AFlyingPiglet/shangjianyinqing/docs/README.md

# CRTC 2026 参赛文档

> 队伍名称：**熵减引擎战队**（新生组）　建议仓库名：`shangjianyinqing`
> 队长：蔡昌恒　队员：史沐生、喻静琳、李秉航、杨佳琳
> 所属实训战队：**千里战队**（2026-10-05 填报分组）

## 这个仓库是什么

按《2026 CRTC 参赛手册 V1.5》的要求，记录备赛过程中的**学习内容、设计思路与制作过程**。
本目录（`docs/`）里的文档是**提交给组委会评审的部分**；队伍内部的进度看板与个人页放在仓库根目录的 `team/` 下，不属于提交文档。

中期考核（10 月 19 日 24:00 截止）需要提交本仓库链接。

## 文档索引

| 文档 | 内容 |
|---|---|
| [01-基础功能](01-基础功能.md) | **中期考核 12 项基础功能**（1.1~1.12 各自独立成文）：功能描述 / 方案与取舍 / 开发历程 / 证据 |
| [02-进阶功能](02-进阶功能.md) | 最多 3 项进阶功能（2.1~2.3 独立成文，按创新度、实现难度、完成度评分） |
| [03.00-学习笔记](03.00-学习笔记.md) | 培训与自学内容，按板块分册：03.01 机械 / 03.02 电控 / 03.03 工具与软件 / 03.04 规则与赛务 / 03.05 硬件（空板块不单列，有新内容时自动生成） |
| [04.00-设计思路记录](04.00-设计思路记录.md) | 设计想法的变化：**04.01 一号车 / 04.02 二号车** 分册记录；通用策略与问卷汇总在 04.00 本页 |
| [05-物资与成本预算](05-物资与成本预算.md) | 核心部件选型、采购清单、成本核算（对应基础功能第 12 项） |
| [06-规则测评笔记](06-规则测评笔记.md) | 手册要点、易错条款、80 题测评复习 |
| [07-规则手册变更记录](07-规则手册变更记录.md) | V1.4 → V1.5 的六处变更、对设计的影响与行动清单 |
| [08-开源项目说明](08-开源项目说明.md) | 开源项目使用说明（手册 V1.5 要求，中期考核前需完整） |
| [09-独立复核对账与修正](09-独立复核对账与修正.md) | 第三方独立复核的逐条对账：采纳/修正/不采纳，以及待拍板决定 |
| [images/](images/) | 文档用图。**日报配图**放在 `images\日报配图\<日期>\`，其他图直接放 `images\` 下 |
| [问卷原件/](问卷原件/) | 队员填写问卷的原始文件（电子卷 + 手写卷照片），作为设计讨论的原始证据 |

## 写作要求（务必遵守）

1. **格式**：markdown（.md）。
2. **每项功能单独成文**：基础功能 1.1~1.12、进阶功能 2.1~2.3 各一个文件；文内按「功能描述 → 方案与取舍（为什么）→ 开发历程（精简）→ 证据」组织。
3. **按时间从早到晚**组织内容（开发历程从最早的方案讲起，写到当前状态）。
4. **必须写「为什么」**：技术选型对比、遇到的难点与解决方案、迭代优化的过程。只写「做了什么」拿不到高分。
5. 图片放在 `docs/images/`，用相对路径引用：`![](images/xxx.png)`；日报自动导出的照片会归到 `images/日报配图/<日期>/`，并在当天条目下面直接显示。
6. 每次有进展就提交一次，不要攒到最后一天。
