AFlyingPiglet/shangjianyinqing/docs/images/README.md

# 图片目录

把文档里用到的照片、截图、CAD 导出图放在这里，命名建议「日期-内容」：

```
2026-10-03-矮墙槽对位-第3次.jpg
2026-10-05-举升机构装配.png
```

在 MarkText 里引用时用相对路径：

```markdown
![矮墙槽对位](images/2026-10-03-矮墙槽对位-第3次.jpg)
```

这样上传到 Gitee / GitHub 后图片能正常显示。
