AFlyingPiglet/shangjianyinqing/docs/03.02-电控.md

# 03.02 电控（学习笔记）

> 按日期从早到晚记录「电控」板块的学习内容与来源；由日报自动写入。

## 电控

<!-- 追加位置 -->

### 2026-09-28 配置电控所需环境

- 学习人：李秉航
- 来源：B站
- 学了什么：配置ST-link，STM32CudeMX
- 学习中遇到的问题：网速太慢，安装失败，安装缺少文件
- 学习中的解决过程：重新尝试安装

**照片：**

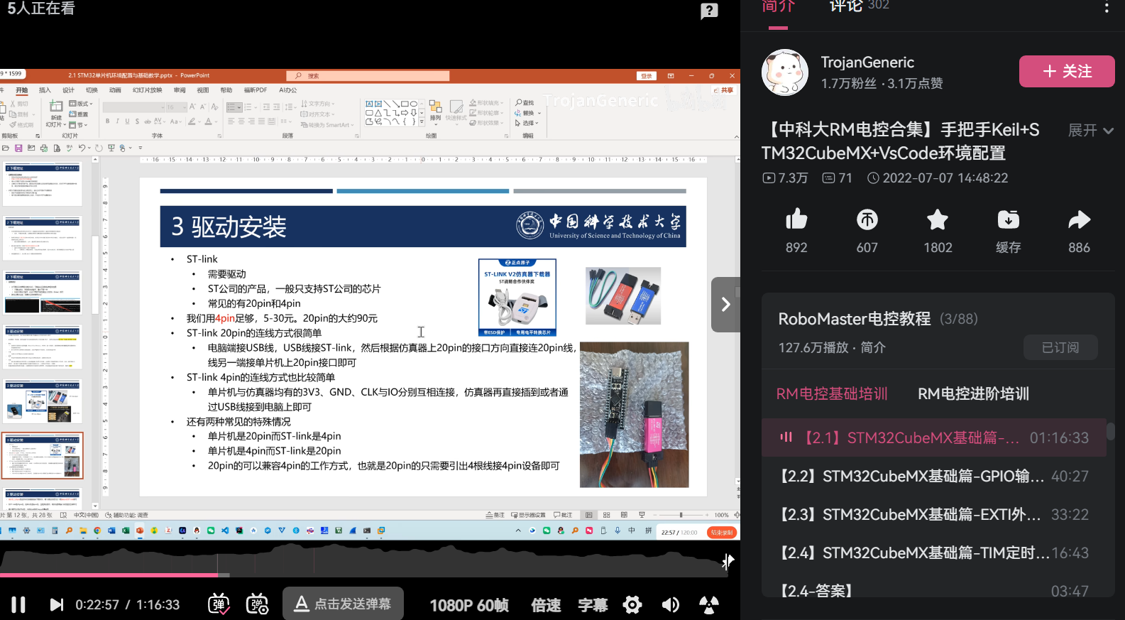
[picture p1: docs/images/日报配图/2026-09-28/李秉航-1-46bd4360.png]
李秉航-1-46bd4360


[打开图片：李秉航-1-46bd4360](images/日报配图/2026-09-28/李秉航-1-46bd4360.png)

### 2026-09-29 电控

- 学习人：蔡昌恒
- 来源：哔哩哔哩
- 学了什么：电控导论

**当天照片：**

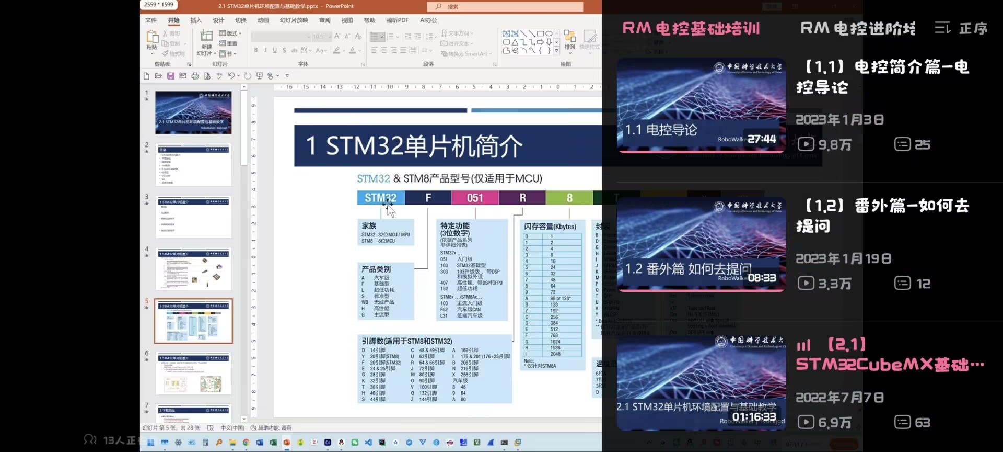
[picture p2: docs/images/日报配图/2026-09-29/蔡昌恒-1-d381a8af.jpeg]
蔡昌恒-1-d381a8af


[打开图片：蔡昌恒-1-d381a8af](images/日报配图/2026-09-29/蔡昌恒-1-d381a8af.jpeg)

### 2026-09-29 配置电控所需环境

- 学习人：李秉航
- 来源：QQ群所发网站
- 学了什么：配置Clion,STM32CubeMonitor，STM32CubeProgrammer，STM32CubeCLT

**照片：**

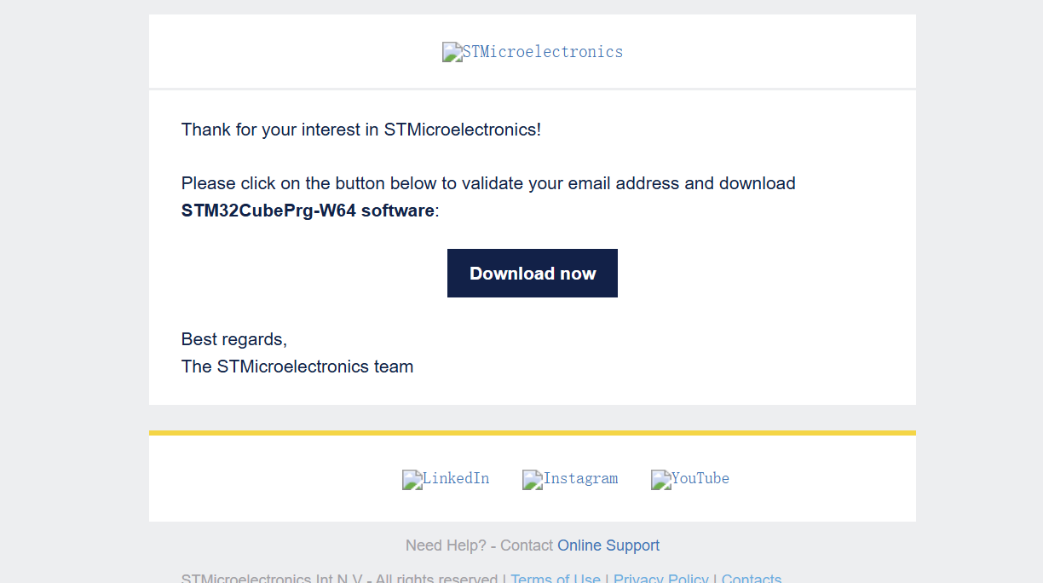
[picture p3: docs/images/日报配图/2026-09-29/李秉航-1-b380d144.png]
李秉航-1-b380d144


[打开图片：李秉航-1-b380d144](images/日报配图/2026-09-29/李秉航-1-b380d144.png)

### 2026-09-30 学习GPIO

- 学习人：李秉航
- 来源：B站
- 学了什么：GPIO
- 学习中遇到的问题：新名词太多，初学理解有困难
- 学习中的解决过程：反复观看视频，不急于求成

**照片：**

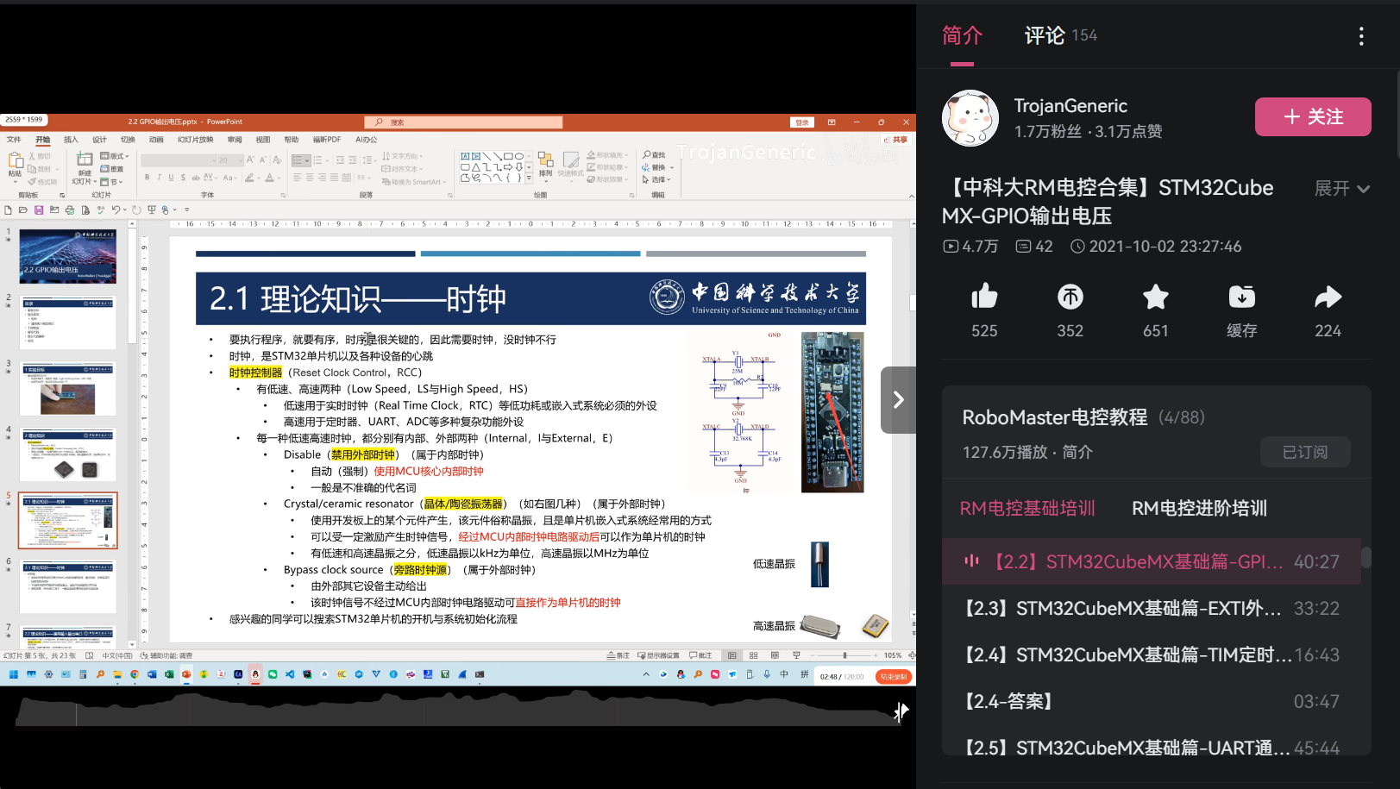
[picture p4: docs/images/日报配图/2026-09-30/李秉航-1-0cf1a1bb.png]
李秉航-1-0cf1a1bb


[打开图片：李秉航-1-0cf1a1bb](images/日报配图/2026-09-30/李秉航-1-0cf1a1bb.png)
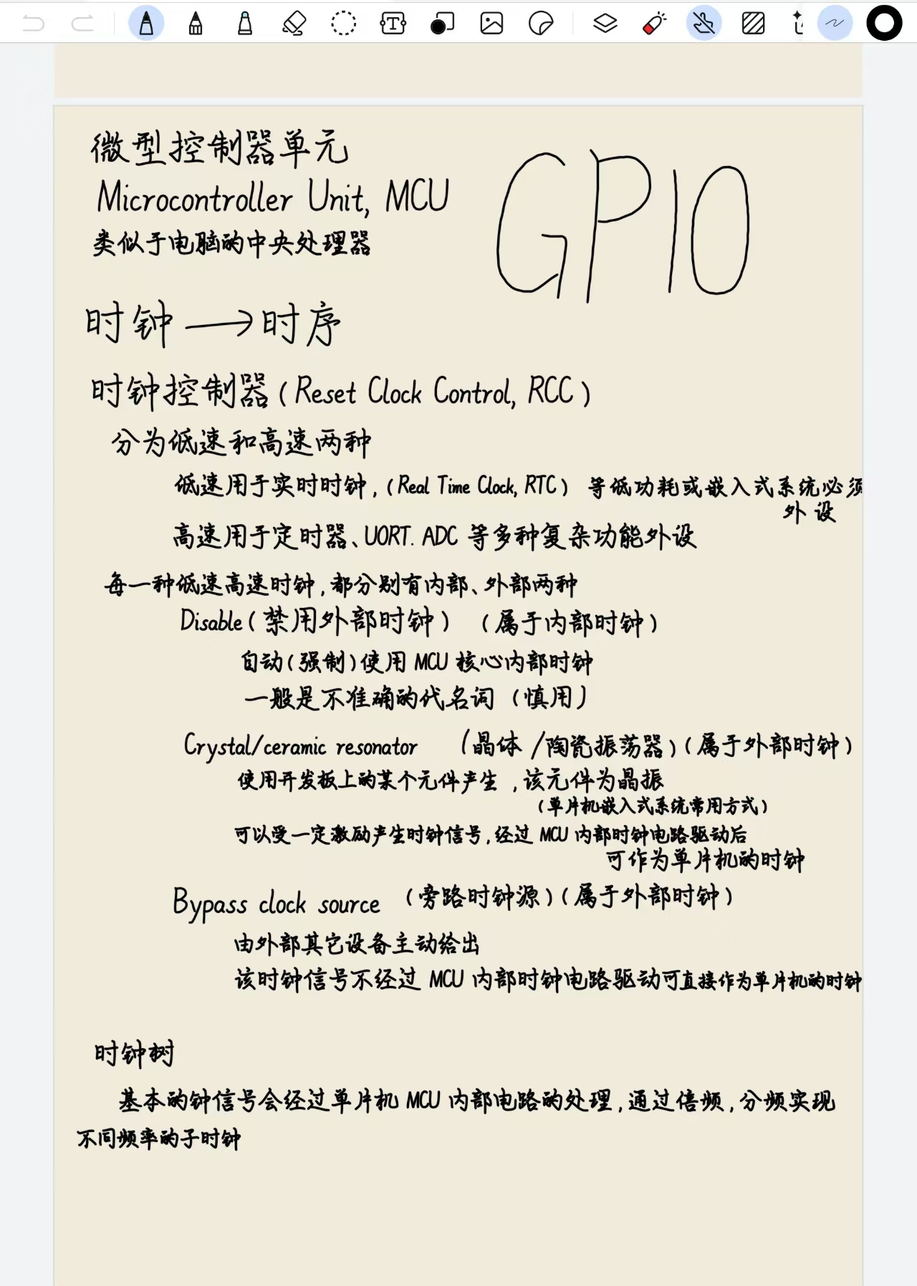
[picture p5: docs/images/日报配图/2026-09-30/李秉航-2-749e51b0.jpeg]
李秉航-2-749e51b0


[打开图片：李秉航-2-749e51b0](images/日报配图/2026-09-30/李秉航-2-749e51b0.jpeg)

### 2026-10-05 学习PLC知识

- 学习人：李秉航
- 来源：书本《零基础PLC编程从入门到精通》
- 学了什么：《零基础PLC编程从入门到精通》
- 学习中遇到的问题：新名词太多，程序设计基础薄弱
- 学习中的解决过程：整理笔记，借助AI学习

**照片：**

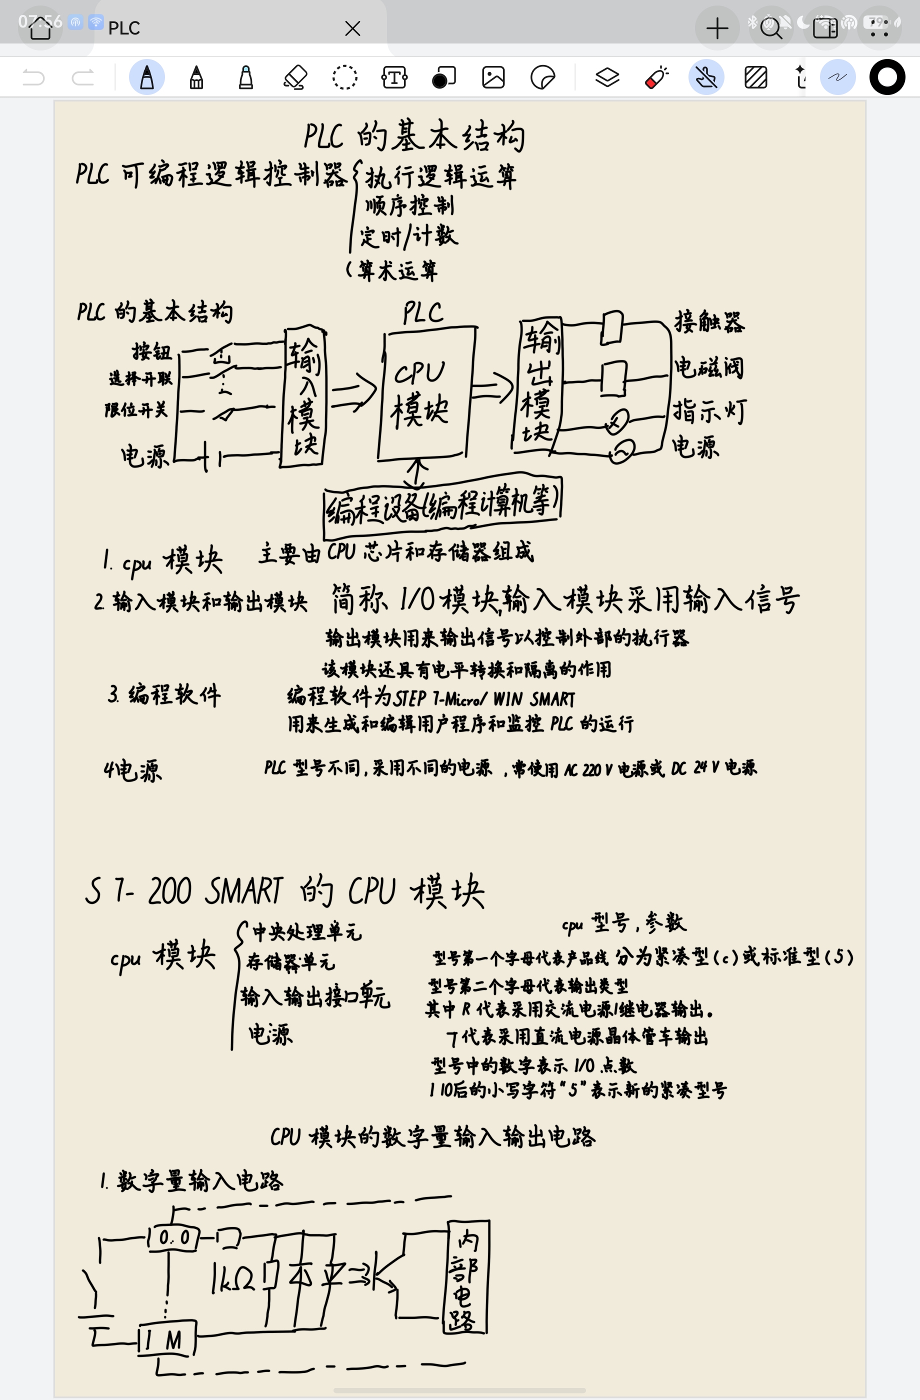
[picture p6: docs/images/日报配图/2026-10-05/李秉航-1-1ceda53c.jpeg]
李秉航-1-1ceda53c


[打开图片：李秉航-1-1ceda53c](images/日报配图/2026-10-05/李秉航-1-1ceda53c.jpeg)
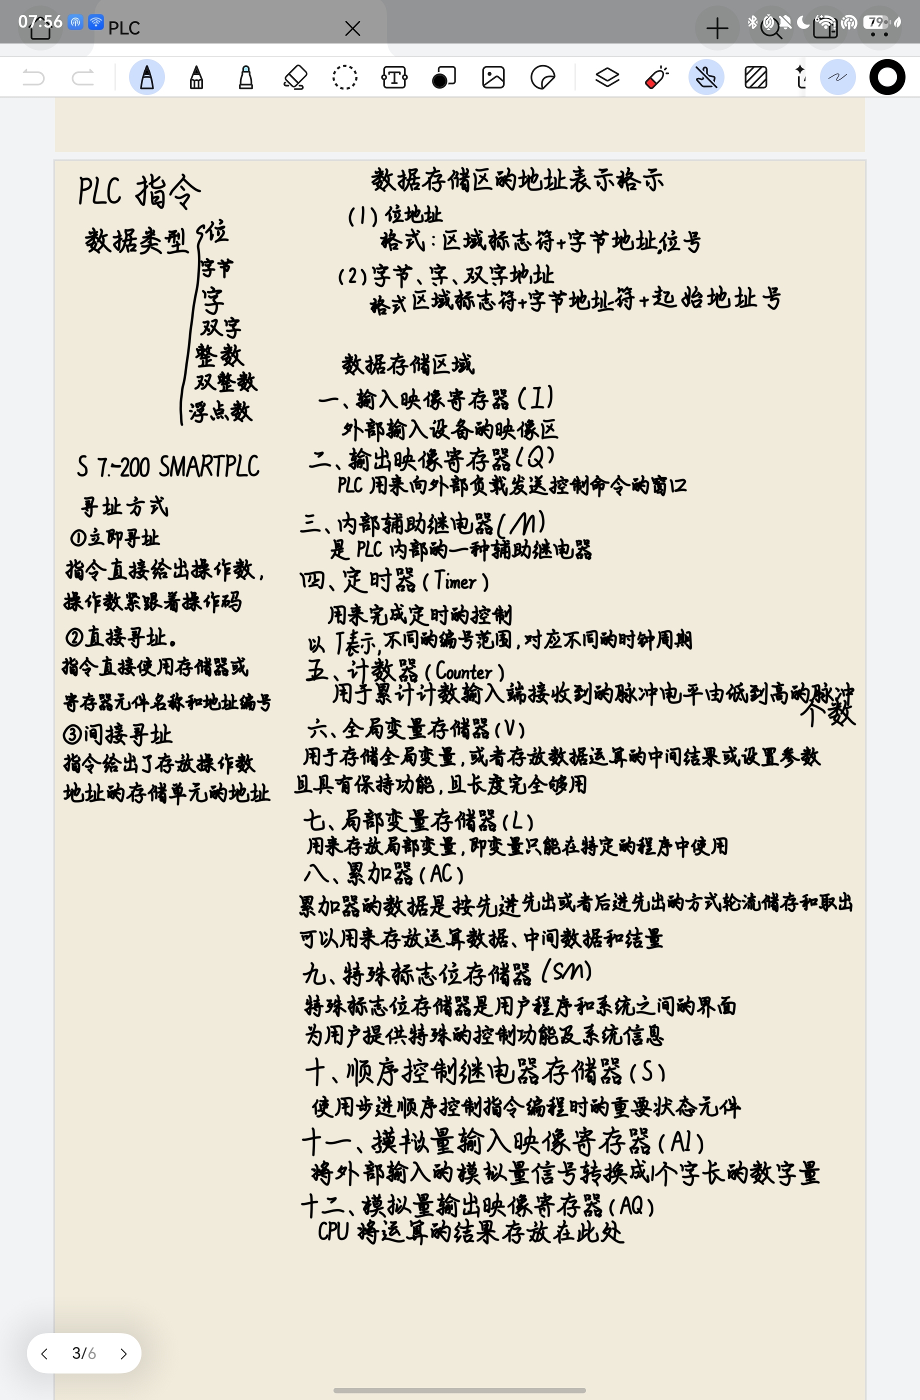
[picture p7: docs/images/日报配图/2026-10-05/李秉航-2-470c7768.jpeg]
李秉航-2-470c7768


[打开图片：李秉航-2-470c7768](images/日报配图/2026-10-05/李秉航-2-470c7768.jpeg)
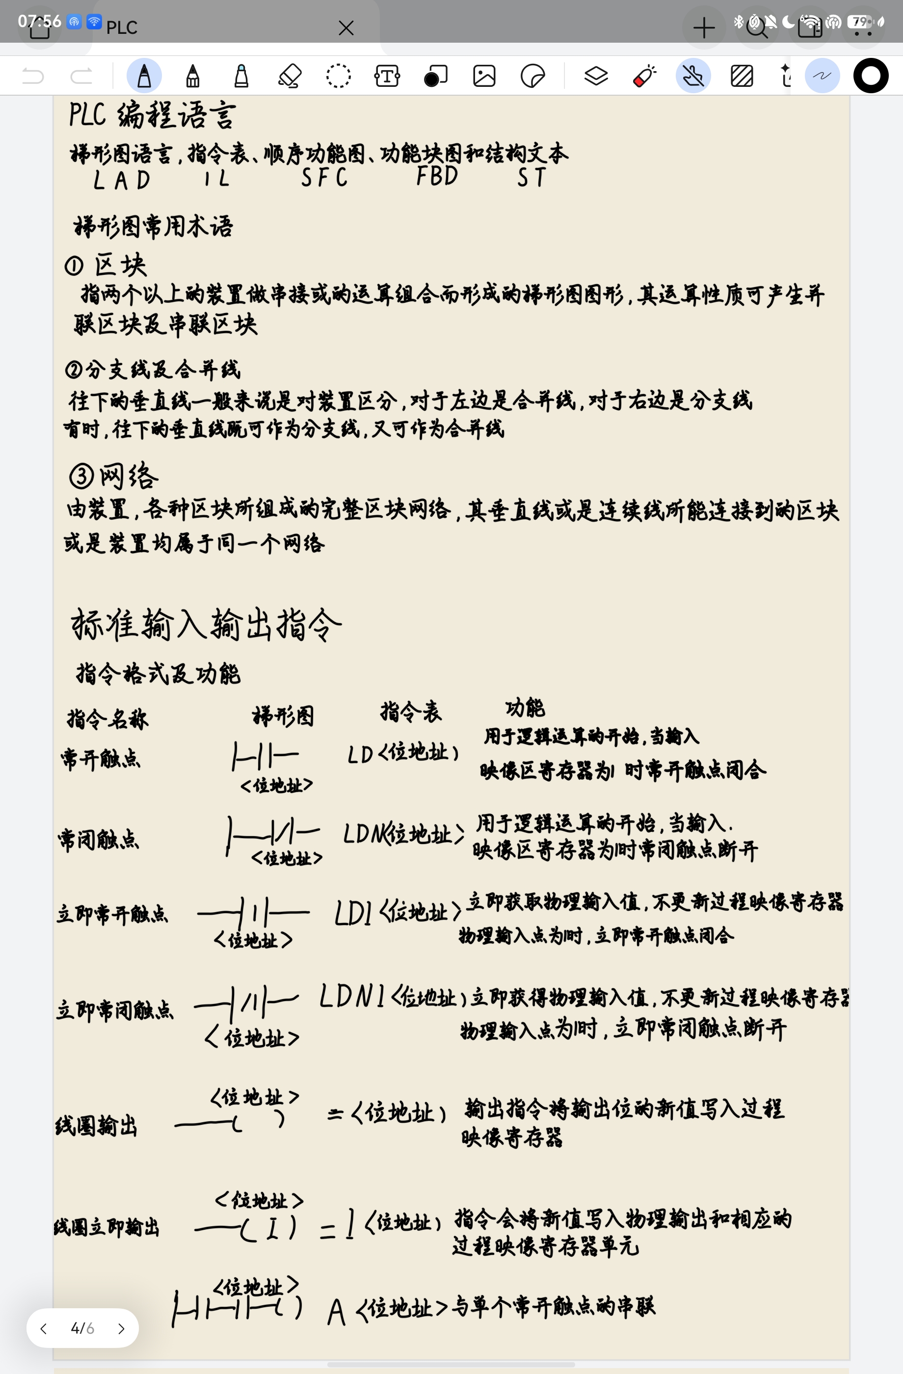
[picture p8: docs/images/日报配图/2026-10-05/李秉航-3-c148fd3c.jpeg]
李秉航-3-c148fd3c


[打开图片：李秉航-3-c148fd3c](images/日报配图/2026-10-05/李秉航-3-c148fd3c.jpeg)

### 2026-10-15 通信协定，stm32cubeMX中相应配置含义，…

- 学习人：蔡昌恒
- 来源：千里线下培训
- 重点 / 为什么这样：为了消除接线接触不良的影响。
- 怎么用到我们的车上：接入了控制手柄，并用另一种接线方式来确保接线正常。直接把母头链接到引脚上，虽然整个工作台好像盘丝洞一样。。。
