AFlyingPiglet/shangjianyinqing/docs/03.05-硬件.md

# 03.06 硬件（学习笔记）

> 按日期从早到晚记录「硬件」板块的学习内容与来源；由日报自动写入。

## 硬件

### 2026-10-09 嘉立创画简单 PCB 原理图

- 学习人：杨佳琳
- 来源：B 站教程
- 学了什么：用嘉立创 EDA 画简单 PCB 原理图——建工程、放元件、连网络、检查连线；当天先以“能画通一张小图”为目标。
- 学习中遇到的问题：连线太乱，不知道元件该放什么位置
- 学习中的解决过程：先按“电源—控制—输出”三段分区摆元件再连线，线乱就先拉直、同类信号走同侧（后续继续跟教程补）
- 分类：硬件

### 2026-10-12 STM如何烧录接线

- 学习人：杨佳琳
- 来源：豆包，deepseek，嘉立创
- 学了什么：1，确定了1,2车板子上面都需要放置什么 2，STM上面没显示PA13,PA14，该如何接线？ 上面标注的引脚名字不全，有隐藏引脚，PA13,PA14对应的是34,37号引脚，将ST_Link的四个接线头插入3.3V,END,PA13,PA14即可烧录 3，弯曲排针和正常排针的区别：弯曲排针向上弯90度，再考虑到板子位置大小和放置方向是可能会考虑，我们就用正常的就可以了
- 学习中遇到的问题：零件位置怎么放？后面接线怎么接？
- 分类：硬件

### 2026-10-13 改进，打印一号车的PCB

- 学习人：杨佳琳
- 来源：豆包，deepseek，嘉立创
- 学了什么：改进，打印一号车的PCB
- 分类：硬件

**当天照片：**

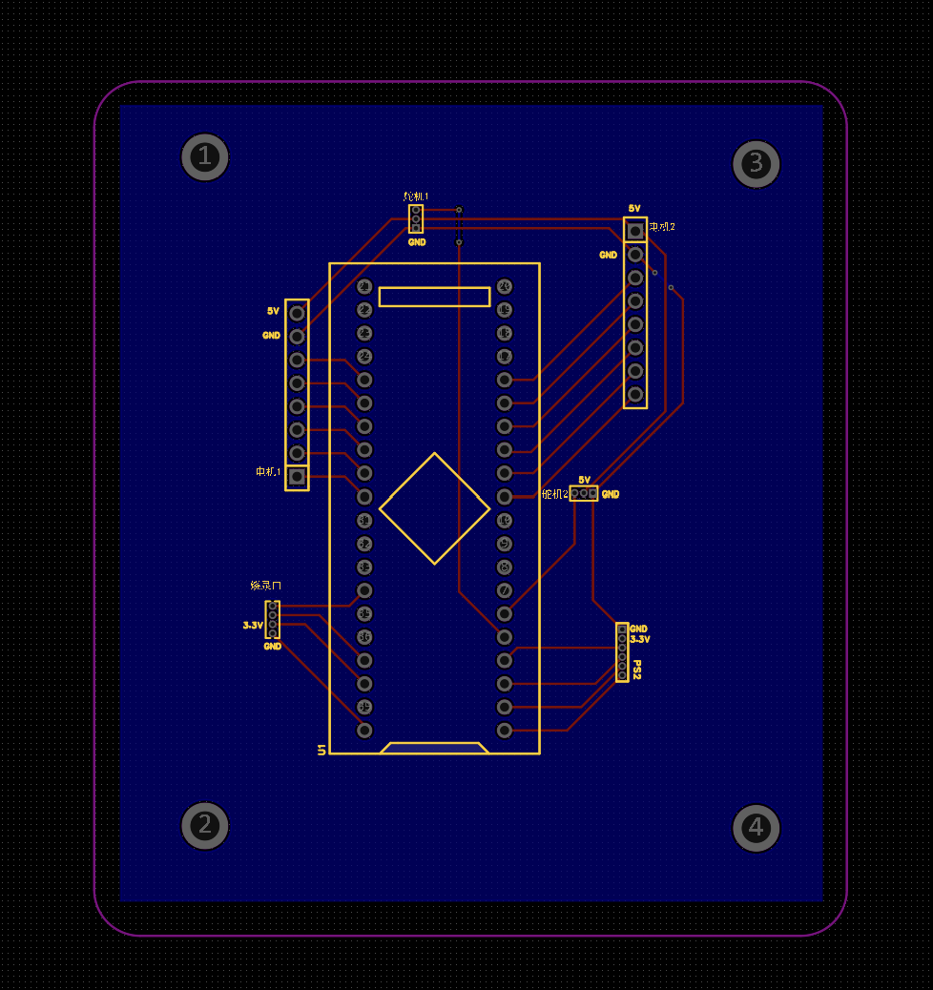
[picture p9: docs/images/日报配图/2026-10-13/杨佳琳-1-dbcfa02d.png]
杨佳琳-1-dbcfa02d


[打开图片：杨佳琳-1-dbcfa02d](images/日报配图/2026-10-13/杨佳琳-1-dbcfa02d.png)
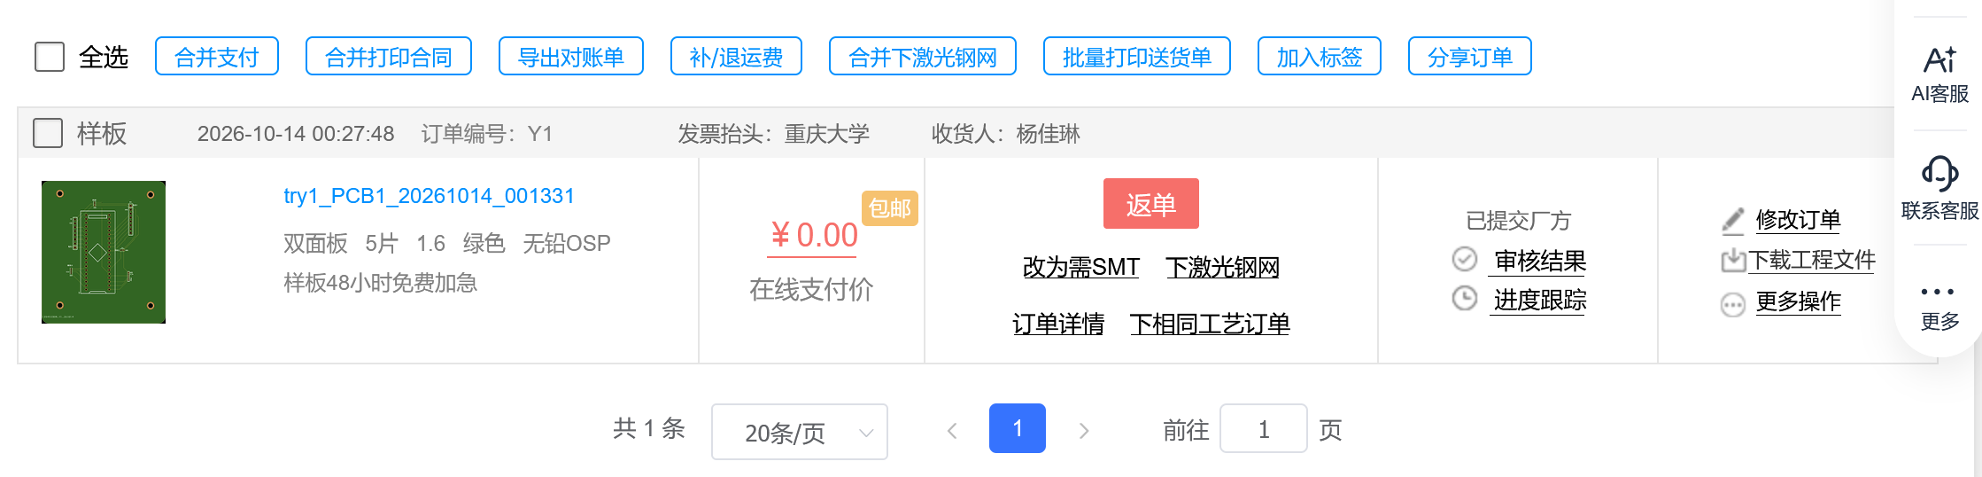
[picture p10: docs/images/日报配图/2026-10-13/杨佳琳-2-a44acbcc.png]
杨佳琳-2-a44acbcc


[打开图片：杨佳琳-2-a44acbcc](images/日报配图/2026-10-13/杨佳琳-2-a44acbcc.png)
