AFlyingPiglet/shangjianyinqing/docs/1.1-外形展示.md

# 1.1 外形展示

- **考核要求**：至少有一台具有能量单元的完整机器人机体，需绕车一周展示。
- **当前状态**：两车实物尚未拼装完成（3D 打印整批错印、PCB 首版接口问题），中期以 3D 建模概念图与 Fusion 装配流程代替实物展示。

## 我们的实现

两车按「抢价值 + 刷数量」分工：1 号车为麦轮取块车（举升立柱 + 换头机械臂），2 号车为四轮差速收运车（风车摇柄刺钩 + 一体斜铲唇 + 无隔板托盘）。两车均 PS2 手动操作。当前口径与桌面「一号车-最终版」「二号车-最终版」及《CRTC2026-双车最终方案报告-2026-10-12》一致。

| 项目 | 1 号车（过桥版） | 2 号车（隧道版） |
| --- | --- | --- |
| 定位 | 抢高分道具（物资架黄块 + 中央高台） | 刷数量（地面与台阶散块 + 洞穴黄块） |
| 尺寸 | **208 × 140 × 207 mm**（限 290×195×210，高余 3） | **收车位 288 × 186 × 129 mm**（长余 2、宽余 9、桥下净高余 1）  |
| 重量（预计）  | ≈1.2 kg（含车尾配重约 1.35~1.45；限 2.0） | ≈0.94~1.10 kg（限 2.0） |
| 行走与轮系 | φ60 麦轮 ×4 + TT 1:48 | φ70 橡胶轮 ×4 + TT（四轮差速；底盘离地 58） |
| 取块方式 | 快换接口（背板 18×48×24 + 公板 10×16×6）＋三种头：平行夹爪 / 钩子插头 / 弹片内撑 | 一体斜铲唇（纯坡面收地面块）→ 无隔板托盘；取块头＝松树针头 + 风车摇柄（MG90S×1） |
| 升降 / 动作 | C 口立柱 + 抱柱滑座；T8×150 丝杆 + 2×φ6 光轴；行程 46→172（126 mm） | 连杆腕折 90°（推杆 + 30° 挡块 + 复位簧，关节 0 根电线）；铲唇抬起 35°  |
| 料仓 / 检测 | 堆块筒 53×80×64（垒 2 层，可加高到 3 层）；落格 KW11×2 | 无隔板托盘 204×68×35；落格 KW11×2 |
| 电控与电池 | 后区叠放：电池仓 75×42×22（下）+ 电控托盘 68×44×16（上，铜柱 28） | 电控/电池高架 160×70（电池靠尾、PCB 在前） |

## 方案与取舍

两车形制按 A + B 设计：1 号车抢中央高台与杆上高分方块，2 号车抢地面保分方块并尝试掏出洞穴高分方块。

- **1 号车**：伪机械臂方案。除底盘运动外，设置 3（或 2）个电动自由度——手臂沿立柱升降、手臂绕立柱接触点转动、夹爪开合；另有 2 个手动自由度（见 2.1 进阶功能）。受尺寸与战术限制，料仓不大，置于车前。
- **2 号车**：铲唇 + 倒刺勾取。方块仓吊挂在车体下方，尺寸经核对可容纳目标方块；地面块由铲唇 + 舵机翻转流程拾取，洞穴块由松树状倒刺（舵机做圆环覆盖）引导出来，再由铲唇接收。
- **底板**：现成定版底座无法满足尺寸与战术需求，团队改用 3D 打印构建主体结构。

## 结构图与模型（2026-10-11 / 10-12 口径）

**1 号车**

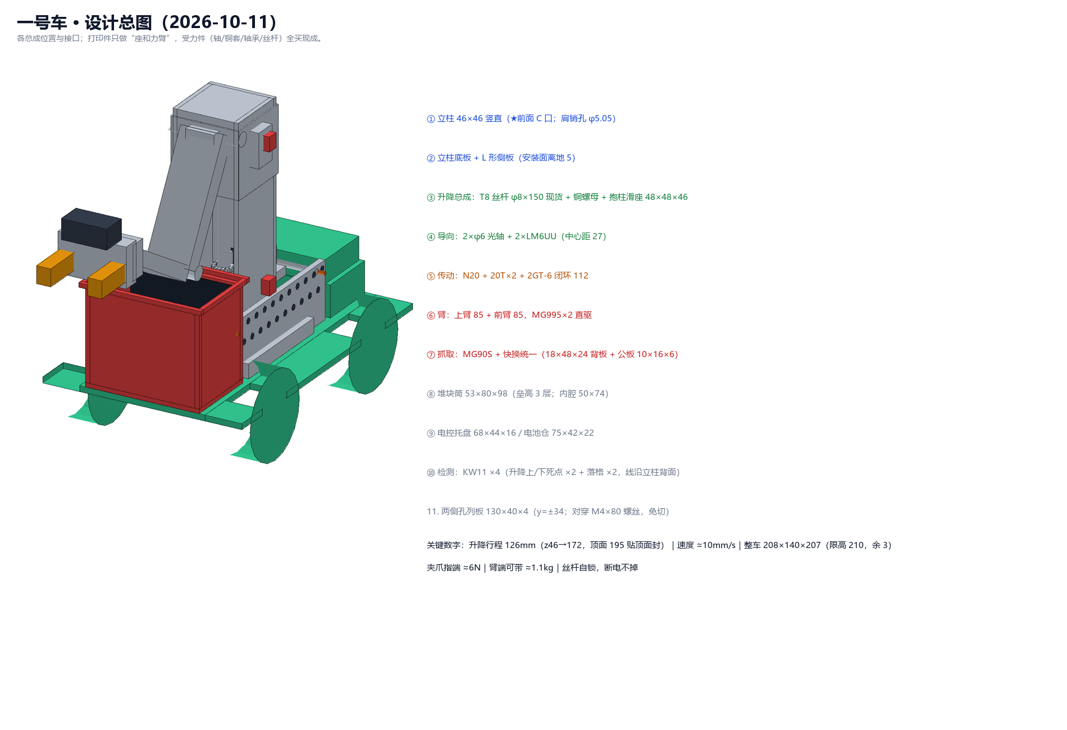
[picture p25: docs/images/设计图/00d-设计总图（2026-10-11）.png]
1 号车设计总图


[打开图片：1 号车设计总图](images/设计图/00d-设计总图（2026-10-11）.png)

*设计总图（2026-10-11）：立柱 C 口、升降总成、臂链、抓取、堆块筒、电控/电池、侧孔列板。*

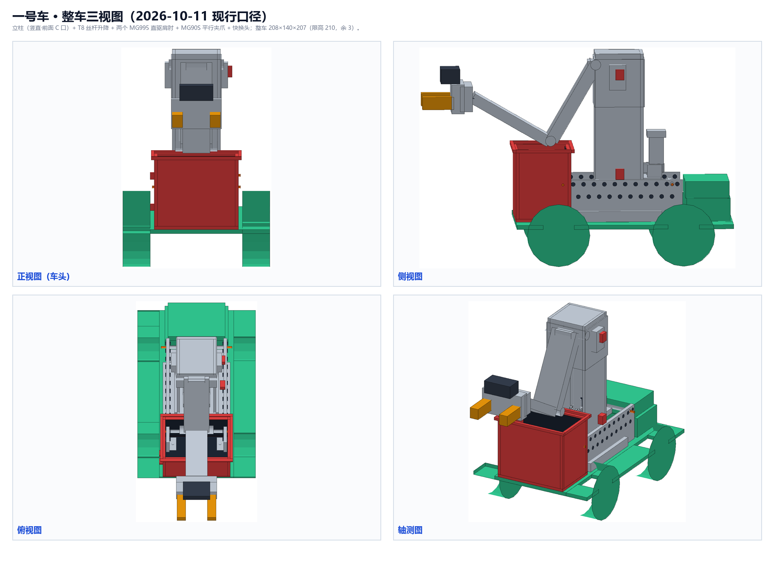
[picture p26: docs/images/设计图/00e-整车三视图（2026-10-11）.png]
1 号车整车三视图


[打开图片：1 号车整车三视图](images/设计图/00e-整车三视图（2026-10-11）.png)

*整车三视图（正/侧/俯 + 轴测，整车 208×140×207，限高 210）。*

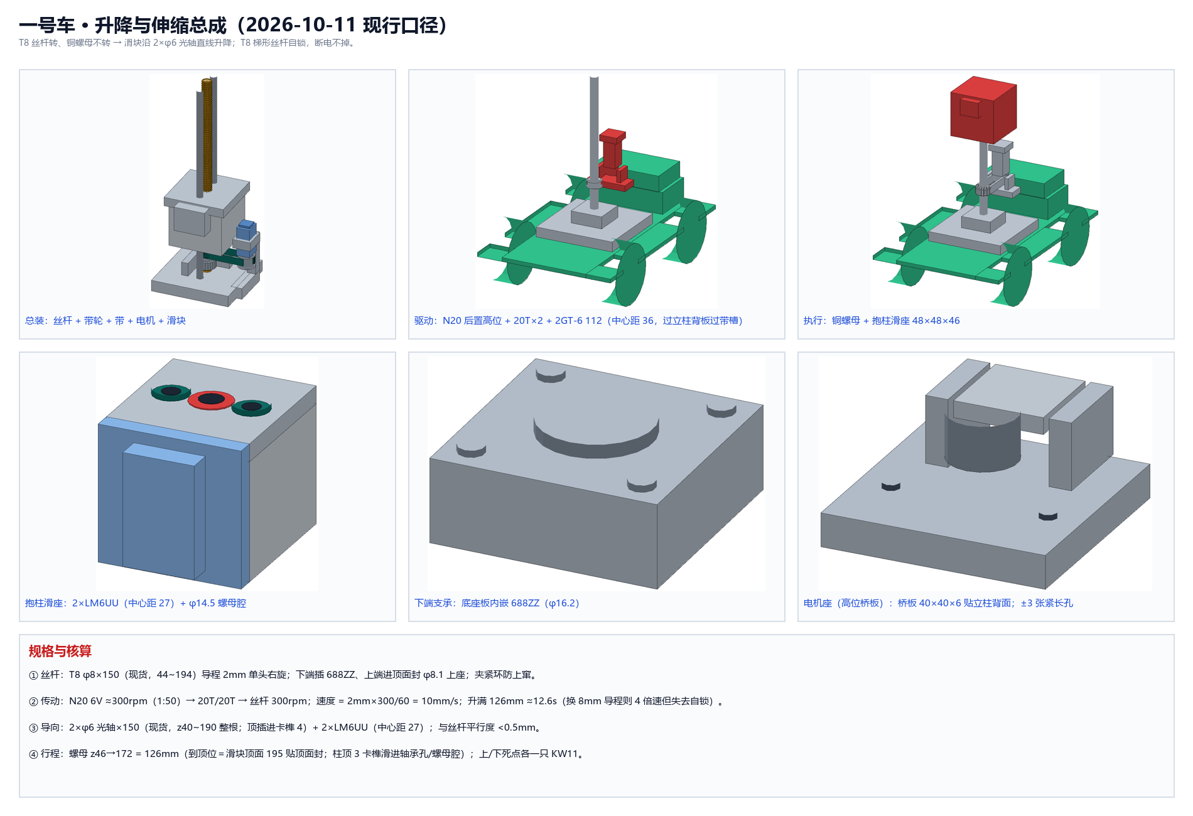
[picture p27: docs/images/设计图/00j-升降与伸缩总成（2026-10-11）.png]
1 号车升降与伸缩总成


[打开图片：1 号车升降与伸缩总成](images/设计图/00j-升降与伸缩总成（2026-10-11）.png)

*升降与伸缩总成：T8 丝杆 + 双 φ6 光轴 + 抱柱滑座，N20 后置高位驱动。*

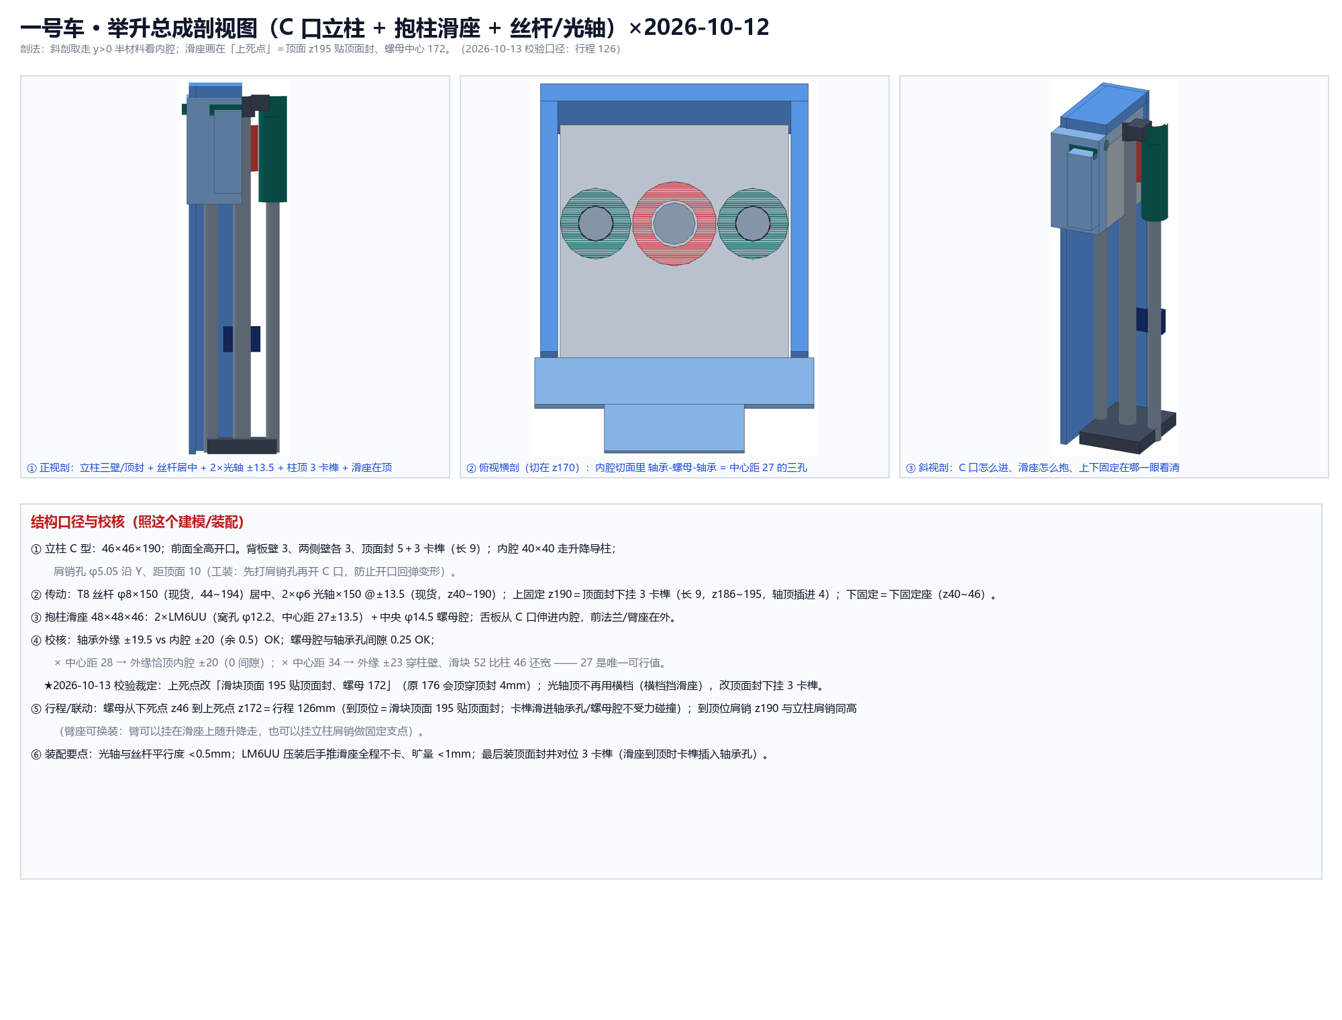
[picture p28: docs/images/设计图/00p-举升总成剖视（2026-10-12）.png]
1 号车举升总成剖视


[打开图片：1 号车举升总成剖视](images/设计图/00p-举升总成剖视（2026-10-12）.png)

*举升总成剖视（2026-10-12）：C 口立柱内腔、滑座中心距 27、行程 46→172。*

**2 号车**

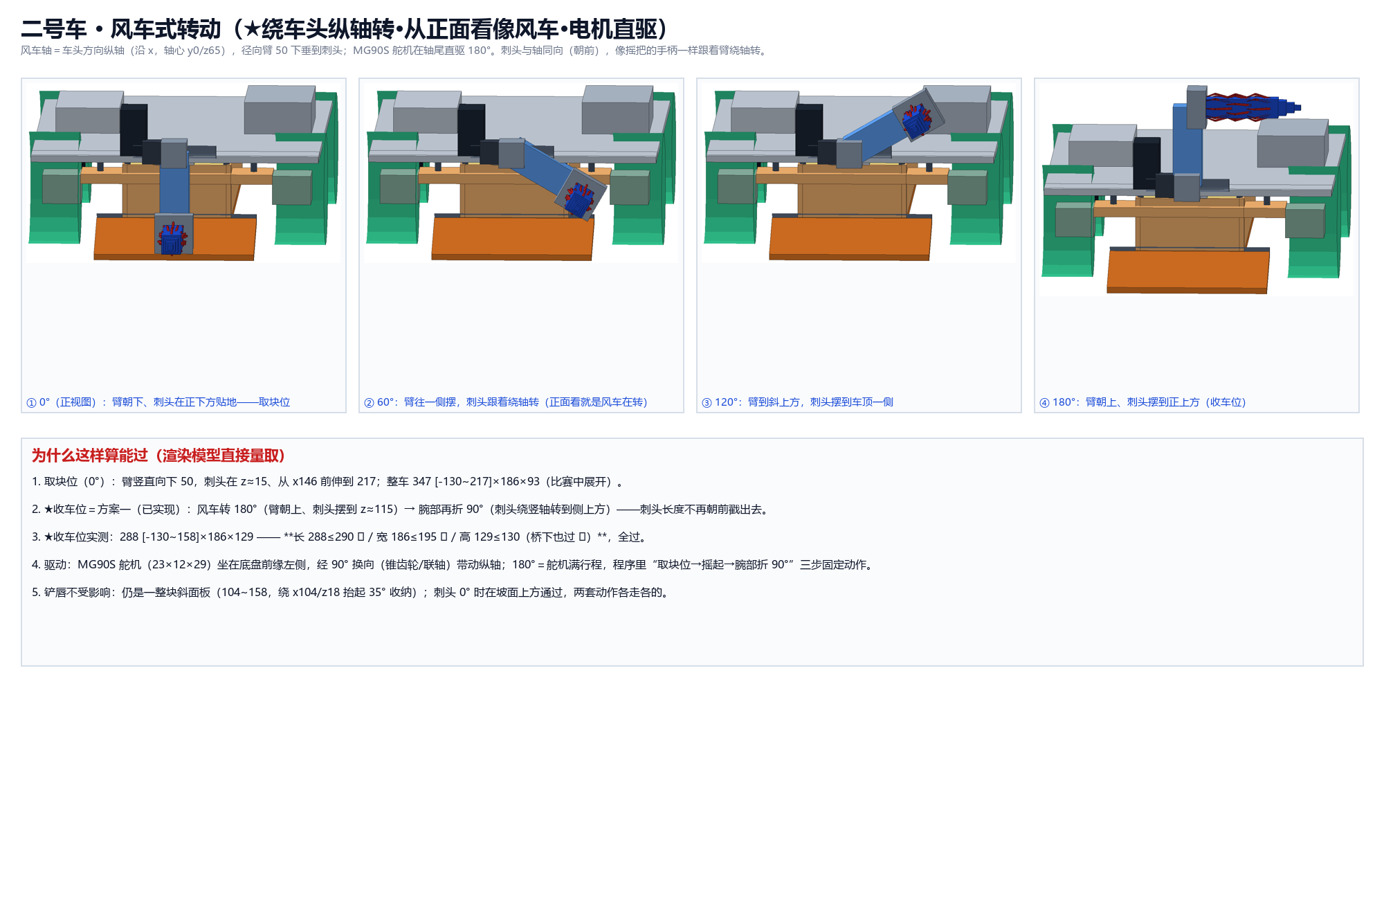
[picture p29: docs/images/设计图/28-摇把式转动过程（电机直驱·四帧）.png]
2 号车风车式转动四帧


[打开图片：2 号车风车式转动四帧](images/设计图/28-摇把式转动过程（电机直驱·四帧）.png)

*风车式转动四帧：0° / 60° / 120° / 180°，取块位 → 收车位。*

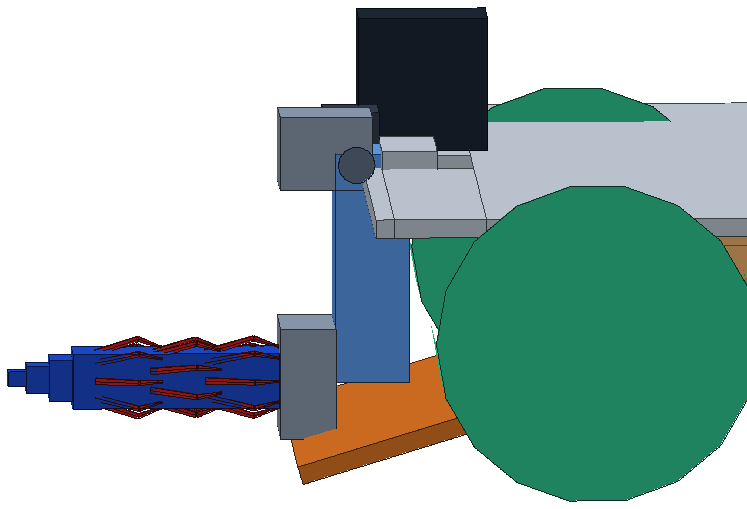
[picture p30: docs/images/设计图/机构近景-取块位（刺头+铲唇）.png]
2 号车取块位近景


[打开图片：2 号车取块位近景](images/设计图/机构近景-取块位（刺头+铲唇）.png)

*取块位近景：松树刺头 + 一体斜铲唇。*

**模型源文件**：一号车 16 件打印件 STEP 模型（立柱、抱柱滑座、底盘、堆块筒、侧孔列板等）见 [models/一号车-STEP](models/一号车-STEP/)。

**2 号车零件 Fusion 建模（过程截图）**

挡块板 Fusion 模型


[打开图片：挡块板 Fusion 模型](images/设计图/挡块板-Fusion模型.jpg)

*挡块板（Fusion 零件模型）。*

TT 电机托板 Fusion 模型


[打开图片：TT 电机托板 Fusion 模型](images/设计图/TT电机托板-Fusion模型.jpg)

*TT 电机托板（Fusion 零件模型）。*

腕部摇臂 Fusion 模型


[打开图片：腕部摇臂 Fusion 模型](images/设计图/腕部摇臂-Fusion模型.jpg)

*腕部摇臂 24×10×5（Fusion 零件模型）。*

二号车打印底盘 Fusion 模型


[打开图片：二号车打印底盘 Fusion 模型](images/设计图/二号车打印底盘-Fusion模型.jpg)

*二号车打印底盘（含竖臂缺口与铲唇缺口）。*

一体铲唇板 Fusion 模型


[打开图片：一体铲唇板 Fusion 模型](images/设计图/一体铲唇板-Fusion模型.jpg)

*一体铲唇板（含铰轴管）。*

径向臂 Fusion 模型


[打开图片：径向臂 Fusion 模型](images/设计图/径向臂-Fusion模型.jpg)

*径向臂 16×18×50（Fusion 零件模型）。*

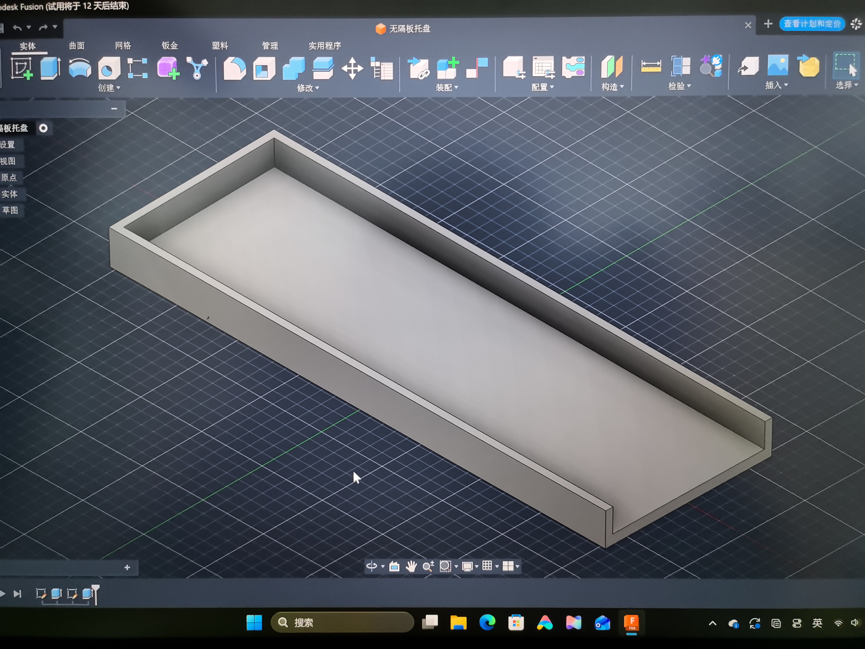
[picture p37: docs/images/设计图/无隔板托盘-Fusion模型.jpg]
无隔板托盘 Fusion 模型


[打开图片：无隔板托盘 Fusion 模型](images/设计图/无隔板托盘-Fusion模型.jpg)

*无隔板托盘 204×68×35（Fusion 零件模型）。*

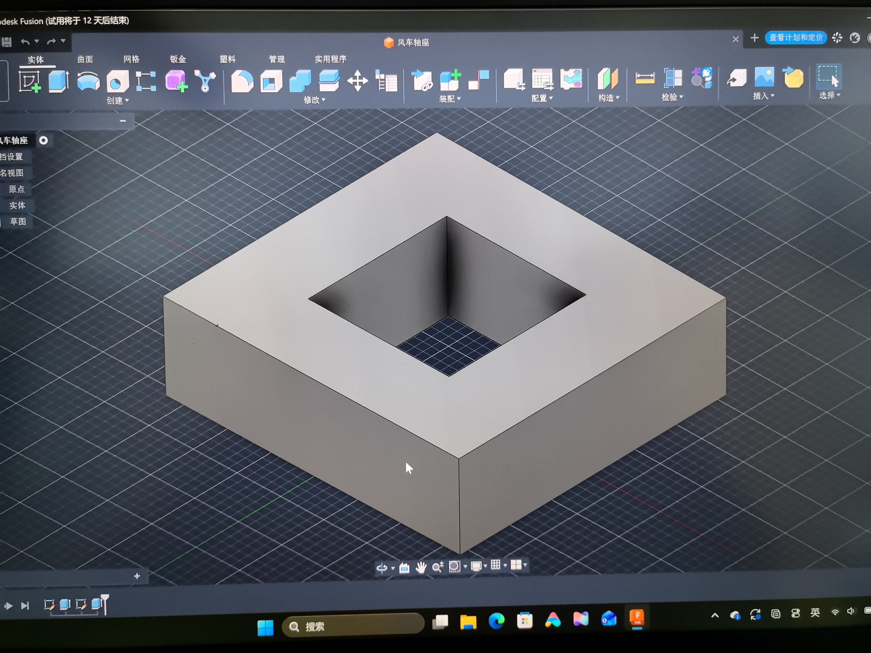
[picture p38: docs/images/设计图/风车轴座-Fusion模型.jpg]
风车轴座 Fusion 模型


[打开图片：风车轴座 Fusion 模型](images/设计图/风车轴座-Fusion模型.jpg)

*风车轴座 34×32×10（含 16.2×16.2 方窝）。*

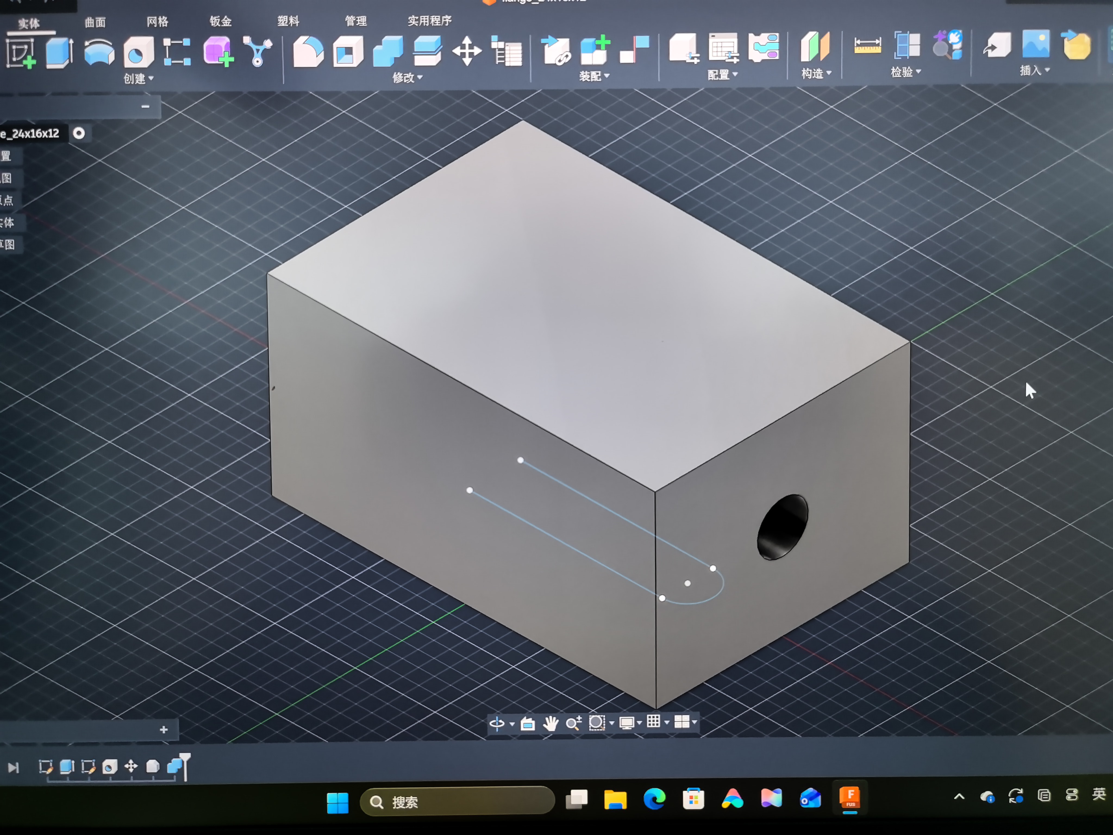
[picture p39: docs/images/设计图/法兰24x16x12-Fusion模型.jpg]
法兰 Fusion 模型


[打开图片：法兰 Fusion 模型](images/设计图/法兰24x16x12-Fusion模型.jpg)

*法兰 24×16×12（Fusion 零件模型）。*

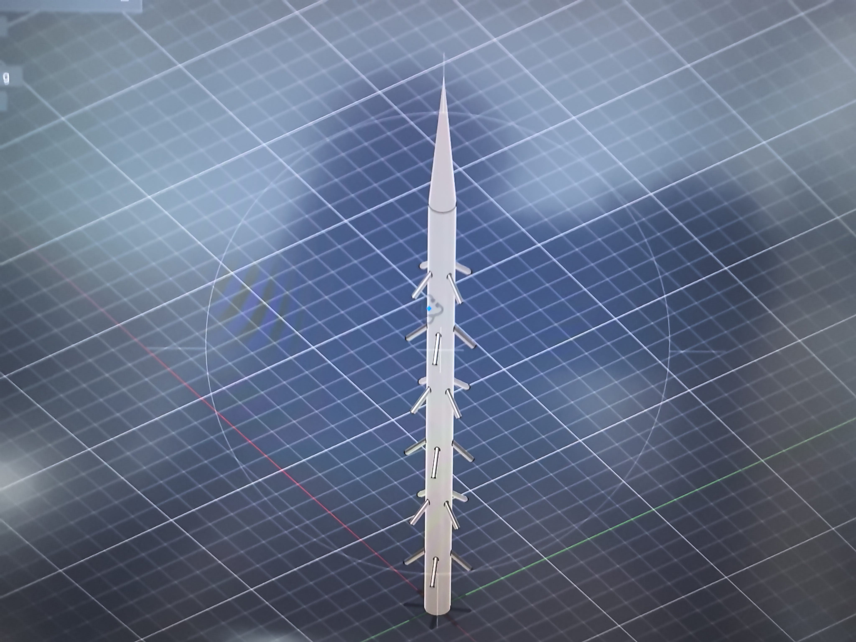
[picture p40: docs/images/设计图/松树针头-Fusion模型.jpg]
松树针头 Fusion 模型


[打开图片：松树针头 Fusion 模型](images/设计图/松树针头-Fusion模型.jpg)

*松树针头（松树型倒刺）：3 圈 × 8 根细针，2 号车洞穴取块用。*

**装配过程图（一号车 14 步 / 二号车 12 步）**

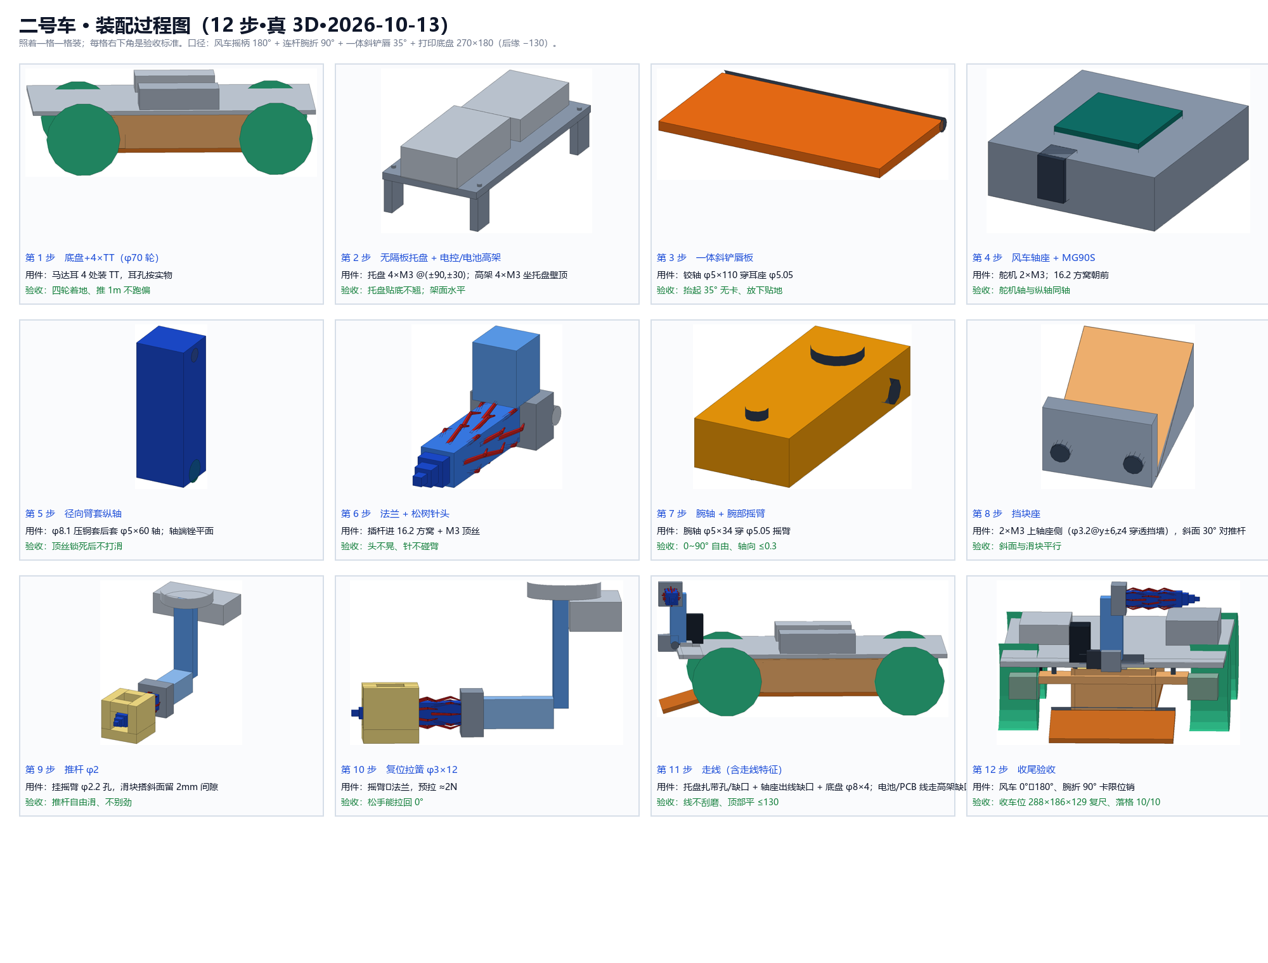
[picture p41: docs/images/设计图/00c-装配过程图（12步·2026-10-11）.png]
二号车装配过程图（12 步）


[打开图片：二号车装配过程图（12 步）](images/设计图/00c-装配过程图（12步·2026-10-11）.png)

*二号车装配过程图（12 步，含文字与验收标准；口径：风车摇柄 180° + 连杆腕折 90° + 一体斜铲唇 35° + 底盘 270×180）。*

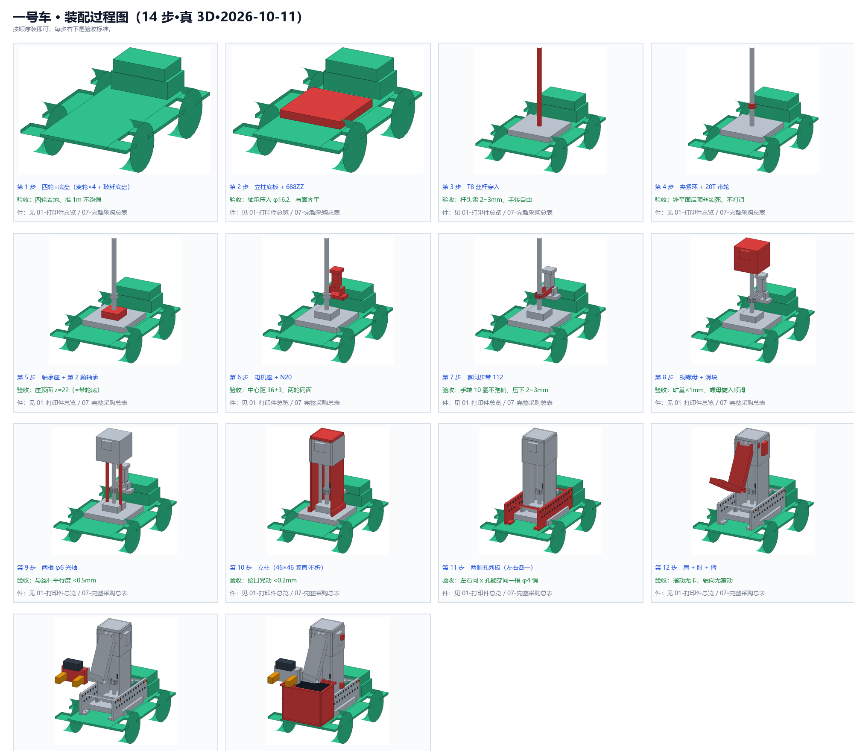
[picture p42: docs/images/设计图/00c-装配过程图（14步·文字+验收）.png]
一号车装配过程图（14 步）


[打开图片：一号车装配过程图（14 步）](images/设计图/00c-装配过程图（14步·文字+验收）.png)

*一号车装配过程图（14 步，含文字与验收标准）。*

**PCB（首版，2026-10-13）**

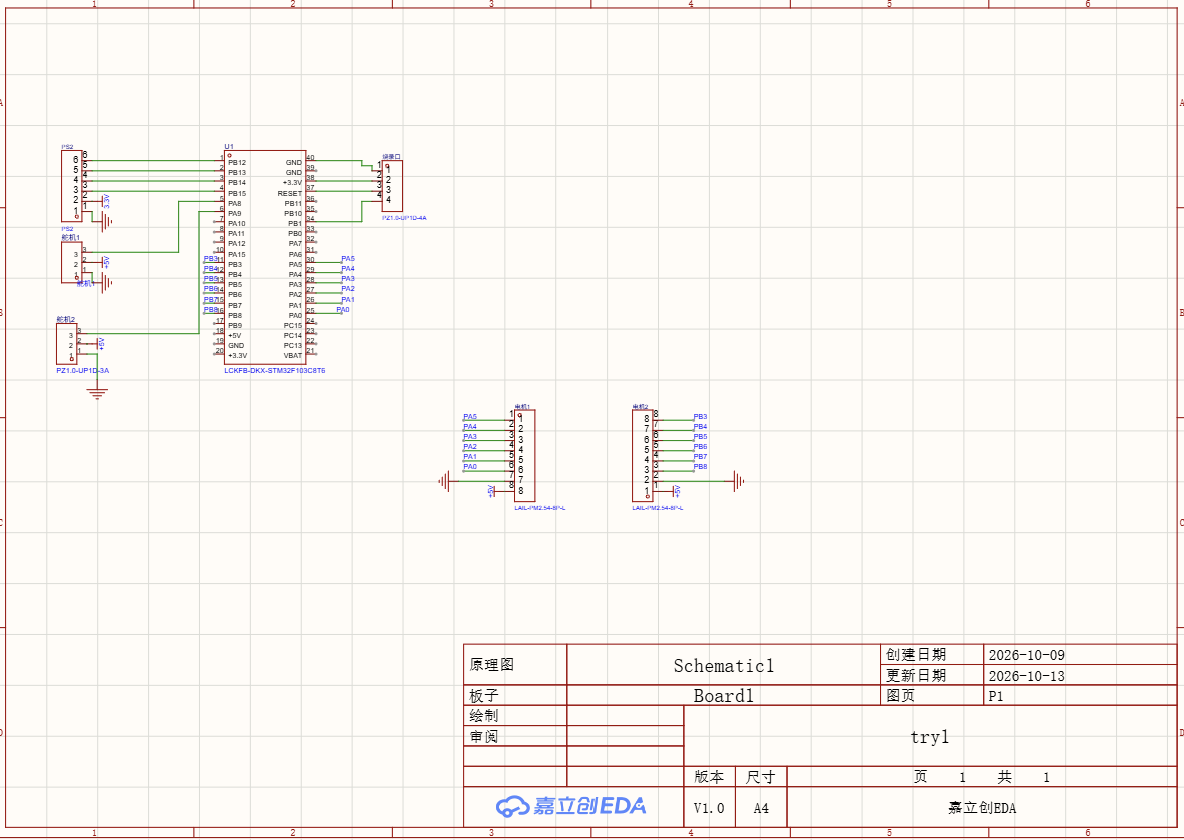
[picture p43: docs/images/设计图/PCB首版原理图-2026-10-13-嘉立创EDA.jpg]
PCB 首版原理图（嘉立创 EDA）


[打开图片：PCB 首版原理图（嘉立创 EDA）](images/设计图/PCB首版原理图-2026-10-13-嘉立创EDA.jpg)

*PCB 首版原理图（嘉立创 EDA，V1.0，2026-10-13 更新）：STM32F103C8T6 + PS2 接收接口 + PA/PB 排针。接口考虑不周、实际板子接口出错，仅作过程记录（终版待重做）。*

## 难点与解决

- **3D 打印整批错印**：10-14 提交打印件，整批错印、缺主体件，导致无法拼装；中期只能以 3D 建模概念图与 Fusion 构建/装配流程代为展示（重打进度待补）。
- **PCB 首版接口问题**：首版 PCB 考虑不周，接口出错，需进一步调试；中期无法展示终版，只展示该错误布线版本。
- **面包板接触不良**：万用表蜂鸣检测时高频出现板内断联，在电机测试中排查很久；最终舍弃面包板，改为母头直插引脚 + 焊接（详见 1.2）。

## 开发历程（精简）

- 2026-09-28：确定两车分工（1 号车抢价值 / 2 号车刷数量）与基本形制（过桥版 / 隧道版）。
- 2026-10-09 ~ 10-12：结构大修——1 号车改为 208×140×207（后区放电控/电池）、料仓改堆块筒、快换头统一背板；2 号车收车位 288×186×129、φ70 轮、单舵机。
- 2026-10-14：提交 3D 打印，整批错印，实物拼装受阻。

## 证据

- [x] 两车 3D 建模图与结构图（见上节，2026-10-11 / 10-12 口径）
- [x] 一号车打印件 STEP 模型（16 件，`docs/models/一号车-STEP/`）
- [x] 2 号车零件 Fusion 建模过程截图（9 张，见上节）
- [x] 装配过程图（一号车 14 步 / 二号车 12 步，见上节）
- [x] PCB 首版原理图（嘉立创 EDA，见上节；接口有误，仅作过程记录）
- [ ] 绕车一周展示视频——**暂无**（2026-10-18 队长确认没有该素材；以本节 3D 建模图与装配过程图代替）
