AFlyingPiglet/shangjianyinqing/docs/1.3-电机运动（全部）.md

# 1.3 电机运动（全部）

- **考核要求**：不少于 4 个电机同时可控。
- **当前状态**：未实现（通信/配对问题；代码逻辑已验证）。

## 我们的实现

两车各 4 个 TT 电机：1 号车 φ60 麦轮 ×4、2 号车 φ70 橡胶轮 ×4；DRV8833 共 6 块，均由主控 PWM 控制。

## 方案与取舍

- 统一 TT + DRV8833，便于备件共用、单车 4 电机成本可控。
- 代码侧已按塔克创新手册修改 SPI 配置，逻辑验证通过；但**同一套代码在不同次配对中出现多种异常灯态组合**，未能实现四电机同时受控：
  - 接收装置两灯常亮、手柄两灯闪烁；
  - 接收装置一灯闪烁一灯频闪、手柄两灯闪烁；
  - 接收装置与手柄两灯常亮，但无信号写入。
- 另出现同一套代码无法烧录、隔天又恢复的情况（原因未定位）。

## 难点与解决

- 上述配对/烧录异常排查未收敛；代码随附（待补），如有学长答疑欢迎指正。
- 该问题同时影响 1.6 / 1.7 底盘运动。

## 开发历程（精简）

- 2026-09-28：确定双车各 4×TT 的驱动架构。
- 2026-10-11：主控点灯成功（STM32F103C8T6 + USB-TTL）。
- 2026-10-12：底盘孔位定稿（马达耳 4 处、轮缺口等）。
- 待办：解决接收/手柄配对与烧录异常，完成四电机联调。

## 证据

- [x] 四电机驱动代码：[app_chassis.c](code/Clion_test/Core/Src/app_chassis.c)
- [x] 手柄输入代码：[app_ps2.c](code/Clion_test/Core/Src/app_ps2.c)
- [x] 配对/灯态异常记录（照片或文字，待提供）

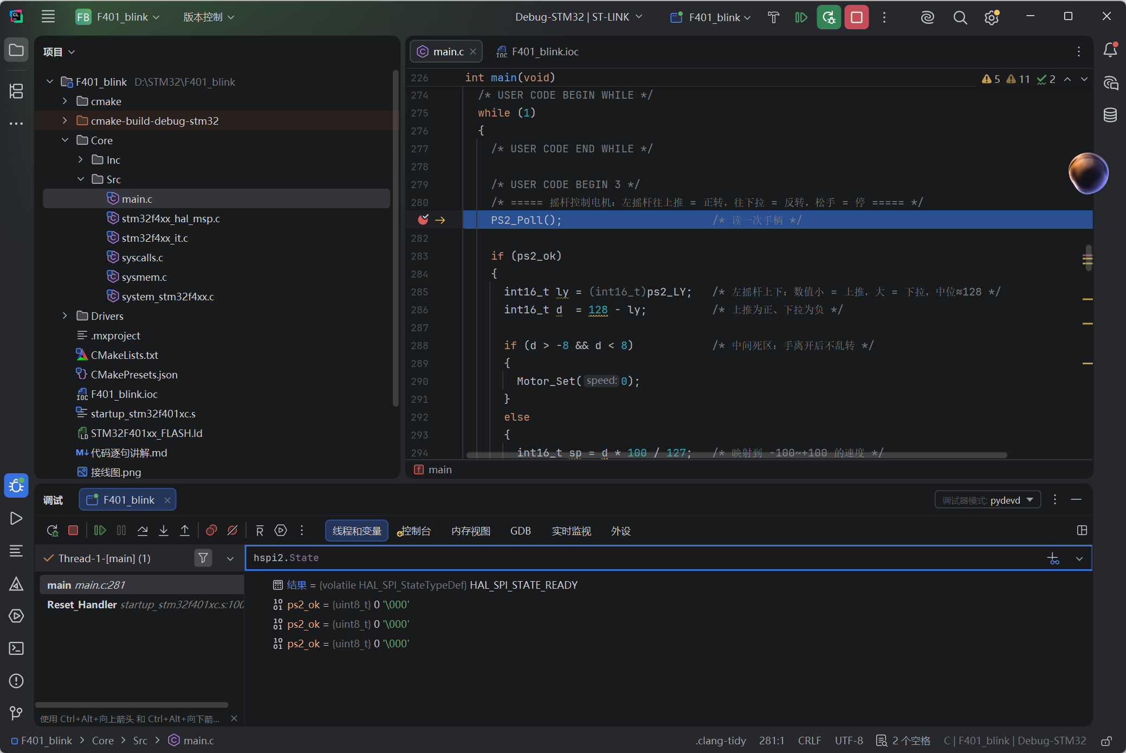
[picture p49: docs/images/过程图/1.3-电机配对-01.png]


[打开图片：1.3-电机配对-01](images/过程图/1.3-电机配对-01.png)



[打开图片：1.3-电机配对-02](images/过程图/1.3-电机配对-02.png)

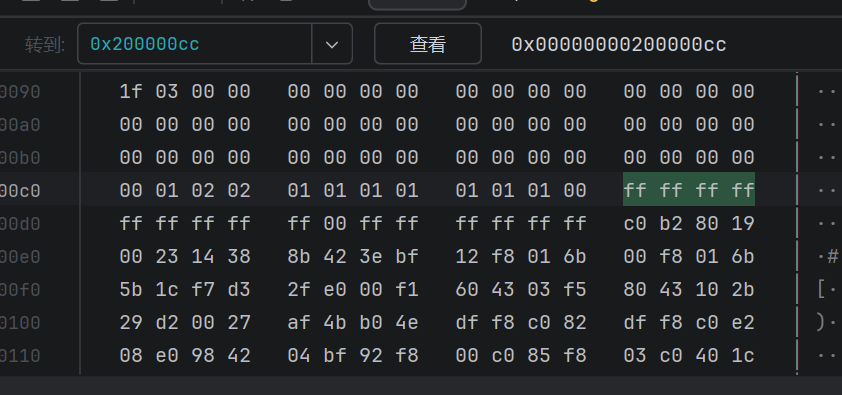
[picture p50: docs/images/过程图/1.3-电机配对-03.png]


[打开图片：1.3-电机配对-03](images/过程图/1.3-电机配对-03.png)
