AFlyingPiglet/shangjianyinqing/docs/05-物资与成本预算.md

# 物资与成本预算

> 对应中期考核基础功能第 12 项：「队伍核心部件的选型、整机的成本预算」。
> 分工：**采买执行 = 喻静琳（兼任）**，**财务与报销 = 杨佳琳（兼任）**。

## 采购与预算摘要（2026-09-28 定稿）

**三个先会影响下单的结论：**

1. 官方物资表里 **DRV8833 只有 4 块**，但按两车分工需要 **6 块**（1 号车 2 块 + 2 号车 4 块）→ 需补买 2 块。
2. 官方物资表整表 **¥353.48**（含 8 个 TT 马达、2 套麦轮、2 块底盘板、2 块 STM32、4 块 DRV8833、2 个无线继电器等），已覆盖大部分机械件。
3. 橡胶轮、弹簧片、TPU 耗材、传感器**不在官方表内**——本队为新生组可直接购买。

**预算汇总**

| 项目 | 金额 |
|---|---|
| 官方物资表 | ¥353.48 |
| 需补购（60 mm 橡胶轮 4 个、弹簧片、螺丝包、TPU/PLA 耗材、18650 电池、2 块 DRV8833） | 约 ¥120–200 |
| **合计** | **约 ¥480–560** |
| 报销上限 | ¥400（超出部分自付；未通过中期考核不予报销） |

### 实际采购（2026-10-18 更新）

- 实际采购表合计 **¥536.31**（`docs/procurement/小车配件-实际采购表.xlsx`）；其中「其他」类 **¥117.76** 的明细见 `docs/procurement/02-下单记录表.csv`（T8 丝杆、铜螺母、688ZZ、挡圈、2GT 带轮/同步带、N20、φ6 光轴+LM6UU、MG90S、KW11、拉簧、热熔螺母+螺丝包、M4 手拧+R 销、60mm 橡胶轮、XT30、亚克力、玻纤、TPU、UBEC、弹片、铜柱、领用件等）。
- 报销上限 ¥400，超出约 ¥136.31 由队内自付。
- 说明：下单记录中的部分规格为早期口径（如 T8×180、60mm 橡胶轮），现行设计口径以本文后续的 V1.1 修订为准。

**物料清单（按两车分工）**

| 分类 | 主要内容 |
|---|---|
| 两车共用 | STM32F103C8T6 ×2、ST-Link ×1、DRV8833 ×6、无线继电器 ×2、DC-DC 降压 ×2、PS2 手柄 ×2、18650 电池 2S×3 组、电池盒/充电器、螺丝螺母套装、尼龙柱、PET/PC 0.5 mm 弹片、杜邦线与端子 |
| 1 号车（过桥版）专属 | 60 mm 麦轮 1 套、TT 马达 ×4、底盘板 ×1、MG995 ×1（举升立柱）、SG90 ×2（钩头/翻盖）、3D 打印件：内钩头 ★★★、低位耙钩 ★★★、举升立柱 + 齿条 ★★、竖排 8 格料仓 ★★、电控仓隔板 ★、车底导向片 ×4 |
| 2 号车（隧道版）专属 | 60 mm 橡胶轮 ×4、TT 马达 ×4、底盘板 ×1、DRV8833 ×4、3D 打印件：铲唇 ★★★、拨轮（TPU）★★★、单向门 + 弹片槽 ★★★、8 格托盘 ★★、传感器支架 ★★、低矮电控仓盖 ★、被动耙钩 |

**加工与装配顺序（按时间排）**

1. **第一步（9/29–10/2）**：下单（官方表 + 补购件），同步出 3D 打印图纸
2. **第二步（10/3 前后）**：打印验证件（内钩头、拨轮、铲唇等 ★★★ 项）并试装
3. **第三步（10/4–10/7）**：打印正式件（料仓、举升立柱、传感器支架）+ 电控接线
4. **第四步**：两车装配、跑通底盘与取块动作，开始积累 12 项指标的演示素材

## 核心部件选型

### 目标

在满足赛事规则与预算的前提下，确定两车的核心部件。

### 方案对比（为什么这样选）

| 部件 | 候选 | 结论与理由 |
|---|---|---|
| 主控 | STM32F103C8T6 / 其他 | STM32F103C8T6：官方物资表内、资料多、PWM 与定时器资源够 |
| 驱动 | DRV8833 / L298N | DRV8833：体积小、效率高、官方表内 |
| 遥控 | 官方 PS2 手柄 / 自购 | 官方 PS2：手册指定款、可对频锁定，全队只用一种通讯方式 |
| 舵机 | MG995（举升）/ SG90（翻盖） | 官方表内，扭矩/体积匹配 |
| 电池 | 18650（自行选型） | 手册指定 18650，2S 7.4 V 为上限 |

### 开发历程（从早到晚）

**2026-09-28 选型基线**：两车核心部件均取自《CRTC 官方物资表》，除 2 号车的灰度/红外传感器（新生组允许表外物资）。

<!-- 追加位置 -->

### 验证结果

（待补：实际到货型号与规格照片）

## 官方物资表（参考价 ¥353.48）

### 目标

作为选型与比价基准；新生组可购买表外物资。

### 清单（手册附录）

| 序号 | 物品 | 规格 | 数量 | 单价 |
|---|---|---|---|---|
| 1 | STM32F103C8T6 核心板 | 焊接版 | 2 | ¥9.40 |
| 2 | MG995 舵机 | 180° 铁+铜齿轮 | 2 | ¥14.50 |
| 3 | SG90 舵机 | 180° | 4 | ¥5.90 |
| 4 | PS2 手柄 | 无线锁定款+转接板 | 2 | ¥45.00 |
| 5 | TT 马达 | 单轴 1:48 | 8 | ¥2.83 |
| 6 | 麦克纳姆轮 | 60 mm 一套 4 个 + 联轴器 | 2 套 | ¥35.00 |
| 7 | 小车底盘 | 4 轮金属折弯板 | 2 | ¥11.20 |
| 8 | STLink | V2 仿真器 | 1 | ¥12.42 |
| 9 | DRV8833 驱动 | 红板 | 4 | ¥2.27 |
| 10 | DC-DC 降压 | Mini 5V | 2 | ¥2.09 |
| 11 | 18650 电池 | 自行选型 | / | — |
| 12 | 18650 电池盒 | 两节带线 | 2 | ¥1.98 |
| 13 | 18650 充电器 | 双槽 | 1 | ¥8.60 |
| 14 | 面包板 | / | 2 | ¥2.00 |
| 15–17 | 杜邦线 | 公对公/母对公/母对母 | 各 1 | ¥2.70 / ¥2.40 / ¥2.10 |
| 18 | 无线继电器 | DC 5-24V | 2 | ¥13.80 |

### 开发历程（从早到晚）

**2026-09-28 规则整理**：

- 新生组：官方表是推荐清单，可买表外物资；造价建议 ≤400 元
- 非新生组：只能使用表内物资 + 自制 PCB + 3D 打印件
- **未通过中期测评的队伍无需购买无线继电器**
- 可借用 2025 年旧车零件（赛后归还，丢失按市价赔），借用件不参与报销

<!-- 追加位置 -->

## 本队采购清单（采买：喻静琳）

### 两车分账（2026-10-05 按当前定稿方案核算）

> 口径：官方物资表整表 ¥353.48 为两车共用池；下表"专属"= 直接装在该车上的件，"分摊"= 充电器/线材/工具等按车分摊。3D 打印按耗材计价（校内打印按此口径；如外送代打另加代打费）。

| 分类 | 1 号车（过桥版） | 2 号车（隧道版·甲方案） | 两车共用/分摊 |
|---|---|---|---|
| 主控/遥控 | STM32 ×1、PS2 ×1 | STM32 ×1、PS2 ×1 | ST-Link ×1 |
| 驱动 | TT 马达 ×4、DRV8833 ×2 | TT 马达 ×4、DRV8833 ×3（含软压轮 1 路） | 官方表 DRV8833 仅 4 块 → **补 1–2 块**（留备用） |
| 电源 | DC-DC ×1、电池盒 ×1、18650 ×2 | DC-DC ×1、电池盒 ×1、18650 ×2 | 充电器 ×1 |
| 舵机 | **3 路**：转塔 SG90 + 料仓挡片 SG90 + 末端备用 SG90（举升走丝杆自锁） | **2 路**：耙钩 SG90 + 唇板推拉 SG90 | 官方表 SG90 共 4 个、MG995 ×2（举升按 N20+丝杆方案则 MG995 留作备用） |
| 机械专用 | 60mm 麦轮 ×4、底盘板 ×1、T8 丝杆 170+铜螺母、φ6 光轴+LM6UU、605ZZ/608 轴承、倍速绳+滑轮、2mm 铝板/弹片/钢丝、配重 150g | 60mm 橡胶轮 ×4、底盘板 ×1、拉簧 ×2、微动开关 ×2、φ3 钢棒/φ4 轴+铜套、M3 热熔螺母+螺丝包 | 扎带/热缩管/硅胶线/端子、螺丝螺母套装 |
| 传感器 | — | 红外/灰度（表外，新生组允许） | — |
| 安全件 | 无线继电器 ×1 | 无线继电器 ×1 | — |
| 打印耗材 | PLA ≈0.5kg | PLA ≈0.4kg + TPU ≈0.2kg（软叶） | 亚克力盖板（2 号车低仓） |
| **估算小计** | **≈ ¥250–320** | **≈ ¥250–300** | 合计官方表 ¥353.48 + 添置 ¥150–250 ≈ **¥500–600** |

**报销口径**：新生组建议 ≤400 元、报销硬上限 400 元（未过中期不予报销）；超出自付。分账主要用于内部核算与第 12 项文档展示，**优先保证：电子补购（DRV8833）、2 号车橡胶轮/拉簧/微动/钢件、打印耗材**；亚克力、备用麦轮可缓。

**成本台账（财务：杨佳琳）**：每笔采购登记"条目 / 金额 / 发票 / 日期 / 状态"，3D 耗材也留票；借用 2025 旧件单独登记（赛后归还、不参与报销）。

### 目标

按需下单，避免买贵、买错、买重复。

### 开发历程（从早到晚）

**2026-09-28 待办**：按官方表核对数量 → 与李秉航确认传感器型号 → 比价下单 → 到货验收拍照。

**2026-10-05 更新（按甲方案与 V1.5）**：

- 2 号车专属清单替换为：**唇板导轨 + SG90 推拉、软压轮（TPU 软叶）、单向门、低仓 2×6 十二格、耙钩模块（SG90+拉簧+双限位）、窄舌铲（右道）**；
- 1 号车保留 3 路舵机（满足基础功能第 5 项"同一台车 ≥3 舵机"）；举升若采用 N20 + T8 丝杆方案，MG995 转为备用；
- DRV8833 需求从"6 块"修正为 **5 块**（1 号车 2 + 2 号车 3），官方表已有 4 块 → 补 1–2 块；
- 新增表外必买：**60mm 橡胶轮 ×4、拉簧 ×2、微动开关 ×4、φ3 钢棒、φ4 钢轴 + φ6×φ4 铜套、M3 热熔铜螺母**；
- 上表与小节由"成本核算"进一步按发票回填实付金额。

<!-- 追加位置：下单与到货记录 -->

### 验证结果

（待补：订单截图、实付金额、到货验收照片）

## 成本核算与报销（财务：杨佳琳）

### 目标

控制在 400 元以内，并保留完整票据。

### 开发历程（从早到晚）

**2026-09-28 规则记录**：报销上限 400 元；**未通过中期考核不予报销**；比赛结束后需自行制作报销单；无线继电器相关采购不适用该上限条款。

<!-- 追加位置：台账更新记录 -->

### 验证结果

（待补：台账表——条目、金额、发票、日期、状态）

## 需要 3D 打印的零件

### 开发历程（从早到晚）

**2026-09-28 待办**：等 GSing 战队发布集中打印规范后再批量打印；先出零件清单（名称、材料、打印参数、用时）。

<!-- 追加位置 -->
