AFlyingPiglet/shangjianyinqing/docs/1.4-舵机运动（单一）.md

# 1.4 舵机运动（单一）

- **考核要求**：能完成至少一个舵机的转动。
- **当前状态**：✅ 已调通（待补视频）。

## 我们的实现

1 号车：肩、肘各 1 颗 MG995，夹爪 1 颗 MG90S；2 号车：1 颗 MG90S 驱动风车摇柄。均由主控 PWM 控制。

## 方案与取舍

- 采用标准舵机 + PWM 直驱，接线与调试简单；1 号车肩/肘用大扭矩 MG995 承担整臂负载，末端用轻量 MG90S。
- 2 号车把摇柄、腕折合并到 1 颗舵机 + 连杆机构（关节处 0 根电线），少一个舵机、少一处卡死点。

## 开发历程（精简）

- 2026-09-28：确定 3~4 舵机架构。
- 2026-10-07：快换多头方案，舵机数量下调。
- 2026-10-09：2 号车摇柄改绕车头纵轴 + 连杆腕折 90°。
- 2026-10-13：确认 2 号车正式只装 1 颗 MG90S（唇板 SG90 为选配）。

## 证据

- [x] 舵机控制代码：[app_arm.c](code/Clion_test/Core/Src/app_arm.c)、[app_gripper.c](code/Clion_test/Core/Src/app_gripper.c)
- [x] 单个舵机转动视频（待提供）
