AFlyingPiglet/shangjianyinqing/docs/1.9-方块携带（单一）.md

# 1.9 方块携带（单一）

- **考核要求**：能抓起并携带一颗方块。
- **当前状态**：结构方案完成，未上电实测（实物未组装，见 1.1）。

## 我们的实现

- 1 号车：快换统一接口（背板 18×48×24 + 公板 10×16×6，2×M3@±16 + φ5.05 定位销），三种头——平行夹爪（张开 38~40 / 合拢 28~29）、钩子插头（物资架）、弹片内撑（被动、断电不掉）；收进堆块筒。
- 2 号车：松树针头（洞穴块）+ 一体斜铲唇（地面块）→ 无隔板托盘。

## 方案与取舍

- 三种头共用同一接口，按目标换头（约 10 秒），避免多套带电机构；被动头断电不掉块。
- 2 号车把「抓」简化为「插针—摇出—铲唇接收」，减少控制难度。

## 难点与解决

- 待上电实测；夹爪对位容差 ±4~5 mm 大于机械累计误差 ±3.3 mm（设计核算）。
- 细针 3D 打印质量差 → 改「圆柱体 + 手工插细铁丝」的松针头（史沐生 10-13 日报）。

## 开发历程（精简）

- 2026-09-28：六种取块方式对比 → 弹片内撑 / 倒刺 / 耙钩组合。
- 2026-10-07：快换多头方案定稿。
- 2026-10-13：松针头（细铁丝）与堆块筒落地。

## 证据

- [x] 夹爪与举升代码：[app_gripper.c](code/Clion_test/Core/Src/app_gripper.c)、[app_lift.c](code/Clion_test/Core/Src/app_lift.c)
- [ ] 抓起并携带 1 颗方块视频（待提供）
- [ ] 三种取块头实物/渲染图（待提供）
