AFlyingPiglet/shangjianyinqing/docs/1.10-方块携带（多项）.md

# 1.10 方块携带（多项）

- **考核要求**：能连续携带多颗方块。
- **当前状态**：结构方案完成，未实测。

## 我们的实现

- 1 号车：堆块筒 53×80×64（内腔 50×74），垂直垒 2 层 = 2 块 + 爪持 1 = 3 块/趟；选配加高圈（+31，98 高）→ 3 层 4 块/趟；落格 KW11 ×2。
- 2 号车：无隔板托盘 204×68×35，前端持续进块。

## 方案与取舍

- 立柱前只有约 54 mm，平铺 4 块需要 120 mm，且手臂无偏航自由度 → 只能垂直垒放（筒壁约束）+ 多跑一趟；加横移机构复杂，不采用。
- 2 号车托盘去掉全部隔板（隔板会顶块），改为前端全开的平盘。

## 难点与解决

- 堆块筒初版 98 高过高 → 砍到 64（矮 1/3），垒 2 层即够；方块是刚体，只要筒壁围住即可垂直垒高。
- 待实测：连放 2 块 ×20 次不塌。

## 开发历程（精简）

- 2026-10-13：料仓改为堆块筒（3D 打印件 53×80×64）。
- 2026-10-13：2 号车托盘去隔板（204×68×35）。
- 待办：入仓实测（20 次不塌）。

## 证据（待补）

- [ ] 连续入仓视频（文件名：待提供）
- [ ] 20 次不塌测试记录（待提供）
