AFlyingPiglet/shangjianyinqing/docs/04-设计思路记录.md

# 设计思路记录

> 手册要求把"机器人的设计思路"以日志形式记录下来。本文专门记录**想法的变化**：
> 改了什么、为什么改、影响什么。跟 `01`~`05` 的区别是：那里按功能写完整方案，这里按下日期记录每次调整。
> 结构：按机器人分板块，标题下面按日期从早到晚追加。

## 1 号车

**2026-09-28 初始设计思路（立项）**

- 记录人：蔡昌恒
- 适用对象：1 号车
- 改动（改前 → 改后）：从零开始 → 定为"麦轮取块车"，人工 PS2 操作，抢高分道具
- 为什么改：1 号车在 h5/a4 高台启动，下坡就能到本方半场；黄块 4 分/颗，是全场价值最高的目标，值得用一台车专门去拿
- 影响与后续动作：据此确定尺寸 240×160×200、举升 260 mm、三种取块头；遗留问题——车宽 160 mm 过不了 150 mm 桥面

<!-- 追加位置 -->

**当天照片：**

蔡昌恒-2-b36826c4

### 2026-10-04 一号车 V2 定稿：部件详图、高度链复核与下探底架

- 记录人：蔡昌恒
- 适用对象：1 号车
- 改动（改前 → 改后）：改前：三档高度表 + 转塔 φ46 + 丝杆 160 + 背部 8 格竖排料仓 + 前开口低仓；改后（V2）：取块头轴线绝对高度体系 + 转塔 φ32 + 丝杆 170 + 2×5 十格托盘（格口朝上）+ 回缩臂 + 刮料唇，立柱底座改为轮间下探底架（离地 10 → 柱顶 200）。
- 为什么改：① 初始高度红线 ≤210，立柱基准不对会到 255；② φ46 在低位作业时盘底离工作面只剩 2 mm（φ32 后 9 mm）；③ 丝杆 160 对一级 130 只剩 10 mm 余量；④ 臂低于板面 100 时后收会撞 40 mm 高的料仓壁。
- 影响与后续动作：底盘板开 34×28 让位槽，打印底座板 60×40×5 与 L 形侧板 ×2；电控增加“臂低于板面 100 mm 禁止后收”的互锁；图纸汇总 V2 共 16 张（两车总图 + 分工 + 详图 1–10 + 高度体系 + 对位误差表 + 手柄映射）。

**当天照片：**

蔡昌恒-1-f1df20ad
蔡昌恒-2-7d33fbbb
蔡昌恒-3-34462ad7
蔡昌恒-4-e6a2aa99
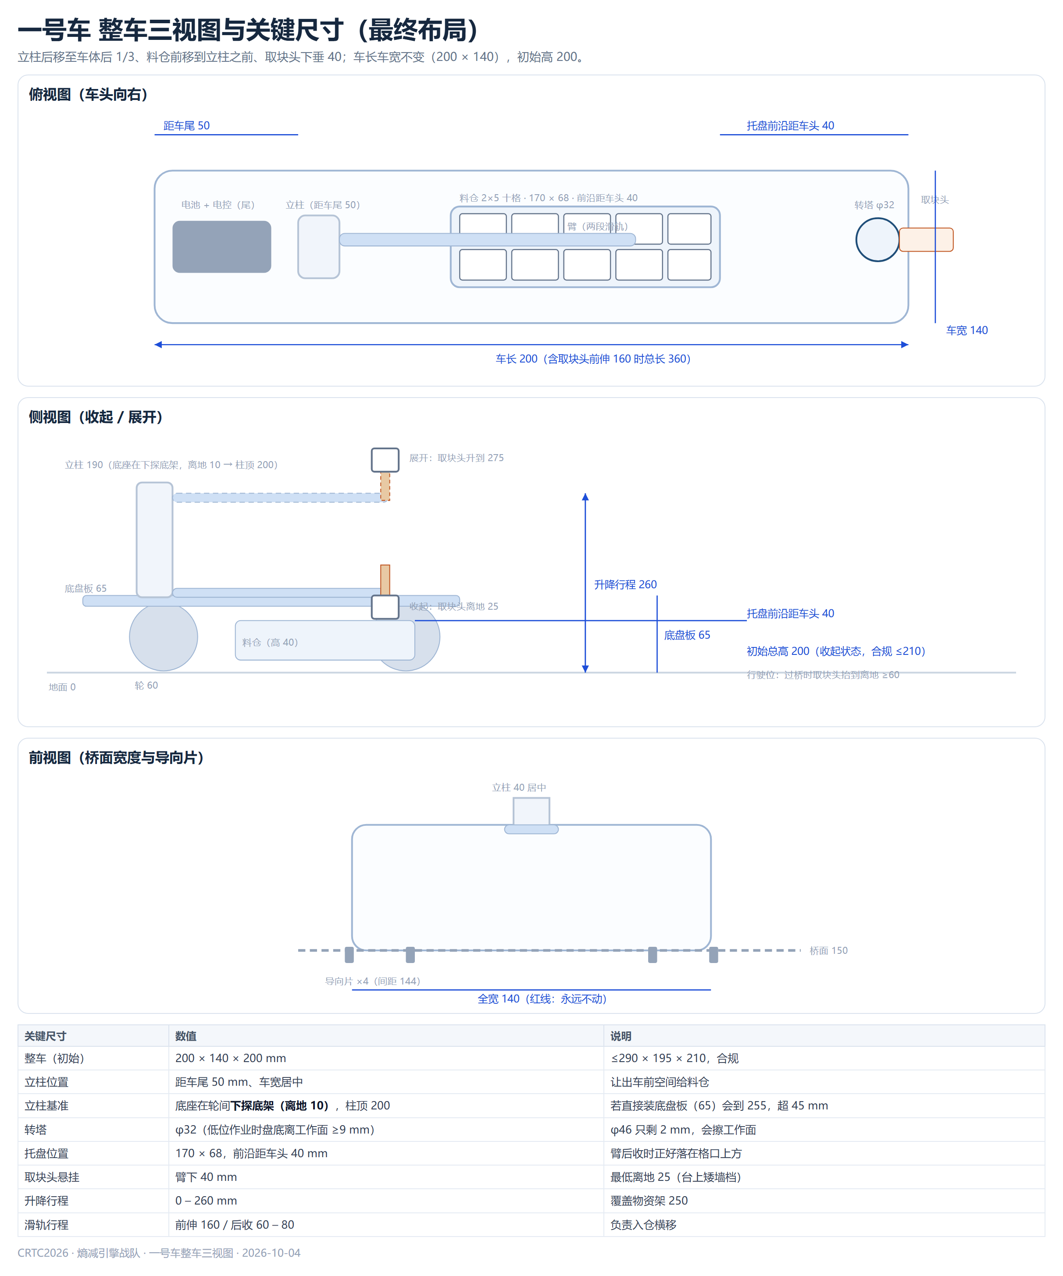
[picture p55: docs/images/日报配图/2026-10-04/蔡昌恒-5-f3be184f.png]
蔡昌恒-5-f3be184f

蔡昌恒-6-9f44d16f
蔡昌恒-7-ab93c627
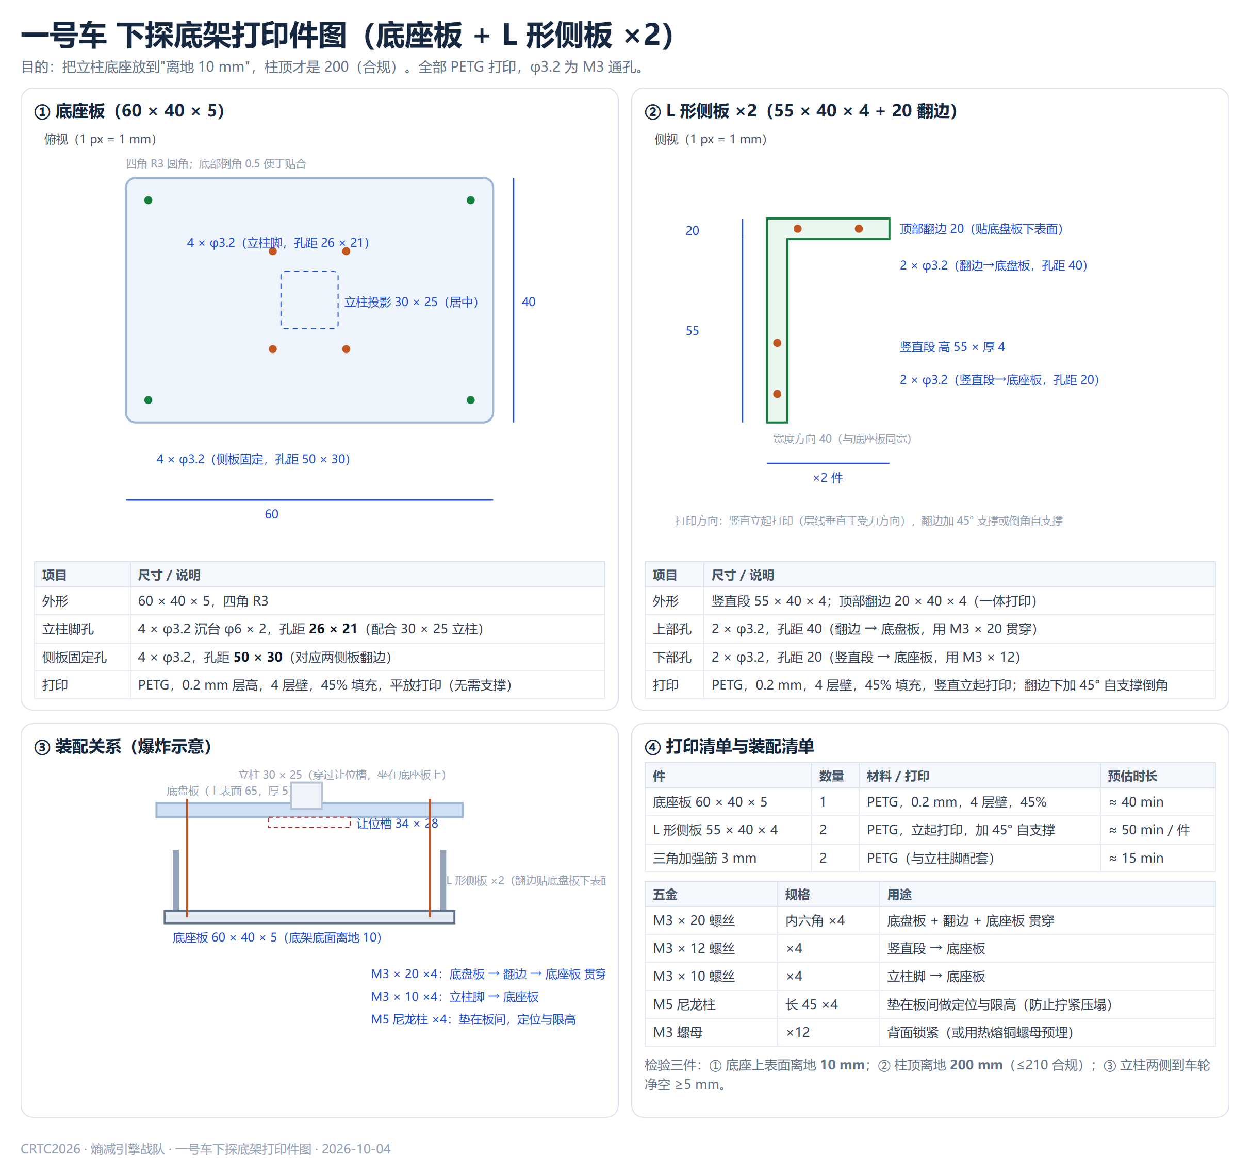
[picture p56: docs/images/日报配图/2026-10-04/蔡昌恒-8-51240b93.png]
蔡昌恒-8-51240b93


**2026-10-04 举升六档行程与取块高度体系（修正版）**

- 记录人：蔡昌恒
- 适用对象：1 号车
- 改动（改前 → 改后）："相对车底的举升三档" → **按"取块头轴线离地绝对高度"定义的取块高度体系**（高度 = 方块内腔中心离地）：

| 目标（方块内腔中心） | 离地高度 | 相对底盘板（65） | 车在哪 | 备注 |
|---|---|---|---|---|
| 地面白块 a8 / h1 / c4 / f5 | 15 mm | −50（下探） | 地面 | 取块头最低位 |
| 台阶面白块 e8 / d1 · d6 / e3 | 165 mm | +100 | 地面 | 台阶层 |
| 附属高台矮墙白块 e8' / d1' | 185 mm | +120 | 地面 | 矮墙槽（游隙 ±0.75） |
| 物资架黄块 e3 / d6 | 250 mm | +185 | 地面 | 行程上限 |
| 台面矮墙白块（中央高地十字基座） | 325（台面 +25） | −40（下探） | 300 高台上 | 过桥后取（V1.5：基座 300×300，槽位距中心 64.25） |
| 焦点黄块（70 平台上） | 385（台面 +85） | +20 | 300 高台上 | 先手目标 |

- 为什么改：
  1. 车底盘板在离地 65 mm（轮 60 + 板 5），而地面方块内腔中心只有 15 mm → 取块头必须能**下探到车底以下 50 mm**；旧版"相对车底 0 档"的说法会误导。
  2. 行程按 15 → 275 分配（260 mm），覆盖最高目标 250 并留 25 mm 余量。
  3. **行驶位单独设一档**：过桥（拱高 15）与上台阶时，取块头抬到离地 ≥60，不低于车底，避免磕碰。
- 结构落实：
  - 三合一取块头装在臂前端"向下伸 50 mm 的支臂"上；臂最低位 = 贴地取块。
  - 举升改"外柱 190（内藏 T8 丝杆 160 + φ6 导轨 + 螺母滑块行程 130）+ 内段伸缩 130 + 倍速绳 1:2"——折叠状态整车 200 满足初始高 ≤210，展开 260 取物资架。
  - 立柱从"最前"后移到车体后 1/3；料仓前移到立柱前面（格口朝上）；前伸臂改两段滑轨可后收 60–80 mm，用 4 mm 刮料唇把方块刮进格子（被动弹片头不会自己松口）。
- 包络口径修正：**按"盒子"判据自检**（≤445×400×450）——展开 360×140×300，长方向余 85 mm；球体判据只在"高位展开"时勉强（余 6 mm），取块头下探到 15 mm 时允许半径仅约 220 mm，低位过不了。规则为两条满足其一，检录按盒子口径。
- 影响与后续动作：
  - 电控按绝对高度对档（15 / 165 / 185 / 250 / 325 / 385），并增加"行驶位 ≥60"状态；
  - 矮墙槽（±0.75 游隙）与物资架（0.5 杆缝）两处按《取块头对位误差表》做专项验证；
  - 洞穴黄块 ×2（d1 / e8 台阶下）仍由 2 号车的翻转耙钩负责。

- **高度链核对（2026-10-04 追加，脚本逐段复算）**：

| 项目 | 数值 | 结论 |
|---|---|---|
| 初始高（立柱底座在轮间下探底架，离地 10） | 10 + 190 = **200** | 通过（余 10） |
| 初始高（若立柱直接装底盘板 65） | 65 + 190 = 255 | **超标 45，不可用** |
| 臂需要到达的最高位（取物资架） | 板面上 **225** | 设计行程 260，余 35 |
| 臂最高可达（柱顶 330 → 板面上 265） | 265 | 满足 |
| 展开最高（含转塔） | 约 350 | 盒子与球体判据均通过 |
| 入仓横移需要臂高于板面 | 100 | 行程内满足 |

- 由此落实四处修正：
  1. **立柱底座固定在轮间下探底架（离地 10 mm）**，底盘板开 **34 × 28 让位槽**，M3 × 20 螺丝 ×4 + M5 尼龙柱 ×4 夹紧；柱顶 200（若按常规装在底盘板上会到 255，超 45）；
  2. **转塔盘 φ46 → φ32**：低位作业（取块头轴线离工作面 25）时盘底离工作面由 2 mm 提升到 9 mm；
  3. **丝杆由 160 → 170**（一级 130 + 螺母 20 + 支承余量）；导轨 190 经核算余 36；
  4. **程序互锁：臂低于板面 100 mm 时禁止后收入仓**（防止撞 40 mm 高的料仓壁）。

- 分工（队长定，2026-10-04）：**1 号车 = 中央高地（焦点黄块 ×1 + 周边矮墙白块 ×4）+ e3 物资架黄块 ×1**；**2 号车 = 地面散块（a8/h1/c4/f5）+ 洞穴黄块（d1/e8）+ d1 区域（台阶面白块 + 附属高台矮墙白块）**；**两车均为 PS2 手动操作**（倍率口径待答疑确认：按"一般"两车合计约 27 分，若 2 号车按半自动约 32.5 分）。

- 附图（V2 最终版，另存于 `docs/images/设计图/`；中间过程版本不再收录）：

**两车分工与目标清单：**

两车分工与目标清单

**1 号车设计方案 V2：**

1号车设计方案V2

**2 号车设计方案 V2：**

2号车设计方案V2

**一号车部件详图 1–10：**

一号车详图1-取块头与转塔

一号车详图2-升降与伸缩总成

一号车详图3-料仓总成

一号车详图4-整车三视图

一号车详图5-三种拾取姿态

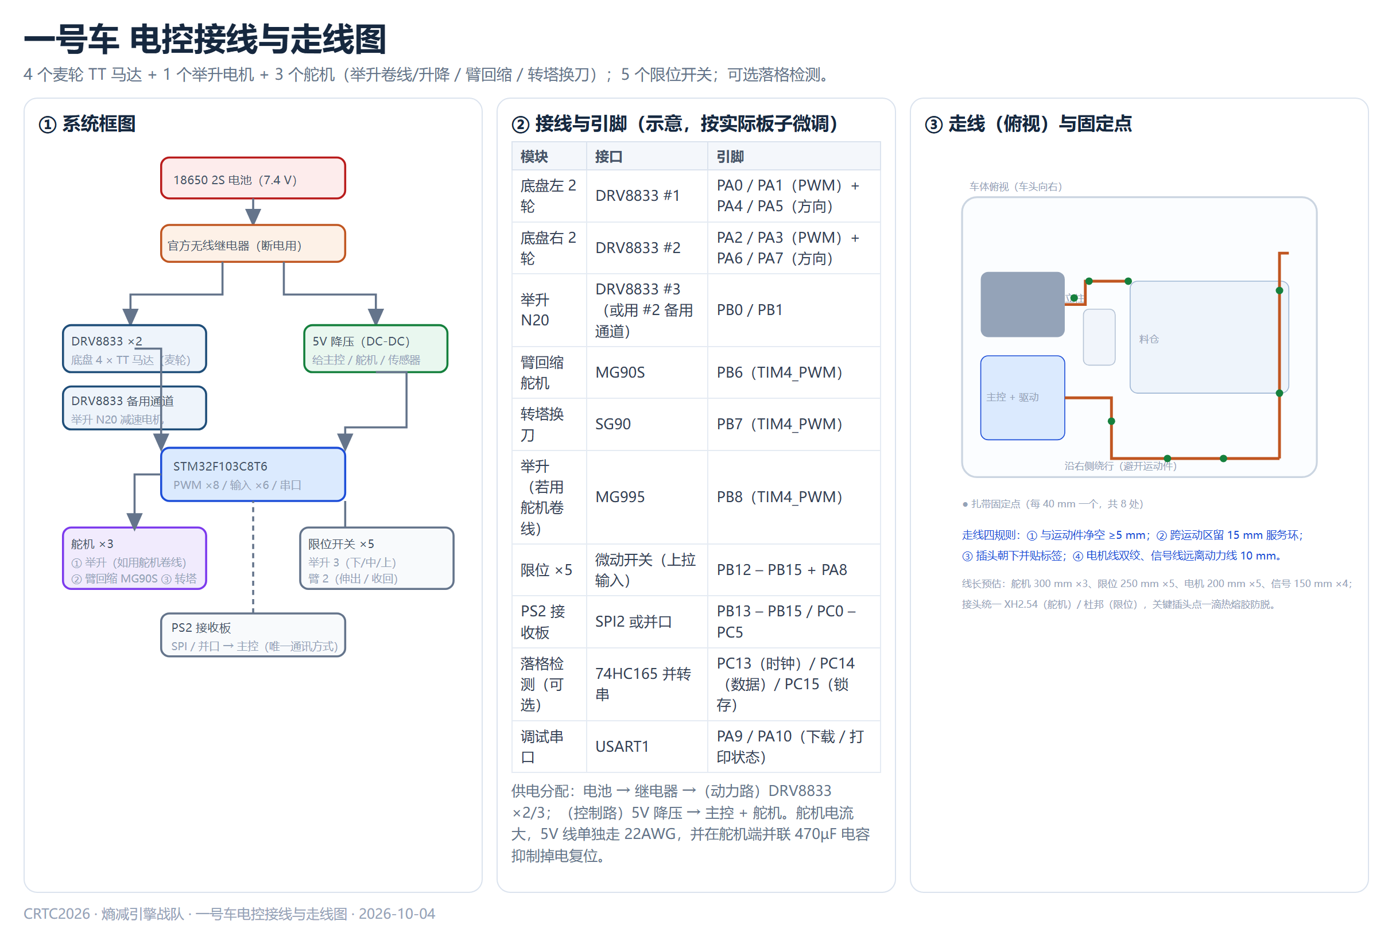
[picture p57: docs/images/设计图/一号车详图6-电控接线与走线.png]
一号车详图6-电控接线与走线


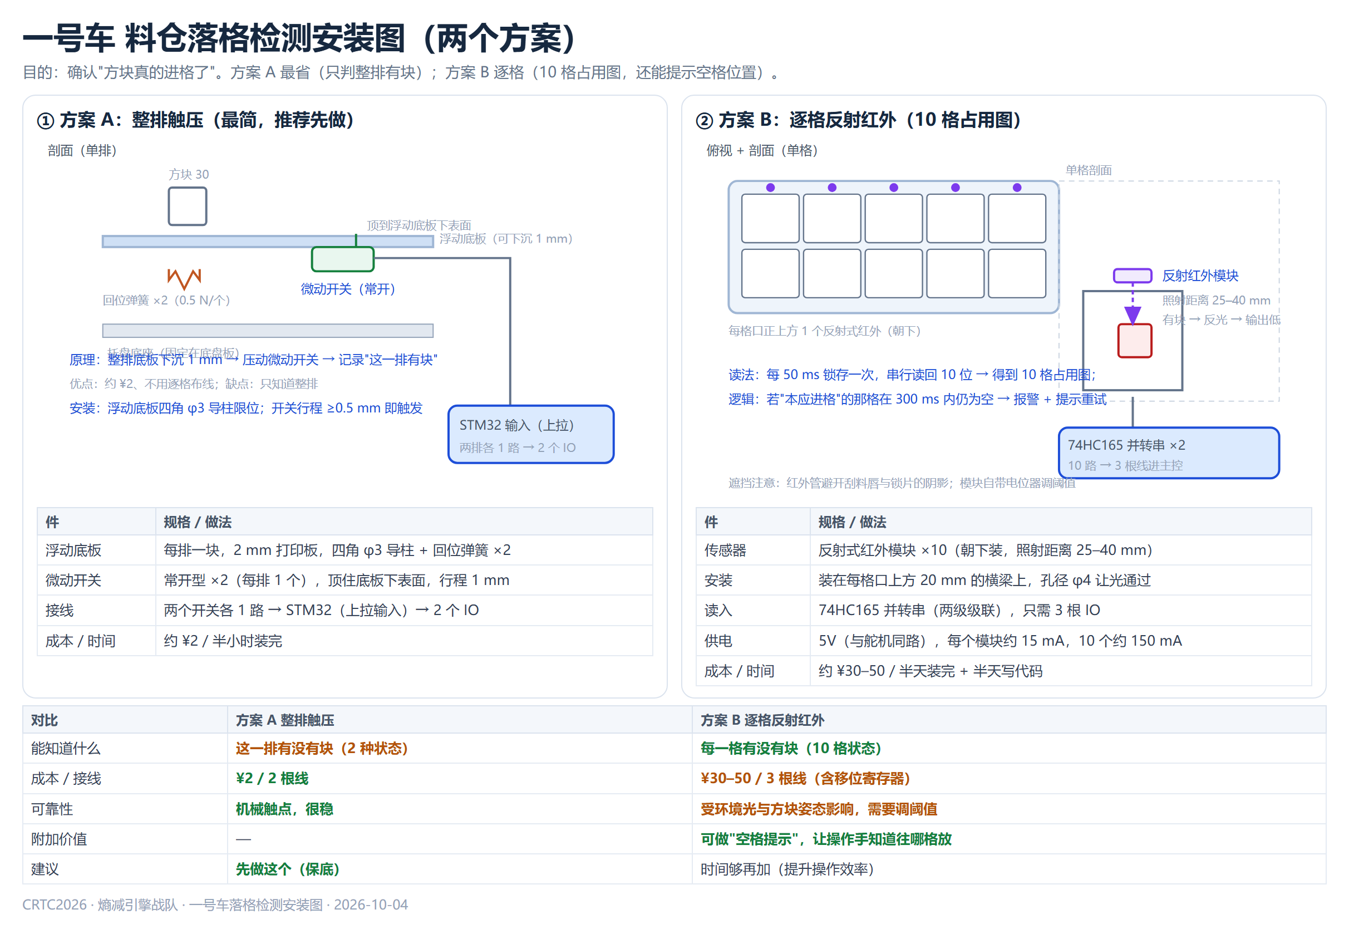
[picture p58: docs/images/设计图/一号车详图7-落格检测安装.png]
一号车详图7-落格检测安装


一号车详图8-高度链核对

一号车详图9-下探底架与让位槽

一号车详图10-下探底架打印件

**取块高度体系与对位误差表：**

1号车取块高度体系

取块头对位误差表

**手柄按键分配：**

手柄按键分配

### 2026-10-08 决定一号车改用 60mm 普通橡胶轮

- 记录人：李秉航
- 适用对象：1号车
- 改动（改前 → 改后）：剔除1号车使用麦轮进行原地旋转的可能
- 为什么改：一号车任务核心是“上坡 → 举升 → 夹块 → 回仓”，不需要横向平移；麦轮辊子摩擦小，爬 26.6° 坡（方案书里的坡比 0.5）容易打滑，橡胶轮抓地更好。差速代码也比麦轮逆解简单，调试快。 放弃麦轮的直接代价：失去侧移贴台能力，贴物资架/焦点时要“斜开+原地转正”，走位变慢。方案书里“加 150~250g 后配重下坡余量 ≥30°”的结论对橡胶轮只会更宽松，所以爬坡安全余量反而变大。 1号车走拱桥使用麦轮不方便
- 影响与后续动作：chassis.h需要改

**当天照片：**

李秉航-1-e48bd297
## 2 号车

**2026-09-28 初始设计思路（立项）**

- 记录人：蔡昌恒
- 适用对象：2 号车
- 改动（改前 → 改后）：从零开始 → 定为"四轮差速收运车"，全自动无操作手，负责刷数量
- 为什么改：白块在全自动模式下按 2 分/颗计，专职收地面散块比让 1 号车兼顾更划算；且自动车不怕冲撞、判罚风险低
- 影响与后续动作：据此确定铲唇+拨轮+单向门、10 格料仓；遗留问题——整车 180 mm 高，钻不过 130 mm 的桥下空间

<!-- 追加位置 -->

**当天照片：**

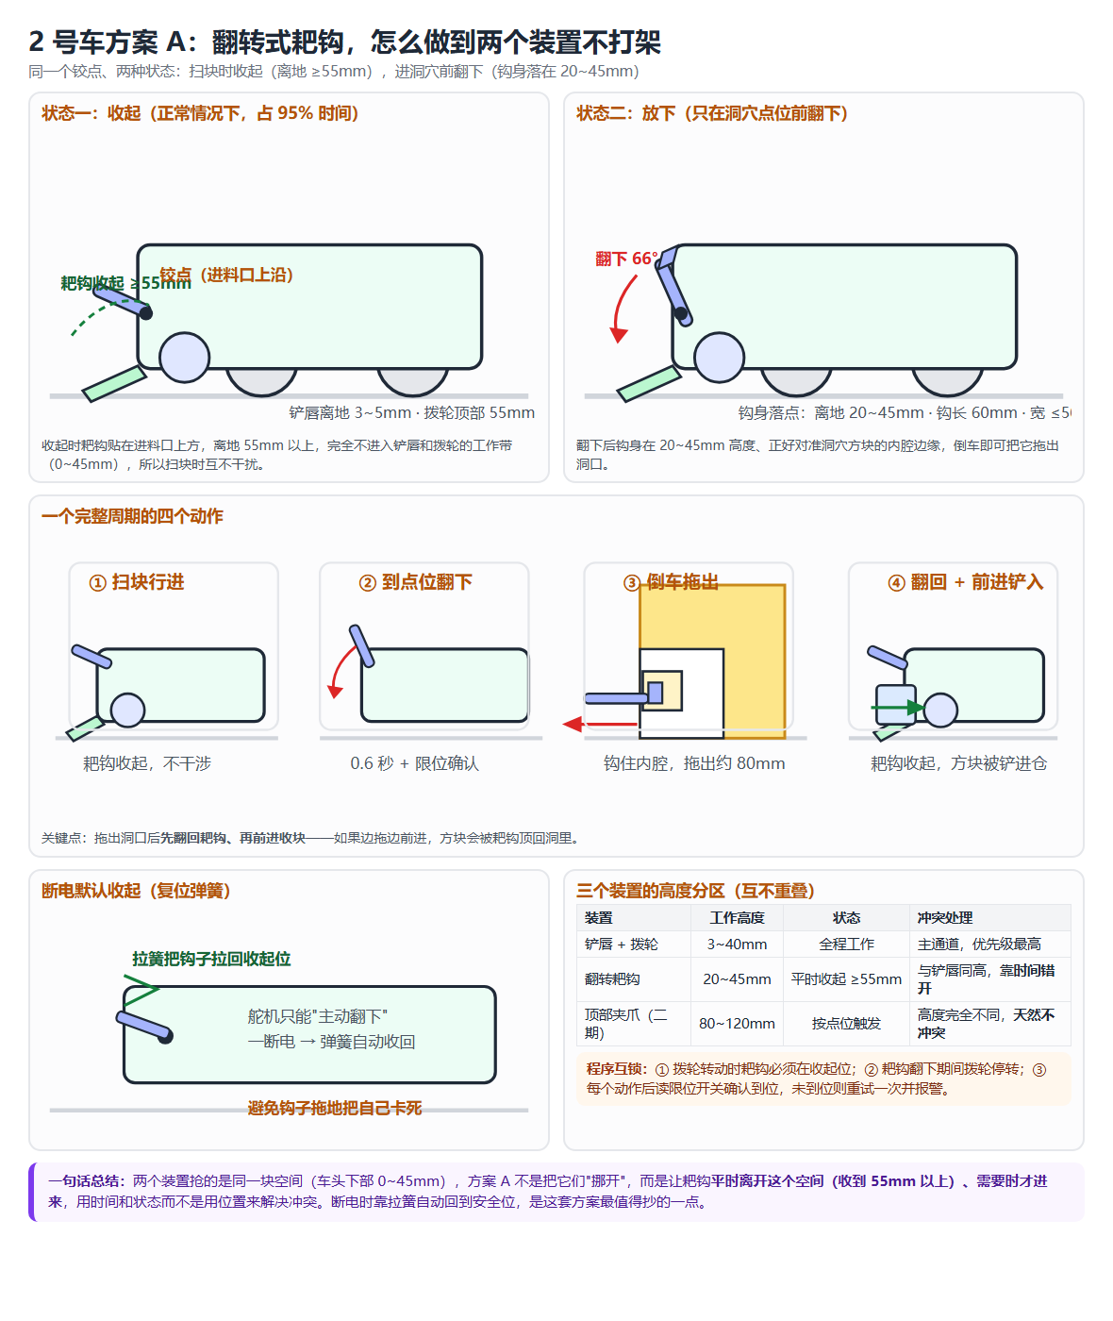
[picture p59: docs/images/日报配图/2026-09-28/蔡昌恒-1-bfba95ef.png]
蔡昌恒-1-bfba95ef


### 2026-10-05 二号车 V3 定稿：低仓直落 + 耙钩居中 + 铲板 SG90 推拉 + 导入缓坡与随动辊 + 方案 C 预留位

- 记录人：蔡昌恒
- 适用对象：2 号车
- 改动（改前 → 改后）：V2 是“铲板被动回缩 + 45° 短坡”；V3 改成“铲板舵机推拉（平时全收）+ 13° 缓坡 + φ6 随动辊”，另外把方案 C（铲唇抬头）的铰链位和舵机位先留出来。
- 为什么改：① 检录要求初始长度 ≤290，铲板必须能收进去；② 方块在路上容易顶歪、卡边；③ 先把升级接口留好，免得以后返工。
- 影响与后续动作：所有图和文档都切到 V3；下一步出《M1 打印清单》（要把 φ6 滚轮、轴、两侧支架加进去）；验证还是老三样：同一颗方块连收 20 次、纸板搭 70×70×50 的洞、e1/d8 坡上下 10 次。

**当天照片：**

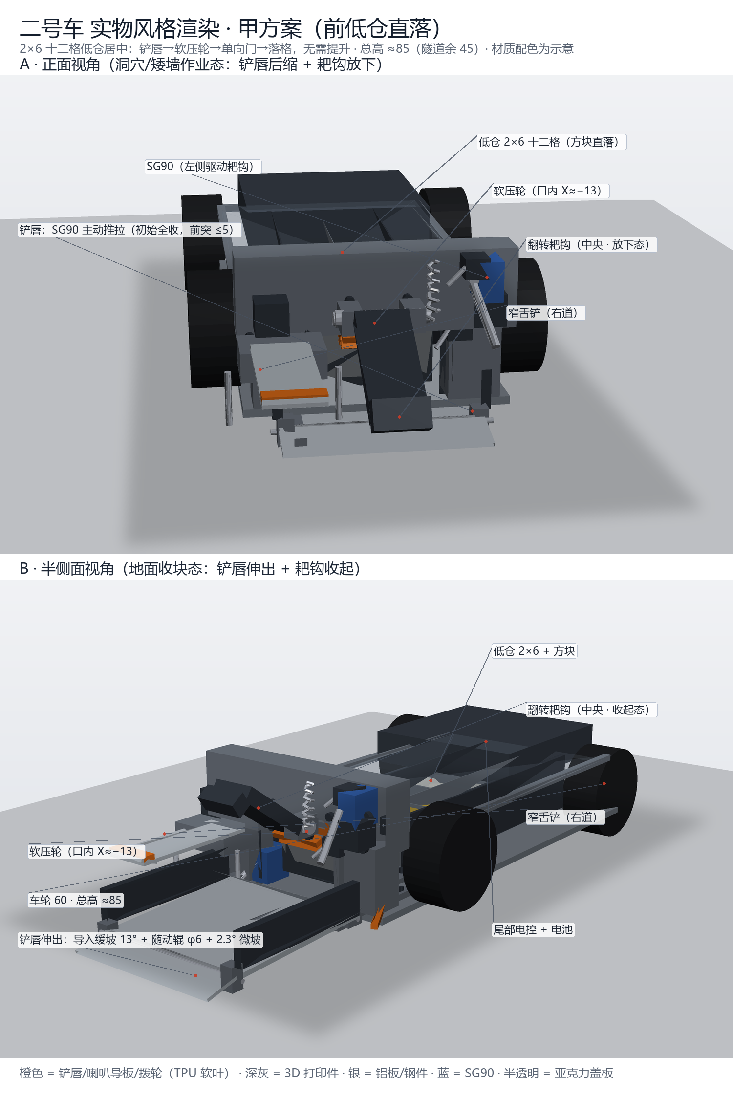
[picture p60: docs/images/日报配图/2026-10-05/蔡昌恒-1-f63f3c6b.png]
蔡昌恒-1-f63f3c6b

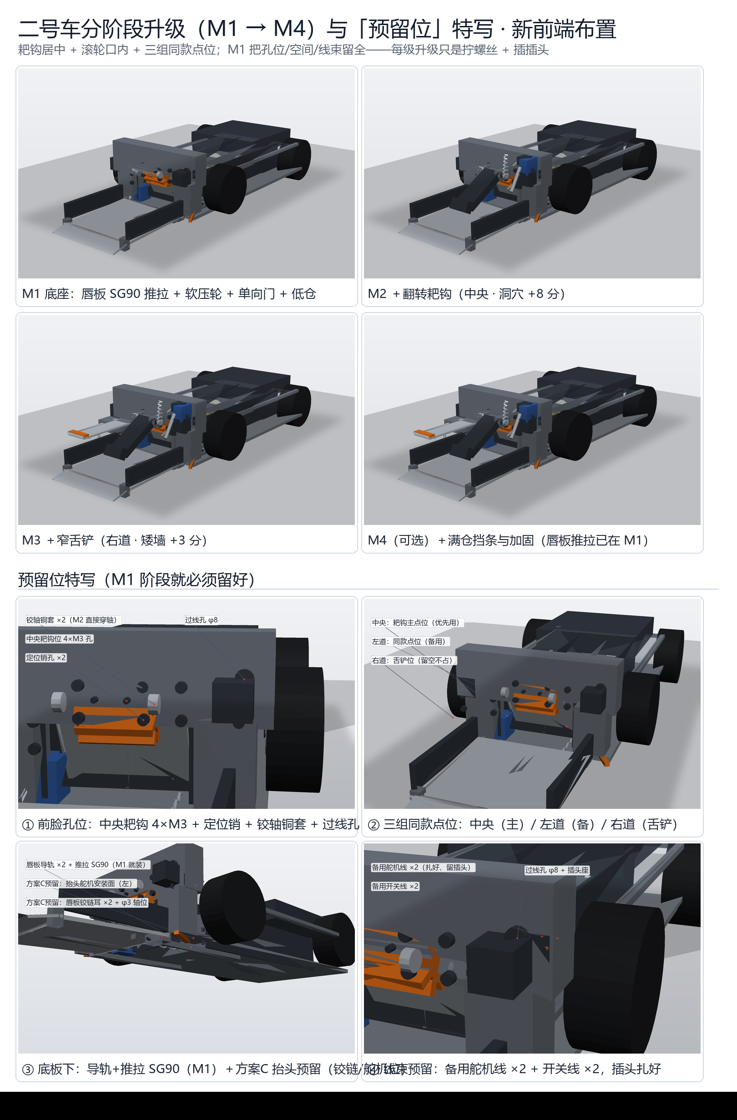
[picture p61: docs/images/日报配图/2026-10-05/蔡昌恒-2-06a4d9b5.png]
蔡昌恒-2-06a4d9b5

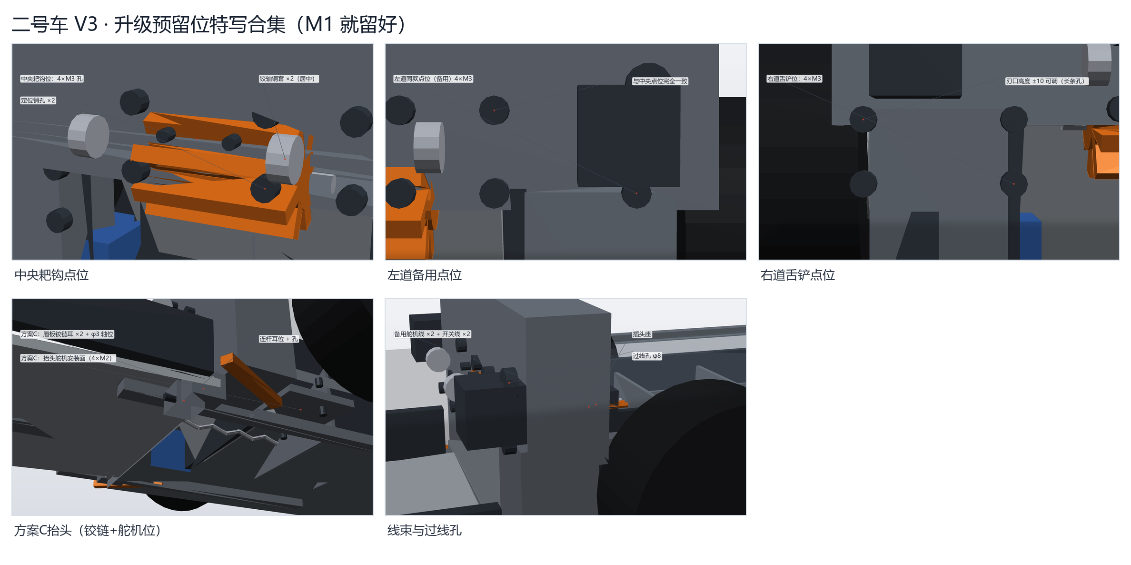
[picture p62: docs/images/日报配图/2026-10-05/蔡昌恒-3-53c8fd49.png]
蔡昌恒-3-53c8fd49


### 2026-10-09 取块头改"风车摇柄 + 连杆腕折"，铲唇改一整块斜面板，底盘后缘收 10mm

- 记录人：蔡昌恒
- 适用对象：2 号车
- 改动（改前 → 改后）：改前＝转盘绕竖轴旋转 + 竖直臂 + 刺头 90° 折叠 + 铲唇开 24 让位缝；改后＝绕车头纵轴的风车摇柄（MG90S 直驱 180°）+ 连杆腕折 90° + 一体斜铲唇（抬起 35°）。
- 为什么改：① 转盘侧摆会超长、又多一个卡死点；② 铲唇必须一整块、前面只露坡面；③ 关节走线越少越不容易出故障。
- 影响与后续动作：图册 24~31 已全部更新并同步三处；下一步 ① 打印针头/摇臂/挡块做连杆实测；② 重画 19~23 那 5 张旧方案文案；③ 验收三件事：收车位整车 288 复尺、刺头过 15 孔 20 次、收放 20 次不卡。 今天学到一条通用经验：能"机械过关节"的动作就别用电线过关节——连杆/凸轮穿过旋转关节，比在关节处留活动线更耐用；这次腕折 90° 就是这样省掉一个舵机和 3 根线。 图 1 风车式转动四帧：0°取块位 → 60°/120°摇起 → 180°收车位（绕车头纵轴转，正面看像风车） 图 2 装车两姿态：工作位 347×186×93 / 收车位 288×186×129（全方向合规，桥下也过） 图 3 腕折连杆式：φ2 推杆＋30°挡块＋复位簧＋限位销，旋转关节 0 根线 图 4 布线方案：静态线走底盘内+φ8 过线孔；腕折改连杆后关节无电线 图 5 打印件清单与耗材估算：二号车 ≈249g、一号车 ≈339g，合计留余量 ≈720g

**当天照片：**

蔡昌恒-1-abb6618e
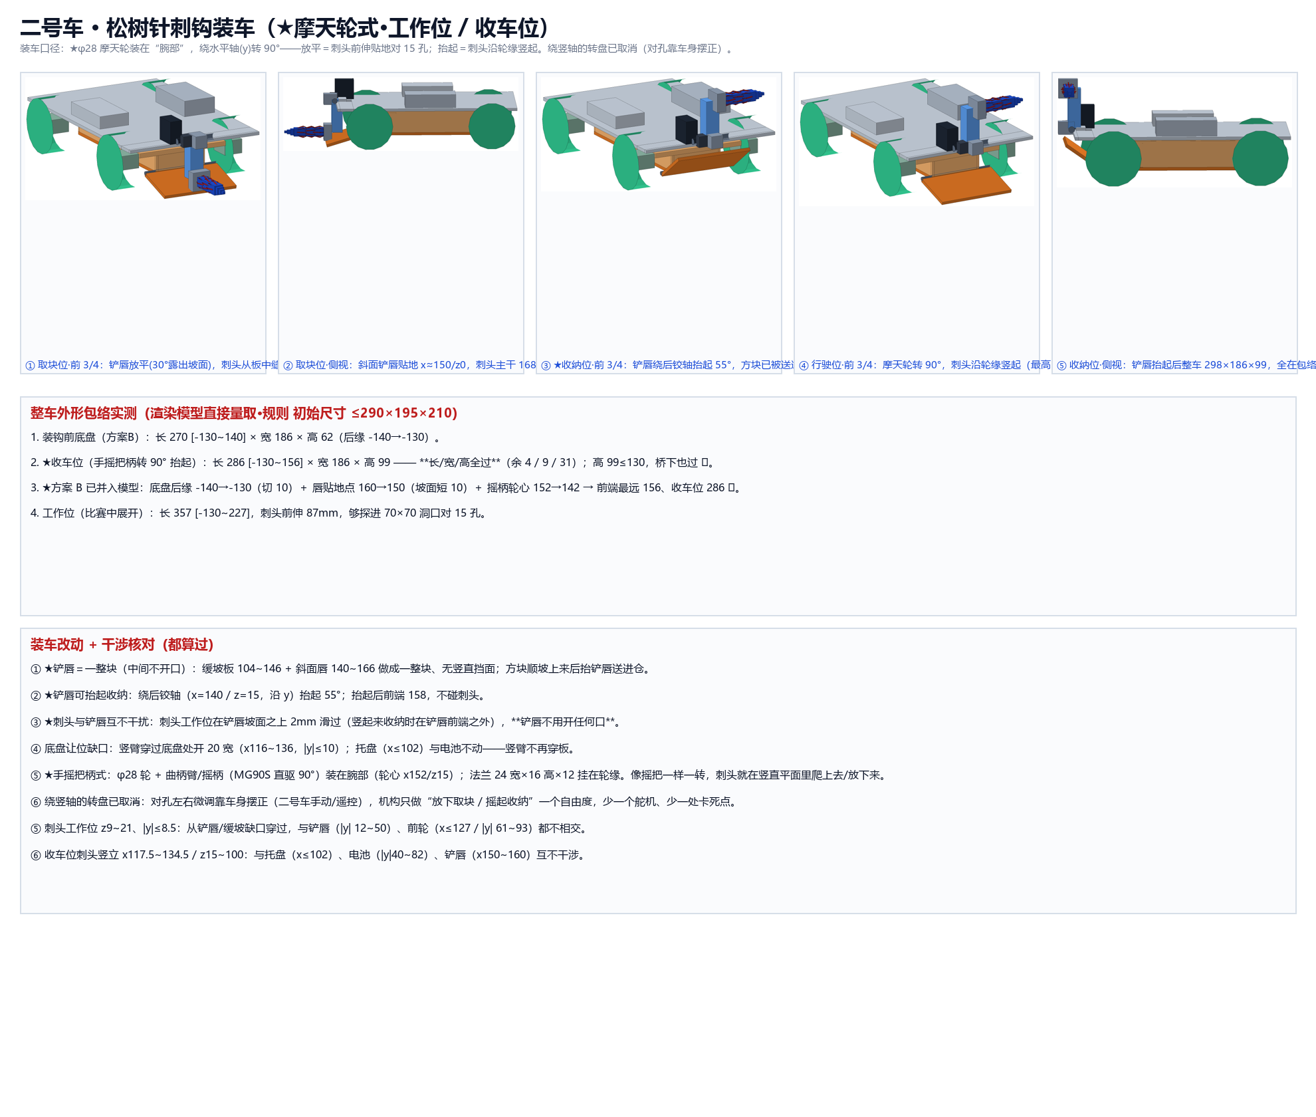
[picture p63: docs/images/日报配图/2026-10-09/蔡昌恒-2-506fe10e.png]
蔡昌恒-2-506fe10e

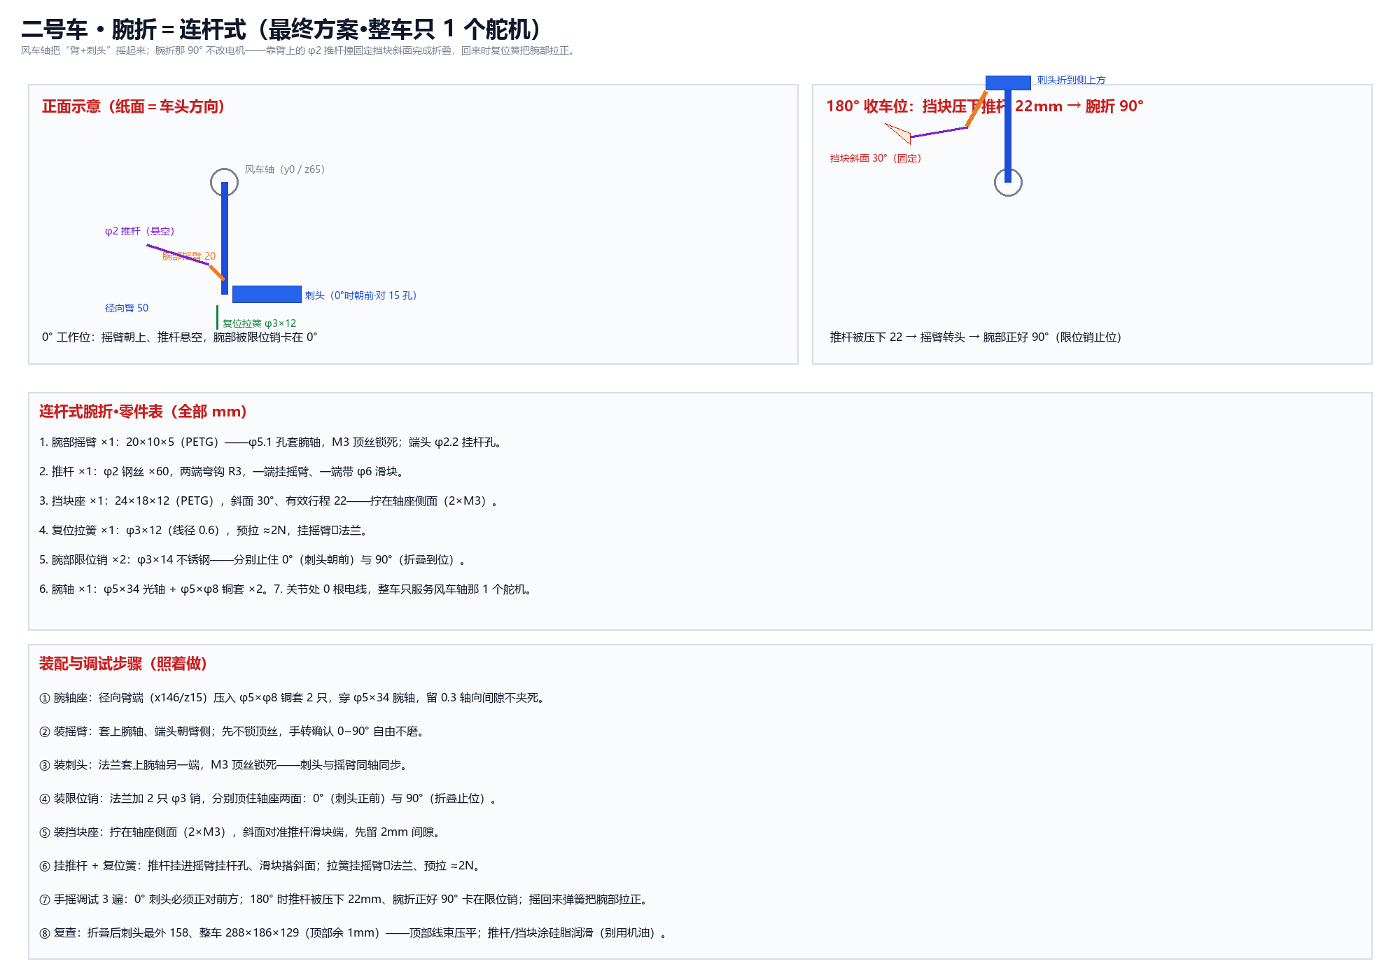
[picture p64: docs/images/日报配图/2026-10-09/蔡昌恒-3-57f47da5.png]
蔡昌恒-3-57f47da5

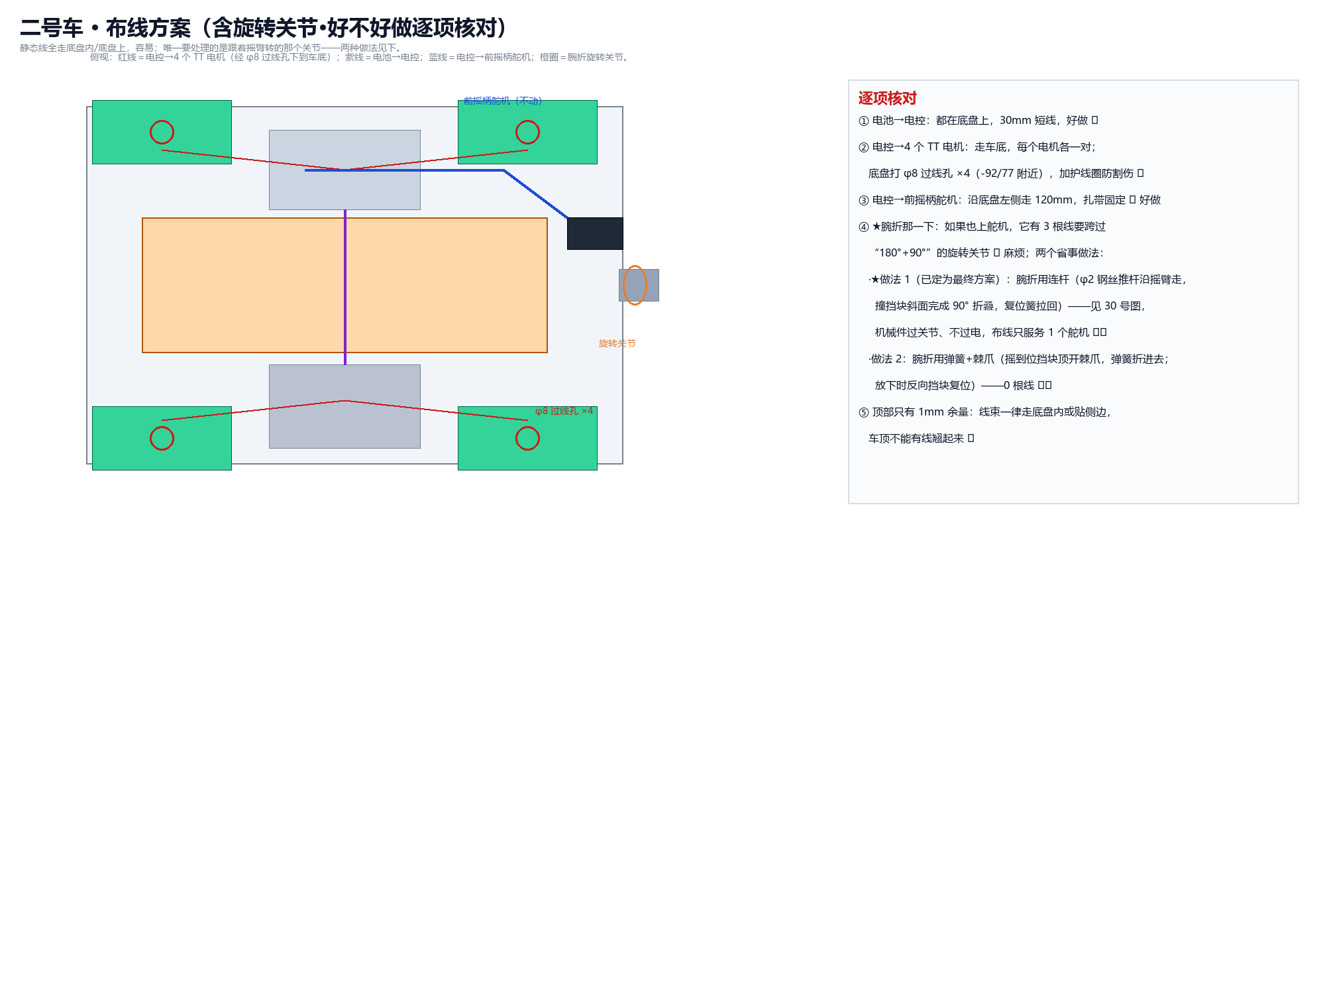
[picture p65: docs/images/日报配图/2026-10-09/蔡昌恒-4-67224ce8.png]
蔡昌恒-4-67224ce8

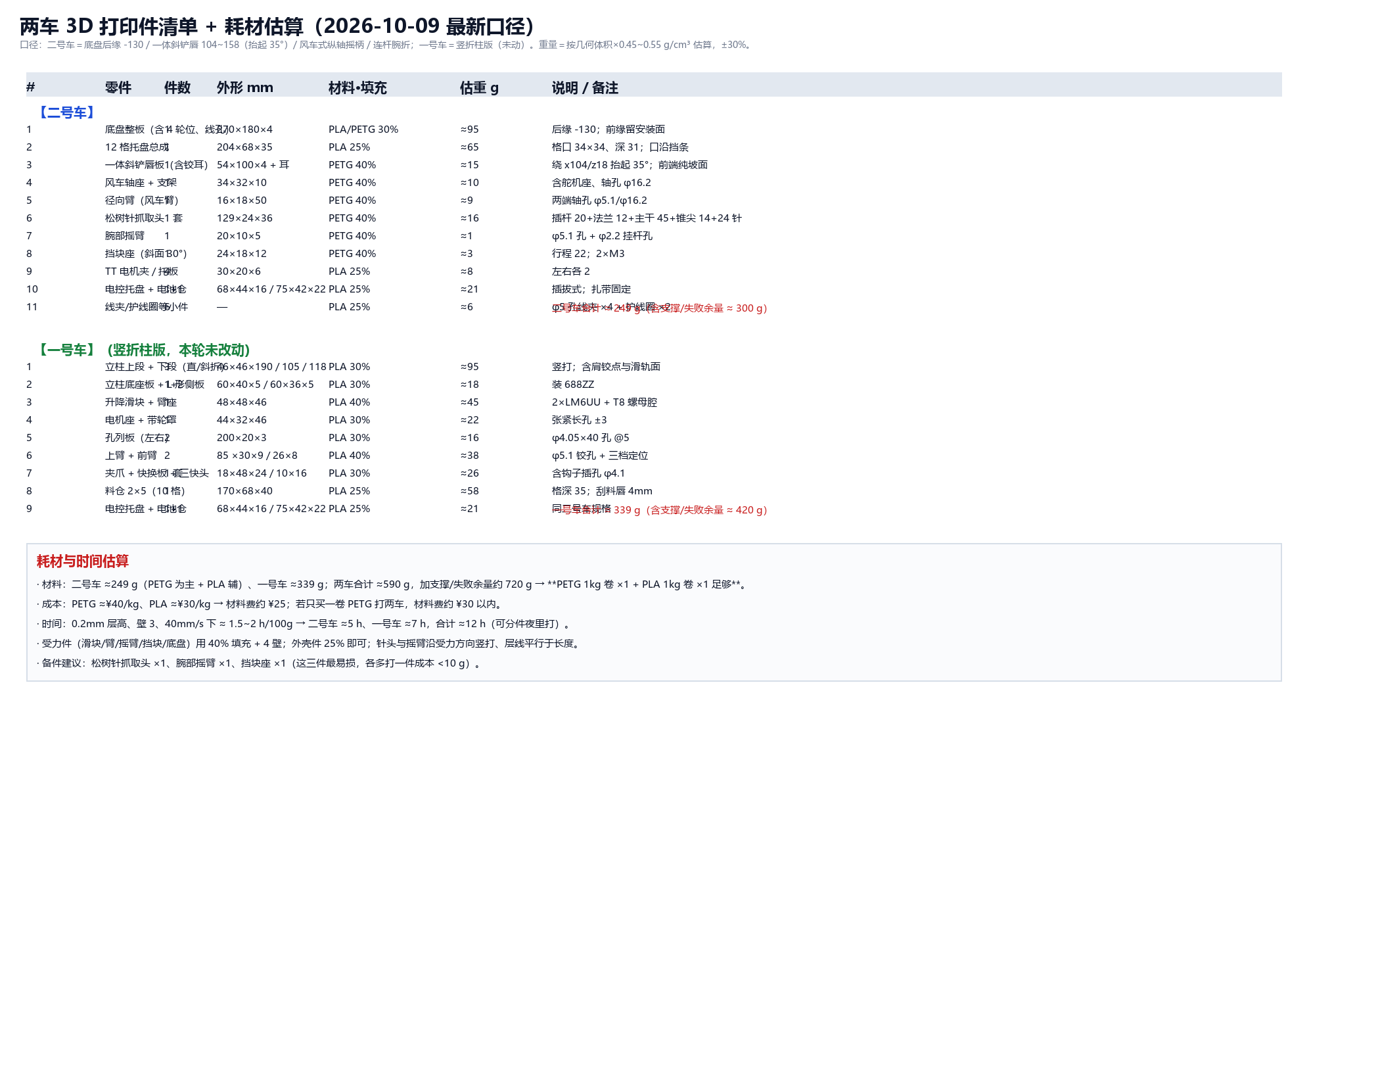
[picture p66: docs/images/日报配图/2026-10-09/蔡昌恒-5-b096f1bd.png]
蔡昌恒-5-b096f1bd

## 通用与总体策略

**2026-09-28 两车定位重划（过桥版 / 隧道版）**

- 记录人：蔡昌恒
- 适用对象：两车通用
- 改动（改前 → 改后）：1 号车 240×160×200（麦轮取块车）→ **200×140×200 过桥版**；2 号车 260×170×180（差速收运车）→ **280×180×120 隧道版**；取块方式由主动式改为**被动件为主的 3+1 套**（被动弹片内撑头 / 单向倒刺 / 低位耙钩 / 铲唇拨轮 + 被动耙钩）
- 为什么改：
  1. 场地复算发现 1 号车车宽 160 mm 过不了 150 mm 桥面（负余量），而 1 号车的主要得分点（中央高台、物资架）都要求过桥 → 车宽必须压到 140 mm；
  2. 同时车身要缩短到 200 mm 才能守住「展开后不超过直径 550 mm 球体」的判据；
  3. 2 号车原本 180 mm 高，钻不过 130 mm 的桥下隧道，等于只能守半个场地 → 压到 120 mm 后可覆盖全场地面与两处台阶区域；
  4. 两处台阶下的洞穴黄块（+8 分）只有矮身车够得着 → 加一根被动耙钩即可，不占舵机、只增重约 10 克。
- 影响与后续动作：
  - 两条不能破的红线：**1 号车车宽 140 mm、前伸 ≤166 mm**；**2 号车总高 ≤120 mm、顶部零凸出**
  - 舵机由 4 个减到 3 个（1 号车），驱动模块需要补购 2 块 DRV8833（共 6 块）
  - 预算相应上升到约 ¥480–560（报销上限 ¥400，超出自付）
  - 据此已重新出图：1 号车最终版设计图、2 号车升级版大图、两车零件与加工清单
**2026-09-28 总体策略（立项）**

- 记录人：蔡昌恒
- 适用对象：两车通用
- 改动（改前 → 改后）：从"一台车什么都能干" → "两车分工：1 号车抢价值、2 号车刷数量"
- 为什么改：5 分钟一局里，一台车不可能既跑完南半场又扫完北半场；分工能让两台车各自把成功率做到最高
- 影响与后续动作：确定两车共用同一套电源规范与取块原理（内钩式）；后续任何影响两车协同的改动都记在这里

<!-- 追加位置 -->
**2026-10-05 手册升级到 V1.5（规则变更与影响）**

- 记录人：蔡昌恒
- 适用对象：两车通用
- 改动（改前 → 改后）：依据《2026 CRTC 参赛手册》V1.4 → V1.5 的六处修订：① 新增统一培训安排（10/8–10/11 晚 19:00–20:40，8-9 日虎溪 D 区、10-11 日沙坪坝 A 区）；② 遥控器条款改述（官方 PS2 手柄收录于《官方物资表》；通讯方式四种（蓝牙/2.4G/WiFi/红外）四选一、发射/接收仅一组）；③ 新增"开源项目须在中期考核阶段完整说明"（文档末尾必须写）；④ 方块尺寸表述修正 40×40×40 → **30×30×30**；⑤ 晋级名额 新生组 56 → **60**；⑥ 焦点参数 十字基座 150×150 → **300×300**、矮墙"间距 31.5、**距中心 64.25**"
- 为什么关注：其中三条直接触及我们的设计与文档——方块尺寸、焦点参数、开源说明要求
- 影响与后续动作：
  - 方块 30：与我们全部设计一致（铲唇、低仓、取块头、洞口 70×70、矮墙槽 31.5），**无需改图**；各文档中如有"40 方块"字样一并改正
  - 焦点参数：1 号车中央高地四个矮墙槽位按"距平台中心 64.25"复核举升/前伸对位（高度 325 / 385 不变），把 64.25 补进《取块头对位误差表》
  - 开源说明：新增 `docs\08-开源项目说明.md`，电控组补齐各开源库的版本与许可证
  - 通讯合规：与组委会确认官方无线继电器是否计入"唯一一种通讯方式"（列进答疑清单）
  - 排期：10/8–10/11 四晚为统一培训，打印/装配排期相应顺延
- 详见 `docs\07-规则手册变更记录.md`

**当天照片：**

蔡昌恒-1-f63f3c6b
蔡昌恒-2-06a4d9b5
蔡昌恒-3-53c8fd49
## 队员问卷意见汇总（2026-09-29）

> 2026-09-28 向全队发放《想法征集问卷（分车版）》共 11 题，**已收回 4 份**：
> **李秉航（电控）**、**史沐生（机械，9/29）**、**杨佳琳（硬件，兼财务，10/1、手写卷）**、**喻静琳（机械，10/3、电子卷）**。
> 以下按题目汇总，并标出需要技术组回应的点。
> 原卷备份见 [`问卷原件/`](问卷原件/)（含空白模板，方便对照题目）。

### 一、逐题意见对照

| 题目 | 李秉航（电控） | 史沐生（机械） | 现行设计 |
|---|---|---|---|
| 1. 1 号车去哪、拿什么 | 认同：专攻中央高台黄块 + 白块，加 e3/d6 物资架黄块 | 觉得够了 | 一致 ✓ |
| 2. 怎么把方块弄到手 | "还在考虑中" | 地面/高台可用弹片，但**挂在杆上的应该用"夹住取下"** | 现行：三合一被动件（弹片内撑 + 单向倒刺 + 低位耙钩） |
| 3. 方块放哪、怎么防掉 | 用弹片方案时放背部没问题；若换其他取块方式，可考虑 **A 车只取下、B 车承接** | 放背部，**不需要分层或加门** | 现行：背部 8 格（2×4）+ 盖板 |
| 4. 最担心什么 | 同样担心那三件事（过桥 / 举升前伸翻车 / 弹片夹稳） | 过桥慢一点求稳；翻不翻、夹不夹得稳"做出来再看" | — |
| 5. 2 号车路线顺序 | 建议**就近原则**：h1 → d1 → a8（比现行 h1→a8→…→d1 更稳） | 暂定可以 | 现行：h1 → 穿隧道 → a8 → e8 → d1 |
| 6. 地上方块怎么收 | 建议**收纳仓 + 斜坡导向口 + 可动闸门**（方块顺坡滑入封闭仓，关门即视为携带） | 建议**借围墙把方块挤进去**；洞穴里的先耙出来再收 | 现行：100 mm 铲唇 + 拨轮 + 单向门；洞穴用被动耙钩 |
| 7. 装几颗 | 倾向多装，并加收纳仓放地面方块 | **单层就行，12 个**（不必贪多） | 现行：8 格托盘（可扩 12） |
| 8. 2 号车最担心什么 | 车高超隧道 | **"自动的会不会有点不妥当？"**（对全自动方案存疑） | 现行：全自动航点运行 |
| 9. 两车分工 | 合理 | 可以，暂时想不出更好办法 | 一致 ✓ |
| 10. 只能保一台保哪台 | **A 车（1 号车）** | **1 号车** | 一致 ✓ |
| 心中 1 号车的样子 | 减少承载、换机动性与轻便；机械杆"穿进杆中再弯折" | **至少要有两种取块方式**（防止被对手干扰或单一方案失效） | — |
| 心中 2 号车的样子 | 前部收纳仓、顶部托盘较大 | 高机动、能边收边干扰；**重量不能太轻**（防被挤压推走） | — |
| 最酷的点子 | — | 车顶做大敞开式收纳盒；用**左右对称两根可弯折机械杆**像手臂一样把方块拨进去 | — |

### 二、需要技术组回应的 6 个点

1. **物资架黄块到底怎么取**：史沐生认为"套在杆上的应该夹住取下"，而现行方案是"单向倒刺沿轴向抽出"。→ 建议两种末端都保留，但**优先验证倒刺方案**，失败再上夹爪（正好呼应"要有两种取块方式"）。
2. **1 号车料仓是否简化**：史沐生认为不需要分层/加门 → 若去掉盖板舵机，可省 1 个舵机与重量，但"取完合盖防掉"的保险没了。→ 建议：先按"8 格 + 轻量挡片"做，跑通后看丢块率再决定要不要加盖。
3. **2 号车收块方式可能更简单**：两人都提出**被动式入仓**（斜坡收纳仓 / 借围墙挤压），比"铲唇 + 拨轮"少一个运动件。→ 建议做一组纸板/打印件对比试验（第 6 题的最小成本验证）。
4. **2 号车路线顺序**：李秉航建议就近原则（h1 → d1 → a8）。→ 需要按"耗时 + 成功率"重算，尤其要确认 e1/d8 台阶的通过性。
5. **全自动 vs 遥控**：史沐生对全自动存疑。→ 需要明确：**一旦加人工接管，2 号车就不再是全自动，白块得分倍率会从 ×2 掉到 ×1.5**（这是取舍的关键，必须让全队知道）。
6. **2 号车重量**：史沐生提出"不能太轻，防止被推走" → 与"高度压在 120 mm"不冲突，可在底盘低处集中配重。

### 三、存疑项统计（第 11 题）

| 编号 | 存疑内容 | 被圈次数 | 圈选人 |
|---|---|---|---|
| ① | 被动弹片内撑取块头能不能夹稳 | **3** | 李秉航、杨佳琳、喻静琳 |
| ③ | 140 mm 车宽过 150 mm 桥 | **3** | 李秉航、杨佳琳、喻静琳 |
| ⑤ | 8 格 2×4 料仓（落块会不会卡、装满会不会掉） | 1 | 喻静琳 |
| ⑨ | 12 格托盘装满会不会掉块 | 1 | 李秉航 |
| ⑬ | 国庆期间能不能做完（时间与排期） | 1 | 李秉航 |
| ⑩ | 全自动跑点会不会跑偏/撞车 | 1（隐含） | 史沐生（第 8 题提出疑虑） |
| ⑭ | 其他（自己写的内容） | 1 | 喻静琳（未写明具体内容） |
| ②④⑥⑦⑧⑪⑫ | 其余各项 | 0 | — |

> 说明：杨佳琳只圈了 **①③** 两项，但第 4 题还额外提出对"半坡取块 / 过桥后取块"的担心，第 8 题提出对"自动车能否返程"的担心——这两条虽没写进编号，实际也属于需要验证的点。
>
> 喻静琳圈了 **①③⑤⑭**（⑭"其他"未写明具体内容）。她另外提出：按规则**桥面是拱形**，过桥难度要做实测（建议先 3D 打印一个桥模型）；**挂杆方块的内径剩余空隙很小**，弹片很可能插不进去；并指出设计图里"翻转耙钩"是画在 1 号车上的，她认为**装在 2 号车更合理**——需要核对图纸标注与文字方案是否一致。

**建议优先验证（影响面最大、且被点名）：**

1. **③ 140 mm 过桥**：决定 1 号车能否拿到"中央高台 + 物资架"这 12 分，优先级最高 → 用纸板/打印件做宽度 140 mm 的模拟车，在自建 150 mm 桥面上推过去验证偏航（喻静琳提醒：**按规则桥面是拱形**，最好照拱形做）。
2. **① 被动弹片内撑头**：决定 1 号车的取块可靠性 → 打印一套弹片头，用真实方块做 20 次插取试验；同时量一下**挂杆方块内径的剩余空隙**够不够弹片插入（喻静琳、史沐生都提到这一点）。
3. **⑥/⑩ 2 号车入仓方式与自动跑点**：决定 2 号车 20 分能否实现 → 做斜坡收纳仓 vs 铲唇拨轮的对比件。
4. **⑬ 时间排期**：国庆 10/6–10/12 培训 + 打印/装配是否排得下（结合 `05-物资与成本预算.md` 的加工顺序）。

### 补充：杨佳琳（硬件）问卷要点（手写卷，2026-10-01 收到）

| 题目 | 意见 |
|---|---|
| 1. 1 号车去哪、拿什么 | 建议加上 **d1、e8**（两处台阶/洞穴区域） |
| 2. 怎么把方块弄到手 | 认可被动弹片方案"结构简单、省舵机"，但认为 **15 mm 方孔精确插入困难**；建议改用 **90° 旋转的钩子**；物资架上的黄块可以"沿杆撸下来" |
| 3. 方块放哪、怎么防掉 | （未填） |
| 4. 最担心什么 | 担心"**半坡取块 / 完全过桥后再取块**"这两种动作；担心弹片头能否**准确插进方块内部**；建议考虑 U 型夹/钩 + 让方块滑进盒子的思路；并强调**重心靠后不易翻车** |
| 5. 2 号车路线顺序 | （未填） |
| 6. 地上方块怎么收 | （未填） |
| 7. 装几颗 | （未填） |
| 8. 2 号车最担心什么 | "**全自动的话，跑到 a1/e8 之后还能退回来吗？**"（担心自动车的返程与迷路） |
| 9. 两车分工 | 分工基本认可，但质疑"**慢车收集的数量比 2 号车多，数量和分值是否匹配**" |
| 10. 只能保一台保哪台 | **1 号车**：认为 1 号车能拿的数量更多（提到 14 个白块 + 3 个黄块） |
| 11. 存疑编号 | **① ③**（被动弹片内撑头 / 140 mm 过桥） |
| 附图 | 手绘 1 号车侧视草图（举升 + 前伸动作，标注了尺寸） |

### 补充：喻静琳（机械）问卷要点（电子卷，2026-10-03 收到）

| 题目 | 意见 |
|---|---|
| 1. 1 号车去哪、拿什么 | 从 **h5/a4 启动区直接上桥**；中央高台 5 颗拿完后下桥取 **d1、e8 台阶卡槽方块**，或帮 2 号车拿 e3/d6 台阶方块；认为**物资架上的方块大概取不下来** |
| 2. 怎么把方块弄到手 | （未填）——第 4 题补充：**挂杆方块内径剩余空隙很小，弹片不一定插得进** |
| 3. 方块放哪、怎么防掉 | （未填）——"心中的 1 号车"里建议料仓改成 **1×5 或 2×5** |
| 4. 最担心什么 | **桥是拱形，过桥有难度**（建议先 3D 打印一个模型试）；**挂杆方块内径空隙小，弹片很可能取不下来** |
| 5. 2 号车路线顺序 | （假设红方）a1 启动 → 穿 bc4 隧道 → a8 角落 → e8 洞穴 → 上台阶拿 e8 → 穿另一条隧道 → h1 → d1 |
| 6. 地上方块怎么收 | 指出**设计图上"翻转耙钩"画在 1 号车**，她认为**装在 2 号车更合理** → 要核对图纸标注 |
| 7. 装几颗 | （未填） |
| 8. 2 号车最担心什么 | （未填） |
| 9. 两车分工 | 合理 |
| 10. 只能保一台保哪台 | **1 号车**——"1 号可以完成 2 号的方块抓取任务" |
| 心中的 1 号车 | 只需过桥后取 5 颗方块，料仓改 **1×5 或 2×5** |
| 心中的 2 号车 / 最酷的点子 | （未填） |
| 11. 存疑编号 | **① ③ ⑤ ⑭**（⑭ 未写明具体内容） |
