AFlyingPiglet/shangjianyinqing/docs/07-规则手册变更记录.md

# 规则手册变更记录（V1.4 → V1.5）

> 依据：《2026 CRTC 参赛手册》V1.5（2026-10-05 收到）。本页只记录**与我们设计、备赛相关**的变更及影响；手册原文由队长存档。
> 上一版：V1.4（2026-09-28 收到）。两版共 23 页，官方修订记录列在 V1.5 末尾。

## 一、V1.5 的六项变更（官方修订记录逐条对照）

| # | 位置 | 变更内容 | 对我们的影响 |
|---|---|---|---|
| 1 | 2.3.4 | 新增统一培训安排：**10/8、9、10、11 晚 19:00–20:40（第 10-11 节）**；8、9 日在虎溪校区（D 区），10、11 日在沙坪坝校区（A 区） | 排期需避开这四晚（培训占时） |
| 2 | 3.2 | 遥控器表述改为"《CRTC 官方物资表》中列出的 PS2 手柄"；通讯方式共 **4 种（蓝牙 / 2.4G / WiFi / 红外）**，**仅可选一种**，发射源与接收源有且仅有一组 | 我们用官方 PS2 + 2.4G 接收器，符合；**待确认**：官方无线继电器（急停）是否计入"一种通讯方式"（属官方安全件，经验上不算，建议群里问一句） |
| 3 | 第三章 + 4.3.1 | **允许使用开源项目**，但必须在**中期考核阶段给出完整说明**、遵守开源协议；文档规范新增"文档末尾需完整说明" | 已新建 `08-开源项目说明.md`；电控组补齐版本/许可证后即可 |
| 4 | 4.1.2 | 方块尺寸描述修正：**40×40×40 → 30×30×30 mm** | 我们全部设计（铲唇、低仓、取块头、洞口 70×70、矮墙槽 31.5）本来就按 **30 方块**做 ✓ **无需改动**；V1.4 的"40"是笔误 |
| 5 | 4.6 | 晋级名额：新生组 **56 → 60**，非新生组 8 → 4 | 利好，按 60 准备 |
| 6 | 6.1.7 | 焦点（中央高地平台）参数：十字基座范围 **150×150 → 300×300**；矮墙"间距 31.5、**距中心 64.25**" | 影响 1 号车中央高地作业：槽位在"距平台中心 64.25mm"，基座 300×300；需复核对位行程与走位顺序（见下） |

## 二、需要复核 / 行动的点

- [ ] **1 号车中央高地**：四个矮墙槽位按"距平台中心 **64.25mm**、基座 300×300"复核取块头的举升/前伸对位；我们记录的高度（台面 +25 / 焦点 +85，即 325 / 385）不变；把 64.25 补进《取块头对位误差表》，并按新尺寸核对上台后的走位顺序。
- [ ] **通讯合规**：向组委会确认官方无线继电器是否算第二种通讯方式（写进答疑清单）。
- [ ] **开源说明**：电控组把实际用到的开源库（STM32 核心/HAL、FreeRTOS、PS2 手柄库等）的**版本与许可证**补进 `08-开源项目说明.md`（中期考核前必须完整）。
- [ ] **排期**：10/8–10/11 四个晚上为统一培训，打印/装配排期相应顺延。
- [ ] **方块 30**：与设计一致（无需改图）；同步检查 `01`、`02` 等文档中如有"40 方块"字样一并改正。

## 三、变更依据（原文摘录）

- **培训安排**："统一培训将于 2026 年 10 月 8 日、9 日、10 日、11 日 19：00~20：40（第 10-11 节）开展。其中 8 日、9 日培训地点位于重庆大学虎溪校区（D 区），10 日、11 日培训地点位于重庆大学沙坪坝校区（A 区）。"
- **开源项目**："将开源项目用于机器人的制作及代码编写是允许的，但必须在中期考核阶段给出完整说明，并遵守所使用开源项目的开源协议（如因开源协议产生纠纷请参赛队伍自行处理）。"；4.3.1："如果有使用开源项目用于机器人制作及代码编写的，应当在文档末尾完整说明。"
- **焦点**："中央高地上的平台，高 70mm；由 300mm*300mm 范围内的 10mm 高十字形基座（同时每个基座方向带有两片对心的 10mm*60mm*10mm 的矮墙，间距 31.5mm，距离中心 64.25mm），60mm*60mm 宽、40mm 高的正方形柱体与 80mm*80mm 宽、20mm 高的平台组成，上方放置一个黄色立方体。"

（其余未列出的条款与 V1.4 一致：球体包络 550、场地 300 高台 / 150 台阶、桥 300×150、净高 130、物资架 φ14/250 等。）
