AFlyingPiglet/shangjianyinqing/docs/08-开源项目说明.md

# 开源项目使用说明

> 依据《2026 CRTC 参赛手册》V1.5：将开源项目用于机器人的制作及代码编写是允许的，但**必须在中期考核阶段给出完整说明**，并遵守所使用开源项目的开源协议；文档规范（4.3.1）要求在**文档末尾完整说明**。
> 填写分工：**电控组（李秉航）**确认版本与许可证；队长汇总。中期考核前必须填完。

## 一、机器人上使用的开源项目

| 项目 | 用途（装在哪） | 版本 | 许可证 | 是否修改 | 备注 |
|---|---|---|---|---|---|
| STM32 核心 / 硬件抽象库（如 STM32duino、STM32Cube HAL） | 主控程序基础库 | 待填 | 待填 | 待填 | 预计使用，以实际为准 |
| PS2 手柄读取库（如 PS2X） | PS2 接收器 → 读键值 | 待填 | 待填 | 待填 | 预计使用 |
| FreeRTOS（如采用） | 电控任务调度 | 待填 | 待填 | 待填 | 培训课程涉及 |
| 其他第三方库 | —— | 待填 | 待填 | 待填 | 用到即补 |

> 说明：以上为预计清单，**以电控组实际引入的库为准**；若对源码有任何修改（哪怕改一个宏），在本表备注里写清"修改了什么"。

## 二、备赛工具链中使用的开源软件（不装在机器人上，一并说明）

| 项目 | 用途 | 许可证 |
|---|---|---|
| Git | 版本管理与仓库提交 | GPL-2.0 |
| MarkText | Markdown 文档编辑 | MIT |
| Python（文档/图像处理脚本） | 文档排版、图纸生成 | PSF License |

## 三、合规声明

- 上述开源项目的许可证条款均予以遵守；如对源码有修改，将在本页注明修改内容与范围，并遵守对应许可证（如保留版权声明、开源衍生代码等）。
- 备赛过程中如引入新的开源项目（含代码库、模型、数据集），同步更新本页；**中期考核提交前完成**。
- 本页即文档要求中的"开源项目完整说明"，放在文档末尾。
