AFlyingPiglet/shangjianyinqing/docs/09-独立复核对账与修正.md

# 独立复核对账与修正（2026-10-05）

> 说明：本轮请了另一个独立会话（更强模型）对整个双车方案做了一次"冷复核"（完整报告由队长本地存档）。
> 本页逐条对账：**采纳并改** / **部分采纳（含对复核算据的修正）** / **误会不采纳**，并列出需要队里拍板的决定。

## 一、三处高优先级硬伤 —— 全部采纳

### 1. 2 号车初始长向尺寸会超 290（检录硬线）

- 手册原文（3.3 设计技术规范）："机器人的初始长宽尺寸不得超过 290mm×195mm，高度不得超过 210mm"；"注：初始尺寸指**每次对局正式开始时**机器人的尺寸。"
- 我们的真实账：**车体 280 + 铲唇前突** → 固定唇 ≈380 ✗；按"被动回缩"设计，**弹簧静止时把唇板推出来**，初始态仍是 ≈380 ✗ → 检录直接不过。
- **修正（定稿）**：铲唇改为 **SG90 主动推拉**：
  - 初始态：唇板全收，前突 0–5 → 总长 **280–285 ✓**；
  - 地面收块：一键伸出（与之前一致）；
  - 洞穴/矮墙作业前：收回（贴墙作业）。
  - 副作用：2 号车 +1 个 SG90（≈ +10 g）；断电时由弹簧把唇板拉回"收起"位保底。
- 备选：车体缩到 **270**（低仓 2×6 仍放得下，富余 44mm）——排期紧张就用这个。
- 对复核算据的修正：复核按"托盘 204 + 前后轮 60+60"推出"车长 ≥324"，**重复计了一次**（轮子在 280 车体内、托盘放在前后轴之间），车身 280 本身没问题；真正超限的是**铲唇前突**。

### 2. 1 号车 e3 物资架黄块"伸不进 0.5mm 缝"

- 复核正确：方块 30、内腔 15，挂杆 φ14 → 中缝 0.5mm，弹片/倒刺都进不去。
- **修正**：e3/d6 末端改为 **"外缘拉钩"**（从方块侧面钩外缘、沿杆轴拉出，纯被动），备选 **SG90 小夹爪夹外表面**。
- 验证：打印 30 方块 + φ14×150 杆 + 拉钩，20 次 ≥18/20 通过。
- 文档同步：把"单向倒刺沿轴抽出"的表述改为"外缘拉钩（首选）/ 夹外表面（备用）"。

### 3. "半自动 ≈32.5"不能当计划值

- 复核正确：PS2 手动 + 一键宏，按手册字面属"一般机器人"（白 ×1、黄 ×4）。
- **修正**：对外文档统一写 **27 分为计划值**、"32.5 为待答疑的潜在上限"；运行模式三选一只写一种，不混写。

## 二、部分采纳（复核方向对，算据/建议按我们情况修）

| 复核点 | 对账结论 | 处理 |
|---|---|---|
| 前伸 160 对 e3 只剩 5–10mm 余量 | 采纳 | 前伸改 **180**（盒子判据 380×140×350 仍过） |
| 洞穴"伸入 40–60"，60 > 洞深 50 | 采纳 | 统一改 **30–45**（实际按 45 执行） |
| 路线写"d8 坡上 d1" | 采纳 | d8 通 **e8**、d1 走 **e1**；分镜与路线图统一改；北上 e8 时顺路 +3（e8 台面 + e8′ 矮墙） |
| 基础功能第 5 项要"同一台车 ≥3 舵机" | 采纳 | 1 号车固定 **3 路舵机**：转塔 SG90 + 料仓挡片 SG90 + 末端备用（夹/钩）SG90；举升仍走丝杆自锁（满足"任意位置保持"） |
| 1 号车"六种取块"分镜与定稿分工矛盾 | 采纳 | 分镜图标注为"早期覆盖方案"，正文以定稿 3 种姿态为准 |
| 通讯"五种" | 采纳 | 改为 **4 种（蓝牙/2.4G/WiFi/红外）四选一**（07、04 已更正） |
| 1 号车托盘 170×68 前沿距车头 40 → 后缘出界 | 采纳 | 托盘改 **160×68**（或前沿改 30），下次出图更新 |
| "球体余量 6mm"表述误导 | 采纳 | 统一写"按盒子判据（≤445×400×450）；球体不适用" |
| 成本台账 / 检录落体 / 安全钩处理 | 采纳 | 见本页第三节待办 |
| "仓库还没建" | **误会，不采纳** | 复核看的是同步源文件夹（`CRTC2026-新增`，本来就不放 .git）；真正仓库 `CRTC2026` 已建并多次推送（github.com/AFlyingPiglet/shangjianyinqing） |

## 三、复核补充的提醒（照单收下）

1. **10/5 24:00 前**：实训分组志愿表截止（手册 2.3.3）——今天必须填。
2. **采购下单**：丝杆 / 导轨 / 轴承 / 拉簧 / 耗材都有快递周期，**今天拍单**。
3. **开源说明（08）**：版本 / 许可证 / 是否修改是中期考核硬要求，电控组本周填完。
4. **答疑清单（7 条）**：① 无线继电器是否算第二种通讯；② 半自动判定与倍率；③ 球体/盒子"二选一"怎么判；④ 前突件（铲唇/舌铲/耙钩）在初始尺寸里怎么量；⑤ 4.1.2"距中心 40" 与 6.1.7"64.25"以哪个为准；⑥ 附属高台矮墙槽开口端与洞穴开口朝向（要官方地图/实拍）；⑦ 旧件借用登记。
5. **预检录包**（预检录 ≤2 次，正式赛前一周开放）：落体试验件、150 宽拱桥模型、1:0.5 坡、70×70×50 洞模型、断电遥控器。
6. **安全合规**：倒刺/耙钩/薄板前缘全部钝化或加护罩，备一套"无钩"替换件；丝杆滑轨用干性润滑。
7. **备用件包**：驱动、舵机、限位、唇板、弹片各 1 套。

## 四、需要队里拍板的 5 个决定

1. 铲唇让位方式：**主动推拉（推荐）** 还是 车体缩到 270？
2. 前伸 160 → **180**（确认）？
3. 1 号车第三路舵机装在哪（料仓挡片 / 备用末端）？
4. 2 号车路线：北上 e8（顺路 +3）还是只跑 d1（走 e1 坡）？
5. e3 末端：外缘拉钩（被动，推荐）还是小夹爪（SG90）？

## 附录：中期考核提交包（据手册）

- 截止 **2026-10-19 24:00**，提交仓库链接（GitHub/Gitee）。
- 邮件主题："队伍名称+队长姓名"；正文列指标 + 仓库链接。
- 演示视频：mp4，≥1080p / 30fps；打包 zip 命名"实训战队名称+队伍名称+队长姓名"。
- V1.5 明确：允许中期测评队伍不产出实物演示（完成度按相对赋分），所以**文档与素材必须齐**。
- 规则测评：80 题、只有 1 次机会、占中期 30%——单独安排一次全真模拟。
