AFlyingPiglet/shangjianyinqing/docs/01-1号车-机械结构.md

# 1 号车 · 机械结构

> 1 号车定位：麦轮取块车，红方 h5 / 蓝方 a4 高台启动，人工 PS2 操作，目标是抢高分道具（黄块 + 矮墙槽白块）。

## 整车外形与尺寸

### 目标

初始长宽高 ≤ 290 × 195 × 210 mm；展开后仍在 445 × 400 × 450 mm 或直径 550 mm 球体判据内；重量 ≤ 2.0 kg。

### 方案对比（为什么这样选）

| 方案 | 优点 | 缺点 | 结论 |
|---|---|---|---|
| 车身做宽（170–200 mm） | 内部好布置、结构简单 | 过不了 150 mm 宽的桥面 | 放弃 |
| 车身压到 ≤150 mm | 能走桥、路线选择多 | 麦轮与料仓会干涉，需要重新排布 | 待定（见下） |

### 开发历程（从早到晚）

**2026-09-28 方案基线**：确定整车 240 × 160 × 200 mm（初始），展开高约 380 mm，预计重量约 1.1 kg（含电池）。以 1 号车 160 mm 宽、桥面 150 mm 为已知风险记录在案。

<!-- 之后每次有进展，就在这里按日期往下追加一条，例如：
**2026-10-05 车宽压缩方案**：把电机内移 6 mm、料仓改上翻盖，整车做到 148 mm，实测通过 b4 桥面。
-->

### 验证结果

（待补：整车三视图、用直尺测量的照片、称重照片——这三样对应考核指标 8）

### 下一步

- 出三版车宽方案并对比（压窄 / 改路线 / 折中）
- 决定是否走桥

## 底盘与轮系

### 目标

在 26.6° 坡道（坡比 0.5）上稳定爬升，并具备贴靠对位能力（矮墙槽、洞穴口）。

### 方案对比（为什么这样选）

| 方案 | 优点 | 缺点 | 结论 |
|---|---|---|---|
| 麦克纳姆轮 60 mm（官方套件） | 可横移、斜行，对位窄槽最省事 | 坡上辊子会侧滑、四轮必须同时接地 | **采用** |
| 橡胶胎四轮差速 | 爬坡稳、里程计准 | 不能横移，窄槽对位需要多次微调 | 用于 2 号车 |
| 履带 | 越障最强 | 重量大、比 150 mm 桥面宽、基本告别过桥 | 放弃 |

### 开发历程（从早到晚）

**2026-09-28 选型结论**：1 号车选麦轮（理由：任务需要"贴靠对位"而不是"高速跑点"）；同时记录麦轮在 26.6° 坡上会侧滑的已知问题，计划在培训期间实测。

<!-- 追加位置 -->

### 验证结果

（待补：坡道爬升实测——能否上 a5/a6 与 h3/h4、打滑程度、需要多大助跑）

### 下一步

- 实测坡道通过性；如果打滑严重，考虑加配重或改变爬坡角度

## 结构强度

### 目标

手册要求：从 150–200 mm 高度以底面朝下自由落体不掉件（中期考核用 180 mm，需拍摄测量过程）。

### 方案对比（为什么这样选）

（待补：加固方式对比——例如增加连接件 vs 一体打印 vs 单纯加强胶粘）

### 开发历程（从早到晚）

**2026-09-28 要求记录**：把落体测试列为结构设计验收项，测试时需直尺入镜。

<!-- 追加位置 -->

### 验证结果

（待补：测试视频与结果）

### 下一步

- 首版车体装配完成后做第一次落体测试
