AFlyingPiglet/shangjianyinqing/docs/02-1号车-取块机构.md

# 1 号车 · 取块机构

> 方块统一规格：外轮廓 30 mm、内腔 15 mm、每面中间 15 mm 方孔、棱边 45° 倒角、单颗约 11.29 g。白色（1 分/颗）与黄色（4 分/颗）完全同规格。

## 取块原理：内钩式

### 目标

用同一套原理可靠地拿住方块，并把失败率控制在可接受范围。

### 方案对比（为什么这样选）

| 方案 | 优点 | 缺点 | 结论 |
|---|---|---|---|
| 从外面夹 | 结构直观 | 只能夹到 7.5 mm 的细棱，方块轻、容易崩飞 | 放弃 |
| 吸盘 | 抓取快 | 每个面都是镂空的，吸不住 | 放弃（已实测不可行） |
| **内钩**：钩头从 15 mm 方孔伸进内腔，旋转 90° 或两侧撑开卡住内壁 | 接触面在内腔，最稳；两车可通用 | 需要精确对位 | **采用** |

### 开发历程（从早到晚）

**2026-09-28 原理确定**：对比三种取块方式后确定统一采用内钩式，并据此派生出三种末端执行器（物资架举升抽取、矮墙槽顶部撑爪、洞穴耙钩）。

<!-- 追加位置 -->

### 验证结果

（待补：静态抓取测试——连抓 10 次成功几次）

### 下一步

- 出内钩头图纸并 3D 打印首版

## 举升机构（物资架黄块）

### 目标

把黄块从离地 250 mm 的物资架上取下来（物资架为 φ14 × 150 mm 圆柱，方块是被"套"在杆上的）。

### 方案对比（为什么这样选）

| 方案 | 优点 | 缺点 | 结论 |
|---|---|---|---|
| 直接往上硬拽 | 结构简单 | 方块套在杆上，硬拽会卡死 | 放弃 |
| **举升 + 沿杆轴抽出** | 顺着几何关系，成功率高 | 需要 260 mm 行程与限位 | **采用** |

### 开发历程（从早到晚）

**2026-09-28 机构定型**：MG995 舵机带动齿条/连杆，行程 260 mm，上下各一个限位开关；末端复用内钩头完成"钩住—沿轴抽出—收回料仓"。

<!-- 追加位置 -->

### 验证结果

（待补：举升到位实拍、限位触发记录、抽取成功率）

### 下一步

- 打样并测试举升行程与限位

## 矮墙槽取块：顶部内撑爪

### 目标

取出卡在矮墙槽里的白块（间隙 31.5 mm、墙高 10 mm、台面高 20 mm，两侧余量仅约 0.75 mm）。

### 方案对比（为什么这样选）

| 方案 | 优点 | 缺点 | 结论 |
|---|---|---|---|
| 侧面夹取 | — | 侧面根本进不去（余量 0.75 mm） | 放弃 |
| **从上方插爪进方孔再撑开** | 利用孔位，可靠 | 对横向对位要求最高 | **采用** |

### 开发历程（从早到晚）

**2026-09-28 方案确定**：薄爪厚 8–10 mm、插入深度 ≥25 mm；同时记录"这是麦轮横移能力最有价值的场景"。

<!-- 追加位置 -->

### 验证结果

（待补：对位成功率——试 10 次成功几次）

### 下一步

- 打印薄爪并做对位练习

## 洞穴耙钩

### 目标

取出台阶下 70 × 70 mm 洞穴口的黄块（方块外表面与洞口齐平，两侧约 20 mm 余量）。

### 方案对比（为什么这样选）

| 方案 | 优点 | 缺点 | 结论 |
|---|---|---|---|
| 夹紧式 | — | 洞穴内没有夹取空间 | 放弃 |
| **矮身耙钩直接拖出** | 不需要夹紧动作 | 需要垂直贴靠 | **采用** |

### 开发历程（从早到晚）

**2026-09-28 方案确定**：耙钩离地 20–45 mm、宽 ≤50 mm，深入洞口勾住内腔拖出。

<!-- 追加位置 -->

### 验证结果

（待补：拖出视频、失败情况记录）

### 下一步

- 与举升机构共用车体前端的安装位，验证互不干涉

## 料仓与翻盖

### 目标

把取到的方块安全带回（**只有对局结束时还带在车上的道具才算分**），容量 4 格。

### 方案对比（为什么这样选）

（待补：翻盖 vs 弹性挡片 vs 开放式料仓的对比）

### 开发历程（从早到晚）

**2026-09-28 方案确定**：4 格料仓 + 翻盖，所有取块口做喇叭形导向面让机械自己找正。

<!-- 追加位置 -->

### 验证结果

（待补：带块颠簸测试——过坡道、过桥时是否掉块）

### 下一步

- 首版料仓打印与装配
