AFlyingPiglet/shangjianyinqing/docs/03-1号车-电控与操作.md

# 1 号车 · 电控与操作

## 电源链路

### 目标

满足手册的电源与安全规范：仅 1 个供电模块、额定电压 ≤7.4 V、必须能被官方断电遥控器在 10 m 内切断底盘电源（检录必查）。

### 方案对比（为什么这样选）

| 方案 | 优点 | 缺点 | 结论 |
|---|---|---|---|
| 单节 18650 + 升压 | 轻 | 升压模块效率低、电流余量小 | 放弃 |
| **18650 2S（7.4 V）+ 降压** | 电压刚好在上限内，驱动与舵机都好配 | 需要两个电池盒与平衡充电 | **采用** |

### 开发历程（从早到晚）

**2026-09-28 链路确定**：18650 2S → 官方无线继电器 → 分电板 → DRV8833 ×2（麦轮电机）/ 5 V 降压（舵机与主控）。

<!-- 追加位置 -->

### 验证结果

（待补：接线图、走线照片、断电测试视频）

### 下一步

- 焊接分电板，完成首次上电自检

## 主控与外设

### 目标

用 PS2 手柄完成底盘与机构控制，同时保留自动化的可能性。

### 方案对比（为什么这样选）

| 方案 | 优点 | 缺点 | 结论 |
|---|---|---|---|
| STM32F103C8T6 + PS2 官方手柄 | 官方指定手柄、资料多、PWM 资源够 | 需要自己写运动学 | **采用** |
| 其他遥控方案（蓝牙/WiFi） | 自由度高 | 手册要求通讯方式只能选一种，且需自己承担失控风险 | 放弃 |

### 开发历程（从早到晚）

**2026-09-28 选型确定**：主控 STM32F103C8T6；驱动 DRV8833 ×2；舵机 MG995 ×2（举升/钩头）、SG90 ×2（翻盖等）；全队只用 2.4G 一种通讯方式。

<!-- 追加位置 -->

### 验证结果

（待补：引脚分配表、CubeMX 配置截图、单电机/四电机转动的视频——对应指标 2、3）

### 下一步

- 最小系统点亮 → 单电机转动 → 四电机同时转动

## 麦轮运动学

### 目标

实现直行、横移、斜行、原地自转四种动作，并让"直行真的直"。

### 方案对比（为什么这样选）

（待补：例如四轮全 PWM 混控 vs 只用两轮差速模拟等方案的对比）

### 开发历程（从早到晚）

**2026-09-28 任务分解**：四轮转速组合决定车体运动，先标定四个轮子的实际转速差异，再写混控表。

<!-- 追加位置 -->

### 验证结果

（待补：走 2 m 的横向偏移量；四种动作的实测视频）

### 下一步

- 写混控函数 + 标定程序

## 操作练习记录

### 目标

把"贴靠矮墙槽""洞穴口对位""物资架举升抽取""过桥直行"四个动作练到稳定。

### 开发历程（从早到晚）

**2026-09-28 计划**：每次练习记录日期、动作、成功次数，作为文档评估里"迭代优化过程"的素材。

<!-- 追加位置：每次练习后按日期追加 -->

### 验证结果

（待补：各动作的成功率统计）

### 下一步

- 培训期间安排第一次对位练习
