AFlyingPiglet/shangjianyinqing/docs/04-2号车-底盘与拾取.md

# 2 号车 · 底盘与拾取

> 2 号车定位：四轮差速收运车，红方 a1 / 蓝方 h8 地面启动，全自动无操作手，负责"刷数量"。
> 白块在全自动模式下每颗按 2 分计，稳定收 3 颗 = 6 分；若能钻过 130 mm 桥下空间，目标可升到 5 颗 = 10 分。

## 底盘与轮系

### 目标

沿固定航点稳定走位，直线不跑偏，能爬 26.6° 坡道，且不需要横移能力。

### 方案对比（为什么这样选）

| 方案 | 优点 | 缺点 | 结论 |
|---|---|---|---|
| **橡胶胎四轮差速** | 抓地力最强、里程计算得最准、爬坡稳 | 不能横移（但固定航点不需要） | **采用** |
| 麦轮 | 能横移、斜行 | 坡上打滑、成本更高、自动模式用不上横移 | 放弃（留给 1 号车） |
| 履带 | 越障最强 | 重、耗电、比 150 mm 桥面宽 | 放弃 |

### 开发历程（从早到晚）

**2026-09-28 选型确定**：2 号车用橡胶胎四轮差速，整车 260 × 170 × 180 mm，约 0.9 kg，4 × TT 马达，轴距 146 mm，PWM 限速约 65%。

<!-- 追加位置：之后每次有进展在这里按日期追加 -->

### 验证结果

（待补：直线偏差、原地转 90° 误差、e1 坡道爬坡测试）

### 下一步

- 装配首版底盘并跑直线标定

## 拾取机构：铲唇 + 拨轮 + 单向门

### 目标

对地面散块实现"开过去就能收"，对位要求低，适合全自动运行。

### 方案对比（为什么这样选）

| 方案 | 优点 | 缺点 | 结论 |
|---|---|---|---|
| 机械爪逐个抓 | 通用 | 对位要求高、耗时长，不适合自动跑点 | 放弃 |
| **铲唇 + 拨轮 + 单向门** | 吞吐量最高、对位要求低、方块不易掉 | 需要控制铲唇离地间隙 | **采用** |

### 开发历程（从早到晚）

**2026-09-28 方案确定**：车头斜面铲唇（离地 3–5 mm）把方块铲离地面，上方旋转拨轮把方块拨进料仓；仓口装弹性单向门，撞到也不掉出来；通道宽 40–60 mm。

<!-- 追加位置 -->

### 验证结果

（待补：铲唇角度试验 3° vs 5°、连续收 5 颗的成功率、拨轮转速与丢块率）

### 下一步

- 打印铲唇与拨轮做首发试验

## 料仓

### 目标

容量 10 格，底部带斜度让方块自动滑到最里面，行进与颠簸时不掉块。

### 方案对比（为什么这样选）

（待补：料仓内部结构对比——斜底 vs 平底 vs 加挡板）

### 开发历程（从早到晚）

**2026-09-28 方案确定**：10 格料仓、单向门、底部斜度。

<!-- 追加位置 -->

### 验证结果

（待补：装满后过坡道、过桥的掉块测试）

### 下一步

- 料仓结构细化并打印

## 关键取舍：整车高度

### 目标

决定要不要把整车压到 130 mm 以内——这是本车唯一值得额外投入的升级方向。

### 方案对比（为什么这样选）

| 方案 | 优点 | 缺点 | 结论 |
|---|---|---|---|
| 保持 180 mm 高 | 内部布置宽松、结构简单 | 钻不过 130 mm 的桥下空间，白块目标只有 3 颗（6 分） | 待定 |
| **压到 ≤130 mm** | 可穿过桥下，目标 5 颗（10 分，+4 分） | 电池与主控布置紧张、结构强度风险 | 待定 |

### 开发历程（从早到晚）

**2026-09-28 提出**：按全自动白块 ×2 计算，压矮车身带来的 4 分收益是这台车最值得的改进方向，待结构与电控评估后决定。

<!-- 追加位置 -->

### 验证结果

（待补：低矮版样机的通过性实测）

### 下一步

- 喻静琳出低矮版结构评估，李秉航评估电路布置
