AFlyingPiglet/shangjianyinqing/docs/06-规则测评笔记.md

# 规则测评笔记

> 规则测评 = 80 道四选一单选题，**只有 1 次答题机会**，占中期考核 30%。
> 本文按"学习日志"方式整理：每个知识板块下按日期记录学到了什么、易错点在哪。

## 尺寸与重量

**2026-09-28 学习记录（手册 3.3 设计技术规范）**

- 初始尺寸 ≤ 290 × 195 × 210 mm
- 展开 ≤ 445 × 400 × 450 mm，或直径 550 mm 球体判据（离地 180 mm 的平行面）
- 重量 ≤ 2.0 kg

<!-- 追加位置：后续复习时补充易错点 -->

## 电源与安全

**2026-09-28 学习记录（手册 3.2 通用技术规范）**

- 只能用 18650 电池；每台机器人仅 1 个供电模块，额定电压 ≤ 7.4 V
- 必须装官方无线继电器，10 m 内可切断底盘电源，检录时上交断电遥控器
- 供电模块定义：有且仅有一个输出接口；有延长线/转接线时按离电池最近的一端计算
- 化学安全：不得携带易燃易爆、有毒有害、未干胶体
- 强度检测：150–200 mm 自由落体无零件掉出

<!-- 追加位置 -->

## 得分规则

**2026-09-28 学习记录（手册 6.2 比赛道具）**

- 能量单元（白块）18 颗，1 分/颗；**全自动 ×2，半自动 ×1.5**
- 能量核心（黄块）5 颗，4 分/颗；**全自动 ×1.5，半自动 ×1.25**
- 只有**对局结束时**还带在车上的道具才算分
- 破坏能量单元/核心的，该道具不计分
- 单局 5 分钟；结束条件：满 5 分钟 / 道具被收集完 / 一方全部机器人 1 分钟无动作

<!-- 追加位置 -->

## 场地要素

**2026-09-28 学习记录（手册 6.1 比赛场地）**

- 场地 2400 × 2400 mm，8×8 单位区块（列 a–h、行 1–8）
- 高台 300 mm：a4、d4、d5、e4、e5、h5；台阶 150 mm：e8、d6、e3、d1
- 坡道：a5/a6、h3/h4（连高台）；e1、d8（连台阶），坡比 0.5（26.6°）
- 桥：b4、c4、f5、g5（净高 130 mm、宽 150 mm）
- 启动区：红 1 = h5、红 2 = a1、蓝 1 = a4、蓝 2 = h8
- 中央高台（d4/d5/e4/e5）是唯一正面争夺区；场地被中间带切成南北两半，地面车不能横穿

<!-- 追加位置 -->

## 行为判罚

**2026-09-28 学习记录（手册 6.3 机器人行为）**

- 恶意冲撞：断电 20 s，情节恶劣当局判负
- 破坏场地/对方机器人：断电 20 s
- 固连对方机器人：累计 10 s 后断电 5 s，此后每 20 s 断电 5 s
- 自行解体：当局判负
- 操作手跨出己方操作区累计超过 2 次：罚下并失去该车控制权
- 挤压允许；「碰撞」与「挤压」的区别在于是否明显减速

<!-- 追加位置 -->

## 赛程与流程

**2026-09-28 学习记录（手册 6.4 参赛流程）**

- 赛前 2 分钟整备；技术暂停每队每场 1 次、2 分钟
- 赛后 5 分钟内队长签字确认成绩，签字后不再受理申诉
- 赛制：6 轮杜博夫瑞士轮 BO1 + 8 强淘汰赛 BO3

<!-- 追加位置 -->

## 时间线

**2026-09-28 学习记录（手册第 3 页比赛日程）**

- 报名截止 9/30（本队 9/28 已提交）
- 实训分组志愿 10/1 13:00 – 10/5 24:00
- 统一培训 10/6–10/12
- 中期考核 10/19 24:00 提交截止
- 瑞士轮 10/24、10/25；淘汰赛 10/31

<!-- 追加位置 -->

## 复习进度

**2026-09-28**：已完成手册第一遍通读，整理出以上五个板块的要点。

<!-- 追加位置：做模拟题的记录、错题整理 -->
