AFlyingPiglet/shangjianyinqing/team/成员/02-史沐生-机械.md

# 史沐生 · 机械（1 号车） · 进度页（队内）

- 角色：机械设计（结构与 3D 建模）
- 负责模块：1 号车整车结构、举升机构、三种取块头、料仓
- 本周时间投入：约 __ 小时

## 进度记录（按时间从早到晚）

### 2026-09-28 现有方案基线

- 1 号车：240×160×200 mm，约 1.1 kg，麦轮 + 举升臂（行程 260 mm）+ 4 格料仓
- 取块头三种：内钩头、矮墙槽顶部内撑爪、低位耙钩（洞穴）
- 待解决：车宽 160 mm vs 桥面 150 mm（负余量）；麦轮 26.6° 坡打滑
- 证据：设计图 `docs/images/`（待补）

### 2026-09-24 日报

- 今日工时：2
- 今日目标：学习机械组的基本知识
- 做了什么：学习了机架的材料与制作的有关知识
- 学习内容：了解了机架的材料，比如铝合金或者碳板拼插。机架的作用是承载轮组以及搭建机架以上的机器人主体。认识到了铝合金主要分为6系和7系，他们的抗拉强度和屈服强度都有所不同，7系的强度更高但焊接难、成本较高，所以我们主要用6系铝合金。
- 学习来源：重庆大学千里战队B站视频
- 明日计划：了解搭建机器人需要用到的各种零部件
- 需要的支持：需要实际的器件操作来支撑理论学习

**当天照片：**

史沐生-1-04e1e54e

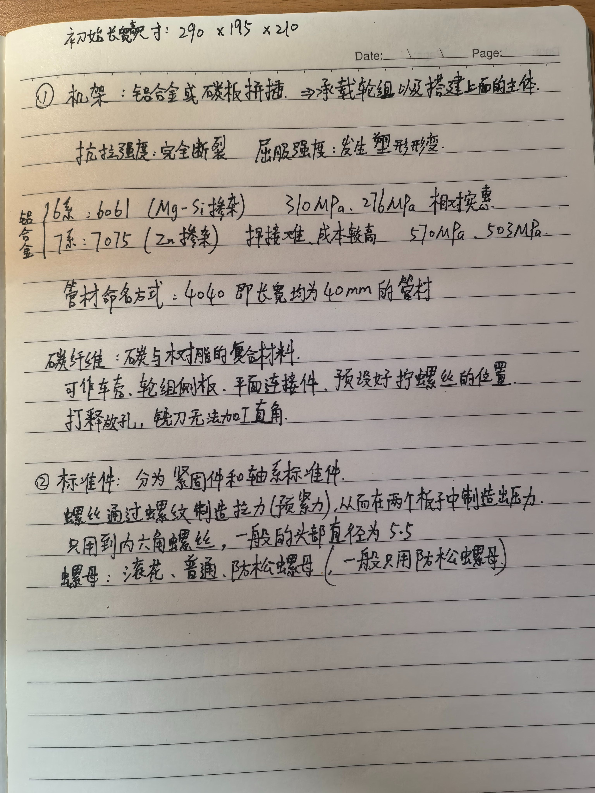
[picture p84: docs/images/日报配图/2026-09-24/史沐生-2-127a1084.jpeg]
史沐生-2-127a1084


### 2026-10-10 日报

- 今日工时：1
- 今日目标：学习fusion360的基本操作
- 学习中遇到的问题：对软件中的操作和指令不太熟悉，画的比较慢
- 学习中怎么解决的：多尝试几次，逐渐熟悉每种图形和操作的位置。找几个简单的图形练习。
- 学习内容：学习了如何创建草图，绘制一些平面的图形和立体几何体，在几何体上添加孔洞之类的操作。
- 学习来源：B站
- 明日计划：进一步了解如何构建更复杂和精确的模型，争取能把取块车的基本框架建立起来

**当天照片：**

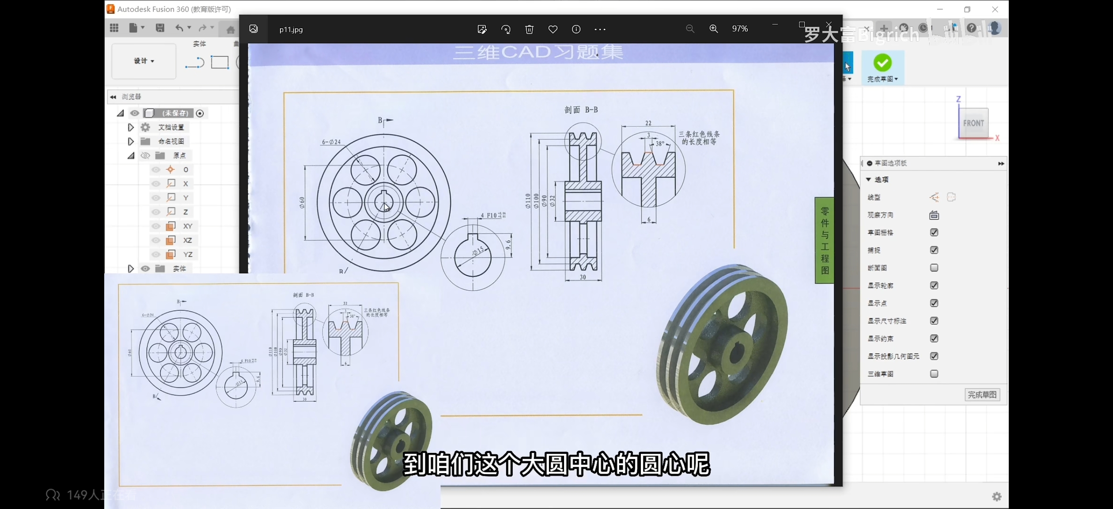
[picture p85: docs/images/日报配图/2026-10-10/史沐生-1-741b8648.jpg]
史沐生-1-741b8648


### 2026-10-13 日报

- 今日工时：2
- 今日目标：用fusion360完成松针取块头的绘制，并评估是否能进行3D打印
- 做了什么：用一个简单的圆柱体，将它的表面上手动插入一些细铁丝，代替原来用3D打印制作的松针取块头
- 关键决定（为什么这样做）：因为这样做能够保证取块头上面的松针的强度，保证他在拖拽能量单元时不会脱落，且这样能够简化3D打印时的操作，保证零件的质量。
- 试过但放弃的做法：尝试直接绘制表面带有松针的取块头的3D图像并进行3D打印，但由于针体太细，无法保证打印质量，因此只能放弃这个方案。

### 2026-10-14 日报

- 今日工时：1
- 今日目标：了解预检录和中期考核的相关信息
- 学习内容：中期考核的规则，如结构基础功能中的：稳定如何测试、能携带方块等。规则考核的方式以及进阶功能
- 学习来源：2026CRTC参赛手册V1.5
- 明日计划：对部分零件的结构进行修改，并尽快完成小车的组装以及调试

**当天照片：**

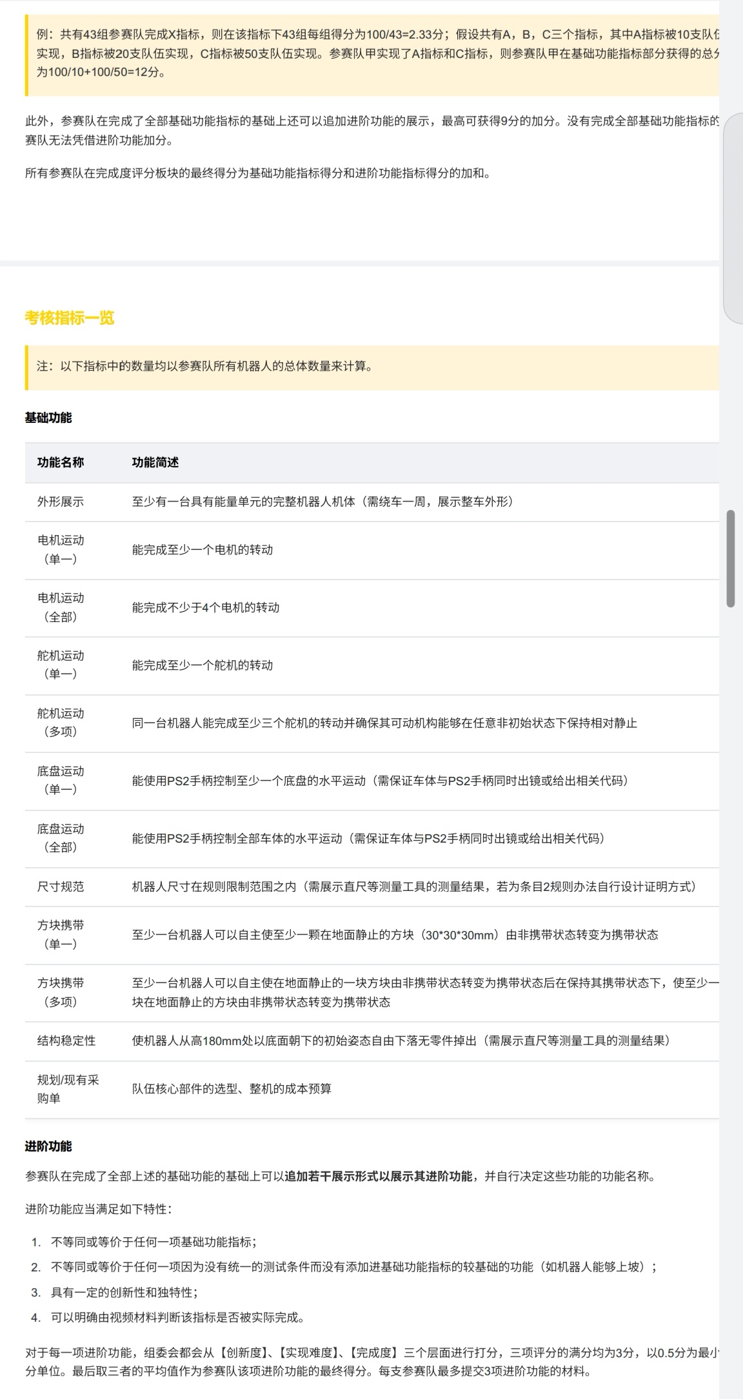
[picture p86: docs/images/日报配图/2026-10-14/史沐生-1-69d4ed87.jpeg]
史沐生-1-69d4ed87


### 2026-10-15 日报

- 今日工时：1
- 今日目标：了解如何将零部件拼装成完整的机器人
- 学习中遇到的问题：由于缺乏实物，有些步骤不太理解
- 学习中怎么解决的：上网搜索，结合实物图来看
- 学习内容：学习机器人各个零部件如何拼装在一起
- 学习来源：队长给出的文档中的拼装步骤
- 明日计划：对部分零件的结构进行修改，并尽快完成小车的组装以及调试

**当天照片：**

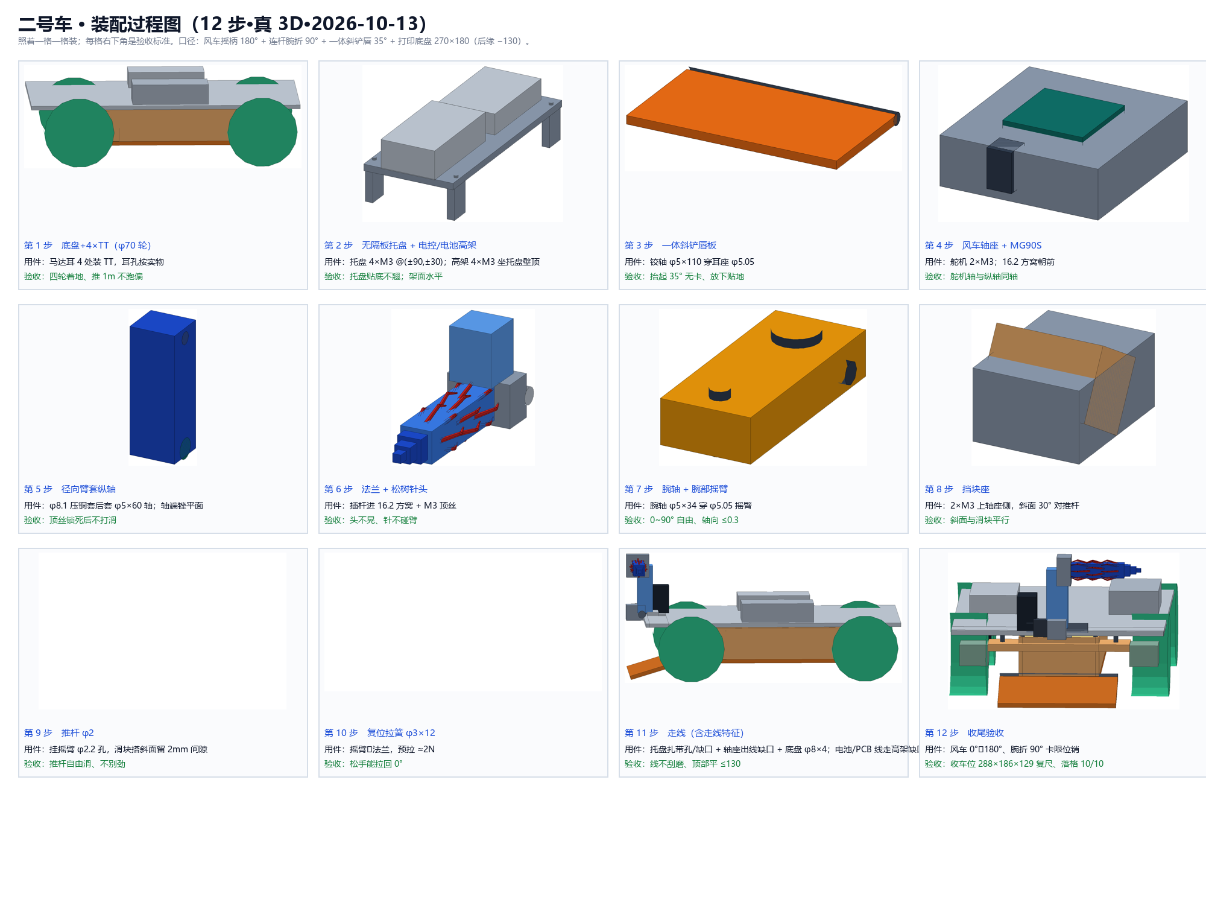
[picture p87: docs/images/日报配图/2026-10-15/史沐生-1-75df0be8.png]
史沐生-1-75df0be8
