AFlyingPiglet/shangjianyinqing/team/成员/05-杨佳琳-硬件.md

# 杨佳琳 · 硬件 · 进度页（队内）

- 角色：**硬件**——身份不变；另外**兼任财务**（报销台账、发票、预算跟踪）
- 负责模块：主职——电源链路、接线焊接、无线继电器；兼任——全队财务与报销
- 本周时间投入：约 __ 小时

## 进度记录（按时间从早到晚）

### 2026-09-28 职责与规则基线

- 硬性要求：整机仅 1 个供电模块、额定 ≤7.4 V、必须能被官方断电遥控器在 10 m 内断电
- 财务要点：新生组建议整机 ≤400 元；报销上限 400 元；**未通过中期考核不予报销**
- 与采买的分工：喻静琳负责比价下单，杨佳琳负责台账、发票、报销与预算提醒
- 证据：[物资与成本预算](../../docs/06-物资与成本预算.md)

### 2026-10-09 学习：嘉立创画简单 PCB 原理图

- 今日工时：2h
- 学习分类：硬件
- 来源：B 站教程
- 学了什么：用嘉立创 EDA 建工程、放元件、连网络、检查连线，先做到"能画通一张小图"
- 学习中遇到的问题：连线太乱，不知道元件该放什么位置
- 学习中的解决过程：先按"电源—控制—输出"三段分区摆元件再连线；线乱就先拉直、同类信号走同侧
- 备注：正式学习记录已写入 [学习笔记](../../docs/03-学习笔记.md) 的「硬件」板块

### 2026-10-12 日报

- 今日工时：1.5h
- 学习中遇到的问题：零件位置怎么放？后面接线怎么接？
- 学习内容：1，确定了1,2车板子上面都需要放置什么 2，STM上面没显示PA13,PA14，该如何接线？ 上面标注的引脚名字不全，有隐藏引脚，PA13,PA14对应的是34,37号引脚，将ST_Link的四个接线头插入3.3V,END,PA13,PA14即可烧录 3，弯曲排针和正常排针的区别：弯曲排针向上弯90度，再考虑到板子位置大小和放置方向是可能会考虑，我们就用正常的就可以了
- 学习来源：豆包，deepseek，嘉立创
- 明日计划：画完两个板子

### 2026-10-13 日报

- 今日工时：2h
- 学习内容：改进，打印一号车的PCB
- 学习来源：豆包，deepseek，嘉立创
- 明日计划：画完两个板子

**当天照片：**

杨佳琳-1-dbcfa02d
杨佳琳-2-a44acbcc
