AFlyingPiglet/shangjianyinqing/team/成员/04-李秉航-电控-自动控制.md

# 李秉航 · 电控 + 自动控制（2 号车） · 进度页（队内）

- 角色：电控 / 自动控制
- 负责模块：2 号车电机驱动、航点程序、里程计与传感器纠偏
- 本周时间投入：约 __ 小时

## 进度记录（按时间从早到晚）

### 2026-09-28 自动路线与合规基线

- 每个点位动作统一：直行到位 → 停车 → 拨轮转 2 秒 → 继续
- 合规结论：本队为**新生组**，允许使用官方物资表以外的物资 → 灰度/红外方案可行
- 待定：是否压低车高到 130 mm 以内（决定能不能钻桥下多拿 2 颗白块）
- 证据：待补

### 2026-09-28 日报

- 今日工时：2
- 今日目标：配置环境
- 学习中遇到的问题：网速太慢，安装失败，安装缺少文件
- 学习中怎么解决的：重新尝试安装
- 学习内容：配置ST-link，STM32CudeMX
- 学习来源：B站
- 明日计划：安装Clion

**当天照片：**

李秉航-1-46bd4360

### 2026-09-29 日报

- 今日工时：3
- 今日目标：配置环境
- 学习内容：配置Clion,STM32CubeMonitor，STM32CubeProgrammer，STM32CubeCLT
- 学习来源：QQ群所发网站
- 明日计划：学习GPIO

**当天照片：**

李秉航-1-b380d144
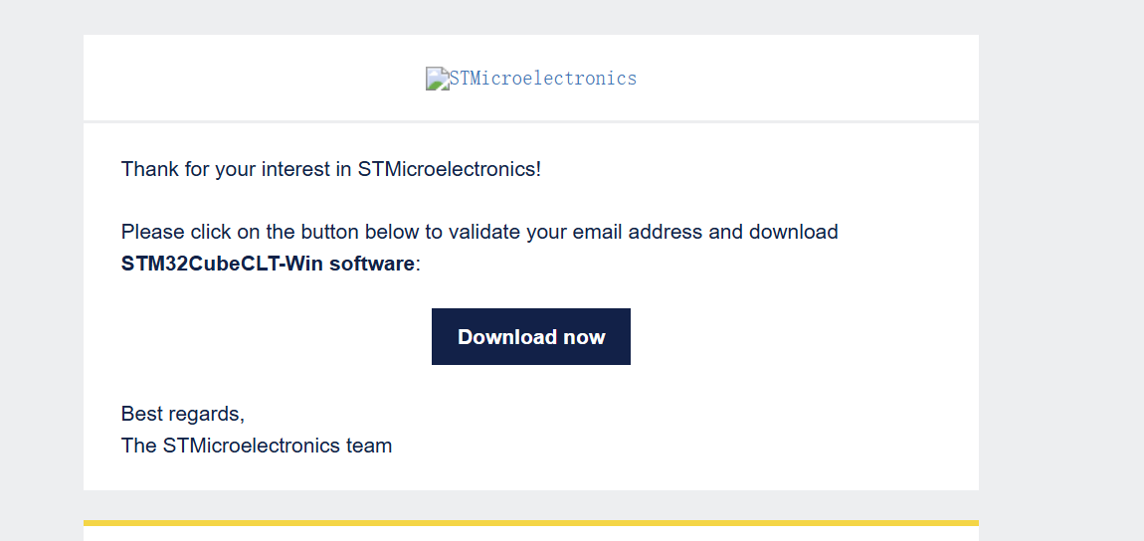
[picture p88: docs/images/日报配图/2026-09-29/李秉航-2-30b812a8.png]
李秉航-2-30b812a8

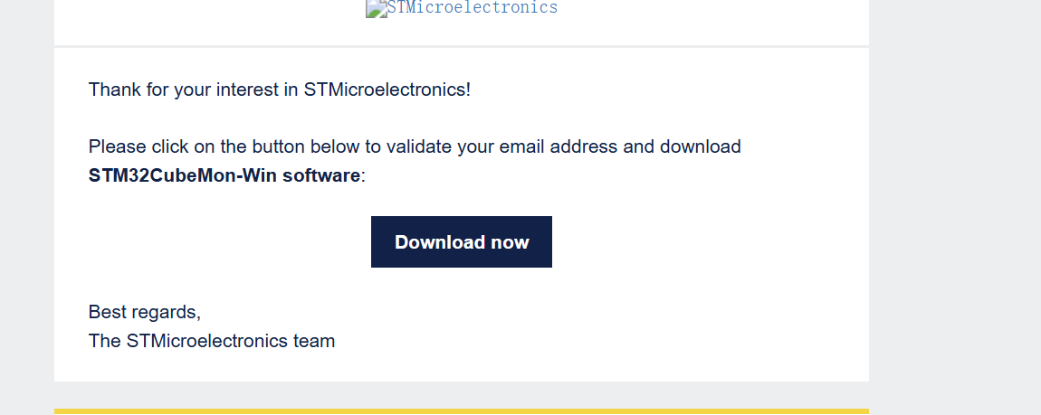
[picture p89: docs/images/日报配图/2026-09-29/李秉航-3-215c16c6.png]
李秉航-3-215c16c6


### 2026-09-30 日报

- 今日工时：1
- 今日目标：学习GPIO
- 学习中遇到的问题：新名词太多，初学理解有困难
- 学习中怎么解决的：反复观看视频，不急于求成
- 学习内容：GPIO
- 学习来源：B站
- 明日计划：学习PLC

**当天照片：**

李秉航-1-0cf1a1bb
李秉航-2-749e51b0

### 2026-10-05 日报

- 今日工时：4
- 今日目标：学习基础PLC知识
- 学习中遇到的问题：新名词太多，程序设计基础薄弱
- 学习中怎么解决的：整理笔记，借助AI学习
- 学习内容：《零基础PLC编程从入门到精通》
- 学习来源：书本《零基础PLC编程从入门到精通》
- 明日计划：结合AI进行代码编写

**当天照片：**

李秉航-1-1ceda53c
李秉航-2-470c7768
李秉航-3-c148fd3c

### 2026-10-08 日报

- 今日工时：4
- 今日目标：确定一号车底盘方案（麦轮 vs 普通橡胶轮），搭好 CLion 工程骨架。
- 做了什么：照方案书 13 号成本图，确认一号车原方案用麦轮。 把麦轮和 60mm 普通橡胶轮做了逐项对比（自由度、抓地、成本、走位难度）。 在 CLion 里用 CubeMX 生成 Clion_test 工程，确认 Core/Inc、Core/Src 目录结构。
- 关键决定（为什么这样做）：决定一号车改用 60mm 普通橡胶轮（差速驱动），放弃麦轮。
- 试过但放弃的做法：试过在代码里保留麦轮逆解函数，只是"把 vy 恒置 0"来兼容两种轮子。放弃原因：多一层抽象，调试时容易搞混，而且麦轮的 4 轮叠加公式对差速车没意义，索性重写成差速版。
- 实操中遇到的问题：一开始分不清 main.h 该写什么，差点把 app_chassis.h include 进去。
- 实操中怎么解决的：明确了 main.h 是"最底层公共头"，只放全车公用、且不属于任何单个外设/模块的极少内容；业务头在 main.c 里 include，不外溢。
- 采购 / 花费：0
- 完成度自评：进行中
- 设计思路更新：剔除1号车使用麦轮进行原地旋转的可能
- 明日计划：写 app_chassis.h / app_chassis.c（差速版），在 main.h 里只加 GetTick_ms() 和 Car_SafeStop() 两个全局声明。
- 需要的支持：确认 60mm 橡胶轮 + TT 轴联轴器的具体型号，避免下单后装不上。

**当天照片：**

李秉航-1-e48bd297
