AFlyingPiglet/shangjianyinqing/上传到仓库的步骤.md

# 把文档上传到 Gitee / GitHub 的步骤

## 最省事的办法：双击「upload.bat」

项目根目录下的 **upload.bat** 就是"一键上传"：

1. **第一次**双击：会让你填名字、邮箱和仓库地址（地址要先在网站上建好仓库才有）
2. **以后每次**双击：自动提交 + 推送，看到"上传成功"就完事了

第一次推送时会弹出登录窗口，选 **「Sign in with your browser / 用浏览器登录」**，登录一次以后就不用再登了。

如果推送失败，脚本会打印常见原因和处理办法。下面是手动操作的完整版。

手册允许 GitHub 或 Gitee，提交时给仓库链接即可。**国内网络建议用 Gitee**。

仓库规范（手册要求）：

- 仓库名用**队名的拼音或英文** → 我们用 `shangjianyinqing`
- **所有提交文档放在仓库根目录的 `docs/` 文件夹**
- 仓库其他部分不作要求（我们把进度看板、个人页放在 `team/`）

---

## 路线 A：网页上传（零安装，适合先跑通流程）

1. 注册并登录 Gitee（或 GitHub）
2. 右上角「+」→ 新建仓库 → 仓库名 `shangjianyinqing` → 可见性选**公开** → 创建
3. 进入仓库 → 「上传文件」→ 把本地 `docs` 文件夹和 `team` 文件夹一起拖进去
4. 提交信息写「初始文档」→ 提交
5. 以后每次更新，重复 3–4 步

---

## 路线 B：Git 命令行（你机器上已装 Git）

PowerShell 逐行执行：

```powershell
cd C:\Users\飞猪\Documents\Codex\CRTC2026

git config user.name "蔡昌恒"        # 只需设置一次
git config user.email "你的邮箱"

git init
git add .
git commit -m "初始文档：两车方案与文档体系"

git remote add origin <仓库地址>
git branch -M main
git push -u origin main
```

以后每天更新完：

```powershell
cd C:\Users\飞猪\Documents\Codex\CRTC2026
git add .
git commit -m "补充：矮墙槽取块机构调试记录"
git push
```

> 推送时会要求登录：Gitee 用账号密码或私人令牌；GitHub 现在必须用令牌（Token）。嫌麻烦就用 GitHub Desktop（图形界面，点几下即可）。

---

## 建议的日常节奏

1. 用 MarkText 打开 `C:\Users\飞猪\Documents\Codex\CRTC2026`
2. 当天做了什么、试错了什么，先补进 `team\成员\自己那页.md`
3. 涉及具体功能的，再整理进 `docs\` 里对应的功能文档（重点写"为什么"）
4. 照片放 `docs\images\`，用相对路径引用
5. 每天或每次有进展就提交一次
6. 中期考核前检查：12 项基础功能是否都有证据、`docs\` 里每篇是否都写了"为什么"

---

## 关于体积：会不会太大？

**结论：文档部分很小，不用担心；真正会把仓库撑爆的是视频和大尺寸原始照片。**

平台限制（GitHub / Gitee 大致相同）：

- **单个文件 100 MB 是硬上限**，超过直接被拒收
- 单个文件超过 50 MB 会警告
- 仓库总体积建议控制在 1 GB 以内

各类内容的体积参考：

| 内容 | 单个大小 | 建议 |
|---|---|---|
| Markdown 文档 | 几 KB ~ 几十 KB | 全部提交，随便传 |
| Word 日报 | 约 36 KB | 可以提交（放在 `team\日报存档\`），也可以不放 |
| 手机拍的照片 | 2–5 MB / 张 | **先压缩到 300 KB 左右** 再放进 `docs/images/` |
| CAD 导出图（PNG） | 100–500 KB | 提交 |
| Fusion360 / 3D 源文件 | 几十 MB ~ 几百 MB | **不提交**，放网盘，仓库里写链接 |
| 演示视频（1080p/30fps） | 几百 MB ~ 几 GB | **绝对不提交**：手册要求是打包成 zip 作为**邮件附件** |

仓库里已经放了一份 `.gitignore`，会自动忽略 `*.mp4`、`*.zip`、`*.f3d` 这类大文件，以及 Word 的 `~$` 临时文件。

上传前双击 **「检查体积.bat」**，它会列出总大小、最大的 10 个文件和超限文件。

## 关于时间：能攒到最后一起传吗？

**技术上可以，但不建议拖到 10 月 19 日当天。** 推荐做法：

1. **平时每天都 `git commit`（本地提交，不需要网络）** —— 这样提交历史会显示每天都有进展，本身就是"持续记录"的证据，评审很看重
2. **每周 push 一次**（比如周日晚例会后），而不是最后一天
3. **10 月 17 日前完成最后一次 push**，留两天缓冲

为什么不要卡最后一天：网络、账号令牌、仓库权限、文件体积任何一个出问题，都可能来不及处理；而且"最后一天一次性提交 200 个文件"在评审眼里很像突击补的。
