AFlyingPiglet/shangjianyinqing/写文档指南.md

# 写文档指南（内部用，不用提交）

## 一、手册的评分标准（文档评估，占中期考核 30%）

| 分数 | 要求 |
|---|---|
| 5 分 卓越 | 内容详尽、逻辑透彻、有技术深度；完整记录从构思到实现的全过程；**重点阐述"为什么这样做"**（选型对比、难点与解决、迭代优化），体现独立思考与创新 |
| 4 分 优秀 | 内容详尽、逻辑清晰、技术实现完整，但深度分析和独立思考不突出 |
| 3 分 良好 | 内容完整、思路基本清晰，细节缺失，技术部分不够细致 |
| 2 分 合格 | 思路大体可循，遗漏重要环节，技术部分简略 |
| 1 分 通过 | 只按规定提交，内容不完整、技术部分缺失 |

结论：**能不能上 4 分以上，取决于有没有写"为什么"和"试过哪些不行"。**

## 二、手册的格式硬要求（会被直接对照检查）

1. markdown（.md）格式
2. 按设计进度**从早到晚**组织内容
3. **以单个机器人的一个具体功能为一个板块**：`## 功能名称` + 功能描述与开发历程
4. 每篇文档由若干这样的板块组成
5. 所有提交文档放在仓库根目录的 **`docs/`** 里；仓库名用队名拼音（`shangjianyinqing`）

> 队伍内部的进度看板、个人日志放在 `team/`，不要放进 `docs/`（它们不符合上面的板块格式）。

## 三、每个功能板块的四段式模板

```markdown
## 功能名称

### 目标
这个功能要达成什么效果、对应哪个考核指标。

### 方案对比（为什么这样选）
| 方案 | 优点 | 缺点 | 结论 |
|---|---|---|---|
| A | | | 采用/放弃 |

### 开发历程（从早到晚）
2026-10-03 第一版：做了什么、结果如何
2026-10-05 踩坑：遇到什么问题、试了哪几种办法、最后怎么解决

### 验证结果
数据 + 照片/视频（试了多少次、成功多少次、误差多少）

### 下一步
还没解决什么、打算怎么改
```

## 四、怎么实现手册强调的「日志形式」

手册原文是"将学习到的知识内容以及机器人的设计思路与制作过程**以日志形式记录**"，同时又要求"按设计进度完成时间点**从早到晚**组织"。两者合起来就是：**每个功能板块里都有一段带日期的开发历程**。

写法就三条：

1. **一条日志 = 一个日期 + 一件事**，写在对应功能板块的 `### 开发历程（从早到晚）` 下面
2. **当天写当天记**，新的一条**加在本板块最下面**（时间正序，不删旧条目）
3. 每条只说清四件事：**做了什么 → 结果如何 → 遇到什么问题 → 怎么解决的**

示例（照这个格式往下写）：

```markdown
### 开发历程（从早到晚）

**2026-10-03 第一版薄爪**：打印 8 mm 薄爪，试 10 次成功 4 次，失败主要来自横向对位偏左。

**2026-10-05 加导向喇叭口**：在爪口加 15° 导向面后，试 10 次成功 8 次；剩余失败是贴靠距离太远，下一步加限位挡块。
```

其他两处也用同样方式：

- **学习内容**：写在 `07-规则测评笔记.md`，每个知识板块下用 `**日期 学习记录**` 开头
- **培训/自学内容**：写在 `08-学习笔记.md`，先归到对应板块（机械 / 电控与硬件 / 算法与编程 / 工具与软件 / 规则与赛务），再按日期追加
- **设计思路的变化**：写在 `09-设计思路记录.md`，按 1 号车 / 2 号车 / 通用分板块，记录"改前 → 改后、为什么改、影响什么"
- **个人日志**：写在 `team/成员/自己那页.md`（内部用，不提交），同样是日期条目、时间正序

> 为什么这样有效：评审最想看"从构思到实现的全过程"和"为什么这样做"。带日期的条目天然体现出**迭代过程**——哪一版失败、为什么改、改完结果怎样，这正是 5 分（卓越）与 3 分（良好）的分界线。

**另外记得同步用 Git 提交**：每次写完当天内容就 `git commit` 一次，提交信息写清楚改了什么。Git 的提交历史本身也是一份"日志"，能佐证文档是持续记录的，而不是最后一天补的。

## 四、图片与视频

- 图片放 `docs/images/`，文档里用相对路径：`![](images/2026-10-02-举升机构.jpg)`
- 在 MarkText 里拖入图片后，**记得把文件挪到 `docs/images/`** 并改成相对路径
- 视频不进仓库；中期考核要求单独打成 zip 作为邮件附件

## 五、提交材料命名（手册要求）

- 邮件主题：`队伍名称 队长姓名`（例：熵减引擎战队 蔡昌恒）
- 正文：列出本队完成的指标 + 仓库地址
- 附件 zip 命名：`实训战队名称 队伍名称 队长姓名`
- 收件邮箱：`zhang.guohao@lark.cquqian.li`
- 截止：2026-10-19 24:00（北京时间）

## 六、12 项基础功能证据清单（每完成一项就存素材并在看板登记）

- [ ] 1 外形展示（绕车一周视频）
- [ ] 2 电机运动·单一
- [ ] 3 电机运动·全部（≥4 个电机）
- [ ] 4 舵机运动·单一
- [ ] 5 舵机运动·多项（≥3 个舵机 + 任意非初始状态保持静止）
- [ ] 6 底盘运动·单一（PS2 控制 + 车与手柄同框）
- [ ] 7 底盘运动·全部（PS2 控制全车）
- [ ] 8 尺寸规范（直尺测量入镜）
- [ ] 9 方块携带·单一
- [ ] 10 方块携带·多项
- [ ] 11 结构稳定性（180 mm 自由落体不掉件）
- [ ] 12 规划与采购单（选型 + 成本预算）

进阶功能最多 3 项，每项按创新度/实现难度/完成度各 3 分（最高加 9 分）。建议从「矮墙槽顶部内撑爪」「全自动航点收运」「可钻桥的矮身设计」里挑。

## 七、加分思路

每次**试错**都要写下来，哪怕最后没用——这正是评委想看的：

- 为什么放弃"从外面夹方块"（只能夹 7.5 mm 细棱，不可靠）
- 为什么放弃吸盘（每个面都是镂空的）
- 为什么 2 号车不用麦轮（固定航点不需要横移，差速更准更稳）
