AFlyingPiglet/shangjianyinqing/进度记录规则.md

# 进度记录规则（内部用，不用提交）

## 一、手册对「文档评估」的要求（原文要点）

1. **格式**：markdown（`.md`）。
2. **组织方式**：按机器人设计进度**从早到晚**组织；**以单个机器人的一个具体功能为一个板块**；板块 = 具体功能（**H2 标题**）+ 功能描述与开发历程（正文）；每篇文档由若干这样的板块组成。
3. **仓库**：仓库名用队名的英文或拼音（我们用 `shangjianyinqing`）；**所有文档放在仓库根目录的 `docs/` 文件夹**；仓库其他部分不作要求。
4. **内容质量**：要能看到从构思到实现的完整过程，重点写**"为什么这样做"**——技术选型对比、遇到的难点与解决方案、迭代优化过程。只写"做了什么"最多 3–4 分。
5. 文档评估占中期考核总分 **30%**（另两板块：完成度 40%、规则测评 30%）。

## 二、我们的分工：三个层次，两个目录

```
提交给评委（docs/）
  ├─ 01-1号车-机械结构.md      ┐
  ├─ 02-1号车-取块机构.md      │ 每篇 = 若干「## 功能」板块
  ├─ 03-1号车-电控与操作.md    │ 每个板块 = 功能描述 + 开发历程（时间从早到晚）
  ├─ 04-2号车-底盘与拾取.md    │ 重点写"为什么这样选""试过什么不行"
  ├─ 05-2号车-自动控制.md      │
  ├─ 06-物资与成本预算.md      │
  ├─ 07-规则测评笔记.md        │
  ├─ 08-学习笔记.md            │
  └─ 09-设计思路记录.md        ┘

队内工作区（team/，不提交）
  ├─ 日报流水.md               每天日报的原始汇总（自动生成）
  ├─ 00-总进度看板.md          谁在做什么、做到哪、证据在哪
  └─ 成员\*.md                 个人日志（时间从早到晚）
```

- **个人页**（`team/成员/`）：原始记录，写「我做了什么、遇到什么问题、下一步」。**时间正序：新的一条加在最下面**（手册要求从早到晚）。
- **功能文档**（`docs/`）：把个人页的内容按**功能**重新组织，这是评委主要看的部分。
- **总看板**（`team/`）：只放状态、负责人和链接，不写过程。

> 为什么这样分：手册要求 `docs/` 里每篇文档都按「H2 功能板块」组织，而进度看板和个人日志不符合这个格式，所以放到 `team/`（手册对 `docs/` 之外的内容不作要求）——既满足格式要求，又不丢掉过程记录。

## 三、每周例会流程（建议周日晚 20:00，15 分钟）

1. 每人花 3 分钟更新自己的个人页（本周做了什么 + 下周计划 + 需要支持）
2. 队长把「总进度看板」的状态与勾选框同步一遍
3. 有完成的考核指标 → 把照片/视频放进 `docs/images/`，在看板第 4 节登记
4. 谁做的功能，就把过程整理进 `docs/` 对应的功能文档（补"为什么"和"试过什么不行"）

## 四、日志怎么写（手册强调的"日志形式"）

- **提交文档里的日志**：写在每个功能板块的 `### 开发历程（从早到晚）` 下，一条 = `**日期** 做了什么 → 结果 → 遇到什么问题 → 怎么解决`，新条目加在最下面（正序）
- **学习内容的日志**：写在 `docs/07-规则测评笔记.md`，格式同上，`**日期 学习记录**`
- **内部个人日志**：写在 `team/成员/自己那页.md`，同样规则
- **当天写当天记**，不要攒到周末补；写不动就一句话，比空着强
- 每次写完顺手 `git commit` 一次，提交历史也是日志证据

## 四、状态标记（全队统一）

| 标记 | 含义 |
|---|---|
| ☐ 未开始 | 还没动手 |
| 🟡 进行中 | 已在做，未完成 |
| ✅ 已完成 | 有证据可查 |
| 🔴 卡住 | 需要别人或外部条件支持 |

## 五、图片与视频

- 图片统一放 `docs/images/`；文档里引用 `![](images/xxx.jpg)`，个人页里引用 `![](../../docs/images/xxx.jpg)`
- 命名建议 `日期-内容.jpg`，如 `2026-10-03-矮墙槽对位-第3次.jpg`
- **视频不进仓库**：中期考核要求单独打包 zip（.mp4、≥1080p、≥30fps）作为邮件附件
