AFlyingPiglet/shangjianyinqing/docs/03.00-学习笔记.md

# 学习笔记（第 3 章）

> 按板块分册（03.01~03.05），内容按日期从早到晚记录，由日报自动写入；空板块不单列，有新内容时自动生成。

## 本篇结构

| 编号 | 板块 | 文档 | 条目数 |
|---|---|---|---|
| 03.01 | 机械 | [打开](03.01-机械.md) | 9 |
| 03.02 | 电控 | [打开](03.02-电控.md) | 6 |
| 03.03 | 工具与软件 | [打开](03.03-工具与软件.md) | 3 |
| 03.04 | 规则与赛务 | [打开](03.04-规则与赛务.md) | 2 |
| 03.05 | 硬件 | [打开](03.05-硬件.md) | 3 |
