AFlyingPiglet/shangjianyinqing/docs/03.01-机械.md

# 03.01 机械（学习笔记）

> 按日期从早到晚记录「机械」板块的学习内容与来源；由日报自动写入。

## 机械

<!-- 追加位置：新条目按「### 日期 标题」+ 学习人/来源/学了什么/易踩的坑/怎么用到我们的车上 的格式往下写 -->

### 2026-09-24 机架的材料与制作

- 学习人：史沐生
- 来源：重庆大学千里战队B站视频
- 学了什么：了解了机架的材料，比如铝合金或者碳板拼插。机架的作用是承载轮组以及搭建机架以上的机器人主体。认识到了铝合金主要分为6系和7系，他们的抗拉强度和屈服强度都有所不同，7系的强度更高但焊接难、成本较高，所以我们主要用6系铝合金。
- 怎么用到我们的车上：学习了机架的材料与制作的有关知识

**当天照片：**

史沐生-1-04e1e54e

[打开图片：史沐生-1-04e1e54e](images/日报配图/2026-09-24/史沐生-1-04e1e54e.jpg)
史沐生-2-127a1084

[打开图片：史沐生-2-127a1084](images/日报配图/2026-09-24/史沐生-2-127a1084.jpeg)

### 2026-09-30 Fusion360安装与草图绘制

- 学习人：喻静琳
- 来源：bilibili2023年最新Fusion360教程
- 学了什么：直线，矩形，圆等基本草图命令的认识，练习绘制完整草图
- 怎么用到我们的车上：成功下载fusion360面向个人的免费版本，完成5个草图练习
- 学习中遇到的问题：创建草图时耗时过长，草图有些点衔接不上，草图不够美观

**当天照片：**

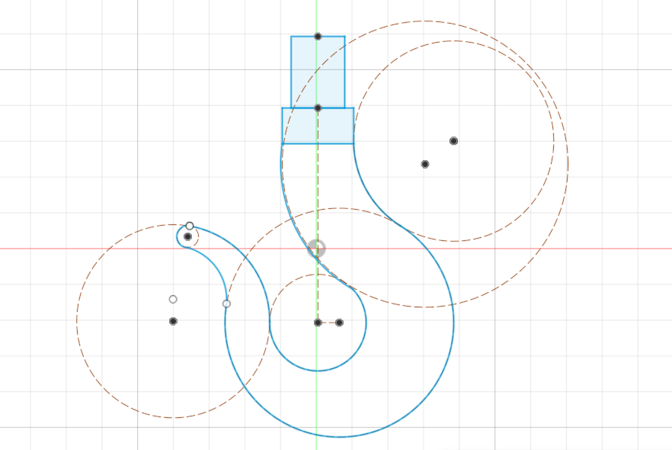
[picture p92: docs/images/日报配图/2026-09-30/喻静琳-1-6c3dd3d7.png]
喻静琳-1-6c3dd3d7


[打开图片：喻静琳-1-6c3dd3d7](images/日报配图/2026-09-30/喻静琳-1-6c3dd3d7.png)
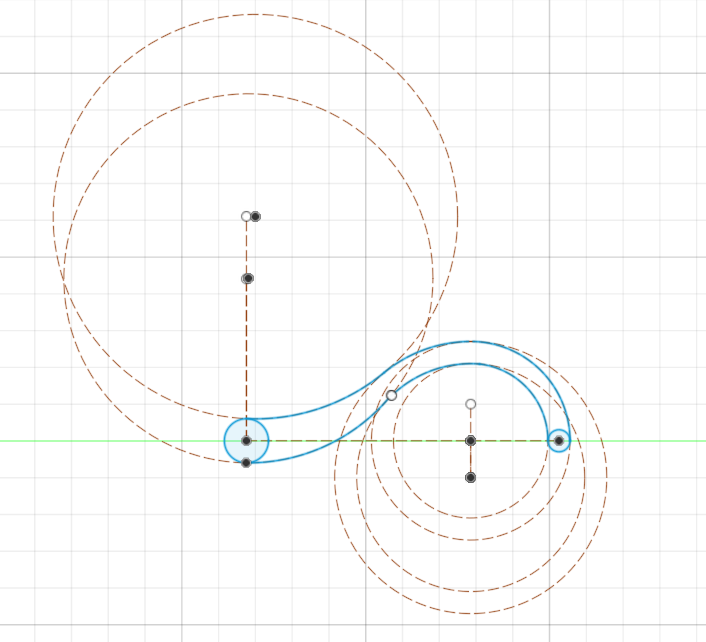
[picture p93: docs/images/日报配图/2026-09-30/喻静琳-2-f674d0a7.png]
喻静琳-2-f674d0a7


[打开图片：喻静琳-2-f674d0a7](images/日报配图/2026-09-30/喻静琳-2-f674d0a7.png)
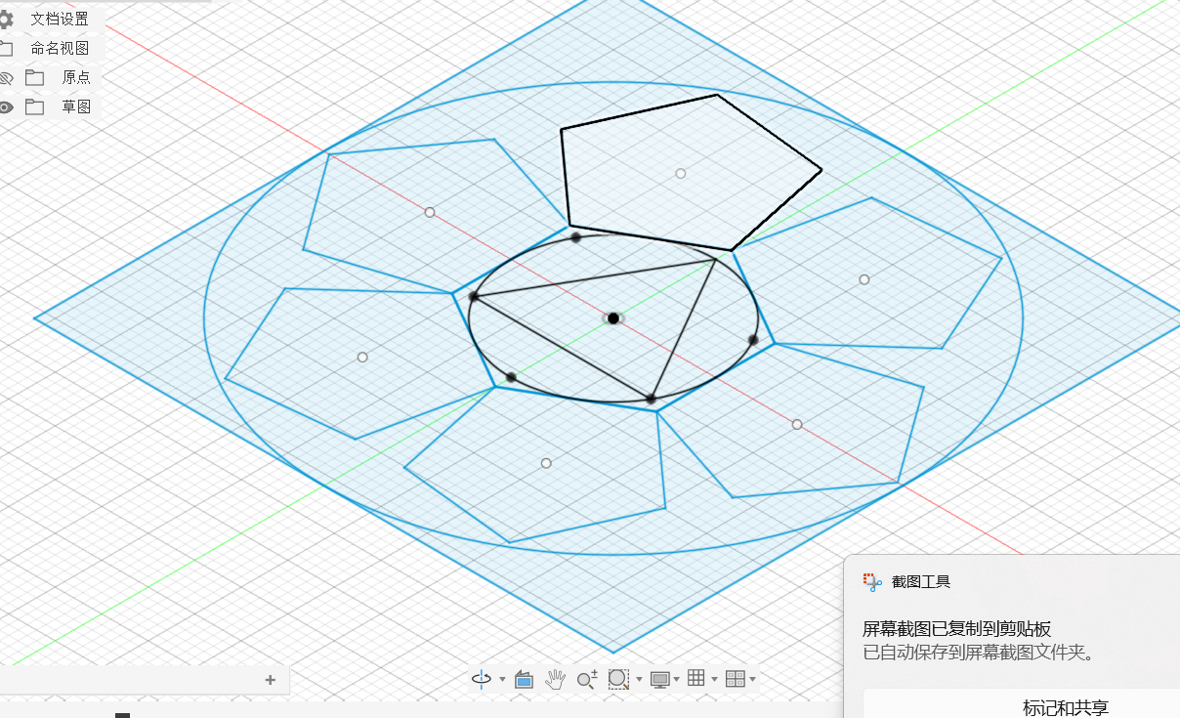
[picture p94: docs/images/日报配图/2026-09-30/喻静琳-3-943bd62d.png]
喻静琳-3-943bd62d


[打开图片：喻静琳-3-943bd62d](images/日报配图/2026-09-30/喻静琳-3-943bd62d.png)
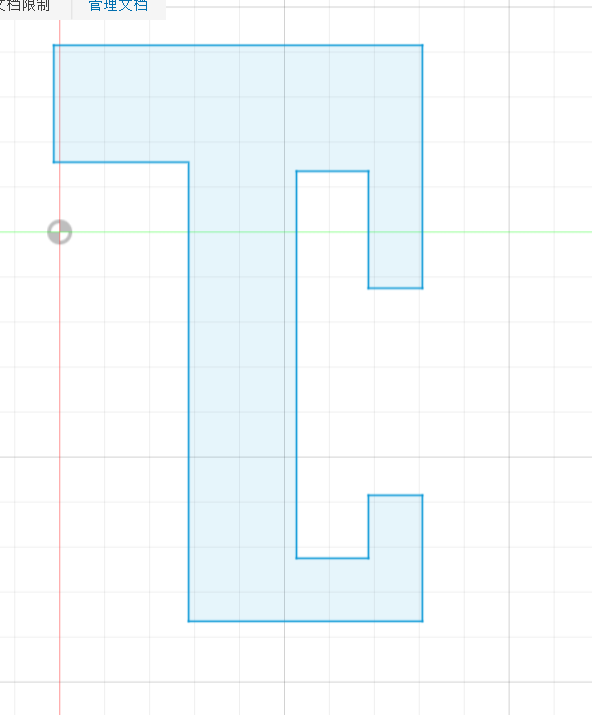
[picture p95: docs/images/日报配图/2026-09-30/喻静琳-4-6fde72bd.png]
喻静琳-4-6fde72bd


[打开图片：喻静琳-4-6fde72bd](images/日报配图/2026-09-30/喻静琳-4-6fde72bd.png)

### 2026-10-01 实体命令的认识与练习

- 学习人：喻静琳
- 来源：bilibili2023年最新Fusion360教程
- 学了什么：学习拉伸，旋转命令，完成一个微型带轮的实体练习
- 学习中遇到的问题：第一个思路：画出正视面草图，用拉伸创建实体，再通过旋转剪切出带轮曲面上的凹槽
- 学习中的解决过程：观察到除去中间孔，实体整体对称性较强，考虑用截面旋转得到，再用拉伸剪切去中间孔

**照片：**

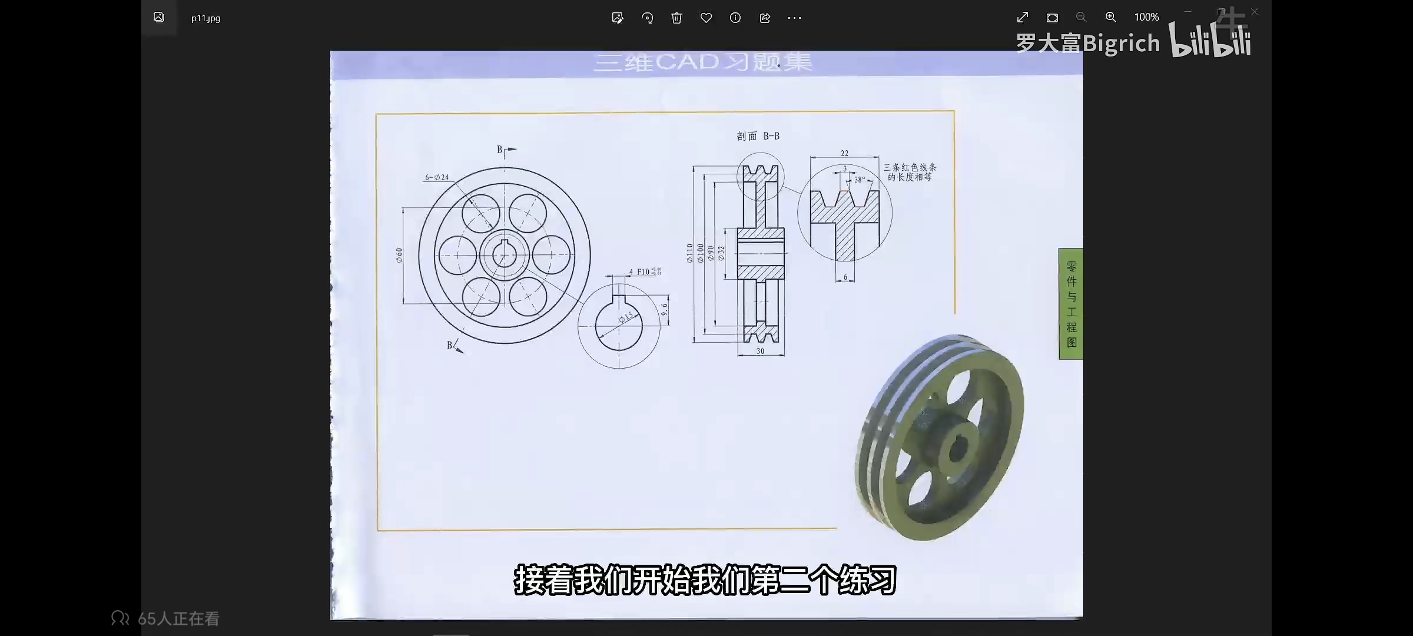
[picture p96: docs/images/日报配图/2026-10-01/喻静琳-1-a2c52752.jpeg]
喻静琳-1-a2c52752


[打开图片：喻静琳-1-a2c52752](images/日报配图/2026-10-01/喻静琳-1-a2c52752.jpeg)
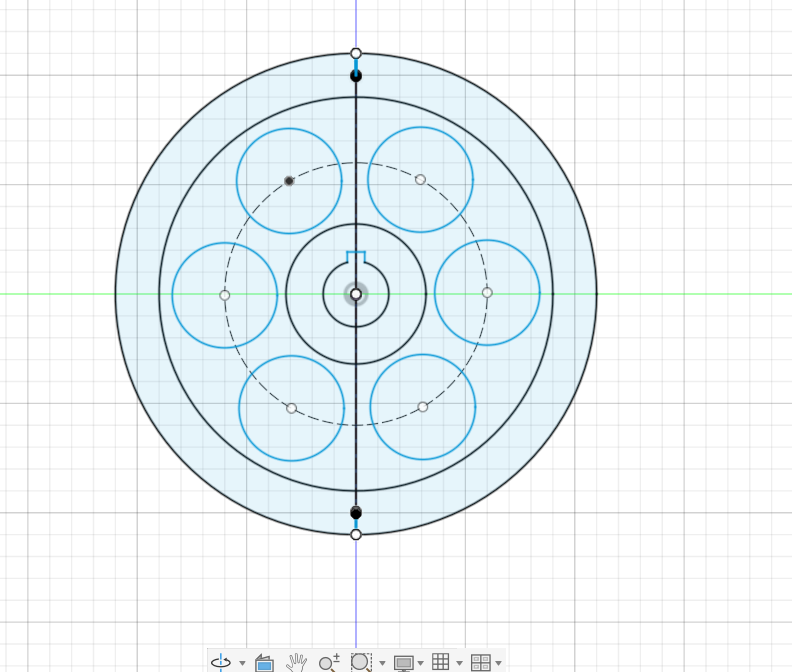
[picture p97: docs/images/日报配图/2026-10-01/喻静琳-2-2d0029fe.png]
喻静琳-2-2d0029fe


[打开图片：喻静琳-2-2d0029fe](images/日报配图/2026-10-01/喻静琳-2-2d0029fe.png)
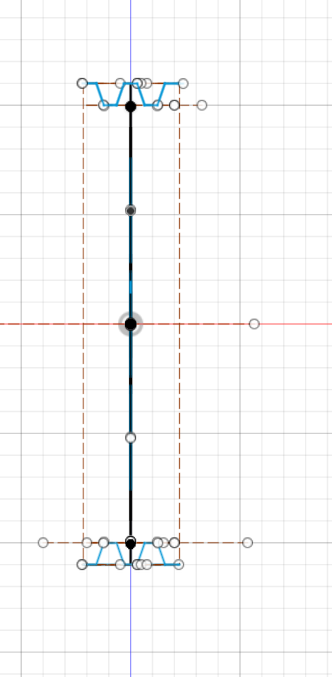
[picture p98: docs/images/日报配图/2026-10-01/喻静琳-3-07a828c0.png]
喻静琳-3-07a828c0


[打开图片：喻静琳-3-07a828c0](images/日报配图/2026-10-01/喻静琳-3-07a828c0.png)

### 2026-10-02 其他实体命令的认识与练习

- 学习人：喻静琳
- 来源：bilibili2023年最新Fusion360教程
- 学了什么：扫掠，基准面的构造命令的认识与实体练习
- 学习中遇到的问题：草图没画完就点了完成，再进入该平面时发现无法在原有的草图上做修改。左边的面板上有十几个草图，都没有另外命名，非常混乱。
- 学习中的解决过程：询问Deepseek后找到草图无法再编辑原因，重新创建了一个草图，点击完成草图之前确定了草图已经完全约束

**照片：**

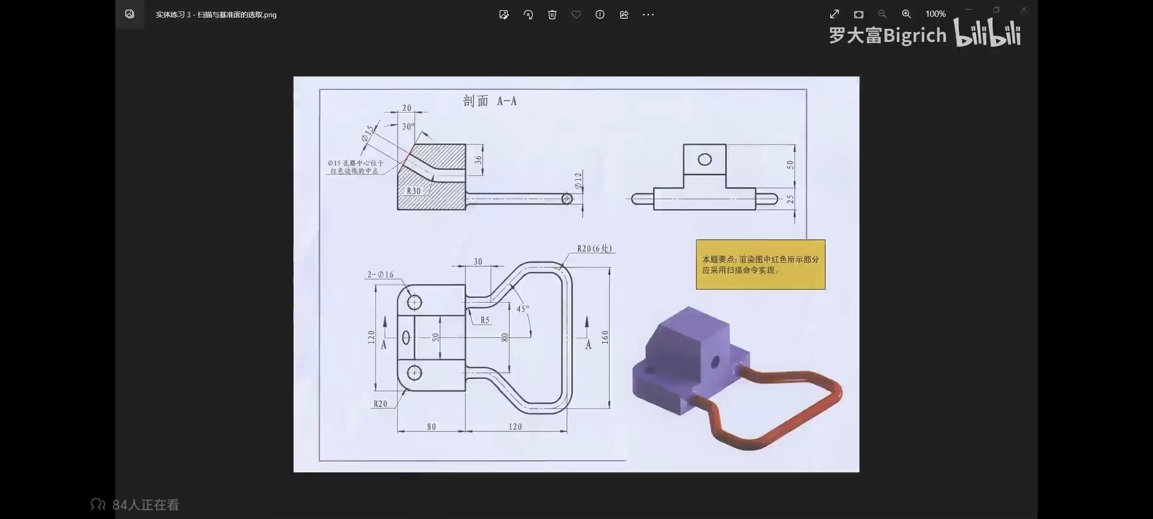
[picture p99: docs/images/日报配图/2026-10-02/喻静琳-1-b6ab550e.jpeg]
喻静琳-1-b6ab550e


[打开图片：喻静琳-1-b6ab550e](images/日报配图/2026-10-02/喻静琳-1-b6ab550e.jpeg)
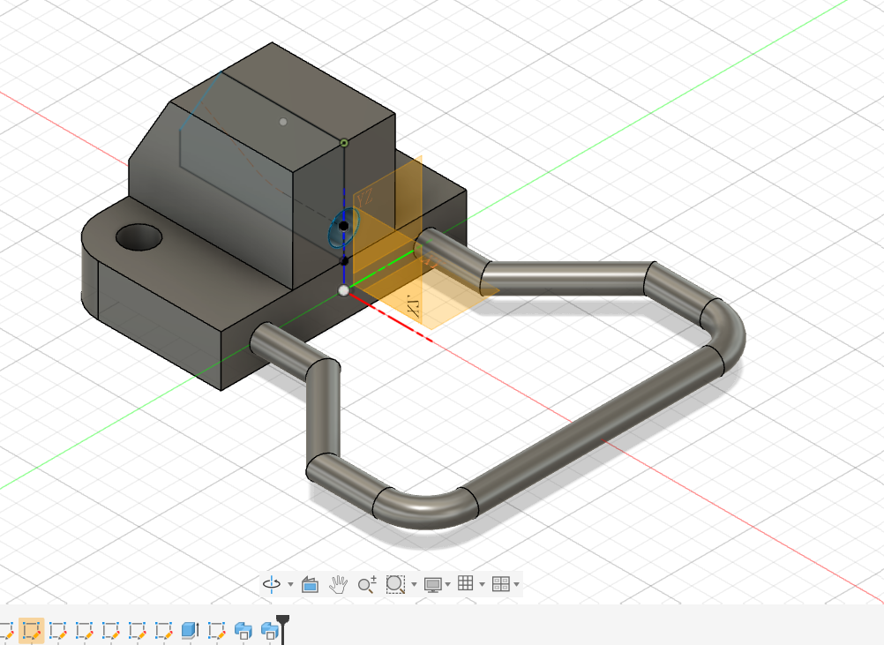
[picture p100: docs/images/日报配图/2026-10-02/喻静琳-2-7059bb1d.png]
喻静琳-2-7059bb1d


[打开图片：喻静琳-2-7059bb1d](images/日报配图/2026-10-02/喻静琳-2-7059bb1d.png)

### 2026-10-03 完成剩余实体命令的学习

- 学习人：喻静琳
- 来源：bilibili2023年最新Fusion360教程
- 学了什么：加强筋，孔，放样，抽壳，圆角实体命令的学习，学会创建三维草图

**照片：**

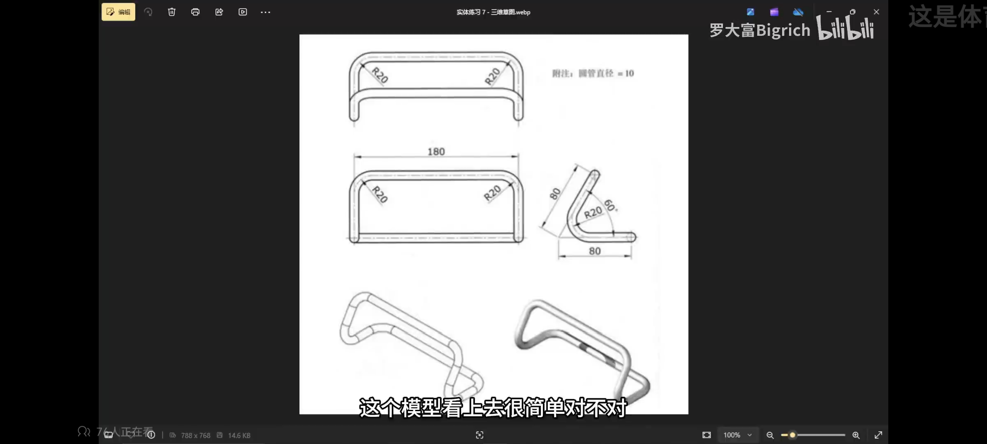
[picture p101: docs/images/日报配图/2026-10-03/喻静琳-1-ad9db877.jpeg]
喻静琳-1-ad9db877


[打开图片：喻静琳-1-ad9db877](images/日报配图/2026-10-03/喻静琳-1-ad9db877.jpeg)

### 2026-10-04 零件与装配体的学习

- 学习人：喻静琳
- 来源：bilibili2023年最新Fusion360教程
- 学了什么：零件的创建方法，装配体各种运动关系的的学习
- 学习中遇到的问题：槽轮练习中，完成装配体构建后，装配体不能按预想中的运动
- 学习中的解决过程：先检查草图，发现草图缺少一种接触关系，导致接触集合不能很好的发挥作用。重新构建正确的草图后顺利完成装配体练习

**照片：**

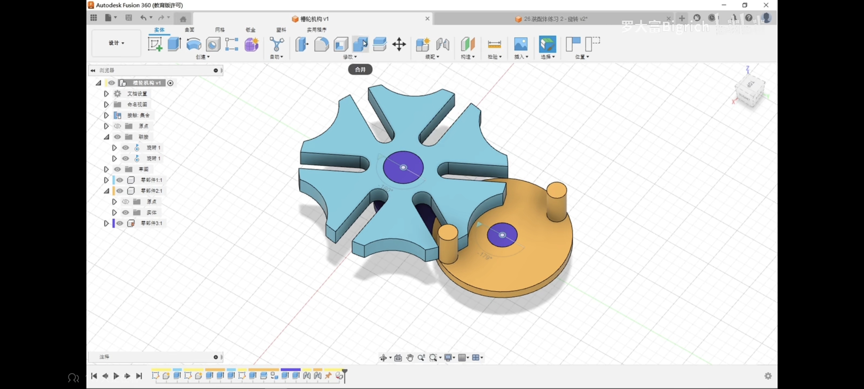
[picture p102: docs/images/日报配图/2026-10-04/喻静琳-1-7b4d00de.jpeg]
喻静琳-1-7b4d00de


[打开图片：喻静琳-1-7b4d00de](images/日报配图/2026-10-04/喻静琳-1-7b4d00de.jpeg)
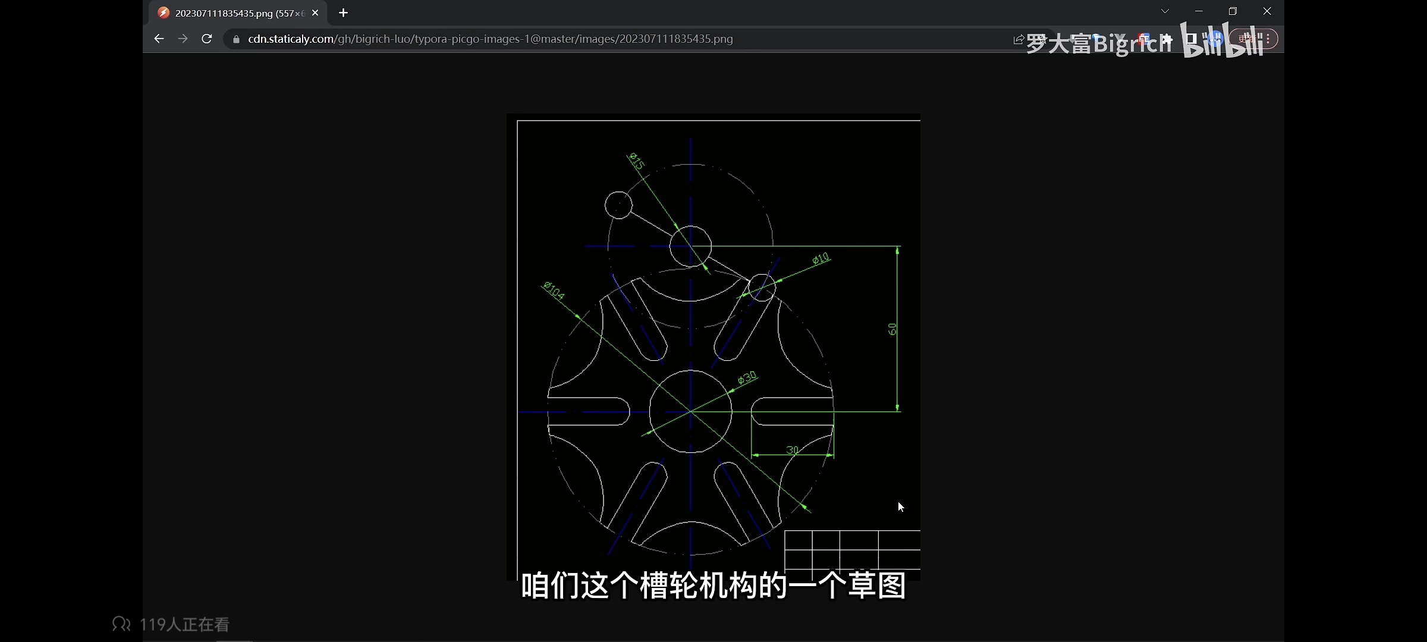
[picture p103: docs/images/日报配图/2026-10-04/喻静琳-2-7e177d16.jpeg]
喻静琳-2-7e177d16


[打开图片：喻静琳-2-7e177d16](images/日报配图/2026-10-04/喻静琳-2-7e177d16.jpeg)
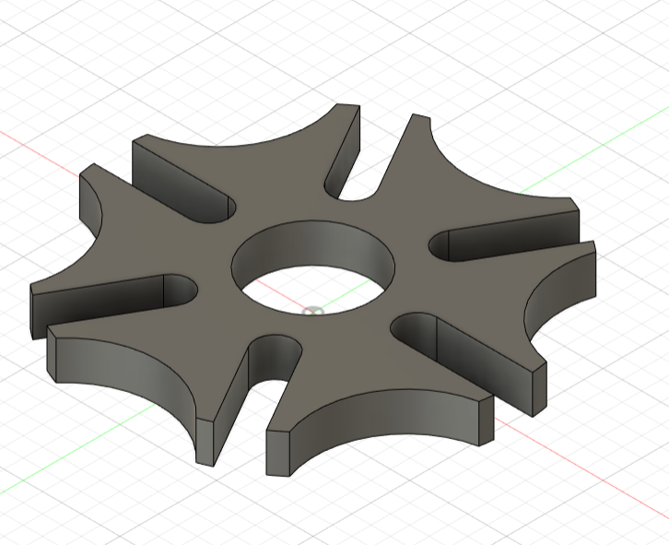
[picture p104: docs/images/日报配图/2026-10-04/喻静琳-3-3bb3fa44.png]
喻静琳-3-3bb3fa44


[打开图片：喻静琳-3-3bb3fa44](images/日报配图/2026-10-04/喻静琳-3-3bb3fa44.png)
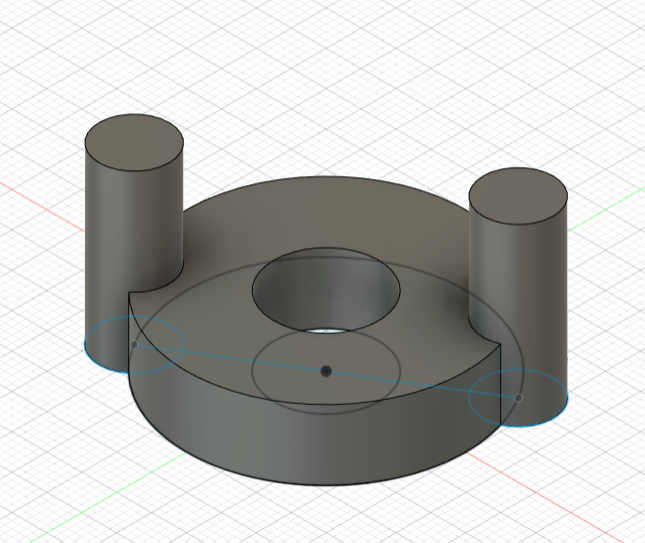
[picture p105: docs/images/日报配图/2026-10-04/喻静琳-4-d62abbcb.png]
喻静琳-4-d62abbcb


[打开图片：喻静琳-4-d62abbcb](images/日报配图/2026-10-04/喻静琳-4-d62abbcb.png)
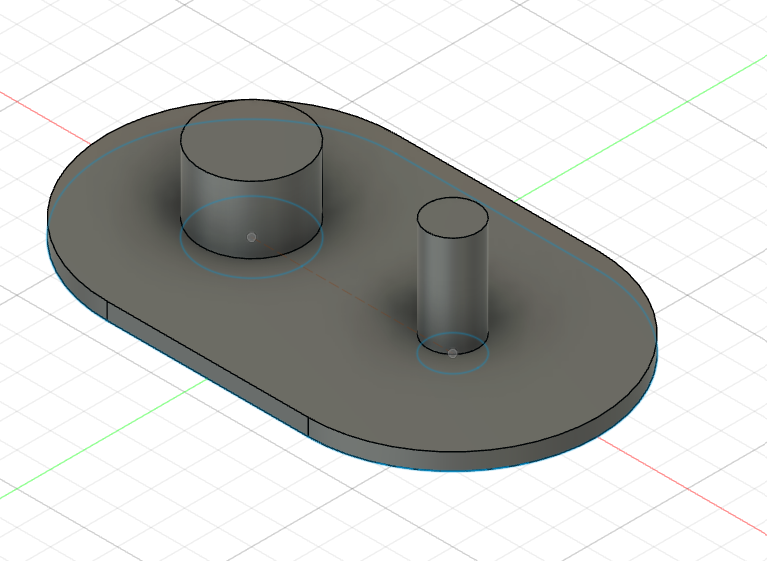
[picture p106: docs/images/日报配图/2026-10-04/喻静琳-5-2a51e892.png]
喻静琳-5-2a51e892


[打开图片：喻静琳-5-2a51e892](images/日报配图/2026-10-04/喻静琳-5-2a51e892.png)

### 2026-10-07 快换接口设计与中期考核规则梳理

- 学习人：蔡昌恒
- 来源：《CRTC2026参赛手册》V1.5；团队复核文档
- 学了什么：快换接口的"定位销＋手拧"组合；中期考核"完成度:规则:文档=4:3:3"与12项基础功能的演示要求。
- 重点 / 为什么这样：①立柱改成"上段通用、只换下段"——标定和程序不动，训练用直段、冲分用斜折；②抓取头"一接口多头"——主力夹爪保通用，被动头补断电安全与物资架轴向抽出；③二号车定手动操作——稳定与配合优先，半自动倍率问题列官方答疑。
- 易踩的坑：①托铲头——复核确认方块下面是实心台板，铲不进去，否决；②立柱孔列只做单条→改成左右对称两条＋横撑；③二号车全自动航点——暂缓，降级为可选升级。
- 怎么用到我们的车上：①一号车升级定型：模块化立柱（形态A直段/形态B斜折，拔销换装≤5分钟）＋两侧孔列/加强插孔，分系统3D出齐（整车、立柱、排孔、手臂三档、夹爪、举升）；②抓取头做成"一个快换接口、三种头"——平行夹爪（现役）、弹片内撑＋倒刺、低位耙钩（备用），3D与图纸都出好；③二号车确认回归"PS2手动操作"，同步修正三份正式文档；④采购对账：已购15项逐项核对（¥388.48），出待购清单（必买≈¥166、建议≈¥87）与采购结构表；⑤出《中期考核待完成互证表》50项（对应12项基础功能＋规则测评＋文档评估，含负责人列）。
- 证据：桌面三个文件夹（一号车-最终方案-竖折柱版 / 二号车-最终方案-V3 / 双车复核更新-2026-10-07）

**当天照片：**

蔡昌恒-1-ce23cc39

[打开图片：蔡昌恒-1-ce23cc39](images/日报配图/2026-10-07/蔡昌恒-1-ce23cc39.png)
蔡昌恒-2-f7c06b91

[打开图片：蔡昌恒-2-f7c06b91](images/日报配图/2026-10-07/蔡昌恒-2-f7c06b91.png)
蔡昌恒-3-c673969f

[打开图片：蔡昌恒-3-c673969f](images/日报配图/2026-10-07/蔡昌恒-3-c673969f.png)
蔡昌恒-4-f34ef353

[打开图片：蔡昌恒-4-f34ef353](images/日报配图/2026-10-07/蔡昌恒-4-f34ef353.png)
蔡昌恒-5-00d43bb3

[打开图片：蔡昌恒-5-00d43bb3](images/日报配图/2026-10-07/蔡昌恒-5-00d43bb3.png)

### 2026-10-10 fusion360的基本操作

- 学习人：史沐生
- 来源：B站
- 学了什么：学习了如何创建草图，绘制一些平面的图形和立体几何体，在几何体上添加孔洞之类的操作。
- 学习中遇到的问题：对软件中的操作和指令不太熟悉，画的比较慢
- 学习中的解决过程：多尝试几次，逐渐熟悉每种图形和操作的位置。找几个简单的图形练习。

**照片：**

史沐生-1-741b8648

[打开图片：史沐生-1-741b8648](images/日报配图/2026-10-10/史沐生-1-741b8648.jpg)

### 2026-10-15 机器人的组装

- 学习人：史沐生
- 来源：队长给出的文档中的拼装步骤
- 学了什么：学习机器人各个零部件如何拼装在一起
- 学习中遇到的问题：由于缺乏实物，有些步骤不太理解
- 学习中的解决过程：上网搜索，结合实物图来看

**照片：**

史沐生-1-75df0be8

[打开图片：史沐生-1-75df0be8](images/日报配图/2026-10-15/史沐生-1-75df0be8.png)
