AFlyingPiglet/shangjianyinqing/docs/03.03-工具与软件.md

# 03.04 工具与软件（学习笔记）

> 按日期从早到晚记录「工具与软件」板块的学习内容与来源；由日报自动写入。

## 工具与软件

<!-- 追加位置 -->

### 2026-09-25 如何在电脑上搭建agent

- 学习人：蔡昌恒
- 来源：哔哩哔哩
- 学了什么：在笔记本上从零布设环境
- 重点 / 为什么这样：自己对于电脑相关问题知识缺口太大，无法有效完成基本漏洞的检查和修复

**当天照片：**

蔡昌恒-1-f8bad0c4

[打开图片：蔡昌恒-1-f8bad0c4](images/日报配图/2026-09-25/蔡昌恒-1-f8bad0c4.jpeg)

### 2026-09-28 用github实现数据上传通路的搭建

- 学习人：蔡昌恒
- 来源：个人
- 学了什么：学会用github搭建数据上传通路，以应对文档考核。
- 重点 / 为什么这样：集思广益，在昨晚组会上有提出两辆车是A+B或是A+Aplus的两套思路，抓取方案有设想但是没有办法验证与修正其可行性。所以先用AI就昨天的设想出具了两张草图，给团队以相对清晰的认识，再次基础上再做设计的更迭。
- 怎么用到我们的车上：出版1号与2号车多个版本雏形，将其完善并在小组中征集新的收集思路与放置方式（以word形式发布问卷，收集上来由组长统一处理）

### 2026-10-11 口径一致性检查法：改一个数，扫全套

- 学习人：蔡昌恒
- 来源：今日实操总结（与 AI 协作复核流程）
- 学了什么：任一尺寸或价格改动后，沿「模型→图纸→表格→采购」全链路扫一遍，列出改动影响清单逐个销项；今天靠它揪出一号车图册 6 处、采购表 4 处旧口径残留。
- 重点 / 为什么这样：① 排孔与折叠立柱解绑——折柱取消但孔列保留，它是两侧挂点/加强/防脱接口，与折叠无关；② 孔列不再放回原侧梁位（y≈±39，现被轮子 y≥44 和料仓横档 y±40 占住），改放轮上方 y=±34、z40~80，把对穿孔排到 z76，80 mm 插销可全程对穿；③ 采购逐项按「检索/实测价」统一，避免重复多算（688ZZ、MG90S）。
- 学习中遇到的问题：图册和表格分散多处，漏改一处就会自相矛盾。
- 学习中的解决过程：先定唯一权威口径（两个最终版文件夹 + 采买包），再批量重出、逐张核对。
- 易踩的坑：① 孔列复刻原参数（20 宽单排 @5×40、200 长、装侧梁位）——被轮子和料仓横档挡住，放不下；② 孔列沿用 200 全长——前 8 mm 会撞刮料唇，改为 184。
- 怎么用到我们的车上：① 取块尺寸复核：一号车夹爪张开修正为 38~40 / 合拢 28~29（原写「15~30」等于方块尺寸，夹不进），对位容差 ±4~5 mm ＞ 机械累计 ±3.3 mm；② 采购口径 5 处修订并同步采买包 9 份文件（二号车轮 60→φ70、KW11×8 恢复必买、新增开口挡圈 φ5×12+φ6×4、SG90 归位「已购」、688ZZ 按 2 只 ¥9.2、MG90S 统一 ¥10.85）；③ 恢复一号车「两侧孔列板」排孔：184×40×4×2 片、y=±34、双排 φ4.05（两排错 5 mm）、对穿 φ4×80 插销，装配第 11 步先装孔列再装臂链；④ 图册重出与清理：一号车 00c/00d/00e/00g~00j/32~34 与 17 号零件图、01 总览（16 件）；二号车 26、31 与 3 张新近景，旧口径图剔除；⑤ 打包「CRTC2026-两车打印与装配包-2026-10-11.zip」（9.2 MB）；⑥ 汇总《双车最终方案报告》（Word，桌面）。

**当天照片：**

蔡昌恒-1-001344a8

[打开图片：蔡昌恒-1-001344a8](images/日报配图/2026-10-11/蔡昌恒-1-001344a8.png)
蔡昌恒-2-a11e0757

[打开图片：蔡昌恒-2-a11e0757](images/日报配图/2026-10-11/蔡昌恒-2-a11e0757.png)
蔡昌恒-3-cee36b97

[打开图片：蔡昌恒-3-cee36b97](images/日报配图/2026-10-11/蔡昌恒-3-cee36b97.png)
蔡昌恒-4-b7184053

[打开图片：蔡昌恒-4-b7184053](images/日报配图/2026-10-11/蔡昌恒-4-b7184053.jpg)
