AFlyingPiglet/shangjianyinqing/docs/03.04-规则与赛务.md

# 03.05 规则与赛务（学习笔记）

> 按日期从早到晚记录「规则与赛务」板块的学习内容与来源；由日报自动写入。

## 规则与赛务

**2026-09-28 手册通读（全队）**

- 学习人：全队
- 来源：《2026 CRTC 参赛手册 V1.4》
- 学了什么：比赛日程、检录硬指标（尺寸/重量/电源/无线继电器）、得分规则（白块 1 分、黄块 4 分，全自动有倍率）、中期考核三部分占比
- 易踩的坑 / 重点：报名 9/30 截止；未通过中期考核不予报销；只能使用一种无线通讯方式
- 怎么用到我们的车上：据此确定两车方案与预算上限，详见 `01`~`06` 各篇

### 2026-10-05 手册更新到 V1.5，看看改了啥

- 学习人：蔡昌恒
- 来源：《2026 CRTC 参赛手册》V1.5（跟 V1.4 一页页比）
- 学了什么：一共改了六处——培训时间定了（10/8–11 晚上）、遥控器条款、开源项目必须在中期考核里写清楚、方块从 40 改回 30、晋级名额新生组从 56 提到 60、中央高地那个十字基座是 300×300、矮墙离中心 64.25
- 学习中遇到的问题：无
- 学习中的解决过程：已经写进文档
- 分类：规则

### 2026-10-14 预检录与中期考核规则

- 学习人：史沐生
- 来源：2026CRTC参赛手册V1.5
- 学了什么：中期考核的规则，如结构基础功能中的：稳定如何测试、能携带方块等。规则考核的方式以及进阶功能
- 分类：规则

**照片：**

史沐生-1-69d4ed87

[打开图片：史沐生-1-69d4ed87](images/日报配图/2026-10-14/史沐生-1-69d4ed87.jpeg)
