AFlyingPiglet/shangjianyinqing/docs/01-基础功能.md

# 基础功能（第 1 章）

> 中期考核「完成度考核」的基础功能共 12 项。自 2026-10-18 起，每项功能独立成文（1.1~1.12），内容按《中期功能填写表》整理并按最新口径精简；证据文件待队长提供后补链接。

| 编号 | 功能 | 文档 | 现状摘要 |
|---|---|---|---|
| 1.1 | 外形展示 | [打开](1.1-外形展示.md) | 两车 3D 模型完成；实物因打印错印 / PCB 问题未组装 |
| 1.2 | 电机运动（单一） | [打开](1.2-电机运动（单一）.md) | 已调通（驱动焊接 + 直连） |
| 1.3 | 电机运动（全部） | [打开](1.3-电机运动（全部）.md) | 未实现（接收/手柄配对与烧录异常） |
| 1.4 | 舵机运动（单一） | [打开](1.4-舵机运动（单一）.md) | 已调通 |
| 1.5 | 舵机运动（多项） | [打开](1.5-舵机运动（多项）.md) | 未实现（多舵机同时控制） |
| 1.6 | 底盘运动（单一） | [打开](1.6-底盘运动（单一）.md) | 手柄配对已通，控车未通（见 1.3） |
| 1.7 | 底盘运动（全部） | [打开](1.7-底盘运动（全部）.md) | 未实现（见 1.3） |
| 1.8 | 尺寸规范 | [打开](1.8-尺寸规范.md) | 设计值合规；实测待补 |
| 1.9 | 方块携带（单一） | [打开](1.9-方块携带（单一）.md) | 结构完成，待上电实测 |
| 1.10 | 方块携带（多项） | [打开](1.10-方块携带（多项）.md) | 结构完成，待实测 |
| 1.11 | 结构稳定性 | [打开](1.11-结构稳定性.md) | 防摔措施落实，落体待测 |
| 1.12 | 规划与现有采购单 | [打开](1.12-规划与现有采购单.md) | 采购 V1.1 定稿 |

> 进阶功能见 [02-进阶功能](02-进阶功能.md)；完整旧版存档：`_归档/01-基础功能-完整版-2026-10-18.md`。
>
> 控制代码集中在 [code/](code/README.md)（一号车电控主工程 + 电机测试）；各功能文档的「证据」里已按模块给出链接。
