AFlyingPiglet/shangjianyinqing/docs/1.7-底盘运动（全部）.md

# 1.7 底盘运动（全部）

- **考核要求**：能用 PS2 手柄控制全部车体的水平运动。
- **当前状态**：未实现（两车通信/配对问题，见 1.3）。

## 我们的实现

两车均设计为 PS2 手动：1 号车麦轮全向、2 号车 φ70 橡胶轮差速；2 号车电机/舵机分路，待接线联调。

## 方案与取舍

- 两车统一 PS2 手动，放弃二号车全自动（稳定与配合优先；半自动倍率问题列官方答疑）。
- 双车手柄/接收配对与烧录异常尚未解决（见 1.3），全部车体控制无法演示。

## 开发历程（精简）

- 2026-09-28：两车定位划分。
- 2026-10-07：二号车确认回归 PS2 手动。
- 2026-10-15：1 号车手柄配对打通；两车联动待通信问题解决。

## 证据

- [x] 手柄与底盘代码（一号车工程）：[app_ps2.c](code/Clion_test/Core/Src/app_ps2.c)、[app_chassis.c](code/Clion_test/Core/Src/app_chassis.c)（二号车代码暂未纳入）
- [ ] 两车同时被 PS2 控制视频（待提供）
