AFlyingPiglet/shangjianyinqing/docs/02-进阶功能.md

# 进阶功能（第 2 章）

> 进阶功能最多 3 项，均为在基础功能之外增加的机制创新，逐项独立成文（2.1~2.3）。

| 编号 | 功能 | 文档 | 关联基础功能 |
|---|---|---|---|
| 2.1 | 手动自由度：排孔 + 插销关节 | [打开](2.1-手动自由度（排孔与插销关节）.md) | 1.1 / 1.9（1 号车） |
| 2.2 | 快换抓取头 | [打开](2.2-快换抓取头.md) | 1.9（1 号车） |
| 2.3 | 松树型倒刺（掏取） | [打开](2.3-松树型倒刺.md) | 1.9 / 1.10（2 号车） |

> 证据文件待队长提供后补链接；旧版存档：`_归档/02-进阶功能-旧版-2026-10-18.md`。
