AFlyingPiglet/shangjianyinqing/team/日报流水.md

# 日报流水（原始记录）

> 由「处理日报.bat」自动汇总，按提交顺序累积，内容原样保留。
> 用途：需要人工或 AI 二次整理时，读这一个文件就够了。

### 2026-09-28 蔡昌恒

- 今日工时：3
- 今日目标：根据团队前期会议对车型与抓取方式的可行性进行模拟
- 做了什么：出版1号与2号车多个版本雏形，将其完善并在小组中征集新的收集思路与放置方式（以word形式发布问卷，收集上来由组长统一处理）
- 关键决定（为什么这样做）：集思广益，在昨晚组会上有提出两辆车是A+B或是A+Aplus的两套思路，抓取方案有设想但是没有办法验证与修正其可行性。所以先用AI就昨天的设想出具了两张草图，给团队以相对清晰的认识，再次基础上再做设计的更迭。
- 遇到的问题：没有办法把想法可视化，目前方案做比较脱离实践，可能出现不必要的损失浪费。
- 怎么解决的：使用AI完成先行方案评估与草图绘制
- 采购 / 花费：一些token
- 完成度自评：尚可
- 学习内容：学会用github搭建数据上传通路，以应对文档考核。
- 学习来源：个人
- 明日计划：继续完善该通路，并对前期学习内容进行存档完善

### 2026-09-24 史沐生

- 今日工时：2
- 今日目标：学习机械组的基本知识
- 做了什么：学习了机架的材料与制作的有关知识
- 学习内容：了解了机架的材料，比如铝合金或者碳板拼插。机架的作用是承载轮组以及搭建机架以上的机器人主体。认识到了铝合金主要分为6系和7系，他们的抗拉强度和屈服强度都有所不同，7系的强度更高但焊接难、成本较高，所以我们主要用6系铝合金。
- 学习来源：重庆大学千里战队B站视频
- 明日计划：了解搭建机器人需要用到的各种零部件
- 需要的支持：需要实际的器件操作来支撑理论学习
- 图片（Word 内嵌）：../../docs/images/日报配图/2026-09-24/史沐生-1-04e1e54e.jpg、../../docs/images/日报配图/2026-09-24/史沐生-2-127a1084.jpeg

### 2026-09-25 蔡昌恒

- 今日工时：2
- 关键决定（为什么这样做）：自己对于电脑相关问题知识缺口太大，无法有效完成基本漏洞的检查和修复
- 学习内容：在笔记本上从零布设环境
- 学习来源：哔哩哔哩
- 图片（Word 内嵌）：../../docs/images/日报配图/2026-09-25/蔡昌恒-1-f8bad0c4.jpeg

### 2026-09-29 蔡昌恒

- 今日目标：了解电控基本知识
- 学习内容：电控导论
- 学习来源：哔哩哔哩
- 图片（Word 内嵌）：../../docs/images/日报配图/2026-09-29/蔡昌恒-1-d381a8af.jpeg

### 2026-09-30 喻静琳

- 今日工时：4
- 今日目标：安装fusion360,掌握fusion中草图的创建
- 做了什么：成功下载fusion360面向个人的免费版本，完成5个草图练习
- 遇到的问题：创建草图时耗时过长，草图有些点衔接不上，草图不够美观
- 完成度自评：已完成
- 学习内容：直线，矩形，圆等基本草图命令的认识，练习绘制完整草图
- 学习来源：bilibili2023年最新Fusion360教程
- 明日计划：开始实体命令的学习
- 图片（Word 内嵌）：../../docs/images/日报配图/2026-09-30/喻静琳-1-6c3dd3d7.png、../../docs/images/日报配图/2026-09-30/喻静琳-2-f674d0a7.png、../../docs/images/日报配图/2026-09-30/喻静琳-3-943bd62d.png、../../docs/images/日报配图/2026-09-30/喻静琳-4-6fde72bd.png

### 2026-10-01 喻静琳

- 今日工时：4
- 今日目标：学习实体命令
- 遇到的问题：侧视图线段多且短小，保证线段首尾相接且数据准确才能使用旋转命令，操作过于复杂，耗时太长
- 学习内容：学习拉伸，旋转命令，完成一个微型带轮的实体练习
- 学习来源：bilibili2023年最新Fusion360教程
- 图片（Word 内嵌）：../../docs/images/日报配图/2026-10-01/喻静琳-1-a2c52752.jpeg、../../docs/images/日报配图/2026-10-01/喻静琳-2-2d0029fe.png、../../docs/images/日报配图/2026-10-01/喻静琳-3-07a828c0.png、../../docs/images/日报配图/2026-10-01/喻静琳-4-25ae5066.jpeg

### 2026-10-02 喻静琳

- 今日工时：3.5
- 今日目标：继续实体命令的学习
- 学习内容：扫掠，基准面的构造命令的认识与实体练习
- 学习来源：bilibili2023年最新Fusion360教程
- 图片（Word 内嵌）：../../docs/images/日报配图/2026-10-02/喻静琳-1-b6ab550e.jpeg、../../docs/images/日报配图/2026-10-02/喻静琳-2-7059bb1d.png、../../docs/images/日报配图/2026-10-02/喻静琳-3-3666c64c.jpeg

### 2026-10-03 喻静琳

- 今日工时：3
- 今日目标：完成剩余实体命令的学习
- 学习内容：加强筋，孔，放样，抽壳，圆角实体命令的学习，学会创建三维草图
- 学习来源：bilibili2023年最新Fusion360教程
- 图片（Word 内嵌）：../../docs/images/日报配图/2026-10-03/喻静琳-1-ad9db877.jpeg

### 2026-10-04 蔡昌恒

- 今日工时：3.5
- 今日目标：把一号车的设计定稿成一套图：部件详图、高度链复核、下探底架与打印件
- 做了什么：进行一些一号车的版本更新
- 关键决定（为什么这样做）：原有方案不够完备，现有方案需要结合具体尺寸与组员建议进行新版本更迭
- 设计思路（改前 → 改后）：改前：三档高度表 + 转塔 φ46 + 丝杆 160 + 背部 8 格竖排料仓 + 前开口低仓；改后（V2）：取块头轴线绝对高度体系 + 转塔 φ32 + 丝杆 170 + 2×5 十格托盘（格口朝上）+ 回缩臂 + 刮料唇，立柱底座改为轮间下探底架（离地 10 → 柱顶 200）。
- 为什么改：① 初始高度红线 ≤210，立柱基准不对会到 255；② φ46 在低位作业时盘底离工作面只剩 2 mm（φ32 后 9 mm）；③ 丝杆 160 对一级 130 只剩 10 mm 余量；④ 臂低于板面 100 时后收会撞 40 mm 高的料仓壁。
- 影响与后续动作：底盘板开 34×28 让位槽，打印底座板 60×40×5 与 L 形侧板 ×2；电控增加“臂低于板面 100 mm 禁止后收”的互锁；图纸汇总 V2 共 16 张（两车总图 + 分工 + 详图 1–10 + 高度体系 + 对位误差表 + 手柄映射）。
- 图片（Word 内嵌）：../../docs/images/日报配图/2026-10-04/蔡昌恒-1-f1df20ad.png、../../docs/images/日报配图/2026-10-04/蔡昌恒-2-7d33fbbb.png、../../docs/images/日报配图/2026-10-04/蔡昌恒-3-34462ad7.png、../../docs/images/日报配图/2026-10-04/蔡昌恒-4-e6a2aa99.png、../../docs/images/日报配图/2026-10-04/蔡昌恒-5-f3be184f.png、../../docs/images/日报配图/2026-10-04/蔡昌恒-6-9f44d16f.png、../../docs/images/日报配图/2026-10-04/蔡昌恒-7-ab93c627.png、../../docs/images/日报配图/2026-10-04/蔡昌恒-8-51240b93.png

### 2026-10-04 喻静琳

- 今日工时：4
- 今日目标：开始零件与装配体的学习
- 学习内容：零件的创建方法，装配体各种运动关系的的学习
- 学习来源：bilibili2023年最新Fusion360教程
- 图片（Word 内嵌）：../../docs/images/日报配图/2026-10-04/喻静琳-1-7b4d00de.jpeg、../../docs/images/日报配图/2026-10-04/喻静琳-2-7e177d16.jpeg、../../docs/images/日报配图/2026-10-04/喻静琳-3-3bb3fa44.png、../../docs/images/日报配图/2026-10-04/喻静琳-4-d62abbcb.png、../../docs/images/日报配图/2026-10-04/喻静琳-5-2a51e892.png

### 2026-10-05 蔡昌恒

- 今日工时：6
- 今日目标：今天基本就磨二号车一件事：把它的结构问题一条条挑出来、改到能落地的版本（最后定成 V3），顺便把跟手册 V1.5 有关的规矩也更新掉。
- 做了什么：二号车从“甲方案”改到了 V3 定稿：车顶那个托盘整个取消，改成四个轮子中间的低仓，方块不用再往上抬；铲子那一块大改（能收、能滚上去）；耙钩和舌铲重新分道；最后把全套图都出齐了——整车渲染、M1→M4 分阶段升级、预留位特写、四种取块流程分镜，都整理进“二号车-最终方案-V3”文件夹。另外按手册 V1.5 更新了文档，还拿一份独立复核报告逐条对了一遍账。
- 关键决定（为什么这样做）：今天方案里的几个关键改动：① 拨轮原来压在铲子正上方，方块进来会被挡住，所以我把它改成小号软压轮、挪进口子里面（X≈−13），前面一段全让空；② 翻转耙钩和窄舌铲摆在同一侧，很容易打架，所以我把它们分开走：耙钩放正中间、舌铲挪到右边；③ 铲子太长会挡住洞口和矮墙，所以我给铲板加了“让位”——一开始想的是被墙顶回去的被动式，后来一算检录要求初始长度 ≤290，就改成 SG90 主动推拉、平时全收进去；④ 为了能让方块顺顺当当上去、最好还能再抬一点，我把原来 45° 的短坡换成 13° 的长缓坡加一根 φ6 小滚轮，方块是“滚”上去的，不是硬顶；另外多留了一个“铲唇抬头”的方案 C 备用；⑤ 为了先把二号车定下来、把预留位都留好，我把中央、左道、右道三组一样的安装位都留了出来，方案 C 的铰链位、舵机位也一起留，并全部拍了特写。
- 试过但放弃的做法：① 车顶托盘 + 垂直提升：多一套机构、多两个卡块的地方，放弃；② 纯靠弹簧回缩的铲板：静止时铲板是伸出来的，整车快到 380，检录就过不了，放弃；③ 45° 短坡：方块容易被“顶住”，放弃；④ 两车的采购分账先不分，等二号车完全定稿再统一算。
- 采购 / 花费：二号车这一辆：官方物资表里分给它的部分大约 145 元，外面还要买的大概 100–150 元（60mm 橡胶轮、拉簧、微动开关、钢棒铜套、M3 热熔铜螺母、TPU 这些），合计大约 250–300 元。
- 对应考核指标：指标 8 尺寸规范；指标 11 结构稳定性；指标 12 规划 / 采购
- 完成度自评：🟡 进行中（方案和图纸定稿，等打印件验证）
- 设计思路（改前 → 改后）：V2 是“铲板被动回缩 + 45° 短坡”；V3 改成“铲板舵机推拉（平时全收）+ 13° 缓坡 + φ6 随动辊”，另外把方案 C（铲唇抬头）的铰链位和舵机位先留出来。
- 为什么改：① 检录要求初始长度 ≤290，铲板必须能收进去；② 方块在路上容易顶歪、卡边；③ 先把升级接口留好，免得以后返工。
- 影响与后续动作：所有图和文档都切到 V3；下一步出《M1 打印清单》（要把 φ6 滚轮、轴、两侧支架加进去）；验证还是老三样：同一颗方块连收 20 次、纸板搭 70×70×50 的洞、e1/d8 坡上下 10 次。
- 明日计划：出二号车 M1 的打印清单去下单；做几个纸板验证件（70×70×50 的洞、1:0.5 的坡、150 宽的桥）；电控组把开源说明里的版本号和许可证补上。
- 需要的支持：帮我确认一下二号车的路线：是北上 e8 顺路多拿 3 分，还是只跑 d1；还有 e3 那颗黄块到底用“外面钩”还是“小夹爪”。
- 图片（Word 内嵌）：../../docs/images/日报配图/2026-10-05/蔡昌恒-1-f63f3c6b.png、../../docs/images/日报配图/2026-10-05/蔡昌恒-2-06a4d9b5.png、../../docs/images/日报配图/2026-10-05/蔡昌恒-3-53c8fd49.png

### 2026-10-07 蔡昌恒

- 今日工时：6
- 今日目标：把一号车的新升级（模块化立柱＋多头快换）定稿，并完成两车复核、采购对账和中期考核清单。
- 做了什么：①一号车升级定型：模块化立柱（形态A直段/形态B斜折，拔销换装≤5分钟）＋两侧孔列/加强插孔，分系统3D出齐（整车、立柱、排孔、手臂三档、夹爪、举升）；②抓取头做成"一个快换接口、三种头"——平行夹爪（现役）、弹片内撑＋倒刺、低位耙钩（备用），3D与图纸都出好；③二号车确认回归"PS2手动操作"，同步修正三份正式文档；④采购对账：已购15项逐项核对（¥388.48），出待购清单（必买≈¥166、建议≈¥87）与采购结构表；⑤出《中期考核待完成互证表》50项（对应12项基础功能＋规则测评＋文档评估，含负责人列）。
- 关键决定（为什么这样做）：①立柱改成"上段通用、只换下段"——标定和程序不动，训练用直段、冲分用斜折；②抓取头"一接口多头"——主力夹爪保通用，被动头补断电安全与物资架轴向抽出；③二号车定手动操作——稳定与配合优先，半自动倍率问题列官方答疑。
- 试过但放弃的做法：①托铲头——复核确认方块下面是实心台板，铲不进去，否决；②立柱孔列只做单条→改成左右对称两条＋横撑；③二号车全自动航点——暂缓，降级为可选升级。
- 采购 / 花费：已购¥388.48（15项）核对无误；待购：必买≈¥166、建议/强度升级≈¥87、待确认（无线继电器）¥25；3D打印由实训队免费。
- 对应考核指标：指标 8 尺寸规范；指标 9 方块携带（单一）；指标 10 方块携带（多项）；指标 11 结构稳定性；指标 12 规划 / 采购
- 完成度自评：🟡 进行中（设计与清单定稿，等打印件到手验证）
- 学习内容：快换接口的"定位销＋手拧"组合；中期考核"完成度:规则:文档=4:3:3"与12项基础功能的演示要求。
- 学习来源：《CRTC2026参赛手册》V1.5；团队复核文档
- 设计思路（改前 → 改后）：从"一根直柱＋单一夹爪"改为"上段共用、下段可换（直段/斜折），抓取头统一快换接口（夹爪/弹片/耙钩）"。
- 为什么改：保标定（上段不动）、保两种打法（稳/冲分）、保断电安全（被动头）。
- 影响与后续动作：按新图纸打印；机械先打二号车M1与一号车形态A件；硬件做电池组＋电源树；电控跑"行走＋举升"框架。
- 明日计划：按《中期考核互证表》推进——机械打二号车M1底座与一号车形态A件；电控先跑"行走＋举升"框架；硬件做电池组与电源树。
- 需要的支持：确认官方无线继电器型号（检录会测断电）；跟进半自动得分判定的官方答复。
- 证据：桌面三个文件夹（一号车-最终方案-竖折柱版 / 二号车-最终方案-V3 / 双车复核更新-2026-10-07）
- 图片（Word 内嵌）：../../docs/images/日报配图/2026-10-07/蔡昌恒-1-ce23cc39.png、../../docs/images/日报配图/2026-10-07/蔡昌恒-2-f7c06b91.png、../../docs/images/日报配图/2026-10-07/蔡昌恒-3-c673969f.png、../../docs/images/日报配图/2026-10-07/蔡昌恒-4-f34ef353.png、../../docs/images/日报配图/2026-10-07/蔡昌恒-5-00d43bb3.png

### 2026-10-09 蔡昌恒

- 今日工时：7
- 今日目标：把二号车的洞穴取块头（刺钩）从"转盘式"改成能落地、又能过检录尺寸的"风车摇柄式"，并把整车图、布线、腕折、零件清单一次收口。
- 做了什么：① 刺钩改成"开放版"——3 圈 × 8 根共 24 根独立细针（φ1.6、最长 15、外径 17），一根根分开、不再连成片；② 摇柄从"绕竖轴转"改成"绕车头纵轴转"，从正面看像风车，MG90S 舵机直驱 180°；③ 摇到 180° 后腕部再折 90°，用连杆完成（φ2 推杆 + 30° 斜面挡块 + 复位簧 + 两只 φ3 限位销），旋转关节处 0 根电线；④ 铲唇改成一整块斜面板（104~158，绕 x104/z18 抬起 35°），中间不开任何口；⑤ 底盘后缘 -140→-130；⑥ 出图 24~31 共 8 张，同时把图册 116 张 3D 源图全量重渲染、所有图纸脚本重跑一遍；⑦ 出打印件清单与耗材估算。
- 关键决定（为什么这样做）：① 转盘（绕竖轴）取消——对孔靠车身摆正，机构只保留"放下取块 / 摇起收纳"一个自由度，少一个舵机、少一处卡死点；② 收车位用"摇起 180° + 腕折 90°"，不用"侧摆 45°"（侧摆会让整车 347 超 290）；③ 腕折用连杆不用第二个舵机（旋转关节 0 根线，装配也简单）；④ 铲唇坚持一整块（刺头在坡面上方 ≥5mm 通过，不需要开缺口）。
- 试过但放弃的做法：① 转盘绕竖轴侧摆 45° 让位 → 整车 347 ✗ 超长；② 刺头绕横轴（侧面看像摩天轮）直接摇到车顶 → 高 165 ✗ 过不了 130 的桥；③ 腕折再加一个舵机 → 3 根线要跨 180°+90° 旋转关节，装配难、易磨断；④ 铲唇中间开 24 让位缝 → 按你要求改成一整块。
- 采购 / 花费：新增只 6 样——φ2 钢丝 ×1、φ3×12 拉簧 ×1、φ3 限位销 ×2、φ5×34 光轴 + φ5×φ8 铜套 ×2 套、MG90S ×1；合计约 25~45 元。两车打印耗材合计约 590g（留余量 720g，PETG 1kg + PLA 1kg 够用，材料费 ≈25 元）。
- 对应考核指标：指标 8 尺寸规范；指标 11 结构稳定性；指标 12 规划 / 采购
- 完成度自评：🟡 进行中（机构与图纸定稿，等打印件与手摇连杆实测）
- 设计思路（改前 → 改后）：改前＝转盘绕竖轴旋转 + 竖直臂 + 刺头 90° 折叠 + 铲唇开 24 让位缝；改后＝绕车头纵轴的风车摇柄（MG90S 直驱 180°）+ 连杆腕折 90° + 一体斜铲唇（抬起 35°）。
- 为什么改：① 转盘侧摆会超长、又多一个卡死点；② 铲唇必须一整块、前面只露坡面；③ 关节走线越少越不容易出故障。
- 影响与后续动作：图册 24~31 已全部更新并同步三处；下一步 ① 打印针头/摇臂/挡块做连杆实测；② 重画 19~23 那 5 张旧方案文案；③ 验收三件事：收车位整车 288 复尺、刺头过 15 孔 20 次、收放 20 次不卡。 今天学到一条通用经验：能"机械过关节"的动作就别用电线过关节——连杆/凸轮穿过旋转关节，比在关节处留活动线更耐用；这次腕折 90° 就是这样省掉一个舵机和 3 根线。 图 1 风车式转动四帧：0°取块位 → 60°/120°摇起 → 180°收车位（绕车头纵轴转，正面看像风车） 图 2 装车两姿态：工作位 347×186×93 / 收车位 288×186×129（全方向合规，桥下也过） 图 3 腕折连杆式：φ2 推杆＋30°挡块＋复位簧＋限位销，旋转关节 0 根线 图 4 布线方案：静态线走底盘内+φ8 过线孔；腕折改连杆后关节无电线 图 5 打印件清单与耗材估算：二号车 ≈249g、一号车 ≈339g，合计留余量 ≈720g
- 图片（Word 内嵌）：../../docs/images/日报配图/2026-10-09/蔡昌恒-1-abb6618e.png、../../docs/images/日报配图/2026-10-09/蔡昌恒-2-506fe10e.png、../../docs/images/日报配图/2026-10-09/蔡昌恒-3-57f47da5.png、../../docs/images/日报配图/2026-10-09/蔡昌恒-4-67224ce8.png、../../docs/images/日报配图/2026-10-09/蔡昌恒-5-b096f1bd.png

## 2026-10-09 一号车日报（同日第二份）

- 姓名：蔡昌恒　工时：6　类型：进度
- 今日目标：把一号车的电控自由度讲清楚——每个动力点装在哪、靠什么结构动起来。
- 做了什么：盘清 4 动力点 + 1 检测点；出 32 号（自由度与安装结构）、33 号（三条传动链）、34 号（看图解释）三张图；核对行程 130mm、夹爪指端 6N、臂端 1.1kg。
- 关键决定：肘关节机械三档销钉选位（舵机只微调）；抓取头快换（10×16 板）；打印件只当座和力臂，受力件全买现成。
- 试过但放弃：齿轮齿条夹爪、同步带直提升降、肘关节闭环微调。
- 问题与解决：丝杆与 688ZZ 配合（φ12 插轴承承轴向力）；升降慢（备选 60rpm）；肩肘径向力（φ5 轴+铜套承力）。
- 对应考核指标：9 方块携带；11 结构稳定性；12 规划/采购
- 完成度自评：🟡 进行中（结构定稿，待装配实测）
- 采购/花费：φ5 轴×3 + 铜套×6、KW11×2、2GT-6 闭环带 112 ≈30 元
- 图片（Word 内嵌）：../../docs/images/日报配图/2026-10-09/蔡昌恒-1-60ec623e.png、../../docs/images/日报配图/2026-10-09/蔡昌恒-2-d776920e.png、../../docs/images/日报配图/2026-10-09/蔡昌恒-3-8b2feb07.png

### 2026-10-11 蔡昌恒

- 今日工时：6
- 今日目标：把两车「最终版」与采购口径对齐到同一天；恢复一号车排孔设计；复核取块尺寸后出 10-11 版打包与报告。
- 做了什么：① 取块尺寸复核：一号车夹爪张开修正为 38~40 / 合拢 28~29（原写「15~30」等于方块尺寸，夹不进），对位容差 ±4~5 mm ＞ 机械累计 ±3.3 mm；② 采购口径 5 处修订并同步采买包 9 份文件（二号车轮 60→φ70、KW11×8 恢复必买、新增开口挡圈 φ5×12+φ6×4、SG90 归位「已购」、688ZZ 按 2 只 ¥9.2、MG90S 统一 ¥10.85）；③ 恢复一号车「两侧孔列板」排孔：184×40×4×2 片、y=±34、双排 φ4.05（两排错 5 mm）、对穿 φ4×80 插销，装配第 11 步先装孔列再装臂链；④ 图册重出与清理：一号车 00c/00d/00e/00g~00j/32~34 与 17 号零件图、01 总览（16 件）；二号车 26、31 与 3 张新近景，旧口径图剔除；⑤ 打包「CRTC2026-两车打印与装配包-2026-10-11.zip」（9.2 MB）；⑥ 汇总《双车最终方案报告》（Word，桌面）；⑦ 电控点灯成功：STM32F103C8T6 最小系统板 + USB-TTL 接线正常，LED 闪烁例程跑通。
- 关键决定（为什么这样做）：① 排孔与折叠立柱解绑——折柱取消但孔列保留，它是两侧挂点/加强/防脱接口，与折叠无关；② 孔列不再放回原侧梁位（y≈±39，现被轮子 y≥44 和料仓横档 y±40 占住），改放轮上方 y=±34、z40~80，把对穿孔排到 z76，80 mm 插销可全程对穿；③ 采购逐项按「检索/实测价」统一，避免重复多算（688ZZ、MG90S）。
- 试过但放弃的做法：① 孔列复刻原参数（20 宽单排 @5×40、200 长、装侧梁位）——被轮子和料仓横档挡住，放不下；② 孔列沿用 200 全长——前 8 mm 会撞刮料唇，改为 184。
- 采购 / 花费：本轮无新增硬件：孔列板为打印件（免费），插销用清单 #24 已列 φ4 光轴/R 销。当前口径：已购 ¥388.5 ＋ 必买 ¥172.4 ＋ 建议 ¥72（另待确认 ¥25）。
- 对应考核指标：指标 11 结构稳定性；指标 12 规划 / 现有采购单；指标 9 方块携带（单一）（复核）
- 完成度自评：🟡 进行中（口径定稿，待实车装配与实测）
- 学习内容：任一尺寸或价格改动后，沿「模型→图纸→表格→采购」全链路扫一遍，列出改动影响清单逐个销项；今天靠它揪出一号车图册 6 处、采购表 4 处旧口径残留。
- 学习来源：今日实操总结（与 AI 协作复核流程）
- 设计思路（改前 → 改后）：改前＝孔列板随折叠立柱方案一起被删掉；改后＝按现行竖直立柱车体重建：184×40×4×2 片、y=±34、双排 φ4.05、对穿 φ4×80 插销，装配第 11 步先装孔列再装臂链。
- 为什么改：排孔是独立需求（两侧挂点＋附加插孔增强/防脱），不该随折柱取消；恢复后还能绑电池、加横撑，把车身锁成一体。
- 影响与后续动作：模型/00c/00d/17 号零件图/31/01 总览/00c2 已同步；后续：① 先打两片做试配；② 按第 11 步试装；③ 现场按需用插销固定。
- 明日计划：① 按 34 号顺序试装一号车（重点：丝杆与 688ZZ 配合、滑块旷量 <1 mm）；② 夹 30 方块连测 20 次；③ 采购按 08 图执行——先领用后下单（螺丝/挡圈/弹片）。
- 需要的支持：实验室领用（螺丝、挡圈、弹片、亚克力）；打印排程：两车合计约 740 g、约 12 h。
- 图片（Word 内嵌）：../../docs/images/日报配图/2026-10-11/蔡昌恒-1-001344a8.png、../../docs/images/日报配图/2026-10-11/蔡昌恒-2-a11e0757.png、../../docs/images/日报配图/2026-10-11/蔡昌恒-3-cee36b97.png、../../docs/images/日报配图/2026-10-11/蔡昌恒-4-b7184053.jpg

### 2026-10-10 史沐生

- 今日工时：1
- 今日目标：学习fusion360的基本操作
- 学习内容：学习了如何创建草图，绘制一些平面的图形和立体几何体，在几何体上添加孔洞之类的操作。
- 学习来源：B站
- 明日计划：进一步了解如何构建更复杂和精确的模型，争取能把取块车的基本框架建立起来
- 图片（Word 内嵌）：../../docs/images/日报配图/2026-10-10/史沐生-1-741b8648.jpg

### 2026-10-05 李秉航

- 今日工时：4
- 今日目标：学习基础PLC知识
- 学习内容：《零基础PLC编程从入门到精通》
- 学习来源：书本《零基础PLC编程从入门到精通》
- 明日计划：结合AI进行代码编写
- 图片（Word 内嵌）：../../docs/images/日报配图/2026-10-05/李秉航-1-1ceda53c.jpeg、../../docs/images/日报配图/2026-10-05/李秉航-2-470c7768.jpeg、../../docs/images/日报配图/2026-10-05/李秉航-3-c148fd3c.jpeg

### 2026-09-28 李秉航

- 今日工时：2
- 今日目标：配置环境
- 学习内容：配置ST-link，STM32CudeMX
- 学习来源：B站
- 明日计划：安装Clion
- 图片（Word 内嵌）：../../docs/images/日报配图/2026-09-28/李秉航-1-46bd4360.png

### 2026-09-29 李秉航

- 今日工时：3
- 今日目标：配置环境
- 学习内容：配置Clion,STM32CubeMonitor，STM32CubeProgrammer，STM32CubeCLT
- 学习来源：QQ群所发网站
- 明日计划：学习GPIO
- 图片（Word 内嵌）：../../docs/images/日报配图/2026-09-29/李秉航-1-b380d144.png、../../docs/images/日报配图/2026-09-29/李秉航-2-30b812a8.png、../../docs/images/日报配图/2026-09-29/李秉航-3-215c16c6.png

### 2026-09-30 李秉航

- 今日工时：1
- 今日目标：学习GPIO
- 学习内容：GPIO
- 学习来源：B站
- 明日计划：学习PLC
- 图片（Word 内嵌）：../../docs/images/日报配图/2026-09-30/李秉航-1-0cf1a1bb.png、../../docs/images/日报配图/2026-09-30/李秉航-2-749e51b0.jpeg

### 2026-10-08 李秉航

- 今日工时：4
- 今日目标：确定一号车底盘方案（麦轮 vs 普通橡胶轮），搭好 CLion 工程骨架。
- 做了什么：照方案书 13 号成本图，确认一号车原方案用麦轮。 把麦轮和 60mm 普通橡胶轮做了逐项对比（自由度、抓地、成本、走位难度）。 在 CLion 里用 CubeMX 生成 Clion_test 工程，确认 Core/Inc、Core/Src 目录结构。
- 关键决定（为什么这样做）：决定一号车改用 60mm 普通橡胶轮（差速驱动），放弃麦轮。
- 试过但放弃的做法：试过在代码里保留麦轮逆解函数，只是"把 vy 恒置 0"来兼容两种轮子。放弃原因：多一层抽象，调试时容易搞混，而且麦轮的 4 轮叠加公式对差速车没意义，索性重写成差速版。
- 采购 / 花费：0
- 完成度自评：进行中
- 设计思路（改前 → 改后）：剔除1号车使用麦轮进行原地旋转的可能
- 为什么改：一号车任务核心是"上坡 → 举升 → 夹块 → 回仓"，不需要横向平移；麦轮辊子摩擦小，爬 26.6° 坡（方案书里的坡比 0.5）容易打滑，橡胶轮抓地更好。差速代码也比麦轮逆解简单，调试快。 放弃麦轮的直接代价：失去侧移贴台能力，贴物资架/焦点时要"斜开+原地转正"，走位变慢。方案书里"加 150~250g 后配重下坡余量 ≥30°"的结论对橡胶轮只会更宽松，所以爬坡安全余量反而变大。 1号车走拱桥使用麦轮不方便
- 影响与后续动作：chassis.h需要改
- 明日计划：写 app_chassis.h / app_chassis.c（差速版），在 main.h 里只加 GetTick_ms() 和 Car_SafeStop() 两个全局声明。
- 需要的支持：确认 60mm 橡胶轮 + TT 轴联轴器的具体型号，避免下单后装不上。
- 图片（Word 内嵌）：../../docs/images/日报配图/2026-10-08/李秉航-1-e48bd297.png

### 2026-10-12 杨佳琳

- 今日工时：1.5h
- 学习内容：1，确定了1,2车板子上面都需要放置什么 2，STM上面没显示PA13,PA14，该如何接线？ 上面标注的引脚名字不全，有隐藏引脚，PA13,PA14对应的是34,37号引脚，将ST_Link的四个接线头插入3.3V,END,PA13,PA14即可烧录 3，弯曲排针和正常排针的区别：弯曲排针向上弯90度，再考虑到板子位置大小和放置方向是可能会考虑，我们就用正常的就可以了
- 学习来源：豆包，deepseek，嘉立创
- 明日计划：画完两个板子

### 2026-10-13 史沐生

- 今日工时：2
- 今日目标：用fusion360完成松针取块头的绘制，并评估是否能进行3D打印
- 做了什么：用一个简单的圆柱体，将它的表面上手动插入一些细铁丝，代替原来用3D打印制作的松针取块头
- 关键决定（为什么这样做）：因为这样做能够保证取块头上面的松针的强度，保证他在拖拽能量单元时不会脱落，且这样能够简化3D打印时的操作，保证零件的质量。
- 试过但放弃的做法：尝试直接绘制表面带有松针的取块头的3D图像并进行3D打印，但由于针体太细，无法保证打印质量，因此只能放弃这个方案。

### 2026-10-13 蔡昌恒

- 今日工时：2
- 做了什么：进行马达输出的检验

### 2026-10-13 杨佳琳

- 今日工时：2h
- 学习内容：改进，打印一号车的PCB
- 学习来源：豆包，deepseek，嘉立创
- 明日计划：画完两个板子
- 图片（Word 内嵌）：../../docs/images/日报配图/2026-10-13/杨佳琳-1-dbcfa02d.png、../../docs/images/日报配图/2026-10-13/杨佳琳-2-a44acbcc.png

### 2026-10-14 史沐生

- 今日工时：1
- 今日目标：了解预检录和中期考核的相关信息
- 学习内容：中期考核的规则，如结构基础功能中的：稳定如何测试、能携带方块等。规则考核的方式以及进阶功能
- 学习来源：2026CRTC参赛手册V1.5
- 明日计划：对部分零件的结构进行修改，并尽快完成小车的组装以及调试
- 图片（Word 内嵌）：../../docs/images/日报配图/2026-10-14/史沐生-1-69d4ed87.jpeg

### 2026-10-15 史沐生

- 今日工时：1
- 今日目标：了解如何将零部件拼装成完整的机器人
- 学习内容：学习机器人各个零部件如何拼装在一起
- 学习来源：队长给出的文档中的拼装步骤
- 明日计划：对部分零件的结构进行修改，并尽快完成小车的组装以及调试
- 图片（Word 内嵌）：../../docs/images/日报配图/2026-10-15/史沐生-1-75df0be8.png

### 2026-10-14 蔡昌恒

- 今日工时：4
- 做了什么：焊接了电机驱动模块，并进一步排查出问题
- 关键决定（为什么这样做）：昨天的gnd与vm之间电压只有0.12V，所以焊接
- 图片（Word 内嵌）：../../docs/images/日报配图/2026-10-14/蔡昌恒-1-22c959fd.jpeg、../../docs/images/日报配图/2026-10-14/蔡昌恒-2-d0a3bb9c.jpeg、../../docs/images/日报配图/2026-10-14/蔡昌恒-3-a9939be7.jpeg

### 2026-10-15 蔡昌恒

- 今日工时：6
- 做了什么：接入了控制手柄，并用另一种接线方式来确保接线正常。直接把母头链接到引脚上，虽然整个工作台好像盘丝洞一样。。。
- 关键决定（为什么这样做）：为了消除接线接触不良的影响。
- 学习来源：千里线下培训
- 图片（Word 内嵌）：../../docs/images/日报配图/2026-10-15/蔡昌恒-1-12368354.jpeg、../../docs/images/日报配图/2026-10-15/蔡昌恒-2-31ec7b64.jpeg、../../docs/images/日报配图/2026-10-15/蔡昌恒-3-a12a8824.jpeg
