AFlyingPiglet/shangjianyinqing/team/队务记录.md

# 队务与事务记录（队内工作区）

> 记录比赛组织与事务性工作：会议、报名与赛务沟通、仓库与文档、采购与报销。
> 结构：按板块分（会议与培训 / 队务 / 财务 / 采购 / 其他），条目按日期从早到晚。
> 说明：进度、学习、设计另有专门文档，这里只放"事务"。

## 会议与培训

### 2026-09-28 第一次组会（立项）

- 记录人：蔡昌恒
- 事务分类：会议与培训
- 内容：确定两车分工（1 号车抢分 / 2 号车捡量）、确定文档与日报流程、发放《想法征集问卷》

<!-- 追加位置 -->

### 2026-10-07 完成采购对账（¥388.48）并出待购清单；把"…

- 记录人：蔡昌恒
- 事务分类：会议与培训
- 完成采购对账（¥388.48）并出待购清单；把"半自动判定"列入官方答疑项。
- 采购 / 花费：已购¥388.48（15项）核对无误；待购：必买≈¥166、建议/强度升级≈¥87、待确认（无线继电器）¥25；3D打印由实训队免费。

### 2026-10-11 线下会议：商讨后期具体操作

- 记录人：蔡昌恒
- 事务分类：会议与培训
- 开展线下会议，商讨后期具体操作；场地：沙坪坝龙湖金沙天街（预约时段 2026-10-11 09:30–11:30，共 2 小时）。

**相关文件：**

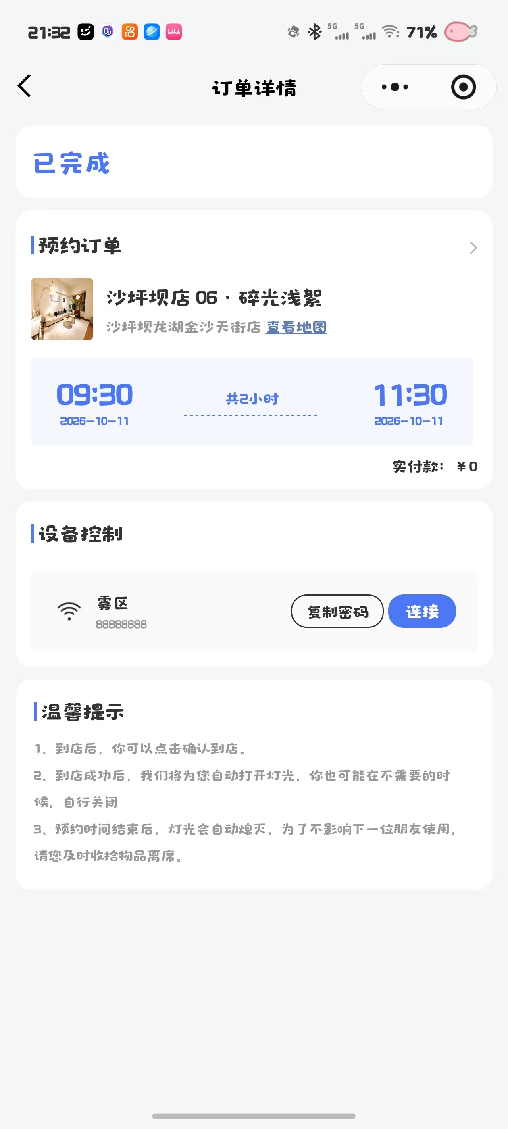
[picture p112: docs/images/日报配图/2026-10-11/2026-10-11-线下会议场地预约.jpg]
2026-10-11-线下会议场地预约

## 队务

### 2026-09-28 报名与仓库搭建

- 记录人：蔡昌恒
- 事务分类：队务
- 内容：完成 CRTC2026 报名（新生组）；建立 GitHub 文档仓库 `shangjianyinqing`；搭建"日报 → 文档"流水线

<!-- 追加位置 -->

### 2026-10-05 把手册 V1.5 的变更写进了文档，新加了两篇（…

- 记录人：蔡昌恒
- 事务分类：队务
- 把手册 V1.5 的变更写进了文档，新加了两篇（开源项目说明、独立复核对账）；实训分组也定了：千里战队。
- 采购 / 花费：二号车这一辆：官方物资表里分给它的部分大约 145 元，外面还要买的大概 100–150 元（60mm 橡胶轮、拉簧、微动开关、钢棒铜套、M3 热熔铜螺母、TPU 这些），合计大约 250–300 元。
## 财务

<!-- 追加位置 -->
## 采购

<!-- 追加位置 -->

### 2026-10-01 与队长商讨后确定了需要购买的物资及其数量，按照官…

- 记录人：喻静琳
- 事务分类：采购
- 与队长商讨后确定了需要购买的物资及其数量，按照官方物资表下单了两辆车的配件（小车底板，小车用轮待定）

**相关文件：**

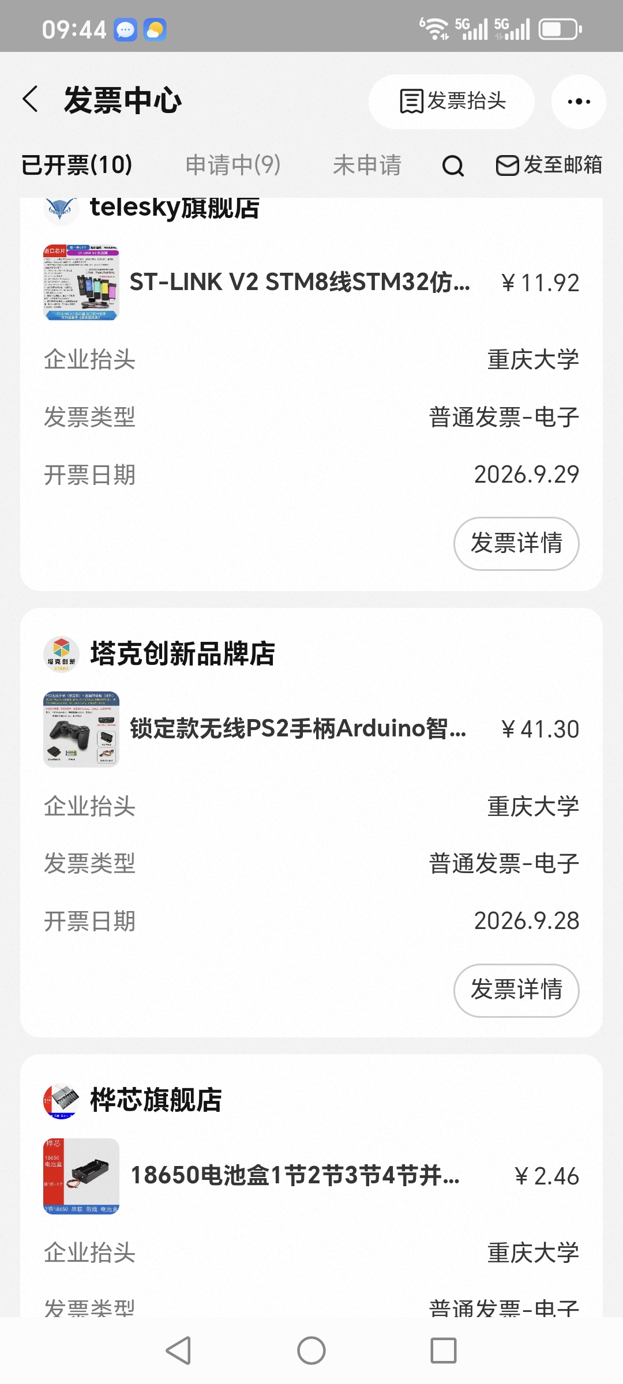
[picture p113: docs/images/日报配图/2026-10-01/喻静琳-4-25ae5066.jpeg]
喻静琳-4-25ae5066


### 2026-10-02 与参加过该比赛的学长交流，与队长商讨后，确定了易…

- 记录人：喻静琳
- 事务分类：采购
- 与参加过该比赛的学长交流，与队长商讨后，确定了易损元件，对驱动板等进行加购作为备份

**相关文件：**

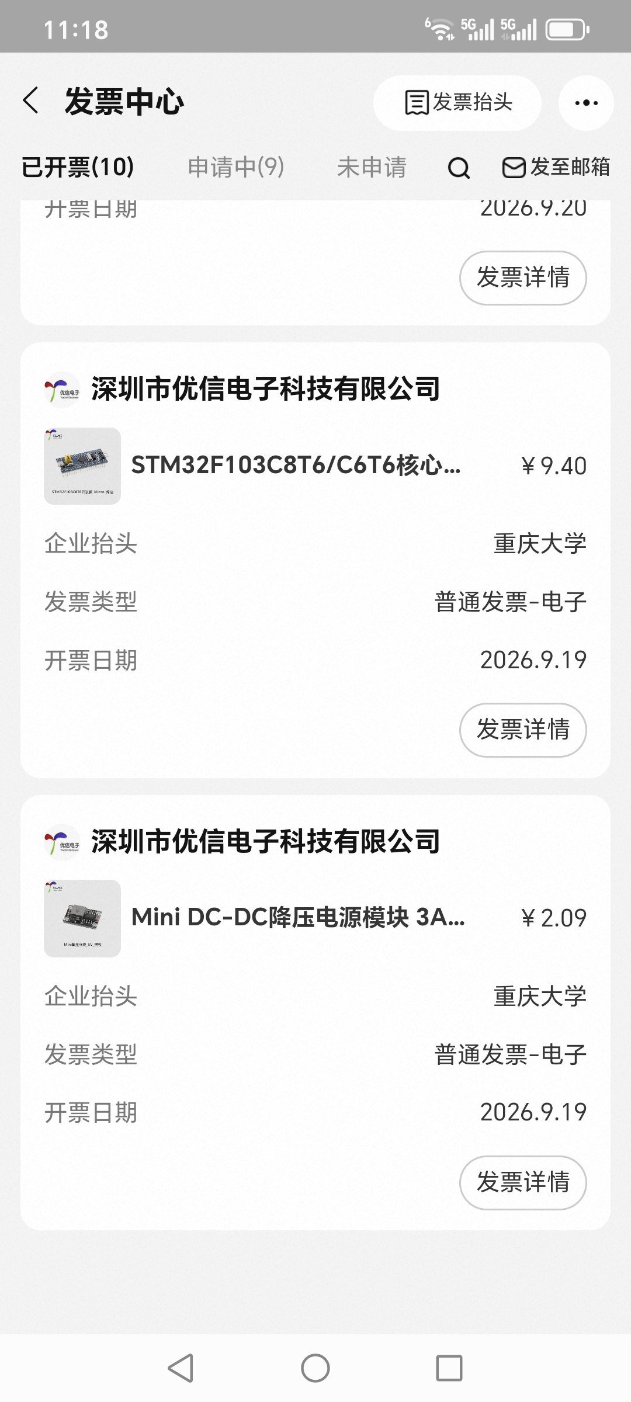
[picture p114: docs/images/日报配图/2026-10-02/喻静琳-3-3666c64c.jpeg]
喻静琳-3-3666c64c


### 2026-10-11 ① 采购口径修订同步到采买包 9 份文件（07 …

- 记录人：蔡昌恒
- 事务分类：采购
- ① 采购口径修订同步到采买包 9 份文件（07 总表 Excel、07b/02 CSV、08 图版、09 复核图、10 待购清单、03 话术、00 说明、14 分工表）；② 两车图册重出并打包 10-11 版 zip；③ 旧版 zip 移入「97-旧版存档」。
- 采购 / 花费：本轮无新增硬件：孔列板为打印件（免费），插销用清单 #24 已列 φ4 光轴/R 销。当前口径：已购 ¥388.5 ＋ 必买 ¥172.4 ＋ 建议 ¥72（另待确认 ¥25）。

**相关文件：**

蔡昌恒-3-cee36b97
## 其他

<!-- 追加位置 -->
