AFlyingPiglet/shangjianyinqing/team/00-总进度看板.md

# CRTC2026 总进度看板（队内工作区，不属于提交文档）

> 队伍：**熵减引擎战队**（新生组）　队长：蔡昌恒　队员：史沐生、喻静琳、李秉航、杨佳琳
> 报名状态：**✅ 已提交**（2026-09-28）
> 最后更新：2026-09-28（每周日例会更新一次，重大进展随时更新）
> 规则：**本页只放「谁在做、做到哪、证据在哪」**；具体过程写进 `docs/` 里的功能文档和个人页。

## 一、里程碑

| 日期 | 事件 | 状态 | 负责人 |
|---|---|---|---|
| 9 月 30 日 | 报名截止 | ✅ 已完成（9/28 提交） | 蔡昌恒 |
| 10 月 1–5 日 | 填实训分组志愿 | ☐ 未开始 | 蔡昌恒 |
| 10 月 6–12 日 | 统一培训（机械 3 课时 / 电控 4 课时） | ☐ 未开始 | 全队 |
| **10 月 19 日 24:00** | **中期考核材料提交** | ☐ 未开始 | 蔡昌恒 |
| 10 月 24、25 日 | 瑞士轮晋级赛 | ☐ 未开始 | 全队 |
| 10 月 31 日 | 车轮战淘汰赛 | ☐ 未开始 | 全队 |

## 二、分工总表（人 → 工作流）

| 成员 | 角色 | 负责工作流 | 个人页 |
| --- | --- | --- | --- |
| **蔡昌恒** | 队长 + 电控 | 报名与赛务、文档统管、1 号车电控、麦轮运动学 | [01-蔡昌恒](成员/01-蔡昌恒-队长-电控.md) |
| **史沐生** | 机械（1 号车） | 1 号车整车结构、举升臂、三种取块头 | [02-史沐生](成员/02-史沐生-机械.md) |
| **喻静琳** | 机械（2 号车）｜兼采买 | 主职：2 号车底盘/铲唇/料仓；兼任：物资比价、下单、到货验收 | [03-喻静琳](成员/03-喻静琳-机械.md) |
| **李秉航** | 电控 + 自动控制（2 号车） | 2 号车电控、航点程序、里程计与传感器 | [04-李秉航](成员/04-李秉航-电控-自动控制.md) |
| **杨佳琳** | 硬件｜兼财务 | 主职：电源链路、接线焊接、无线继电器；兼任：报销台账、发票、预算跟踪 | [05-杨佳琳](成员/05-杨佳琳-硬件.md) |

## 三、中期考核的 12 项基础功能（手册要求，供对照检查）

1. 外形展示（至少一台完整机器人，绕车一周）
2. 电机运动·单一
3. 电机运动·全部（不少于 4 个电机）
4. 舵机运动·单一
5. 舵机运动·多项（不少于 3 个舵机，且可动机构能在任意非初始状态保持静止）
6. 底盘运动·单一（PS2 手柄控制）
7. 底盘运动·全部（PS2 手柄控制全部车体）
8. 尺寸规范（拍到直尺测量的结果）
9. 方块携带·单一
10. 方块携带·多项
11. 结构稳定性（180 mm 自由落体不掉件）
12. 规划与现有采购单（核心部件选型 + 整机成本预算）
