AFlyingPiglet/shangjianyinqing/docs/05-2号车-自动控制.md

# 2 号车 · 自动控制

## 自动运行路线与航点

### 目标

无人操作，在 5 分钟一局内完成固定路线收块：a1 → e1 坡道 → d1 台阶 → h1 角落 → f4 桥下 → 返回 a1。

### 方案对比（为什么这样选）

| 方案 | 优点 | 缺点 | 结论 |
|---|---|---|---|
| 遥控操作 | 灵活 | 一队只有两名操作手名额，且 2 号车定位是"刷量" | 放弃 |
| **固定航点 + 传感器纠偏** | 路线固定、可反复练习、全自动白块 ×2 | 需要稳定的定位手段 | **采用** |

### 开发历程（从早到晚）

**2026-09-28 路线定型**：每个点位动作统一为"直行到位 → 停车 → 拨轮转 2 秒 → 继续"；中途不跨越中央隔离带。

<!-- 追加位置 -->

### 验证结果

（待补：完整航点表——坐标、朝向、动作、预计耗时；总时长需 < 5 分钟）

### 下一步

- 写出航点表并做单点往返测试

## 定位与纠偏

### 目标

让车在 2.4 m × 2.4 m 场地内跑完全程不迷路。

### 方案对比（为什么这样选）

| 方案 | 优点 | 缺点 | 结论 |
|---|---|---|---|
| 纯里程计（编码器） | 不需要额外器件 | 误差累积，跑两轮就偏 | 作为基础 |
| **里程计 + 灰度认胶带标记** | 有绝对位置校正点 | 需要布置标记、调阈值 | **采用** |
| 视觉识别 | 精度最高 | 门槛高、时间成本大，手册也不强制 | 放弃（备选） |

### 开发历程（从早到晚）

**2026-09-28 方案确定**：里程计 + 灰度认胶带标记做绝对定位校正 + 红外避障做兜底重试。

<!-- 追加位置 -->

### 验证结果

（待补：灰度阈值实测、标记布置图、纠偏前后的误差对比）

### 下一步

- 调灰度阈值，测试连续 3 个点位不跑偏

## 电源与控制链路

### 目标

与 1 号车共用同一套电源规范（18650 2S、单供电模块、官方无线继电器）。

### 方案对比（为什么这样选）

（待补：4 个 DRV8833 独立驱动 vs 双路驱动桥的对比）

### 开发历程（从早到晚）

**2026-09-28 链路确定**：18650 2S → 官方无线继电器 → 分电板 → DRV8833 ×4（每个 TT 马达一路）/ 5 V 降压 → 传感器与主控。

<!-- 追加位置 -->

### 验证结果

（待补：接线图、任务调度（主循环或 FreeRTOS）、异常处理策略）

### 下一步

- 与杨佳琳确认接线方案

## 合规确认与传感器选型

### 目标

确认灰度/红外传感器在规则上可用，并选定型号数量交给采买。

### 方案对比（为什么这样选）

| 组别 | 规则 | 影响 |
|---|---|---|
| 非新生组 | 除紧固件/胶粘剂外，只能用官方物资表物资 + 自制 PCB + 3D 打印件 | 表内**没有**灰度/红外传感器，方案不可行 |
| **新生组（本队）** | 官方物资表为推荐清单，可自行购买表外物资（仍需符合赛事规则） | **方案可行** |

### 开发历程（从早到晚）

**2026-09-28 合规确认**：本队为新生组，允许使用官方物资表以外的物资 → 灰度循迹 + 红外避障方案通过；下一步确定型号与数量，交喻静琳采购。

<!-- 追加位置 -->

### 验证结果

（待补：传感器型号、数量、单价；实测识别率）

### 下一步

- 出传感器清单 → 喻静琳下单
