AFlyingPiglet/shangjianyinqing/docs/08-学习笔记.md

# 学习笔记

> 手册要求把"学习到的知识内容"也以日志形式记录下来，本文就是这部分。
> 结构：每个知识板块一个 H2，标题下面按日期从早到晚追加学习记录。

## 机械

<!-- 追加位置：格式如下
### 2026-10-07 Fusion360 草图约束
- 学习人：史沐生
- 来源：统一培训 机械第 1 课时
- 学了什么：……
- 易踩的坑 / 重点：……
- 怎么用到我们的车上：……
-->

## 电控与硬件

<!-- 追加位置 -->

## 算法与编程

<!-- 追加位置 -->

## 工具与软件

<!-- 追加位置 -->

## 规则与赛务

**2026-09-28 手册通读（全队）**

- 学习人：全队
- 来源：《2026 CRTC 参赛手册 V1.4》
- 学了什么：比赛日程、检录硬指标（尺寸/重量/电源/无线继电器）、得分规则（白块 1 分、黄块 4 分，全自动有倍率）、中期考核三部分占比
- 易踩的坑 / 重点：报名 9/30 截止；未通过中期考核不予报销；只能使用一种无线通讯方式
- 怎么用到我们的车上：据此确定两车方案与预算上限，详见 `01`~`06` 各篇

## 其他

<!-- 追加位置 -->
