AFlyingPiglet/shangjianyinqing/team/成员/00-模板.md

# （姓名） · 进度页（队内，不属于提交文档）

- 角色：
- 负责模块：
- 本周时间投入：约 __ 小时

## 进度记录（**按时间从早到晚**，新的一条加在最下面）

### 2026-10-__ 标题

- 做了什么：
- 遇到什么问题：
- 怎么解决的 / 试过哪些不行：
- 证据：`![](../../docs/images/2026-10-__-说明.jpg)`
- 耗时：__ 小时
