AFlyingPiglet/shangjianyinqing/team/成员/_旧版/00-总进度看板-旧位置.md

# CRTC2026 总进度看板

> 队伍：**熵减引擎战队**（新生组）　队长：蔡昌恒　队员：史沐生、喻静琳、李秉航、杨佳琳
> 报名状态：**✅ 已提交**（2026-09-28）
> 最后更新：2026-09-28（每周日例会更新一次，重大进展随时更新）
> 规则：**本页只放「谁在做、做到哪、证据在哪」**；具体过程写进对应功能文档和个人页。

## 一、里程碑

| 日期 | 事件 | 状态 | 负责人 |
|---|---|---|---|
| 9 月 30 日 | 报名截止 | ✅ 已完成（9/28 提交） | 蔡昌恒 |
| 10 月 1–5 日 | 填实训分组志愿 | ☐ 未开始 | 蔡昌恒 |
| 10 月 6–12 日 | 统一培训（机械 3 课时 / 电控 4 课时） | ☐ 未开始 | 全队 |
| **10 月 19 日 24:00** | **中期考核材料提交** | ☐ 未开始 | 蔡昌恒 |
| 10 月 24、25 日 | 瑞士轮晋级赛 | ☐ 未开始 | 全队 |
| 10 月 31 日 | 车轮战淘汰赛 | ☐ 未开始 | 全队 |

## 二、分工总表（人 → 工作流）

| 成员 | 角色 | 负责工作流 | 本周重点 | 状态 | 个人页 |
|---|---|---|---|---|---|
| **蔡昌恒** | 队长 + 电控 | 报名与赛务、文档统管、1 号车电控、麦轮运动学 | 9/30 前完成报名；最小系统点亮 | 🔴 紧急 | [01-蔡昌恒](成员/01-蔡昌恒-队长-电控.md) |
| **史沐生** | 机械 | 1 号车整车结构、举升臂、三种取块头 | 车宽 160→150 mm 方案对比 | ☐ 未开始 | [02-史沐生](成员/02-史沐生-机械.md) |
| **喻静琳** | 机械 | 2 号车底盘、铲唇拨轮、料仓 | 底盘方案 + 铲唇角度试验计划 | ☐ 未开始 | [03-喻静琳](成员/03-喻静琳-机械.md) |
| **李秉航** | 电控 + 自动控制 | 2 号车电控、航点程序、里程计与传感器 | 航点表 + 传感器合规确认 | ☐ 未开始 | [04-李秉航](成员/04-李秉航-电控-自动控制.md) |
| **杨佳琳** | 硬件 + 后勤 | 电源链路、接线焊接、采购与报销 | 电源链路图 + 采购清单核对 | ☐ 未开始 | [05-杨佳琳](成员/05-杨佳琳-硬件-后勤.md) |

## 三、任务清单（按工作流）

### A. 报名与对外（蔡昌恒）

- [ ] 9 月 30 日前提交报名表（飞书链接在手册第 3 页）
- [ ] 加赛事 QQ 群：1038032005
- [ ] 确认本队属于**新生组**还是**非新生组**（决定物资规则）
- [ ] 确定队名（格式「XX 战队」，≤12 个字符）
- [ ] 10 月 1–5 日填实训分组志愿

### B. 1 号车机械（史沐生）

- [ ] 整车 3D 建模（240×160×200，含举升臂、料仓）
- [ ] 决定车宽方案：压到 ≤150 mm 过桥 / 或放弃过桥
- [ ] 举升机构（行程 260 mm，上下限位）出图并打样
- [ ] 内钩头、矮墙槽撑爪、洞穴耙钩三种取块头出图
- [ ] 结构强度：180 mm 自由落体不掉件

### C. 2 号车机械（喻静琳）

- [ ] 差速底盘方案（4×TT，轴距 146 mm，车宽 170 mm）
- [ ] 铲唇 + 拨轮 + 单向门 + 10 格料仓出图
- [ ] 铲唇离地间隙 3–5 mm 的试验方案
- [ ] 是否压低整车到 130 mm 以内的结构评估

### D. 电控与自动控制（蔡昌恒 + 李秉航）

- [ ] 电源链路：18650 2S + 官方无线继电器 + 分电板（蔡昌恒）
- [ ] 1 号车：4 个 TT 马达 + DRV8833 ×2 + PS2 手柄（蔡昌恒）
- [ ] 1 号车：麦轮运动学标定（直行 / 横移 / 斜行 / 自转）（蔡昌恒）
- [ ] 1 号车：MG995 举升 + SG90 翻盖行程与限位（蔡昌恒）
- [ ] 2 号车：电控框架与电机驱动（李秉航）
- [ ] 2 号车：航点表定稿（a1 → e1/d1 → h1 → f4 → a1）（李秉航）
- [ ] 2 号车：里程计 + 灰度纠偏 + 红外避障调参（李秉航）
- [ ] 传感器合规确认（灰度/红外不在官方物资表内）（李秉航）

### E. 硬件与后勤（杨佳琳）

- [ ] 电源链路实物接线与焊接
- [ ] 无线继电器断电功能验证（10 m 遥控断电，检录必查）
- [ ] 按官方物资表下单并核对到货（¥353.48 + 自购 18650 电池）
- [ ] 建立报销台账（发票收集，上限 400 元）
- [ ] 整理工具清单（螺丝刀、烙铁、万用表等）

### F. 文档与证据（蔡昌恒统管，各人写自己的部分）

- [ ] 建 Gitee/GitHub 仓库（队名拼音，公开，`docs/` 在根目录）
- [ ] 每次调试拍照/录视频，素材放 `docs/images/`
- [ ] 每周日更新总看板 + 各自更新个人页
- [ ] 中期考核 12 项指标逐项存证据（见下表）
- [ ] 10 月 19 日前打包视频 zip 并发邮件

## 四、12 项考核指标 × 负责人 × 证据

| # | 指标 | 负责人 | 状态 | 证据（照片/视频） |
|---|---|---|---|---|
| 1 | 外形展示（绕车一周） | 史沐生 | ☐ | |
| 2 | 电机运动·单一 | 蔡昌恒 | ☐ | |
| 3 | 电机运动·全部（≥4） | 蔡昌恒 | ☐ | |
| 4 | 舵机运动·单一 | 蔡昌恒 | ☐ | |
| 5 | 舵机运动·多项（≥3 + 任意位置保持） | 蔡昌恒 | ☐ | |
| 6 | 底盘运动·单一（PS2 + 同框） | 蔡昌恒 | ☐ | |
| 7 | 底盘运动·全部（PS2） | 蔡昌恒 | ☐ | |
| 8 | 尺寸规范（直尺测量入镜） | 史沐生 | ☐ | |
| 9 | 方块携带·单一 | 史沐生 + 蔡昌恒 | ☐ | |
| 10 | 方块携带·多项 | 史沐生 + 蔡昌恒 | ☐ | |
| 11 | 结构稳定性（180 mm 落体） | 喻静琳 | ☐ | |
| 12 | 规划与采购单（选型 + 预算） | 杨佳琳 | ☐ | |

## 五、完成度统计

| 板块 | 负责人 | 进度 | 说明 |
|---|---|---|---|
| 报名与资格 | 蔡昌恒 | ✅ 已完成 | 9/28 提交，新生组 |
| 1 号车机械 | 史沐生 | ☐ 未开始 | |
| 1 号车电控 | 蔡昌恒 | ☐ 未开始 | |
| 2 号车机械 | 喻静琳 | ☐ 未开始 | |
| 2 号车电控与自动控制 | 李秉航 | ☐ 未开始 | |
| 硬件与后勤 | 杨佳琳 | ☐ 未开始 | |
| 文档与证据 | 蔡昌恒 | 🟡 进行中 | 骨架已建好 |

> 更新方式：每周日例会时，每人先更新自己的页面，再由队长把上面的状态和勾选框同步一遍。
