AFlyingPiglet/shangjianyinqing/team/成员/_旧版/01-蔡昌恒-队长-电控.md

# 蔡昌恒 · 队长 + 电控 · 进度页

- 角色：队长（报名、赛务、统筹、文档统管）+ 1 号车电控
- 负责模块：报名与赛务、总进度看板同步、1 号车电控（主控/驱动/PS2/舵机/麦轮运动学）
- 本周时间投入：约 __ 小时

## 本周目标（9/28–10/5）

1. ~~9 月 30 日前完成报名~~ ✅ 已提交（9/28）
2. ~~确认本队组别~~ ✅ 新生组 → **允许使用官方物资表以外的物资**（2 号车传感器方案可行）
3. 建仓库（队名拼音，公开）并把文档推上去

## 进度记录（最新的写在最上面）

### 2026-09-28 立项与文档体系

- 做了什么：读完 V1.4 手册；确定两车方案；搭好文档与进度体系；录入全队分工
- 关键结论：报名 9/30 截止；中期考核 10/19 24:00 截止；1 号车 160 mm 车宽过 150 mm 桥面存疑
- 证据：[总进度看板](../00-总进度看板.md)

## 下周计划

1. 组织第一次例会，确认报名与组别
2. 10 月 1–5 日填实训分组志愿
3. STM32 最小系统点亮（对应考核指标 2）
4. 建仓库：建议仓库名 `shangjianyinqing`（熵减引擎的拼音）

## 需要的支持

- 队伍名称（要符合格式）、队员学号信息（报名用）
