AFlyingPiglet/shangjianyinqing/team/成员/_旧版/02-史沐生-机械.md

# 史沐生 · 机械（1 号车） · 进度页

- 角色：机械设计（结构与 3D 建模）
- 负责模块：1 号车整车结构、举升机构、三种取块头、料仓
- 本周时间投入：约 __ 小时

## 本周目标

1. 出三版"车宽 160 → 150 mm"方案并对比（压窄 / 改路线 / 折中）
2. 熟悉 Fusion360 基础操作（统一培训 10/6–12 第 1 课时）

## 进度记录（最新的写在最上面）

### 2026-09-28 现有方案基线

- 1 号车：240×160×200 mm，约 1.1 kg，麦轮 + 举升臂（行程 260 mm）+ 4 格料仓
- 取块头三种：内钩头（面开孔插入后卡住）、矮墙槽顶部内撑爪、低位耙钩（洞穴）
- 待解决：车宽 160 mm vs 桥面 150 mm（负余量）；麦轮 26.6° 坡打滑
- 证据：上一轮设计图 `2026-09-28\wo\outputs\CRTC2026-1号车设计图.png`

## 下周计划

1. 车宽方案对比表（含改动量、重量、可行性）
2. 举升机构草图（齿条或连杆，行程 260 mm，上下限位开关位置）

## 需要的支持

- 卡尺、螺丝刀套装；3D 打印规范（等 GSing 战队发布）
