AFlyingPiglet/shangjianyinqing/team/成员/_旧版/02-机械.md

# （姓名） · 机械 · 进度页

- 角色：机械设计（结构 / 3D 建模 / 装配）
- 负责模块：1 号车整车结构、举升机构、料仓；2 号车底盘与铲唇机构

## 本周目标

1. 1 号车整车方案定稿，**先解决车宽 160 → 150 mm 的问题**
2. 学会 Fusion360 基础操作（统一培训 10/6–12 第 1 课时）

## 进度记录

### 2026-09-28 现有方案基线

- 1 号车：240×160×200 mm，约 1.1 kg，麦轮 + 举升臂 + 4 格料仓
- 2 号车：260×170×180 mm，约 0.9 kg，四轮差速 + 铲唇拨轮
- 待解决问题：1 号车 160 mm 宽 vs 桥面 150 mm
- 证据：上一轮设计图（旧目录 `2026-09-28\wo\outputs\CRTC2026-1号车设计图.png`）

## 下周计划

1. 出三版车宽方案（压窄 / 改路线 / 折中）并对比
2. 列出 3D 打印零件清单（等 GSing 战队发布打印规范）

## 需要的支持

-
