AFlyingPiglet/shangjianyinqing/team/成员/_旧版/03-喻静琳-机械.md

# 喻静琳 · 机械（2 号车） · 进度页

- 角色：机械设计（结构与 3D 建模）
- 负责模块：2 号车底盘、铲唇 + 拨轮 + 单向门 + 料仓、结构强度
- 本周时间投入：约 __ 小时

## 本周目标

1. 2 号车底盘方案定稿（4×TT 差速，260×170×180 mm，轴距 146 mm）
2. 设计铲唇角度试验（3° vs 5°，离地 3–5 mm）与料仓单向门

## 进度记录（最新的写在最上面）

### 2026-09-28 现有方案基线

- 2 号车：260×170×180 mm，约 0.9 kg，四轮差速，铲唇 + 拨轮 + 单向门 + 10 格料仓
- 关键取舍：整车高 180 mm 钻不过净高 130 mm 的桥下空间；压低到 ≤130 mm 可多拿 2 颗白块（+4 分）
- 证据：上一轮设计图 `2026-09-28\wo\outputs\CRTC2026-2号车设计图.png`

## 下周计划

1. 底盘装配草图 + 料仓剖视图
2. 结构强度方案（对应 180 mm 自由落体不掉件的考核指标）

## 需要的支持

- 3D 打印资源；卡尺
