AFlyingPiglet/shangjianyinqing/team/成员/_旧版/03-电控.md

# （姓名） · 电控 · 进度页

- 角色：电控 / 硬件
- 负责模块：电源链路、STM32 主控、电机驱动、PS2 遥控、舵机控制、麦轮运动学

## 本周目标

1. STM32F103C8T6 + STLink 点亮，跑通第一个 GPIO/PWM 程序
2. 确认电源链路：18650 2S → 无线继电器 → 分电板 → DRV8833 / 5V 降压

## 进度记录

### 2026-09-28 方案基线

- 主控：STM32F103C8T6；驱动：DRV8833 ×2（1 号车）/ ×4（2 号车）
- 遥控：官方 PS2 手柄（2.4G），全队只用这一种通讯方式
- 舵机：MG995 ×2（举升/钩头）、SG90 ×2（翻盖等）
- 证据：待补

## 下周计划

1. 最小系统 + 单个电机转动（对应考核指标 2）
2. 4 个电机同时转动（对应指标 3）

## 需要的支持

-
