AFlyingPiglet/shangjianyinqing/team/成员/_旧版/04-李秉航-电控-自动控制.md

# 李秉航 · 电控 + 自动控制（2 号车） · 进度页

- 角色：电控 / 自动控制
- 负责模块：2 号车电机驱动、航点程序、里程计与传感器纠偏
- 本周时间投入：约 __ 小时

## 本周目标

1. 航点表定稿：a1 → e1 坡道 → d1 台阶 → h1 角落 → f4 桥下 → 回 a1（总时长控制在 5 分钟内）
2. ~~传感器合规确认~~ ✅ 已确认：本队为**新生组**，允许使用官方物资表以外的物资，灰度/红外方案可行（仍需符合赛事规则）

## 进度记录（最新的写在最上面）

### 2026-09-28 自动路线基线

- 每个点位动作统一：直行到位 → 停车 → 拨轮转 2 秒 → 继续
- 纠偏：里程计 + 灰度认胶带标记 + 红外避障
- 待定：是否压低车高到 130 mm 以内（决定能不能钻桥下多拿 2 颗白块）
- 证据：待补

## 下周计划

1. 写航点表（坐标、朝向、动作、预计耗时）
2. 传感器选型：灰度（循迹/定位）+ 红外（避障），列型号与数量交杨佳琳采购
3. 2 号车电控框架：4×DRV8833 + 定时任务

## 需要的支持

- STM32 开发环境（Keil 或 CubeIDE）、STLink
