AFlyingPiglet/shangjianyinqing/team/成员/_旧版/05-杨佳琳-硬件-后勤.md

# 杨佳琳 · 硬件 + 后勤 · 进度页

- 角色：硬件 / 后勤
- 负责模块：电源链路与接线焊接、无线继电器、采购与报销、工具与物料管理
- 本周时间投入：约 __ 小时

## 本周目标

1. 电源链路图定稿：18650 2S → 官方无线继电器 → 分电板 → DRV8833 / 5V 降压
2. 核对采购清单：官方物资表（¥353.48）+ 自选 18650 电池

## 进度记录（最新的写在最上面）

### 2026-09-28 方案与清单基线

- 硬性要求：整机仅 1 个供电模块、额定 ≤7.4 V、必须能被官方断电遥控器在 10 m 内断电
- 成本：新生组建议 ≤400 元；非新生组只能用官方物资表物资 + 自制 PCB + 3D 打印件
- 手册提示：**未通过中期考核的队伍无需购买无线继电器**
- 证据：[物资与成本预算](../06-物资与成本预算.md)

## 下周计划

1. 画电源链路接线图，列出接插件与线材清单
2. 采购下单（注意报销需发票），建立台账

## 需要的支持

- 电烙铁、万用表、杜邦线等工具；发票抬头信息
