AFlyingPiglet/shangjianyinqing/team/成员/_旧版/00-模板.md

# （姓名） · 进度页

- 角色：
- 负责模块：
- 本周时间投入：约 __ 小时

## 本周目标

> 只写 2–3 条，能验证的。

1.
2.

## 进度记录（最新的写在最上面）

### 2026-10-__ 标题

- 做了什么：
- 遇到什么问题：
- 怎么解决的 / 试过哪些不行：
- 证据：`![](../images/2026-10-__-说明.jpg)`
- 耗时：__ 小时

## 下周计划

1.

## 需要的支持

> 缺工具、缺零件、需要别人配合的事写这里，例会上统一解决。

-
