AFlyingPiglet/shangjianyinqing/team/成员/_旧版/01-队长.md

# （姓名） · 队长 · 进度页

- 角色：队长（统筹 / 对外沟通 / 报名与赛务）
- 负责模块：报名、赛务沟通、任务分配与例会
- 额外职责：每次例会后同步「总进度看板」

## 本周目标（9/28–10/5）

1. **9 月 30 日前完成报名**（飞书报名表 + 加入 QQ 群 1038032005）
2. 确认本队是**新生组**还是**非新生组**
3. 确定队名（格式「XX 战队」，≤12 字符）

## 进度记录

### 2026-09-28 整理备赛基线

- 做了什么：读完 V1.4 手册，确认比赛日程、检录硬指标、中期考核要求
- 结论：报名 9/30 截止；中期考核 10/19 24:00 截止提交
- 证据：[总进度看板](../00-总进度看板.md)

## 下周计划

1. 10 月 1–5 日填实训分组志愿
2. 组织第一次例会，把总看板的负责人一栏填成真实姓名

## 需要的支持

-
