AFlyingPiglet/shangjianyinqing/team/成员/_旧版/04-算法与自动控制.md

# （姓名） · 算法 / 自动控制 · 进度页

- 角色：算法与自动控制（视觉可选）
- 负责模块：2 号车全自动航点运行、里程计与传感器纠偏

## 本周目标

1. 定稿 2 号车航点表：a1 → e1 坡道 → d1 台阶 → h1 角落 → f4 桥下 → 回 a1
2. **确认传感器合规问题**：灰度/红外不在官方物资表内，非新生组可能不允许

## 进度记录

### 2026-09-28 自动路线基线

- 每个点位动作统一：直行到位 → 停车 → 拨轮转 2 秒 → 继续
- 纠偏手段：里程计 + 灰度认胶带标记 + 红外避障
- 待定：整车高度是否压到 130 mm 以内（决定能不能钻桥下多拿 2 颗白块）
- 证据：待补

## 下周计划

1. 写航点表（坐标、朝向、动作、预计耗时，控制在 5 分钟以内）
2. 与队长确认组别 → 决定传感器方案

## 需要的支持

-
