AFlyingPiglet/shangjianyinqing/team/成员/_旧版/05-文档与后勤.md

# （姓名） · 文档与后勤 · 进度页

- 角色：文档 / 后勤（可由队长兼任）
- 负责模块：仓库维护、文档规范、素材收集、采购与报销

## 本周目标

1. 建好 Gitee/GitHub 仓库（队名拼音、公开、`docs/` 在根目录）并完成第一次提交
2. 通知全队：每次调试都要拍照/录视频，素材交到 `docs/images/`

## 进度记录

### 2026-09-28 文档骨架已建好

- 已建：总进度看板、7 篇功能文档、5 个成员进度页、写作指南与上传指南
- 还差：仓库地址、真实姓名、队名拼音
- 证据：本目录下所有文件

## 下周计划

1. 把总看板里的「（待填）」替换成真实姓名
2. 每次例会后更新看板状态
3. 整理第一批素材（参赛手册、两车设计图）

## 需要的支持

-
