AFlyingPiglet/shangjianyinqing/docs/images/日报配图/2026-10-09/蔡昌恒-1-60ec623e.png

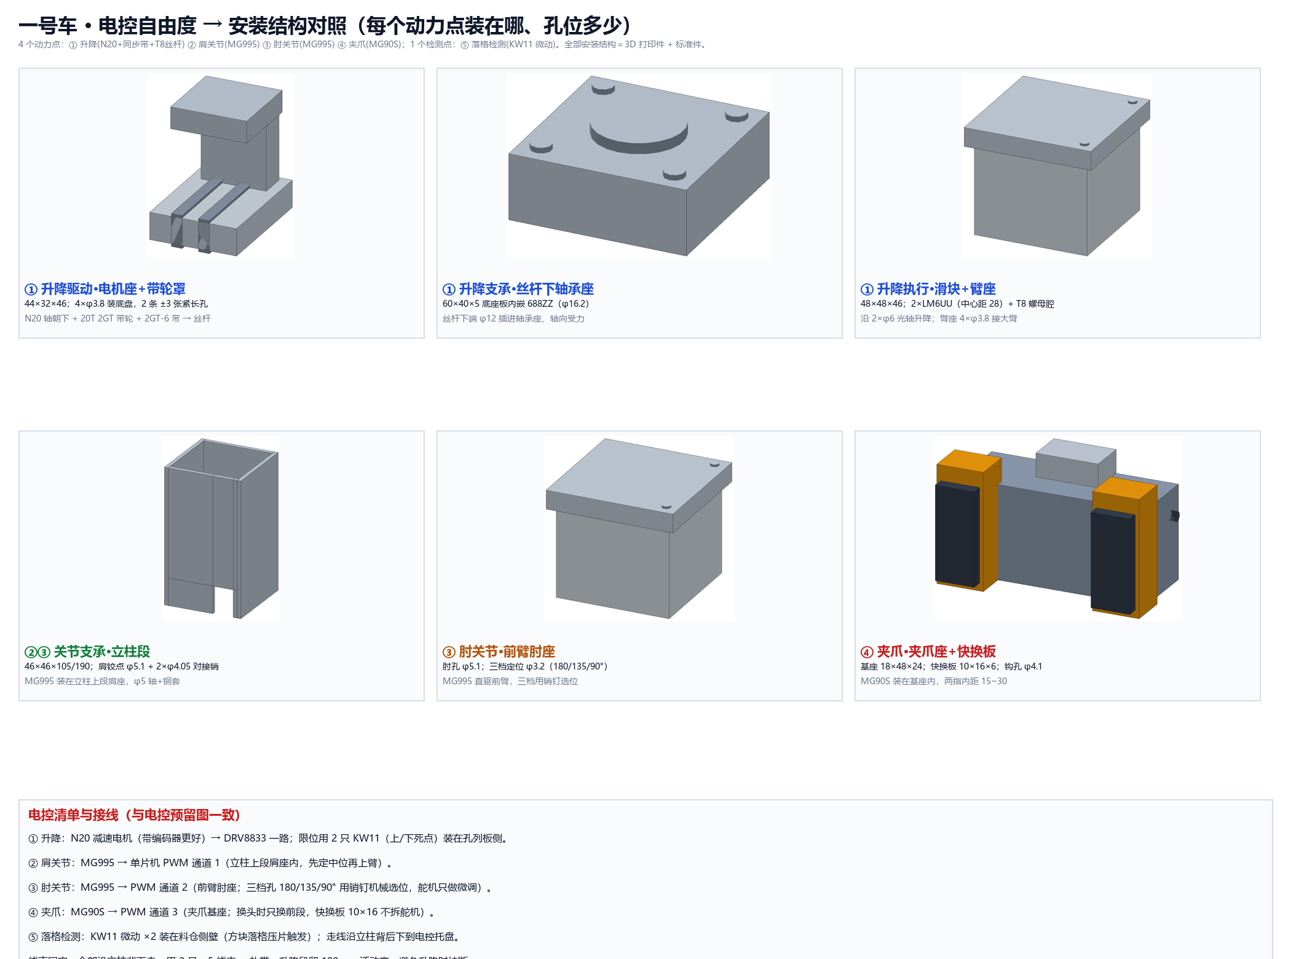
docs/images/日报配图/2026-10-09/蔡昌恒-1-60ec623e.png
