AFlyingPiglet/shangjianyinqing/docs/images/日报配图/2026-10-09/蔡昌恒-2-d776920e.png

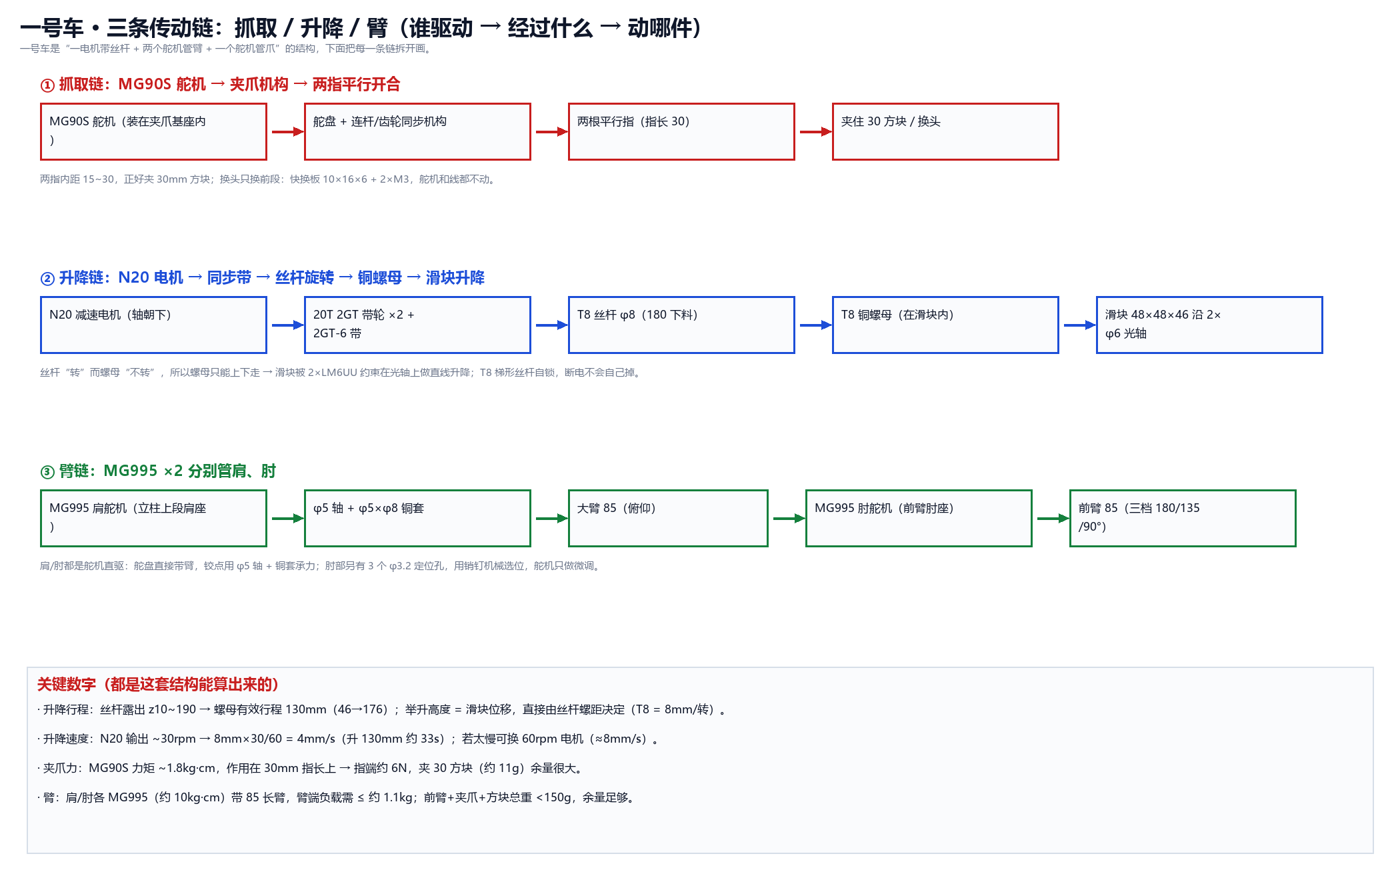
docs/images/日报配图/2026-10-09/蔡昌恒-2-d776920e.png
