AFlyingPiglet/shangjianyinqing/docs/images/日报配图/2026-10-09/蔡昌恒-3-8b2feb07.png

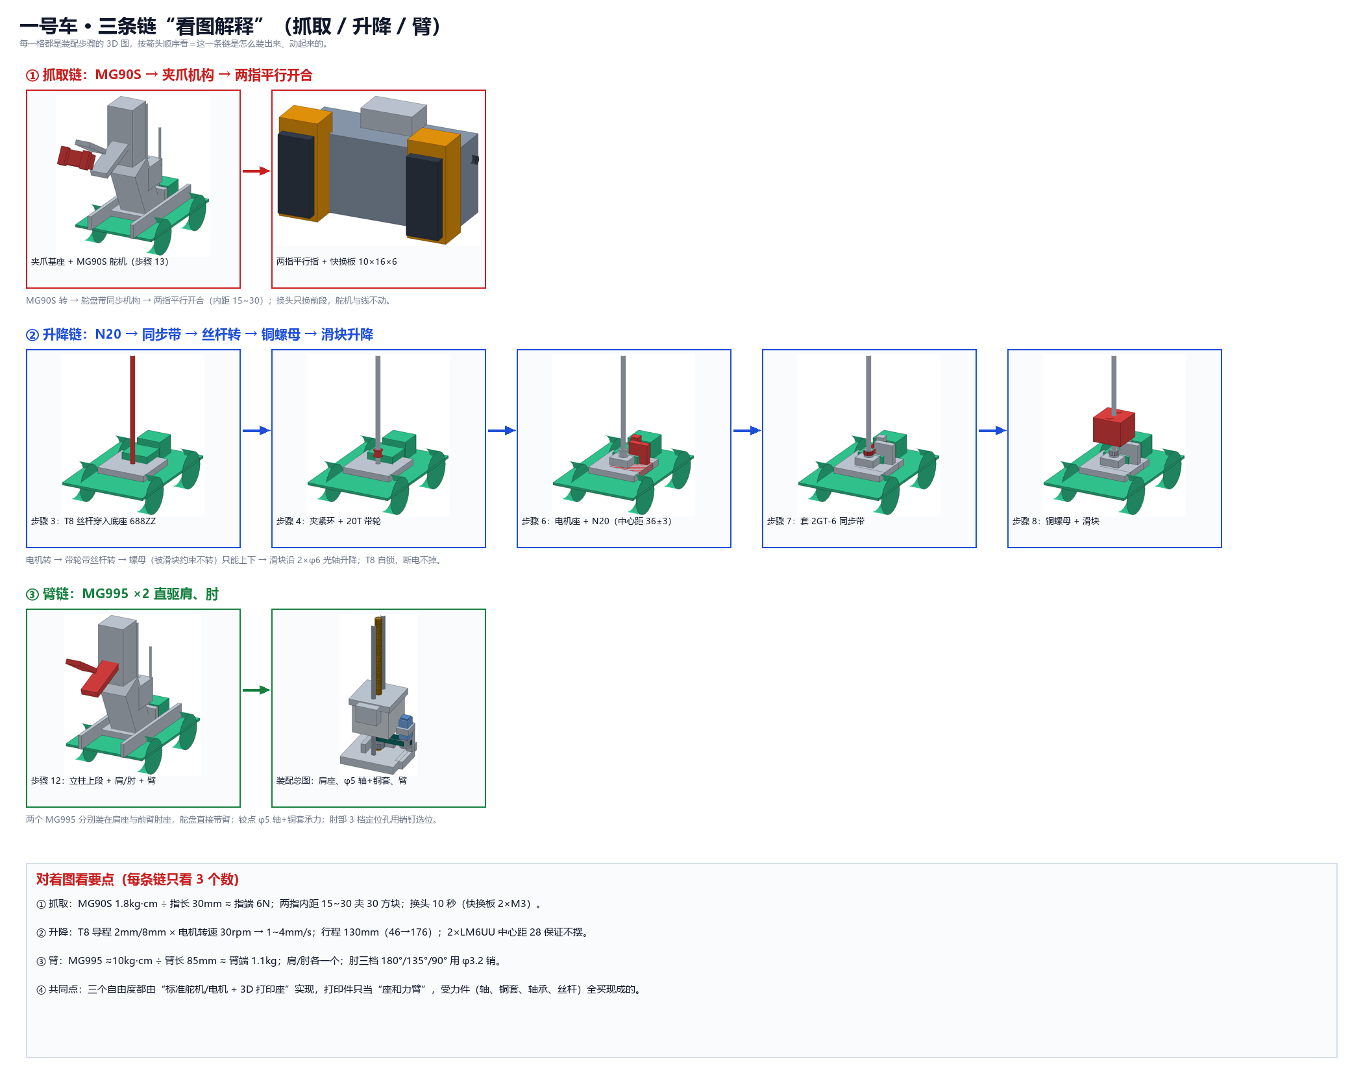
docs/images/日报配图/2026-10-09/蔡昌恒-3-8b2feb07.png
