AFlyingPiglet/shangjianyinqing/docs/问卷原件/2026-10-01-杨佳琳-问卷（手写）.jpg

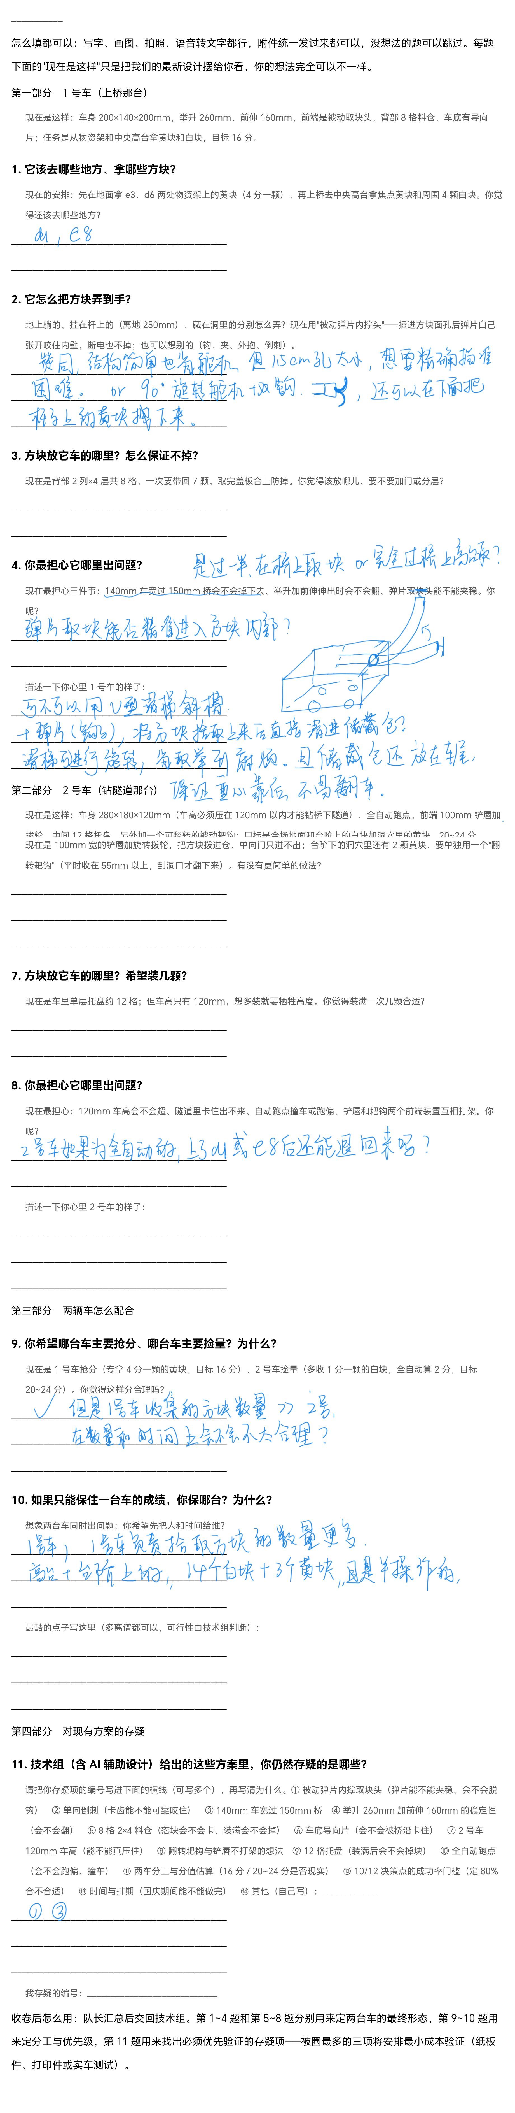
docs/问卷原件/2026-10-01-杨佳琳-问卷（手写）.jpg
