AFlyingPiglet/shangjianyinqing/docs/procurement/02-下单记录表.csv

件名 | 规格(关键参数) | 数量 | 预算 | 实际价格 | 店铺/链接 | 下单日期 | 到货情况 | 备注
1 T8丝杆 | φ8×180 导程2mm 右旋 | 1+1备 | ¥8~15 | 27.72 | 缇叙归旗舰店
1b T8铜螺母 | 导程2mm | 1+1备 | ¥6~12 | 2.36 | 东岩旗舰店
1c 688ZZ轴承 | φ8×φ16×5 | 2 | ¥3~6 | 2 | 珠沿轴承 | 10.8
1d φ8挡圈+尼龙垫 | 轴用卡簧 φ8 | 各2 | ¥2~3
1e 2GT同步带 | 闭环112mm 带宽6mm | 1+1备 | ¥5~8 | 4.4 | 靠谱五金配件 | 10.8
1f 2GT带轮20T | 一件φ3孔+一件φ8孔 带挡边 | 1对 | ¥6~16 | 5.56 | 库梵三维
2 N20减速电机 | 6V 1:50~1:100 φ3轴 | 1+1备 | ¥10~15 | 15.62 | N20电机之家
3 φ6光轴+LM6UU | 光轴200mm×2 + LM6UU×2 | 各2 | ¥12~16 | 7.6 | 千木成旗舰店，苏州顺和晟达自动化科技有限公司
4 MG90S舵机 | 180°金属齿 | 1+1备 | ¥16~24 | 11.4 | 穆穆电子元器件开发板
5 φ5钢轴+铜套 | 钢轴60mm×2 + 铜套φ5×φ8×4 | 1套 | ¥10~12
6 KW11微动开关 | KW11-3Z 三脚带柄 | 6~10只 | ¥5 | 5.3 | 自动化电气配件厂家
7 拉簧 | 0.5×5×20 带钩 | 4只 | ¥3 | 3.1 | 固恒建材专营店
8 热熔螺母+螺丝包 | φ4.0×5.7×100 + 混装螺丝 | 1套 | ¥25~35 | 6.2 | 金超官方旗舰店
9 M4手拧+R销 | M4×10×10 + R销φ4×20 | 1套 | ¥12~15
10 60mm橡胶轮 | φ60 配TT轮毂 | 4 | ¥10~15
11 XT30+线+开关 | XT30公母×3+18AWG 1m+开关×2 | 1套 | ¥15~20 | 1.16+2.75x3 | 明怿旗舰店，嘉熠模型
18 亚克力板 | 2mm 120×150 | 1 | ¥8~12
19 玻纤板 | FR4 2mm 120×150 | 1 | ¥10~12
21 TPU耗材 | 1.75mm 95A 0.25kg | 1 | ¥0~35
24 UBEC | 5V/5A 2S~4S输入 | 1 | ¥10
26 不锈钢弹片 | 0.3×100×100 304/301 | 1 | ¥5~8
28 铜柱套装 | M3铜柱5/10/20+尼龙柱+垫片 | 1套 | ¥8~10
(不用下单)玻纤棒/配重/扎带 | 实验室领用或五金店 | 1批 | ¥25
合计（必买16项） | 预算 ¥196
合计（含建议6项） | 预算 ¥262~286
