AFlyingPiglet/shangjianyinqing/docs/procurement/小车配件-实际采购表.xlsx

名称 | 数量 | 金额
40P杜邦线公对母10cm | 1 | 2.4
40P杜邦线公对公10cm | 1 | 2.7
40P杜邦线母对母10cm | 1 | 2.1
STM32F103C8T6核心开发板 | 2 | 18.8
ST-LINK V2仿真器 | 1 | 12.42
PS2无线手柄锁定款+直线转接板 | 2 | 90.1
DRV8833驱动模块 | 8 | 16.7
18650电池盒（2节） | 3 | 7.12
6节电池+充电器 | 1 | 84.4
Mini降压模块 | 2 | 4.18
60mm麦克纳姆轮（4个） | 1 | 38.8
tt马达（单轴1:48） | 12 | 33.96
SG90舵机180度 | 4 | 23.6
MG995（180度） | 2 | 23.6
宽电压单路遥控开关 | 2 | 27.6
不锈钢卡簧轴用挡圈（M6,M5) | 2 | 5.88
M3螺丝*4 | 1 | 4.77
304弹性弹簧钢丝圆棒折弯 | 1 | 1.39
A3碳钢圆柱销GB119本色 | 1 | 0.9
轴承（直径5长60*10） | 1 | 4.29
线径（0.4*4*15,10个） | 1 | 3.44
轴承（直径5长40*20） | 1 | 4.8
轴承（直径5长35*20） | 1 | 3.6
橡胶轮 | 4 | 10.14
电机座 | 1 | 3.13
不锈钢卡簧轴用挡圈(8) | 1 | 2.26
螺丝钉（M3*16,12，10,6,8) | 5 | 9.07
其他 |  | 117.76
总计 |  | 536.31
