AFlyingPiglet/shangjianyinqing/docs/models/一号车-STEP/05-立柱底座板_60x40x5.step

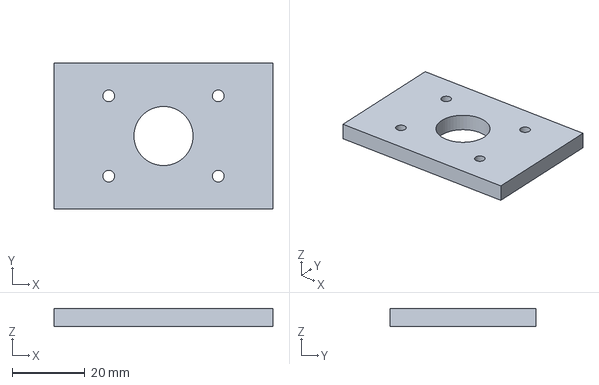
[picture p119: CAD file, 2026-10-19]
docs/models/一号车-STEP/05-立柱底座板_60x40x5.step
60.0 x 40.0 x 5.00 mm
