AFlyingPiglet/shangjianyinqing/docs/models/一号车-STEP/02-滑块臂座_48x48x46.step

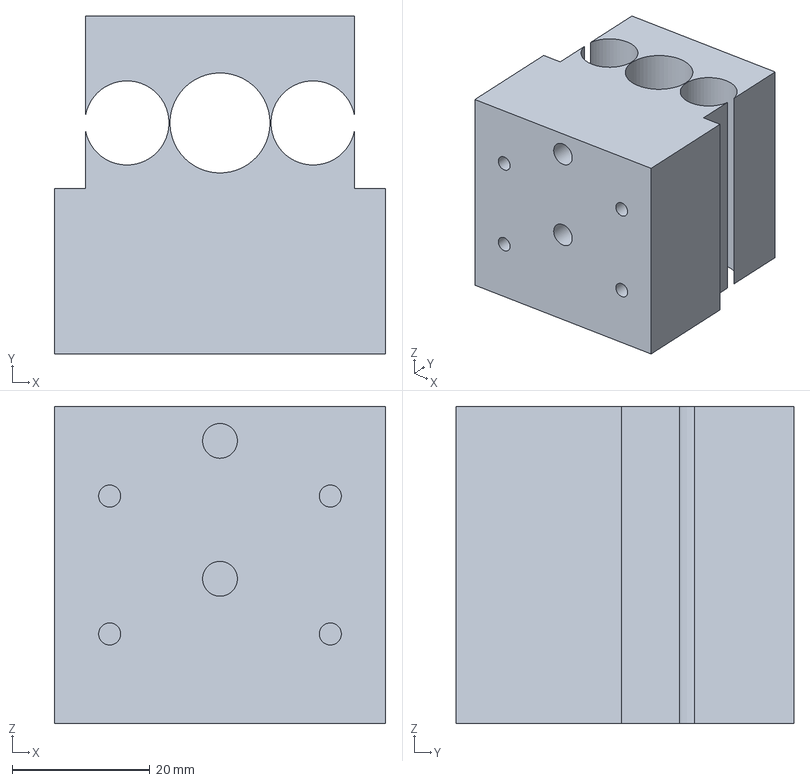
[picture p120: CAD file, 2026-10-19]
docs/models/一号车-STEP/02-滑块臂座_48x48x46.step
48.0 x 49.0 x 46.0 mm
