AFlyingPiglet/shangjianyinqing/docs/models/一号车-STEP/01-立柱_46x46x190_C型.step

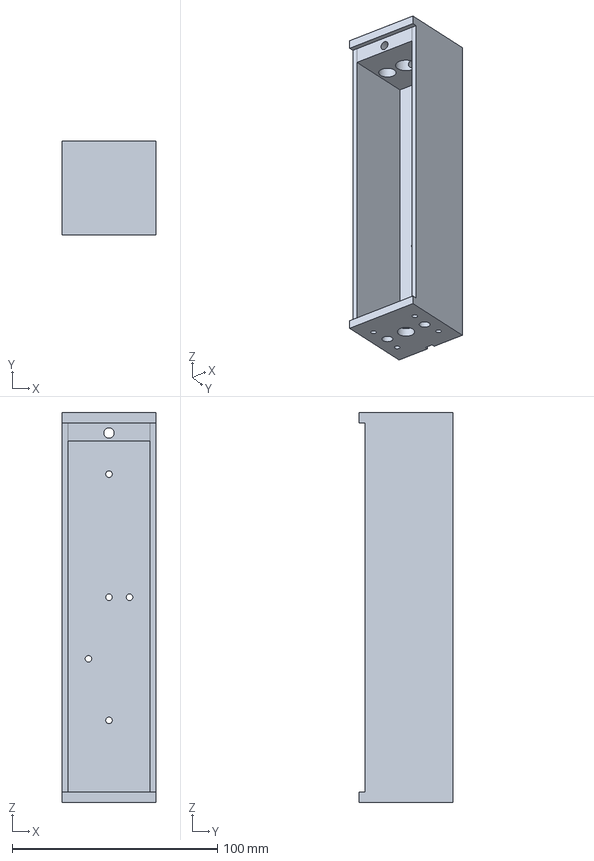
[picture p121: CAD file, 2026-10-19]
docs/models/一号车-STEP/01-立柱_46x46x190_C型.step
46.0 x 46.0 x 190.0 mm
