AFlyingPiglet/shangjianyinqing/docs/models/一号车-STEP/12-快换背板+公板+钩子.step

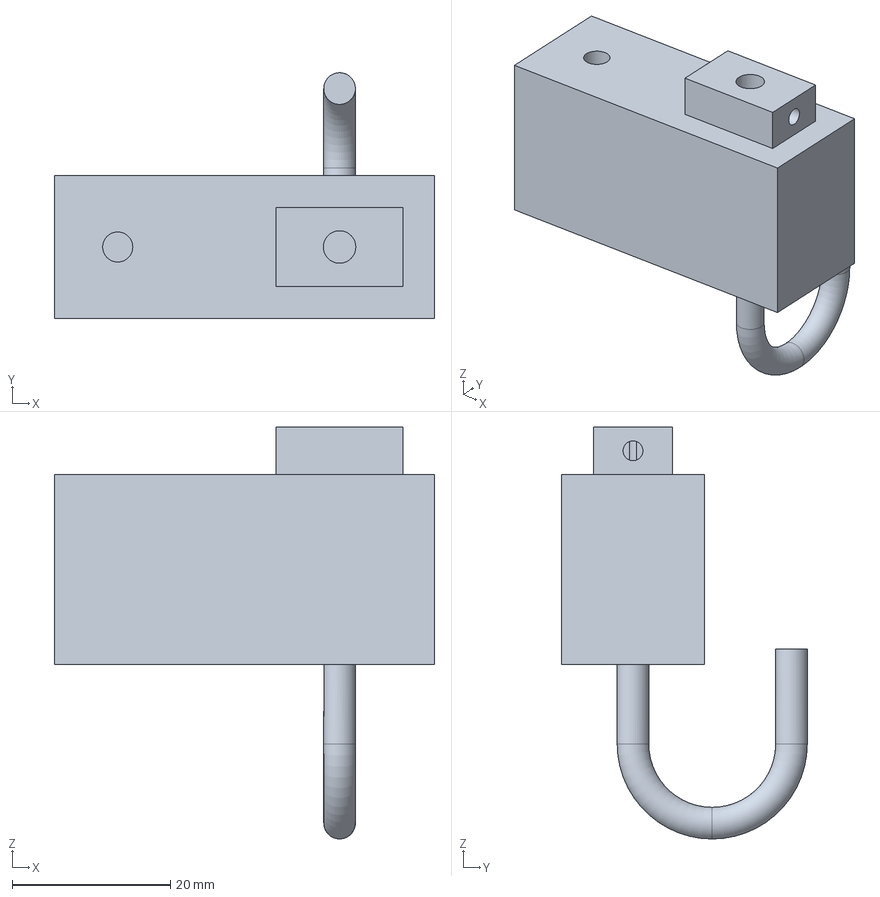
[picture p122: CAD file, 2026-10-19]
docs/models/一号车-STEP/12-快换背板+公板+钩子.step
48.0 x 31.0 x 52.0 mm
