AFlyingPiglet/shangjianyinqing/docs/models/一号车-STEP/06-轴承座_32x32x12.step

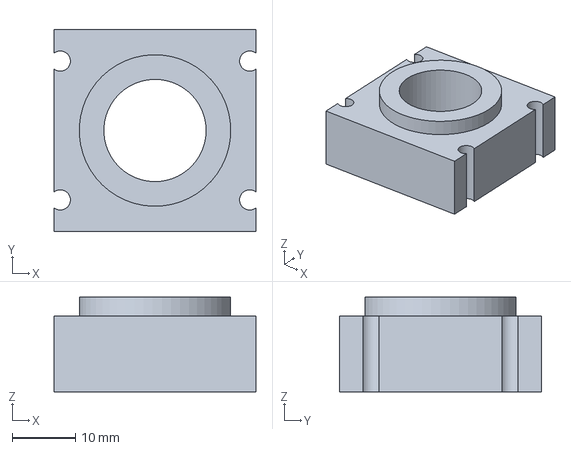
[picture p123: CAD file, 2026-10-19]
docs/models/一号车-STEP/06-轴承座_32x32x12.step
32.0 x 32.0 x 15.0 mm
