AFlyingPiglet/shangjianyinqing/docs/models/一号车-STEP/11-夹爪+快换公板.step

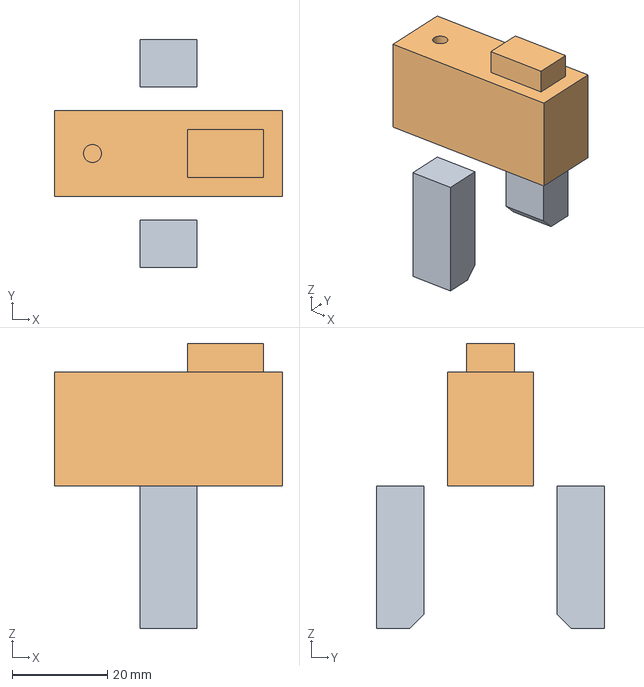
[picture p124: CAD file, 2026-10-19]
docs/models/一号车-STEP/11-夹爪+快换公板.step
48.0 x 48.0 x 60.0 mm
