AFlyingPiglet/shangjianyinqing/docs/models/一号车-STEP/09-前臂_85x26x8.step

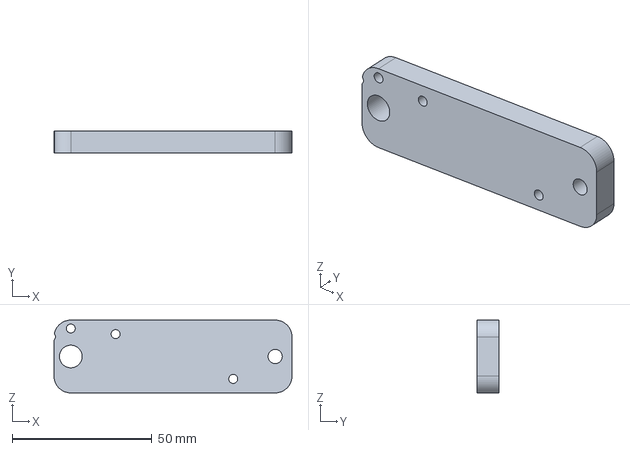
[picture p125: CAD file, 2026-10-19]
docs/models/一号车-STEP/09-前臂_85x26x8.step
85.0 x 8.00 x 26.0 mm
