AFlyingPiglet/shangjianyinqing/docs/models/一号车-STEP/15-电池仓_75x42x22.step

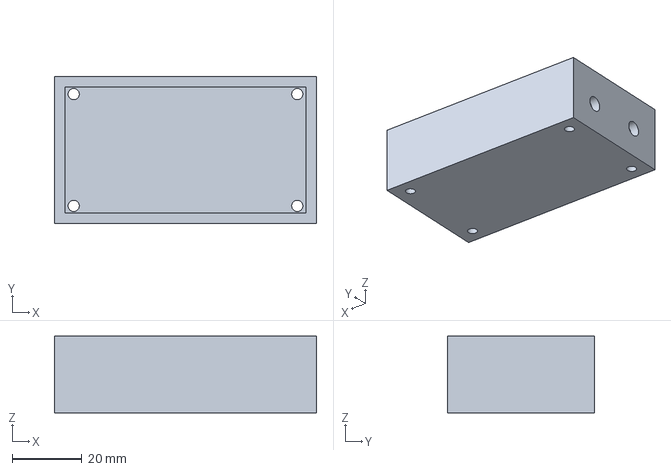
[picture p126: CAD file, 2026-10-19]
docs/models/一号车-STEP/15-电池仓_75x42x22.step
75.0 x 42.0 x 22.0 mm
