AFlyingPiglet/shangjianyinqing/docs/models/一号车-STEP/03-L形侧板_60x36x5.step

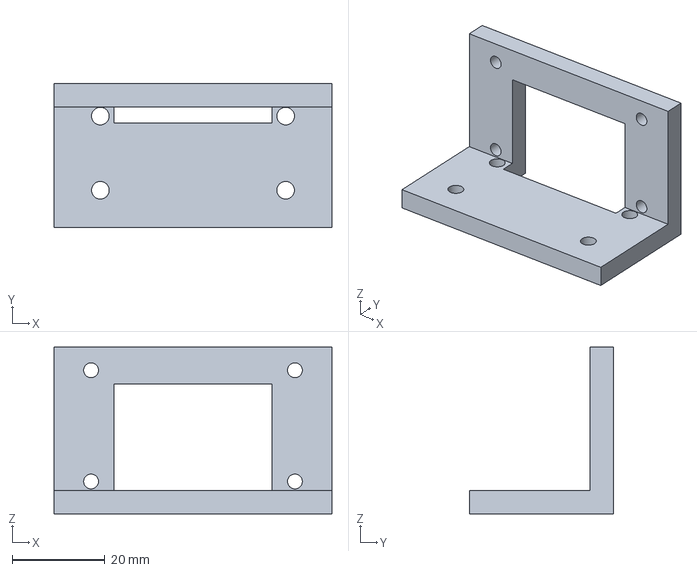
[picture p127: CAD file, 2026-10-19]
docs/models/一号车-STEP/03-L形侧板_60x36x5.step
60.0 x 31.0 x 36.0 mm
