AFlyingPiglet/shangjianyinqing/docs/models/一号车-STEP/13-堆块筒矮版_53x80x64.step

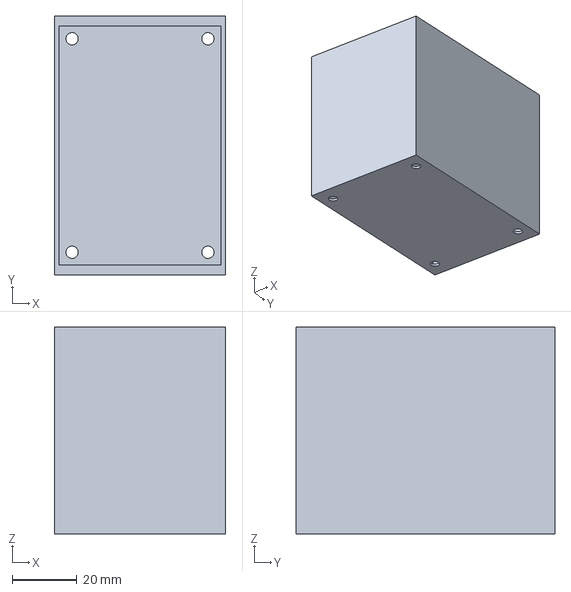
[picture p128: CAD file, 2026-10-19]
docs/models/一号车-STEP/13-堆块筒矮版_53x80x64.step
53.0 x 80.0 x 64.0 mm
