AFlyingPiglet/shangjianyinqing/docs/models/一号车-STEP/04-电机座高位桥板_74至92.step

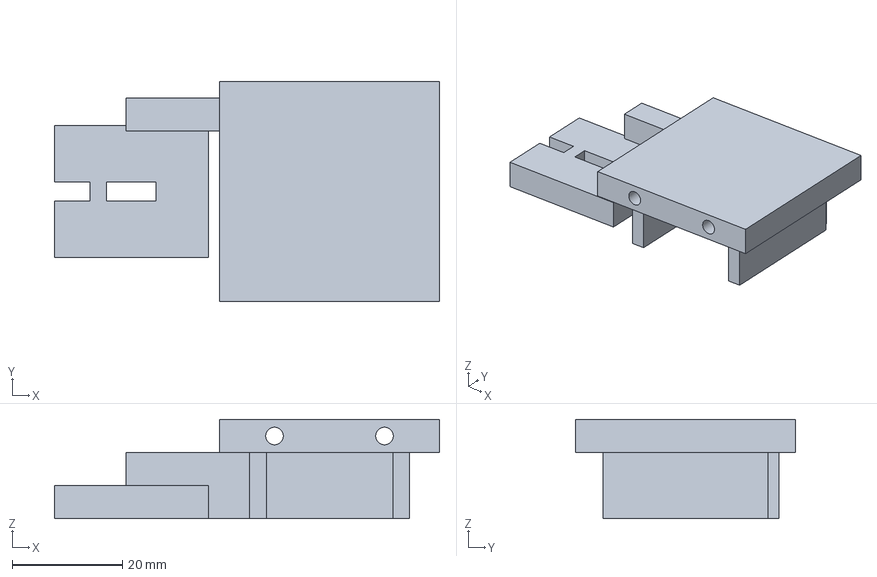
[picture p129: CAD file, 2026-10-19]
docs/models/一号车-STEP/04-电机座高位桥板_74至92.step
70.0 x 40.0 x 18.0 mm
