AFlyingPiglet/shangjianyinqing/docs/models/一号车-STEP/10-腕板快换母板_12x48x24.step

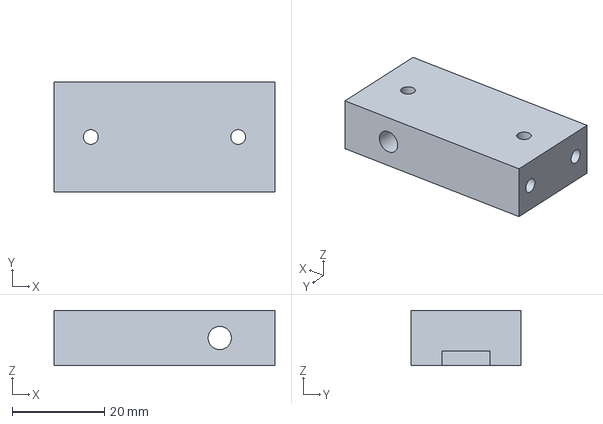
[picture p130: CAD file, 2026-10-19]
docs/models/一号车-STEP/10-腕板快换母板_12x48x24.step
48.0 x 24.0 x 12.0 mm
