AFlyingPiglet/shangjianyinqing/docs/models/一号车-STEP/17-侧孔列板_130x40x4.step

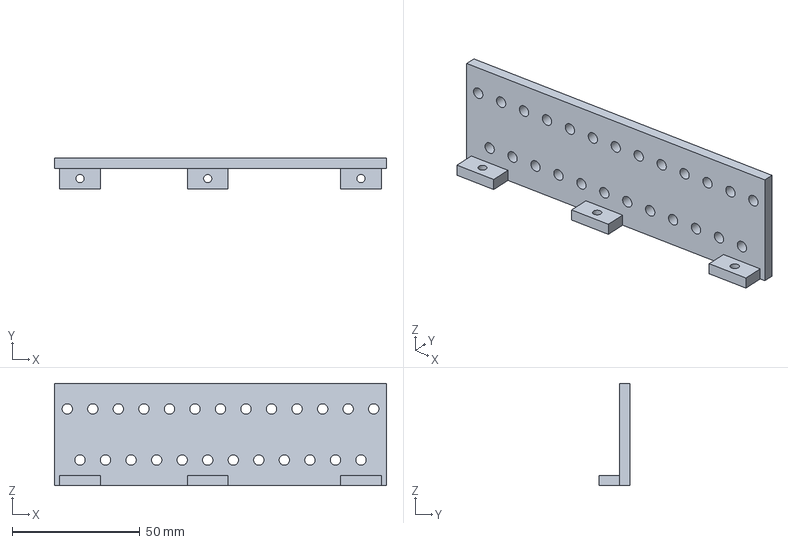
[picture p131: CAD file, 2026-10-19]
docs/models/一号车-STEP/17-侧孔列板_130x40x4.step
130.0 x 12.0 x 40.0 mm
