AFlyingPiglet/shangjianyinqing/docs/models/一号车-STEP/16-打印底盘_208x140x4.step

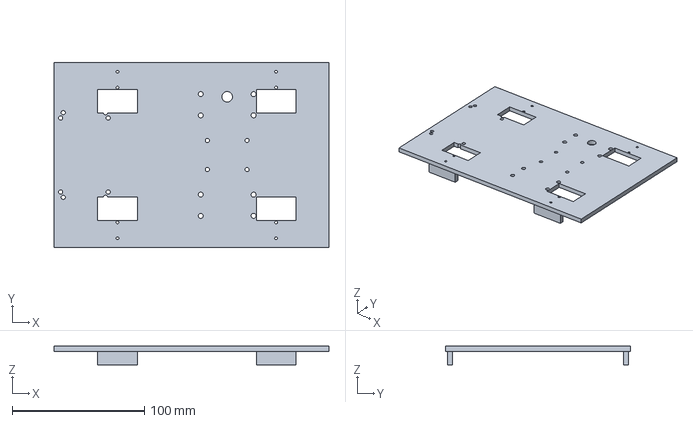
[picture p132: CAD file, 2026-10-19]
docs/models/一号车-STEP/16-打印底盘_208x140x4.step
208.0 x 140.0 x 14.0 mm
