AFlyingPiglet/shangjianyinqing/docs/models/一号车-STEP/14-电控托盘_68x44x16.step

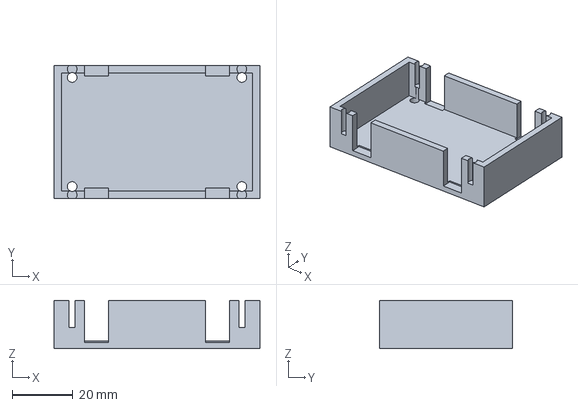
[picture p133: CAD file, 2026-10-19]
docs/models/一号车-STEP/14-电控托盘_68x44x16.step
68.0 x 44.0 x 16.0 mm
