AFlyingPiglet/shangjianyinqing/docs/models/一号车-STEP/08-上臂_85x30x9.step

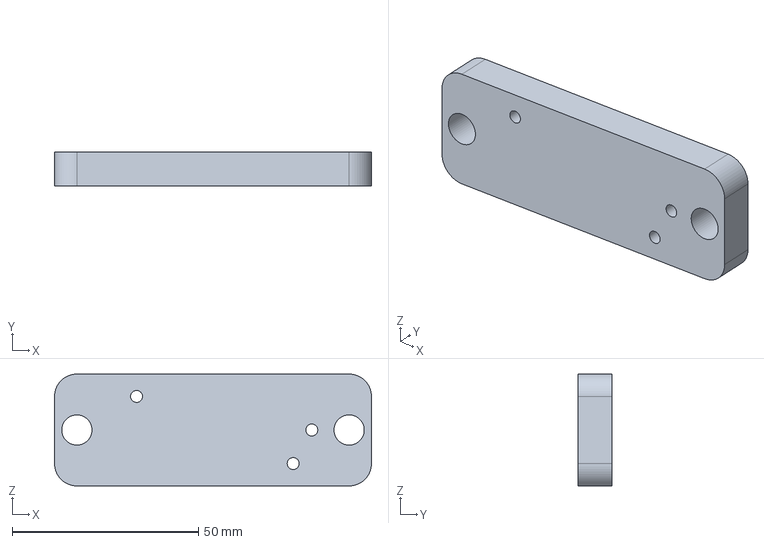
[picture p134: CAD file, 2026-10-19]
docs/models/一号车-STEP/08-上臂_85x30x9.step
85.0 x 9.00 x 30.0 mm
