AFlyingPiglet/shangjianyinqing/docs/code/Clion_test/Clion_test.ioc

Mcu.UserName=STM32F103C8Tx
PA0-WKUP.GPIO_Label=LIFT_PWM
PA0-WKUP.Signal=S_TIM2_CH1_ETR
PA10.GPIO_Label=MOTOR_LB
PA10.Signal=S_TIM1_CH3
PA11.GPIO_Label=MOTOR_RB
PA11.Signal=S_TIM1_CH4
PA13.Signal=SYS_JTMS-SWDIO
PA14.Signal=SYS_JTCK-SWCLK
PA2.Signal=USART2_TX
PA3.Signal=USART2_RX
PA8.GPIO_Label=MOTOR_LF
PA8.Signal=S_TIM1_CH1
PA9.GPIO_Label=MOTOR_RF
PA9.Signal=S_TIM1_CH2
PB0.GPIO_Label=DIR_L
PB0.Signal=GPIO_Output
PB1.GPIO_Label=DIR_R
PB1.Signal=GPIO_Output
PB12.GPIO_Label=PS2_CS
PB12.Signal=GPIO_Output
PB13.GPIO_Label=PS2_CLK
PB13.Signal=GPIO_Output
PB14.GPIO_Label=PS2_DATA
PB14.Signal=GPIO_Input
PB15.GPIO_Label=PS2_CMD
PB15.Signal=GPIO_Output
PB5.GPIO_Label=RELAY_EN
PB5.Signal=GPIO_Output
PB6.GPIO_Label=LIMIT_BOT
PB6.Signal=GPIO_Input
PB7.GPIO_Label=LIMIT_TOP
PB7.Signal=GPIO_Input
PD0-OSC_IN.Signal=RCC_OSC_IN
PD1-OSC_OUT.Signal=RCC_OSC_OUT
