AFlyingPiglet/shangjianyinqing/docs/code/Clion_test/Core/Inc/main.h

#define LIFT_PWM_Pin GPIO_PIN_0
#define LIFT_PWM_GPIO_Port GPIOA
#define DIR_L_Pin GPIO_PIN_0
#define DIR_L_GPIO_Port GPIOB
#define DIR_R_Pin GPIO_PIN_1
#define DIR_R_GPIO_Port GPIOB
#define PS2_CS_Pin GPIO_PIN_12
#define PS2_CS_GPIO_Port GPIOB
#define PS2_CLK_Pin GPIO_PIN_13
#define PS2_CLK_GPIO_Port GPIOB
#define PS2_DATA_Pin GPIO_PIN_14
#define PS2_DATA_GPIO_Port GPIOB
#define PS2_CMD_Pin GPIO_PIN_15
#define PS2_CMD_GPIO_Port GPIOB
#define MOTOR_LF_Pin GPIO_PIN_8
#define MOTOR_LF_GPIO_Port GPIOA
#define MOTOR_RF_Pin GPIO_PIN_9
#define MOTOR_RF_GPIO_Port GPIOA
#define MOTOR_LB_Pin GPIO_PIN_10
#define MOTOR_LB_GPIO_Port GPIOA
#define MOTOR_RB_Pin GPIO_PIN_11
#define MOTOR_RB_GPIO_Port GPIOA
#define RELAY_EN_Pin GPIO_PIN_5
#define RELAY_EN_GPIO_Port GPIOB
#define LIMIT_BOT_Pin GPIO_PIN_6
#define LIMIT_BOT_GPIO_Port GPIOB
#define LIMIT_TOP_Pin GPIO_PIN_7
#define LIMIT_TOP_GPIO_Port GPIOB
