AFlyingPiglet/shangjianyinqing/(commit log)

2026-09-28 更新文档：38 个文件（2026-09-28 21:34）
2026-09-28 更新文档：1 个文件（2026-09-28 21:36）
2026-09-28 更新文档：27 个文件（2026-09-28 23:10）
2026-09-29 更新文档：5 个文件（2026-09-29 11:37）
2026-09-29 更新文档：10 个文件（2026-09-29 22:47）
2026-09-30 更新文档：2 个文件（2026-09-30 20:58）
2026-09-30 更新文档：8 个文件（2026-09-30 21:01）
2026-09-30 更新文档：16 个文件（2026-09-30 21:23）
2026-10-01 更新文档：23 个文件（2026-10-01 21:37）
2026-10-01 更新文档：1 个文件（2026-10-01 22:10）
2026-10-02 更新文档：11 个文件（2026-10-02 20:37）
2026-10-04 更新文档：7 个文件（2026-10-04 10:26）
2026-10-04 更新文档：29 个文件（2026-10-04 23:18）
2026-10-04 更新文档：9 个文件（2026-10-04 23:32）
2026-10-06 更新文档：15 个文件（2026-10-06 08:47）
2026-10-08 更新文档：11 个文件（2026-10-08 09:26）
2026-10-09 更新文档：10 个文件（2026-10-09 23:02）
2026-10-09 更新文档：6 个文件（2026-10-09 23:23）
2026-10-09 更新文档：3 个文件（2026-10-09 23:35）
2026-10-11 更新文档：12 个文件（2026-10-11 22:41）
2026-10-12 更新文档：15 个文件（2026-10-12 20:47）
2026-10-13 更新文档：5 个文件（2026-10-13 19:11）
2026-10-14 更新文档：8 个文件（2026-10-14 21:13）
2026-10-14 更新文档：4 个文件（2026-10-14 22:02）
2026-10-15 更新文档：11 个文件（2026-10-15 22:34）
2026-10-15 更新文档：1 个文件（2026-10-15 22:44）
2026-10-15 更新文档：1 个文件（2026-10-15 22:54）
2026-10-18 更新文档：39 个文件（2026-10-18 23:21）
2026-10-19 更新文档：52 个文件（2026-10-19 20:04）
2026-10-19 更新文档：7 个文件（2026-10-19 21:15）
2026-10-19 更新文档：38 个文件（2026-10-19 22:11）
2026-10-19 更新文档：8 个文件（2026-10-19 22:30）
2026-10-19 更新文档：15 个文件（2026-10-19 22:35）
2026-10-19 更新文档：3 个文件（2026-10-19 23:04）
